PetterGustafsson/power-supply-tester/THIRD_PARTY_NOTICES.md

# Third-party material

This private project includes reference material and dependencies with their
own terms. No repository-wide license is assigned to third-party material.

| Material | Location / attribution |
| --- | --- |
| Inter font | `assets/fonts/inter/`; SIL Open Font License and source record included |
| Nunito font | `assets/fonts/nunito/`; SIL Open Font License and source record included |
| Waveshare display drivers and mechanical/reference material | Driver headers retain their notices; `case-cad/ref/` and `hardware/rev-d/sources/` |
| Hirose connector drawings and reference geometry | `references/` and `case-cad/ref/`; see the source/accuracy notes in `output/README.md` |
| Allied Vision logo art | User-supplied original in `output/allied-vision-logo.svg`; extracted emblem in `output/allied-vision-mark.svg` |
| Espressif bootloader and OTA boot data | Working firmware release, built/bundled from Arduino ESP32 core 3.3.7; Espressif's original terms apply |
| Other component datasheets and models | Kept with their hardware revision or reference directory |

Third-party trademarks identify the referenced components and supplied artwork.
The UI illustration's polished brass/gold treatment is artistic; its appearance
does not specify the plating or material of the physical connector contacts.
