PetterGustafsson/power-supply-tester/hardware/tester12v-rev-d-engineering-package/hardware/rev-d/pin-map.csv

Input | Connector | Contact | ADC | I2C_address | AIN | ADC_pin | Testpoint
1 | J1 | 1 | U1 | 0x48 | 0 | 4 | TP1
2 | J1 | 2 | U1 | 0x48 | 1 | 5 | TP2
3 | J1 | 3 | U1 | 0x48 | 2 | 6 | TP3
4 | J1 | 4 | U1 | 0x48 | 3 | 7 | TP4
5 | J2 | 1 | U2 | 0x49 | 0 | 4 | TP5
6 | J2 | 2 | U2 | 0x49 | 1 | 5 | TP6
7 | J2 | 3 | U2 | 0x49 | 2 | 6 | TP7
8 | J2 | 4 | U2 | 0x49 | 3 | 7 | TP8
9 | J3 | 1 | U3 | 0x4a | 0 | 4 | TP9
10 | J3 | 2 | U3 | 0x4a | 1 | 5 | TP10
11 | J3 | 3 | U3 | 0x4a | 2 | 6 | TP11
12 | J3 | 4 | U3 | 0x4a | 3 | 7 | TP12
