PetterGustafsson/power-supply-tester/hardware/tester12v-rev-d-engineering-package/hardware/rev-d/sources/waveshare-schematic.txt

                           1                                                                   2                                                                             3                                                               4                                                  5                                                                          6

                                                                                                          BAT                                                                                                   POWER                                                                                                         LCD
                       KEY
                                                                                                                                                                    VBAT         P1
                                                                                          U1
                                                                                                                                                                                  1
                                                                        C1                                                                                                        2
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

                                                                                                                                                                                                                                                                                                                          EP
                IMU_INT1       GPIO47                                          LNA_IN                           VDDA                                                                                         GND                                                                              GND         2                                  15
                                                      VDD3V3             2                                                      55                                                                                 A4/B9               VBUS                 VSYS                                                   GND            CTS
                IMU_INT2       GPIO48                                          VDD3P3                           VDDA                                                                                        VBUS                                                                              VBUS        3                                  14
                                                                         3                                                      54         XTALP                                                                   B8                                                                                              VDD5           DSR
                                                                               VDD3P3                         XTAL_P                                                                                        SBU2                                                                              UTXD        4                                  13 RTS
                                                      RESET              4                                                      53         XTALN                                                                      A5               R5    5.1K                                                                  TXD            RTS
                LCD_DC         GPIO8                                           CHIP_PU                        XTAL_N                                                                                         CC1                                                                              URXD        5                                  12 DTR
                                                      GPIO0              5                                                      52           GPIO46                                                                B7                    USB_N                                                                     RXD        DTRTNOW
                LCD_CS         GPIO9                                           GPIO0                           GPIO46                                                                                        DN2                                                                              3V3         6                                  11
                                                      GPIO1              6                                                      51           GPIO45                                                                   A6                 USB_P                                                                     V3             DCD
                LCD_CLK        GPIO10                                          GPIO1                           GPIO45                                                                                         DP1                                                                             USBD_P      7                                  10
                                                      GPIO2              7                                                      50          UTXD                                                                      A7                 USB_N                                                                     UD+           ACT#
                LCD_DIN        GPIO11                                          GPIO2                           U0RXD                                                                                         DN1                                                                              USBD_N      8                                  9 VBUS
                                                      GPIO3              8                                                      49          URXD                                                                   B6                    USB_P                                                                     UD-           VBUS
                                                                               GPIO3                           U0TXD                                                                                          DP2
                                                      GPIO4              9                                                      48           GPIO42                                                                   A8
                LCD_RST        GPIO12                                          GPIO4                            MTMS                                                                                        SBU1                                                                                              U8
                                                      GPIO5             10                                                      47           GPIO41                                                                B5                  R8   5.1K                                                              CH343P
                LCD_BL         GPIO40                                          GPIO5                             MTDI                                                                                        CC2                                              GND
                                                      GPIO6             11                                                      46            3V3                                                                 A9/B4                  VBUS
                                                                               GPIO6                      VDD3P3_CPU                                                                                        VBUS
                                                      GPIO7             12                                                      45           GPIO40                                                               A12/B1
                BAT_ADC        GPIO1                                           GPIO7                            MTDO                                                                                         GND
                                                      GPIO8             13                                                      44           GPIO39
                BOOT           GPIO0                                           GPIO8                            MTCK
C                                                     GPIO9             14                                                      43           GPIO38                                                   Type_C1                                                                                                                                                                                C
                RUN            RESET                                           GPIO9                           GPIO38
                                                      GPIO10            15                                                      42           GPIO37                                                                                                                                                                                     U9
                                                                               GPIO10                          GPIO37
                                                      GPIO11            16                                                      41           GPIO36                                                                                                                                                                         RTS     1                 6        RESET
                                                                               GPIO11                          GPIO36                                                                                                                                                                                                                         E C
                                                      GPIO12            17                                                      40           GPIO35                                                                                                                                      VBUS
                                                                               GPIO12                          GPIO35
                                                      GPIO13            18                                                      39           GPIO34
                                                                               GPIO13                          GPIO34
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
