PetterGustafsson/power-supply-tester/case-cad/cad_I9/review/v_iso.png

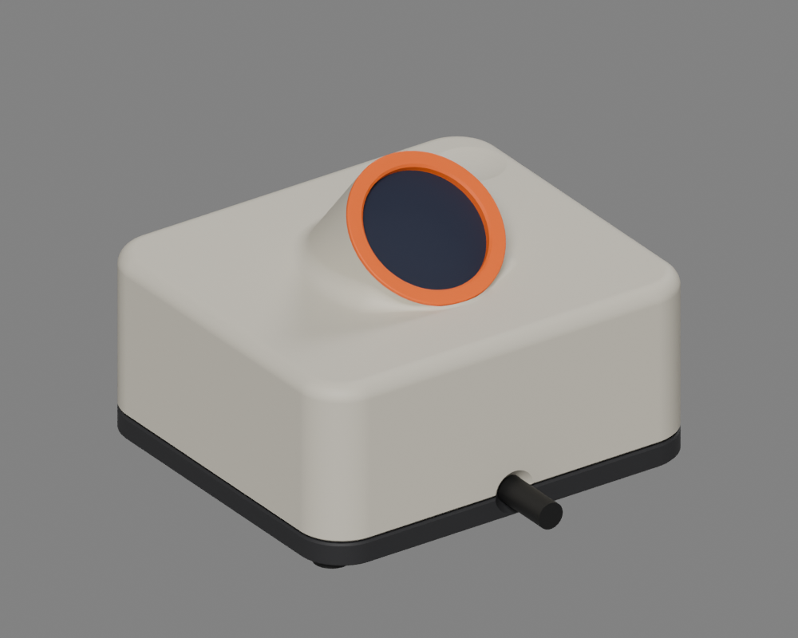
case-cad/cad_I9/review/v_iso.png
