PetterGustafsson/power-supply-tester/case-cad/ref/board-and-display.png

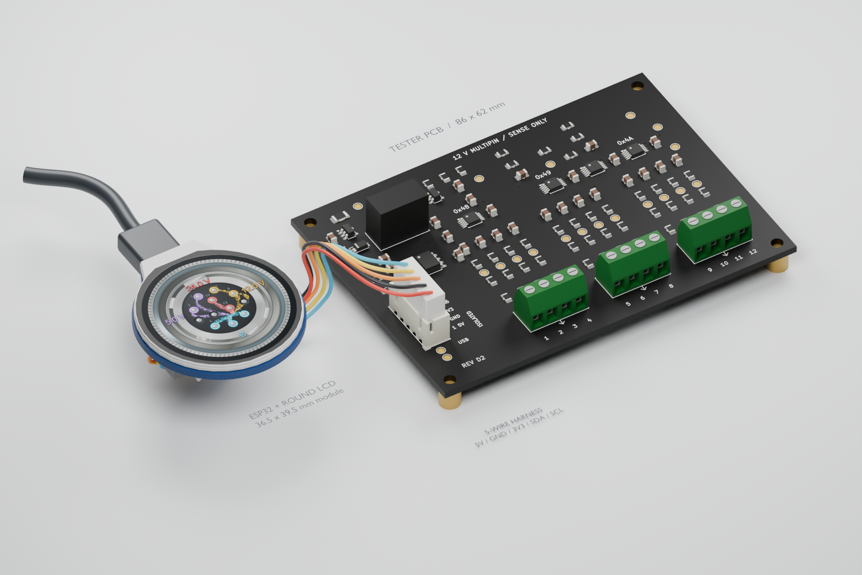
case-cad/ref/board-and-display.png
