PetterGustafsson/power-supply-tester/case-cad/ref/dmech-1.png

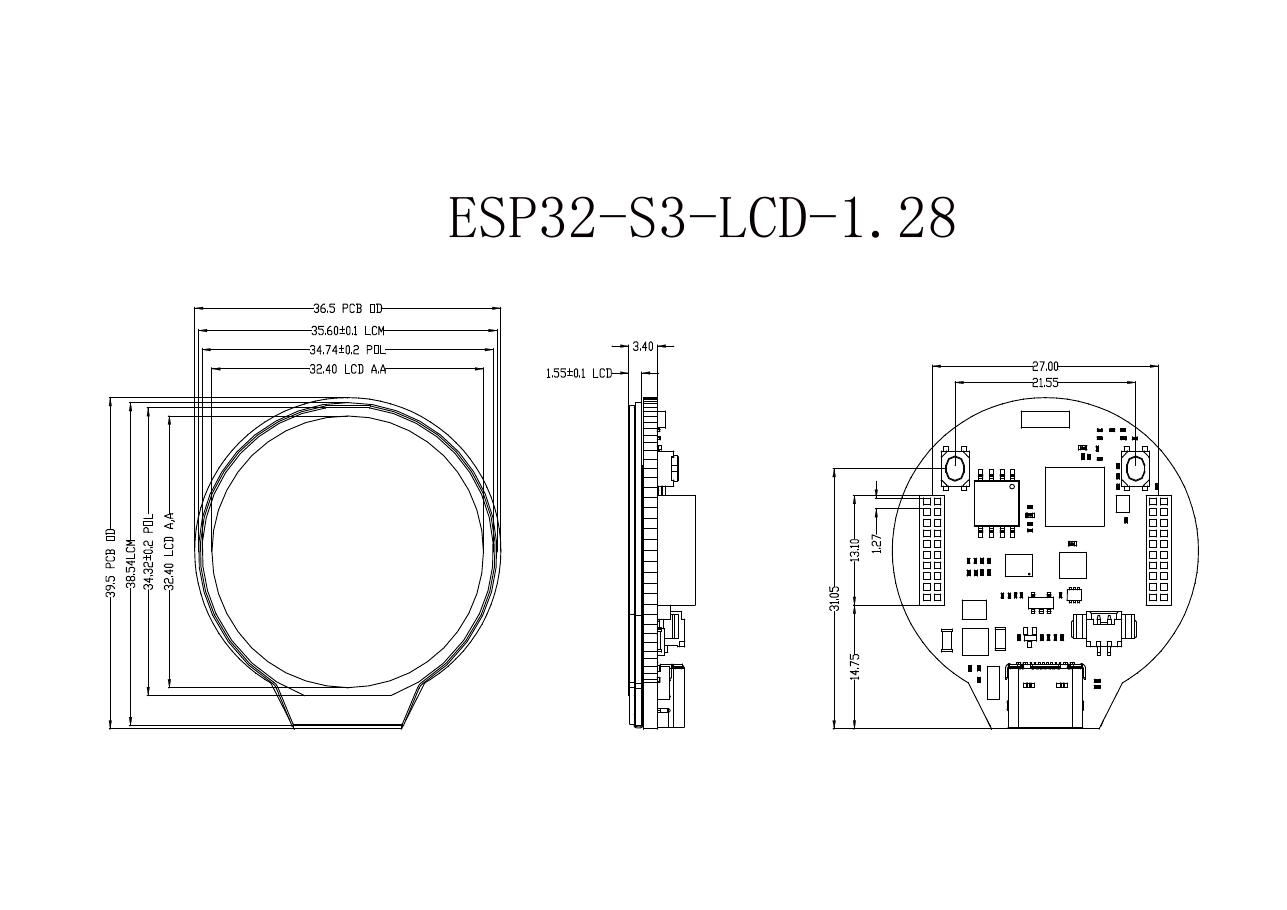
case-cad/ref/dmech-1.png
