PetterGustafsson/power-supply-tester/case-cad/ref/F_label.png

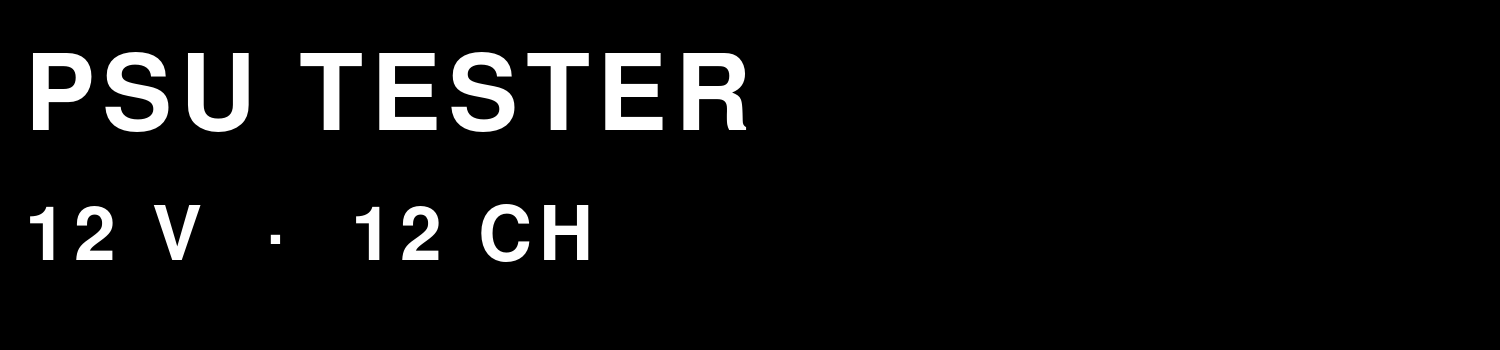
case-cad/ref/F_label.png
