PetterGustafsson/power-supply-tester/case-cad/ref/G_label.png

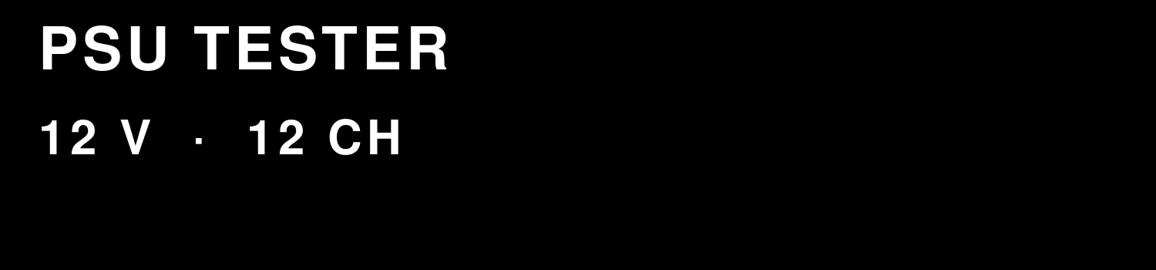
case-cad/ref/G_label.png
