PetterGustafsson/power-supply-tester/case-cad/renders/I6_hero_connector.png

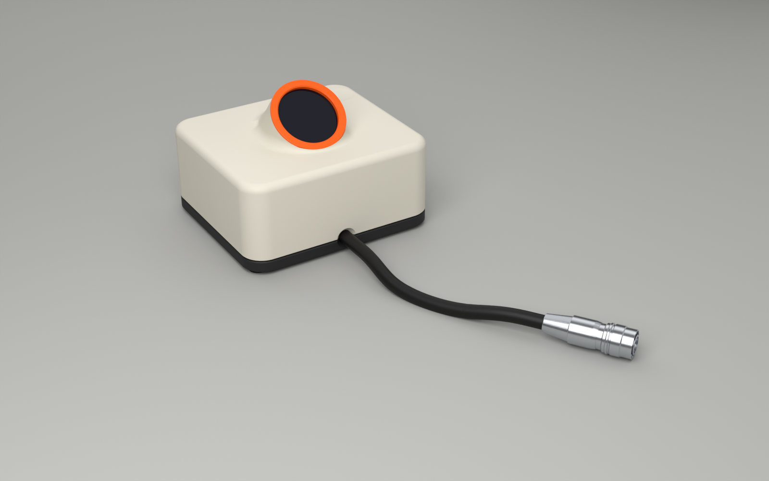
case-cad/renders/I6_hero_connector.png
