PetterGustafsson/power-supply-tester/case-cad/renders/I7_bay_inside.png

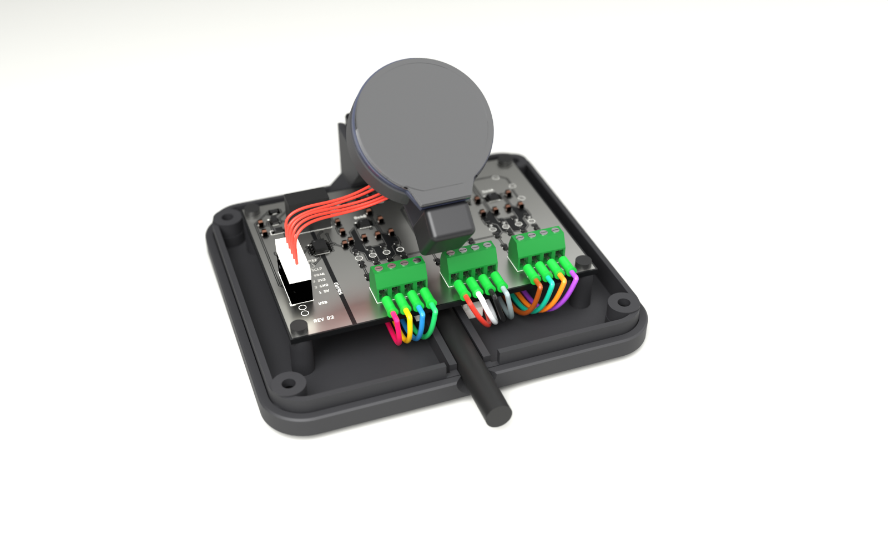
case-cad/renders/I7_bay_inside.png
