PetterGustafsson/power-supply-tester/case-cad/renders/I7_module_bay_section.png

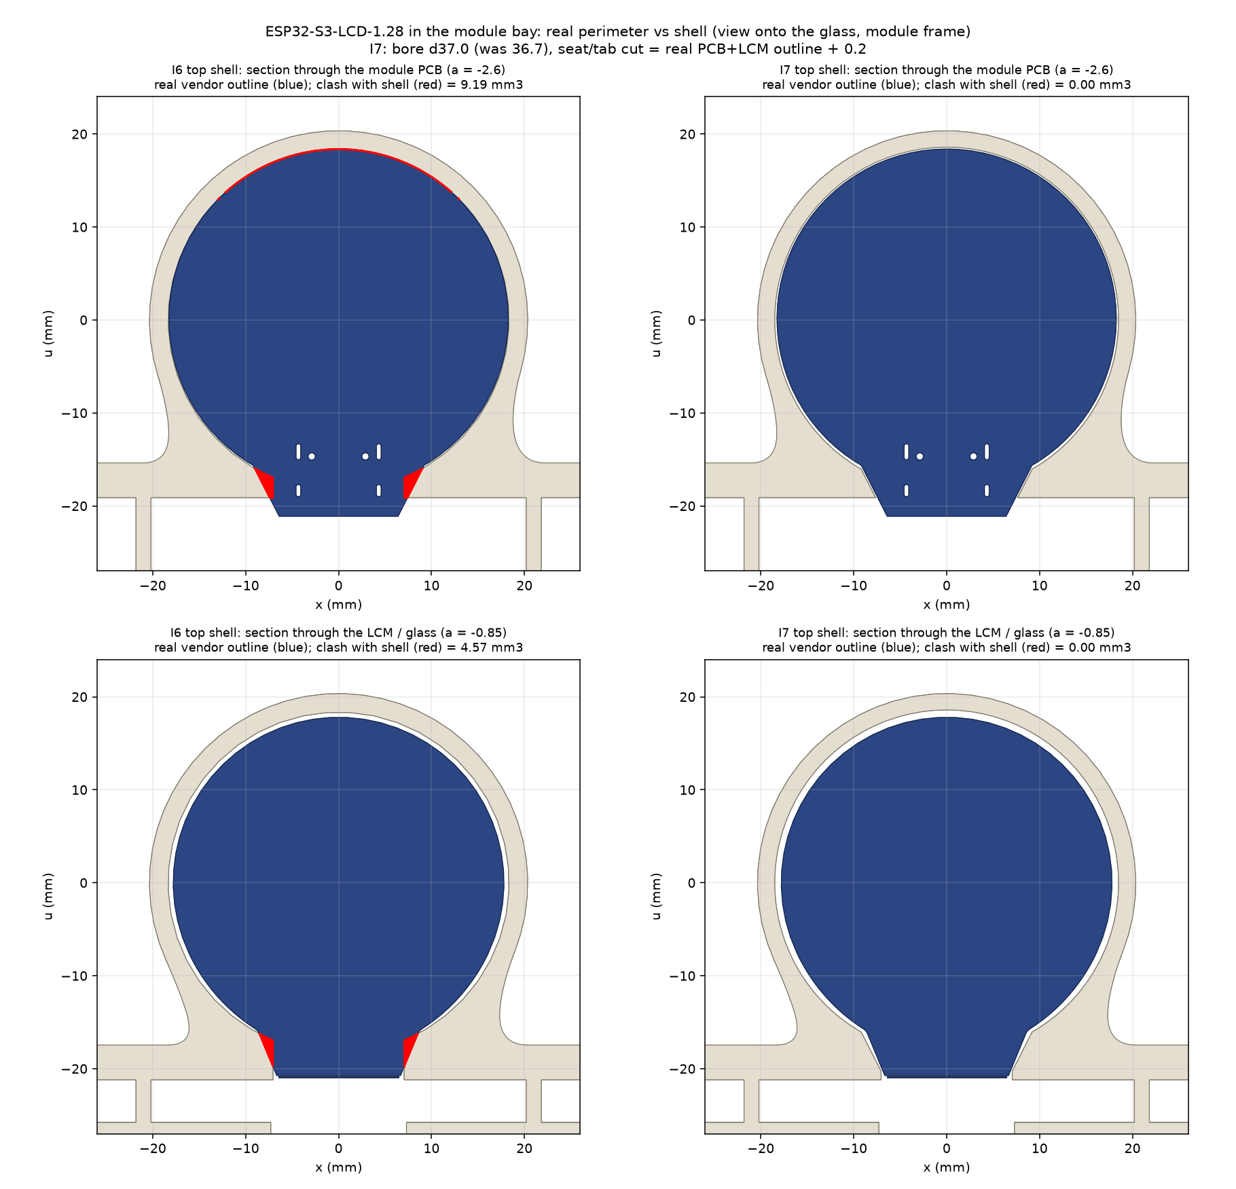
case-cad/renders/I7_module_bay_section.png
