PetterGustafsson/power-supply-tester/case-cad/renders/I7_module_outline_overlay.png

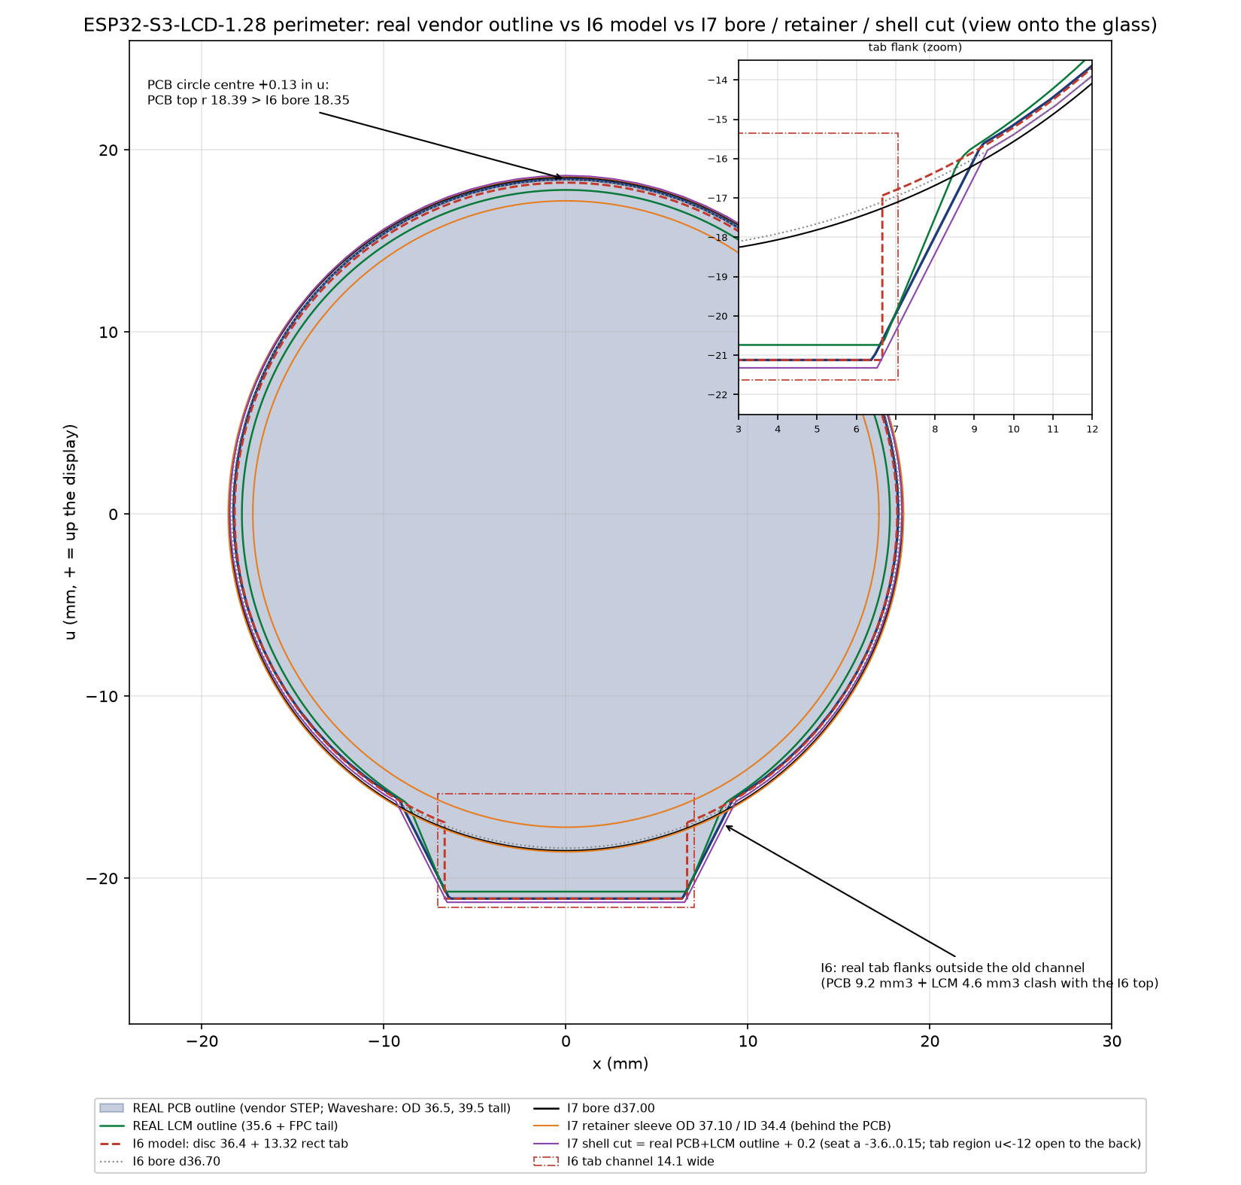
case-cad/renders/I7_module_outline_overlay.png
