PetterGustafsson/power-supply-tester/case-cad/renders/I7_usb_cutaway_hero.png

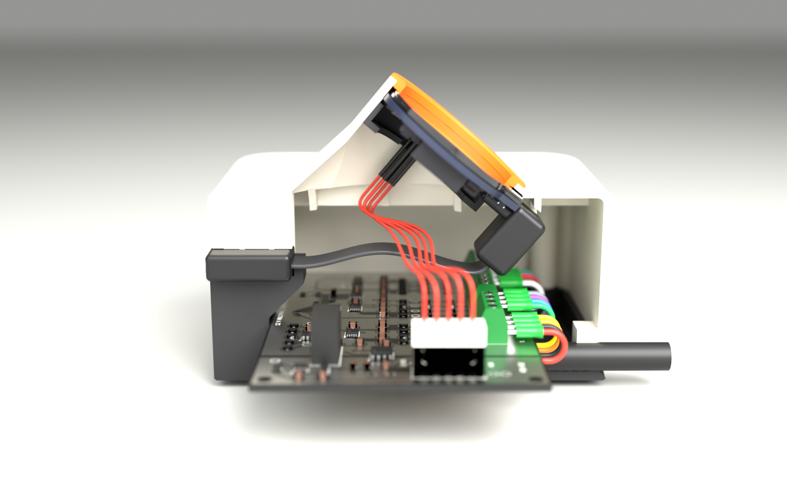
case-cad/renders/I7_usb_cutaway_hero.png
