PetterGustafsson/power-supply-tester/case-cad/renders/I7_usb_extender_closeup.png

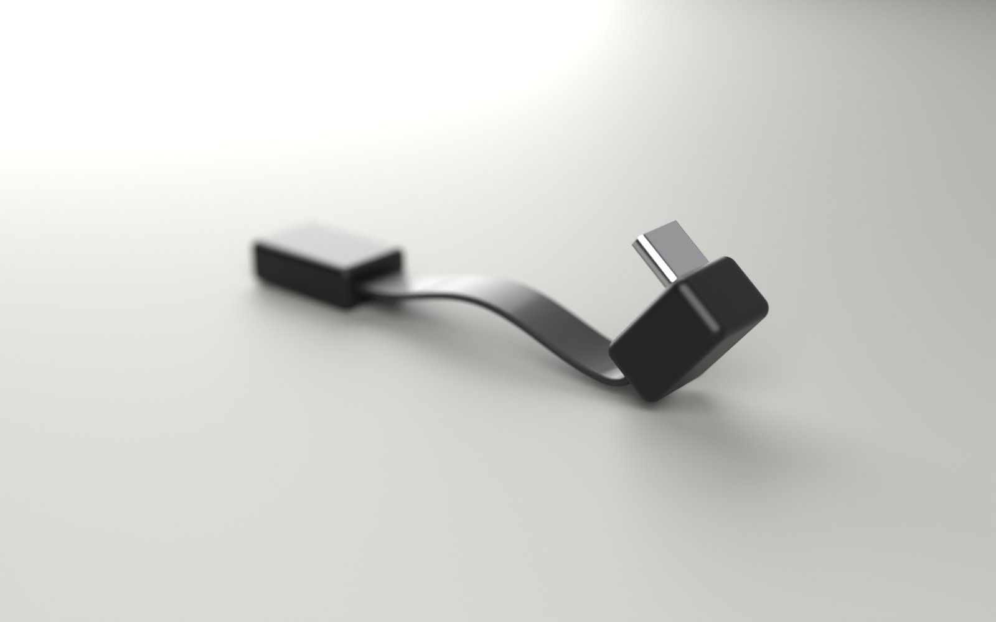
case-cad/renders/I7_usb_extender_closeup.png
