PetterGustafsson/power-supply-tester/case-cad/renders/I7b_bay_routing.png

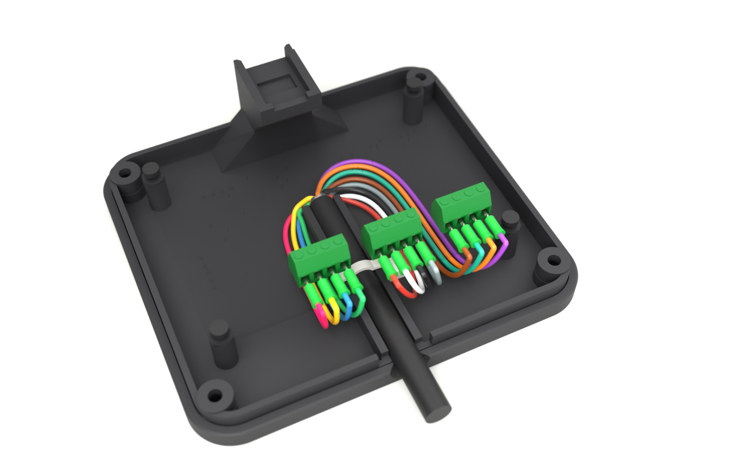
case-cad/renders/I7b_bay_routing.png
