PetterGustafsson/power-supply-tester/case-cad/renders/I7b_breakout_closeup.png

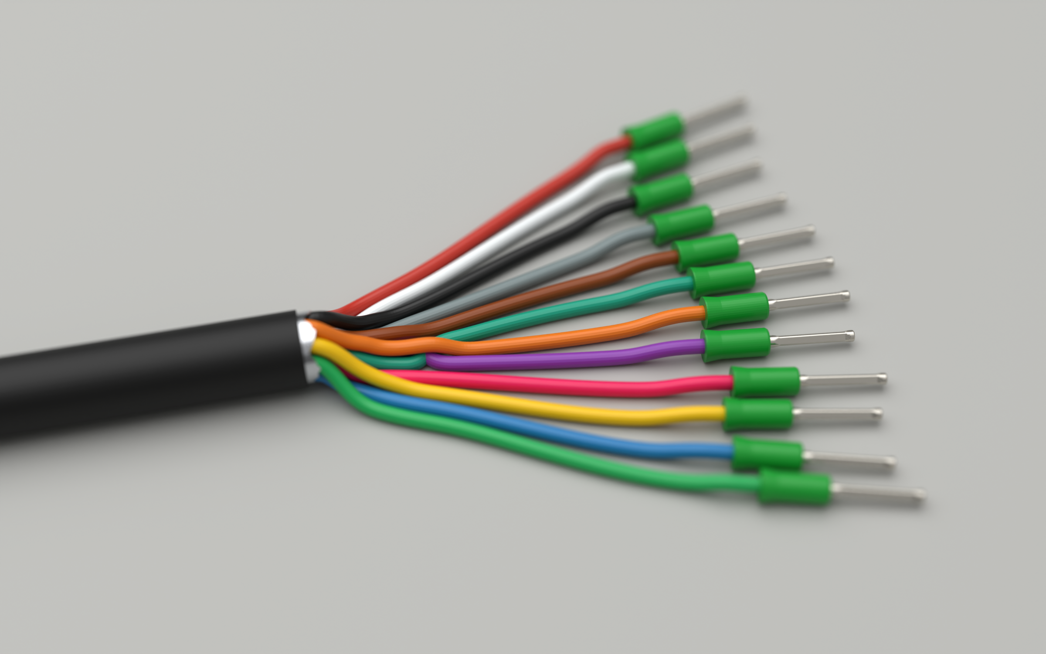
case-cad/renders/I7b_breakout_closeup.png
