PetterGustafsson/power-supply-tester/case-cad/renders/I7b_zip_trench.png

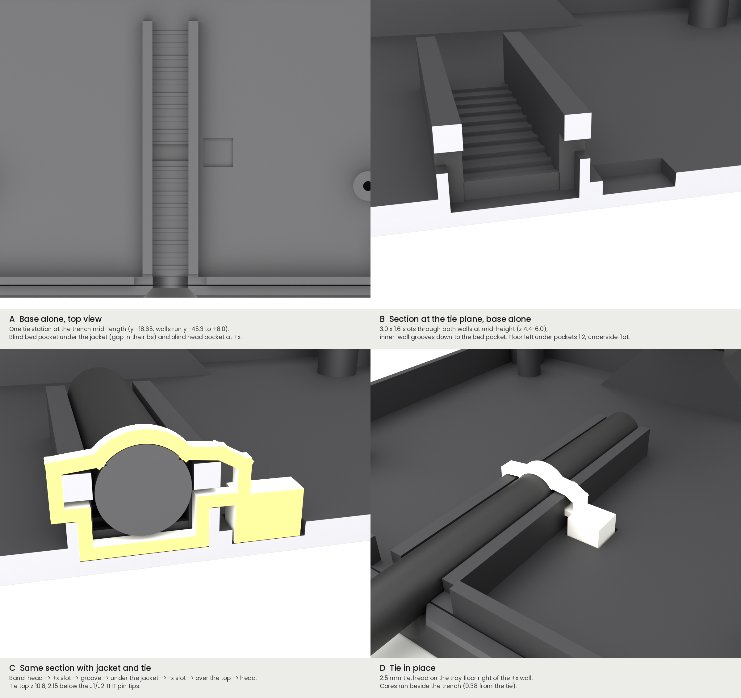
case-cad/renders/I7b_zip_trench.png
