PetterGustafsson/power-supply-tester/case-cad/renders/I8_top_underside_quick.png

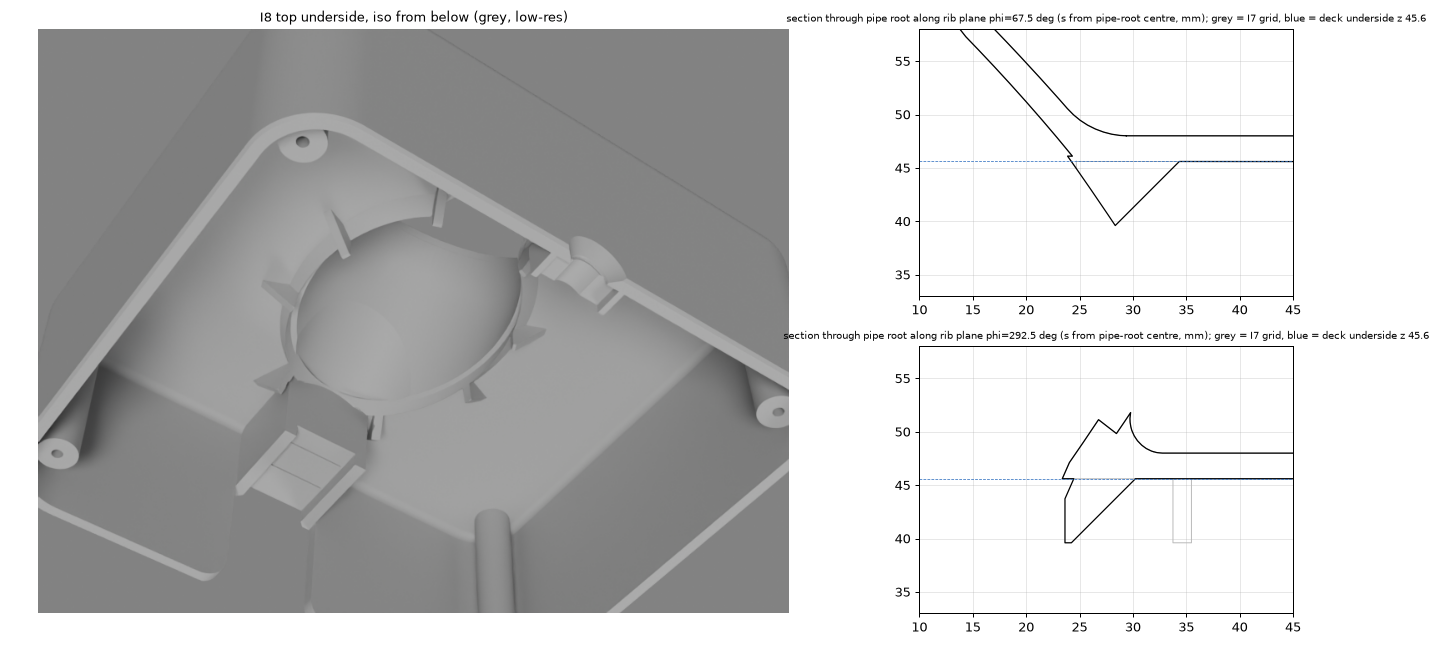
case-cad/renders/I8_top_underside_quick.png
