PetterGustafsson/power-supply-tester/case-cad/renders/I9_pipe_quick.png

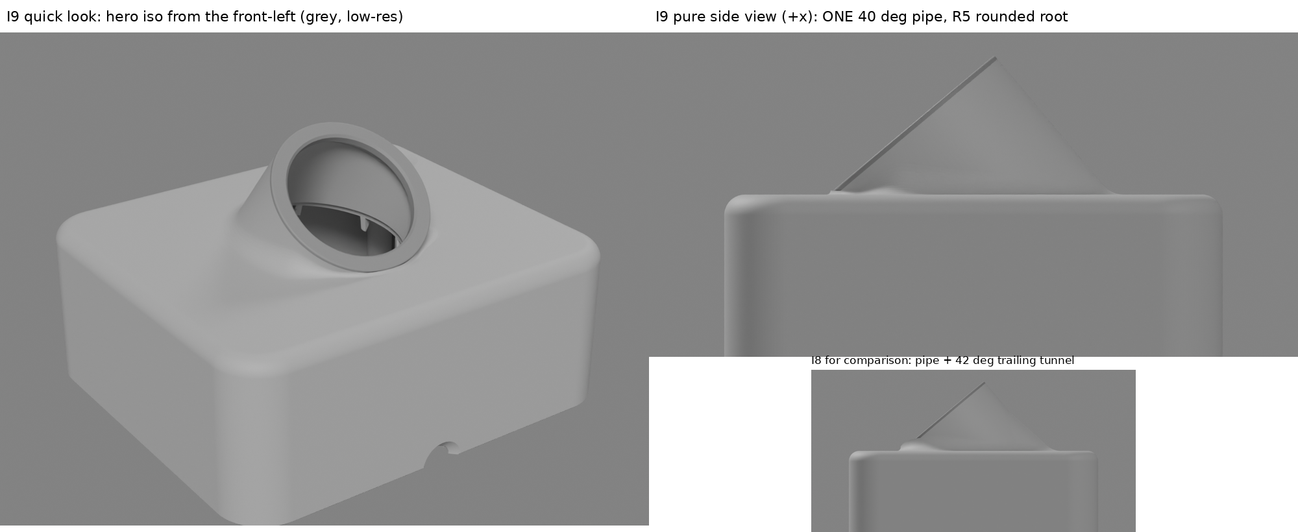
case-cad/renders/I9_pipe_quick.png
