PetterGustafsson/power-supply-tester/hardware/jlc-checkout-2026-09-30/checkout-ready.png

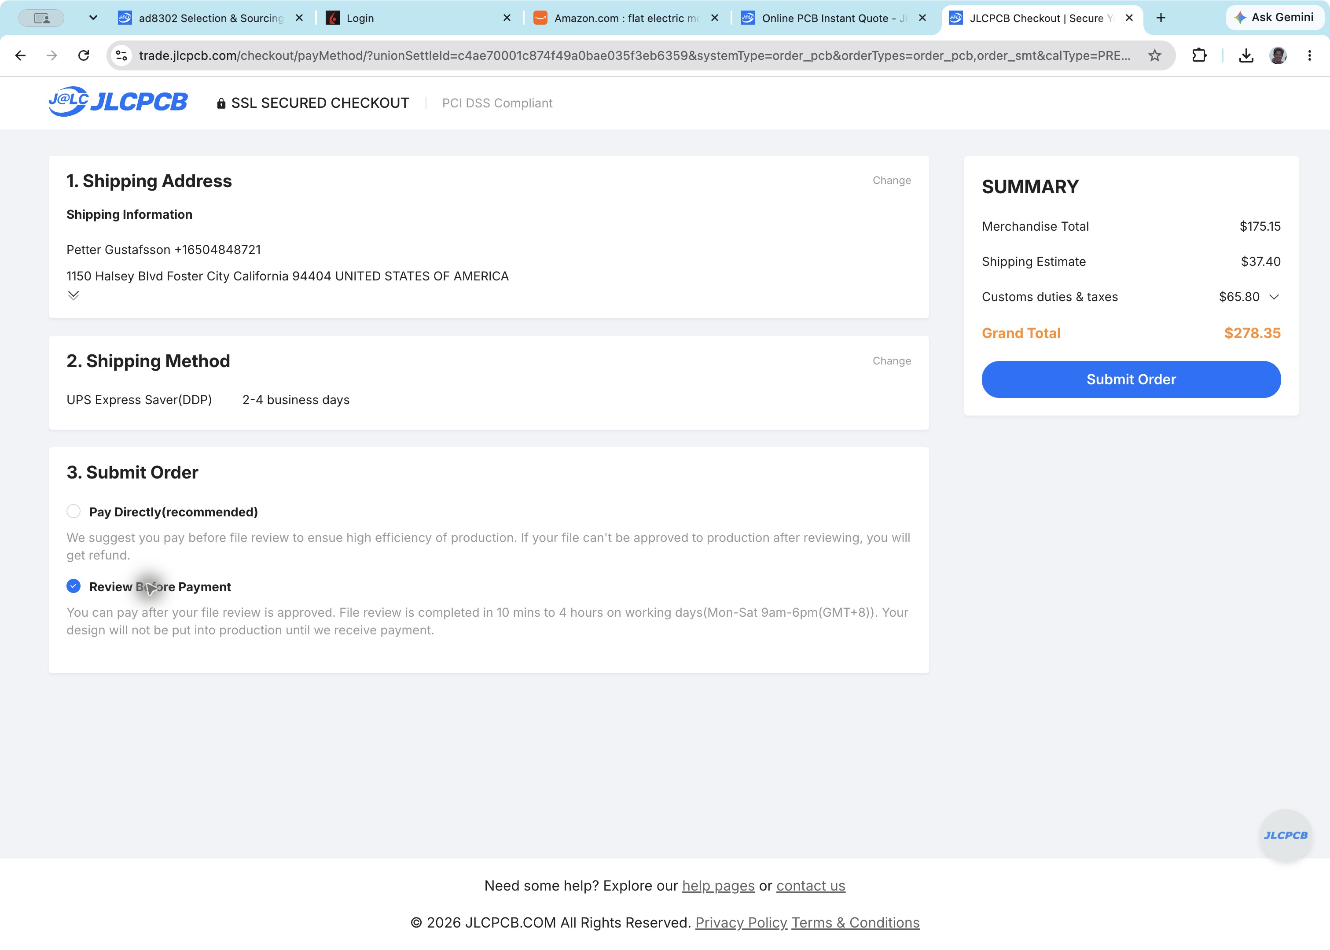
hardware/jlc-checkout-2026-09-30/checkout-ready.png
