PetterGustafsson/power-supply-tester/hardware/jlc-checkout-2026-09-30/jlc-corrected-placement-preview.png

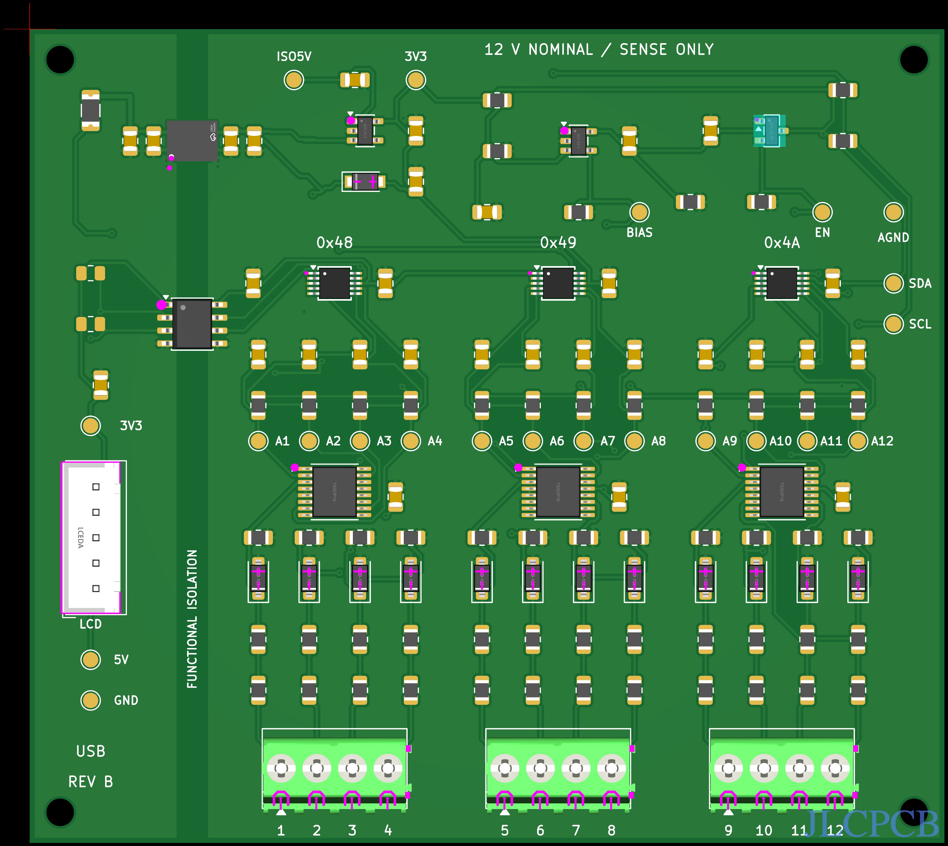
hardware/jlc-checkout-2026-09-30/jlc-corrected-placement-preview.png
