PetterGustafsson/power-supply-tester/hardware/tester12v-rev-d1-engineering-package/hardware/rev-d/previews/display-all-connected.png

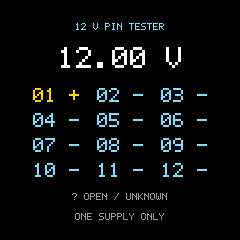
hardware/tester12v-rev-d1-engineering-package/hardware/rev-d/previews/display-all-connected.png
