PetterGustafsson/power-supply-tester/hardware/tester12v-rev-d1-engineering-package/hardware/rev-d/previews/pcb-3d.png

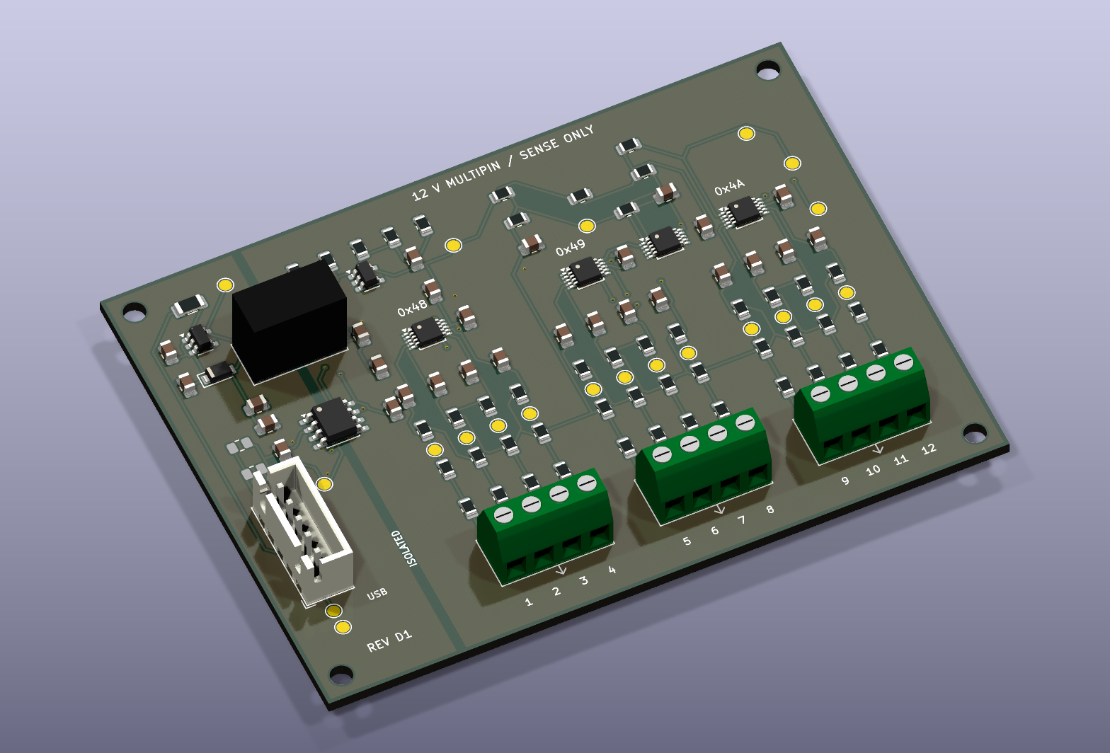
hardware/tester12v-rev-d1-engineering-package/hardware/rev-d/previews/pcb-3d.png
