PetterGustafsson/power-supply-tester/hardware/tester12v-rev-d2-engineering-package/hardware/rev-d/previews/pcb-top-labels.png

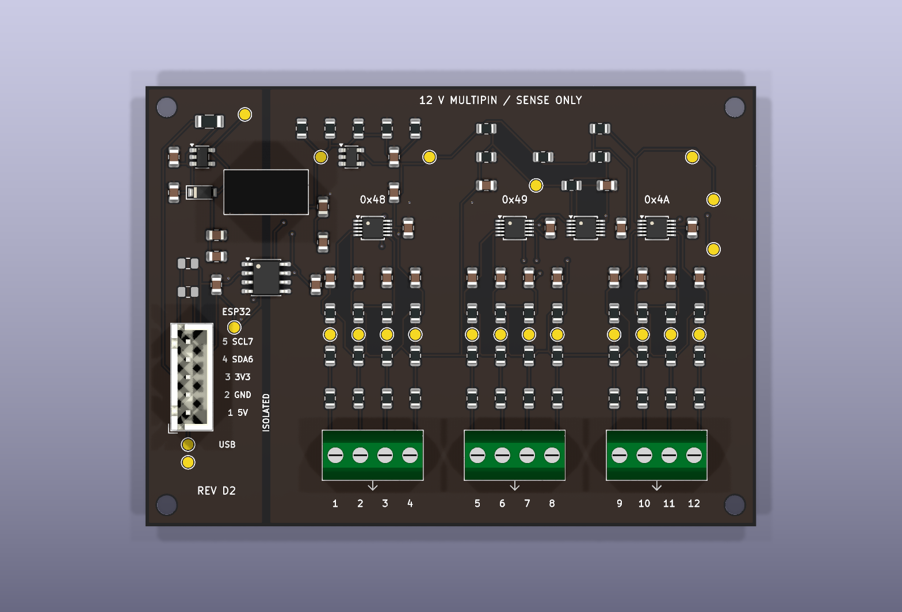
hardware/tester12v-rev-d2-engineering-package/hardware/rev-d/previews/pcb-top-labels.png
