PetterGustafsson/power-supply-tester/hardware/tester12v-rev-d-engineering-package/hardware/rev-d/previews/display-no-voltage.png

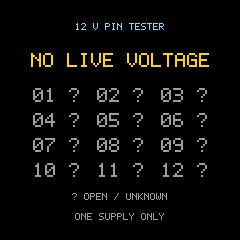
hardware/tester12v-rev-d-engineering-package/hardware/rev-d/previews/display-no-voltage.png
