PetterGustafsson/power-supply-tester/output/allied-vision-mark.png

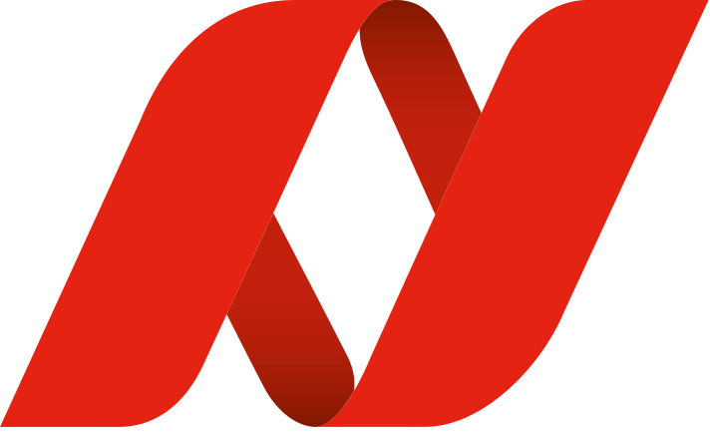
output/allied-vision-mark.png
