PetterGustafsson/power-supply-tester/output/allied-vision-placement-preview.png

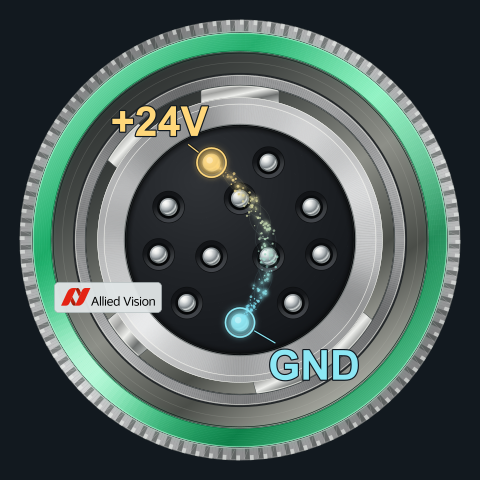
output/allied-vision-placement-preview.png
