PetterGustafsson/power-supply-tester/output/annotated-luminous-rails-240.gif

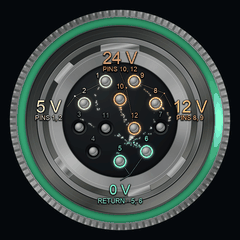
output/annotated-luminous-rails-240.gif
