PetterGustafsson/power-supply-tester/output/bold-circular-display-2026-10-19/bold-overview.png

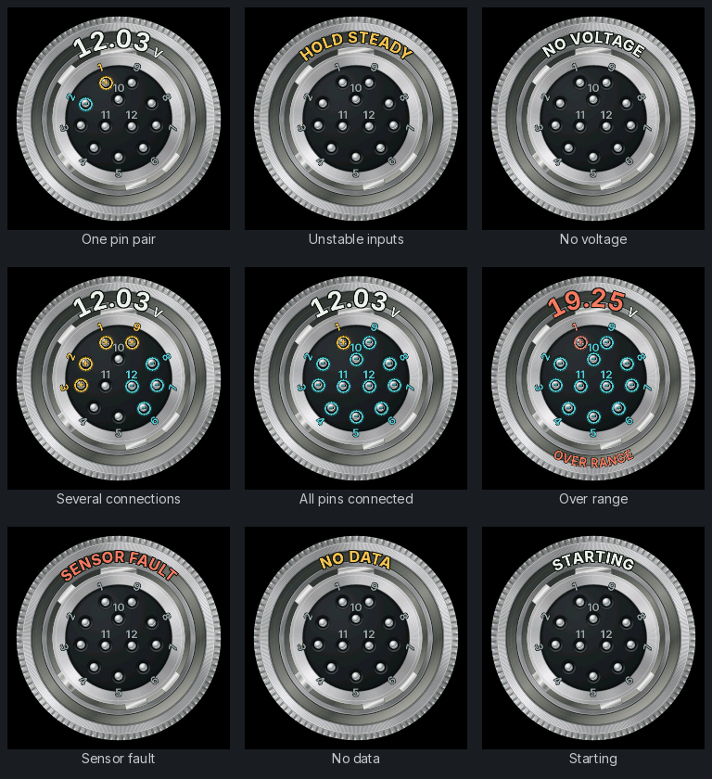
output/bold-circular-display-2026-10-19/bold-overview.png
