PetterGustafsson/power-supply-tester/output/bold-circular-display-2026-10-19/bold-preview.png

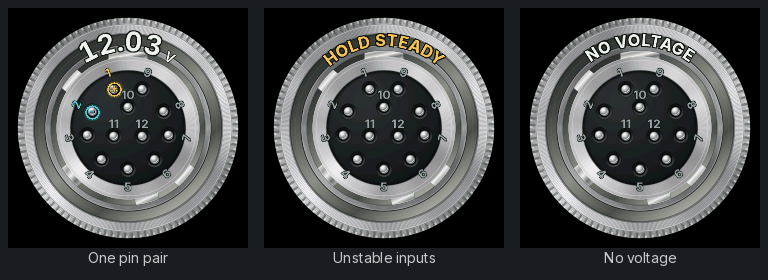
output/bold-circular-display-2026-10-19/bold-preview.png
