PetterGustafsson/power-supply-tester/output/bold-circular-display-2026-10-19/integration/display-no-voltage.png

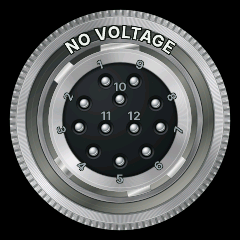
output/bold-circular-display-2026-10-19/integration/display-no-voltage.png
