PetterGustafsson/power-supply-tester/output/bold-flashes-2026-10-19/flashes-overview.png

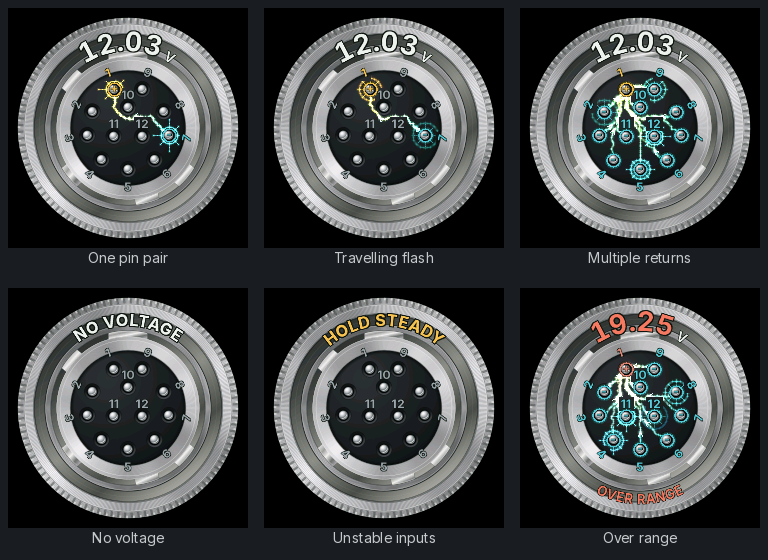
output/bold-flashes-2026-10-19/flashes-overview.png
