PetterGustafsson/power-supply-tester/output/bold-flashes-2026-10-19/rendered/all-connected.png

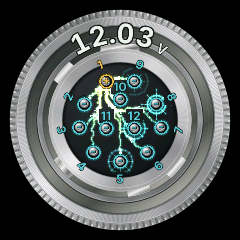
output/bold-flashes-2026-10-19/rendered/all-connected.png
