PetterGustafsson/power-supply-tester/output/circular-display-2026-10-19/circular-overview.png

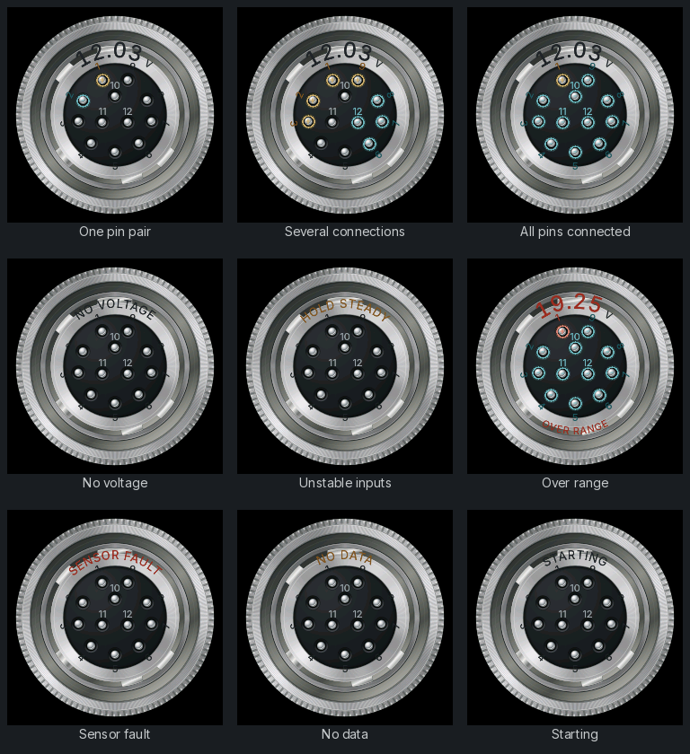
output/circular-display-2026-10-19/circular-overview.png
