PetterGustafsson/power-supply-tester/output/connector-allied-helix-240.png

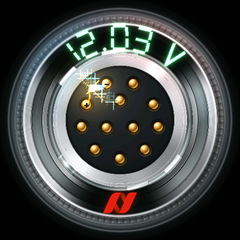
output/connector-allied-helix-240.png
