PetterGustafsson/power-supply-tester/output/connector-allied-other-pair-240.png

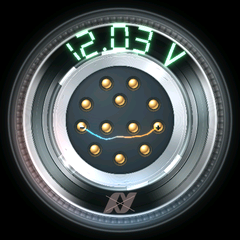
output/connector-allied-other-pair-240.png
