PetterGustafsson/power-supply-tester/output/connector-band-study-2026-10-22/band-treatment-comparison.png

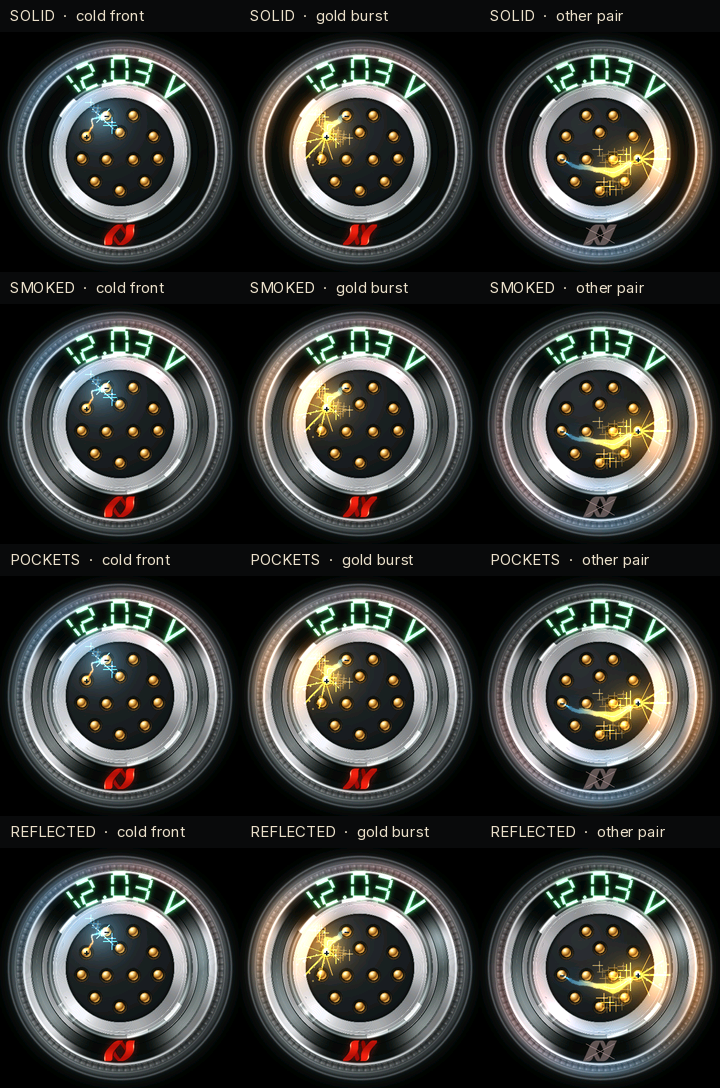
output/connector-band-study-2026-10-22/band-treatment-comparison.png
