PetterGustafsson/power-supply-tester/output/connector-band-study-2026-10-22/pockets-other-pair-240.png

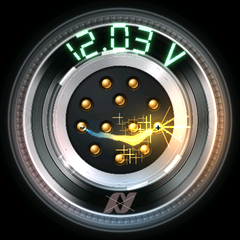
output/connector-band-study-2026-10-22/pockets-other-pair-240.png
