PetterGustafsson/power-supply-tester/output/connector-band-study-2026-10-22/reflected-seating-240.png

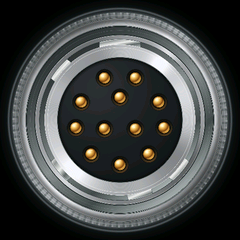
output/connector-band-study-2026-10-22/reflected-seating-240.png
