PetterGustafsson/power-supply-tester/output/connector-finished-contact-sheet.png

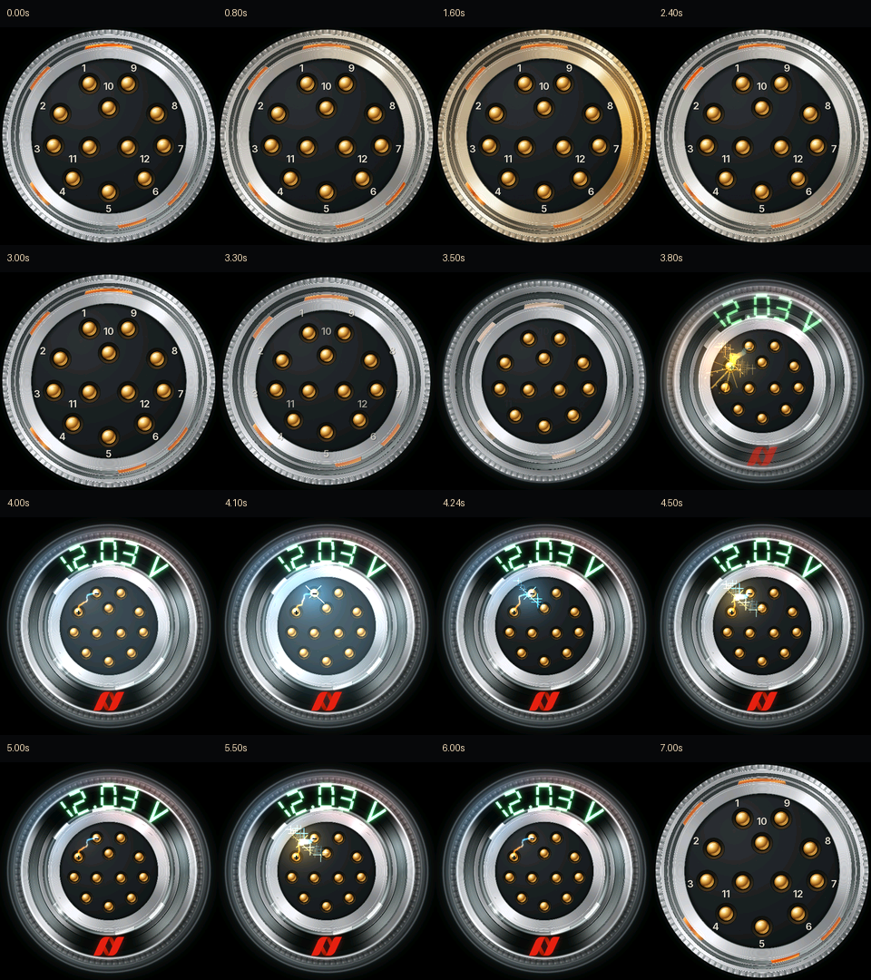
output/connector-finished-contact-sheet.png
