PetterGustafsson/power-supply-tester/output/connector-flash-study-2026-10-22/flash-pattern-comparison.png

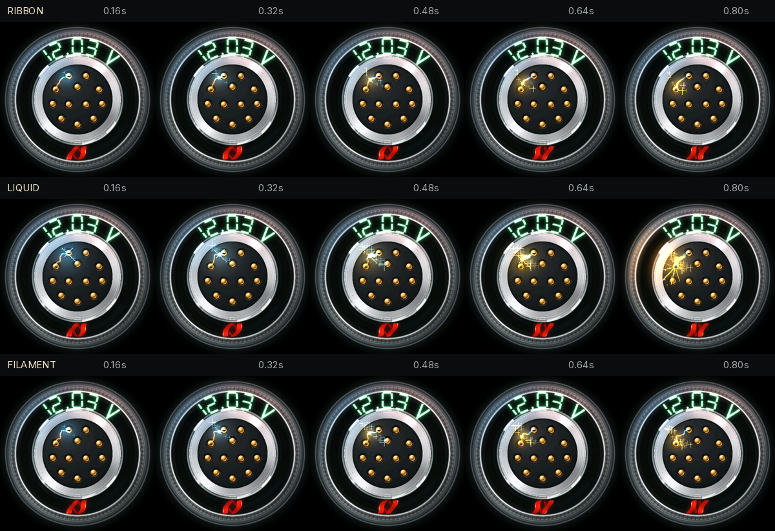
output/connector-flash-study-2026-10-22/flash-pattern-comparison.png
