PetterGustafsson/power-supply-tester/output/connector-flash-study-2026-10-22/gold-ooze-before-after.png

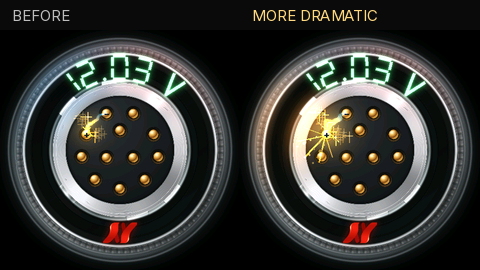
output/connector-flash-study-2026-10-22/gold-ooze-before-after.png
