PetterGustafsson/power-supply-tester/output/connector-flash-study-2026-10-22/liquid-detail.png

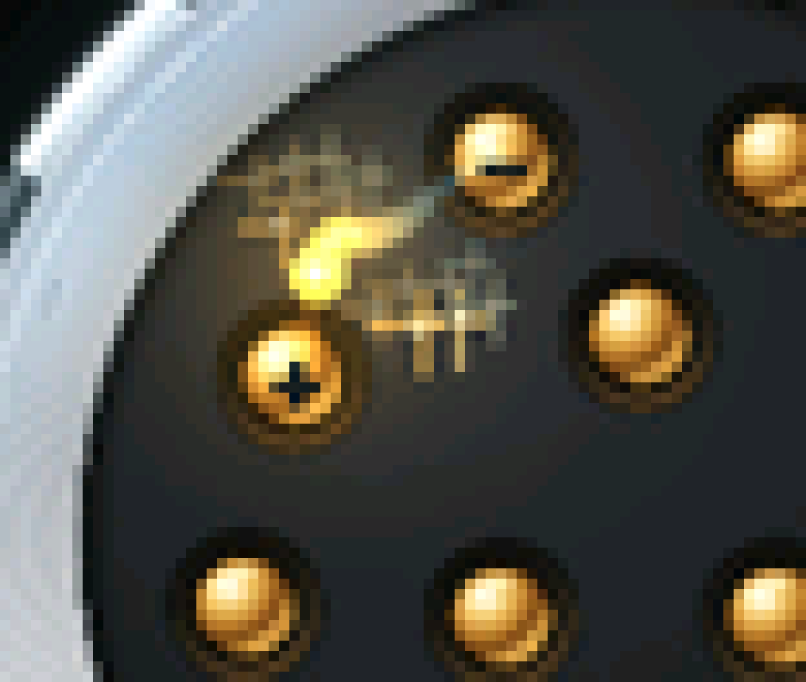
output/connector-flash-study-2026-10-22/liquid-detail.png
