PetterGustafsson/power-supply-tester/output/connector-flash-study-2026-10-22/other-pair-comparison.png

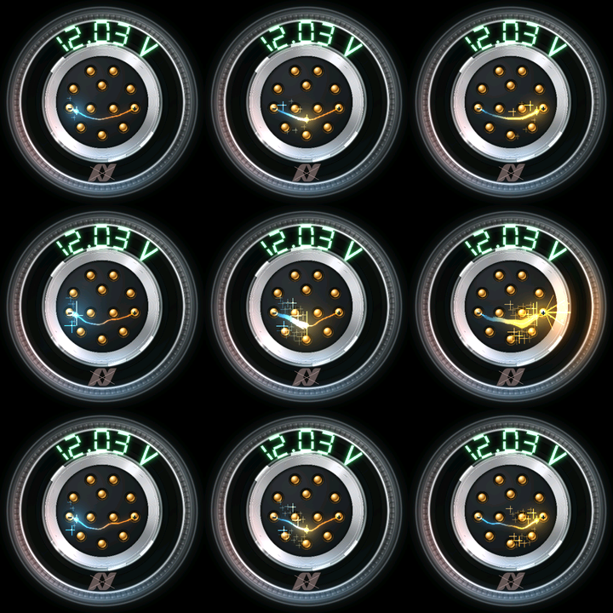
output/connector-flash-study-2026-10-22/other-pair-comparison.png
