PetterGustafsson/power-supply-tester/output/connector-flash-study-2026-10-22/other-pair-detail-late.png

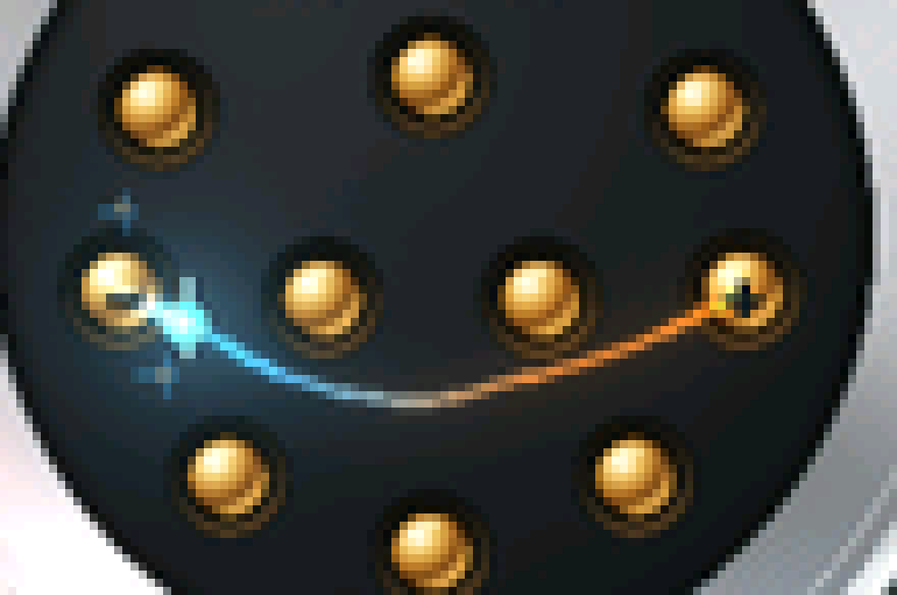
output/connector-flash-study-2026-10-22/other-pair-detail-late.png
