PetterGustafsson/power-supply-tester/output/connector-flash-study-2026-10-22/ribbon-detail.png

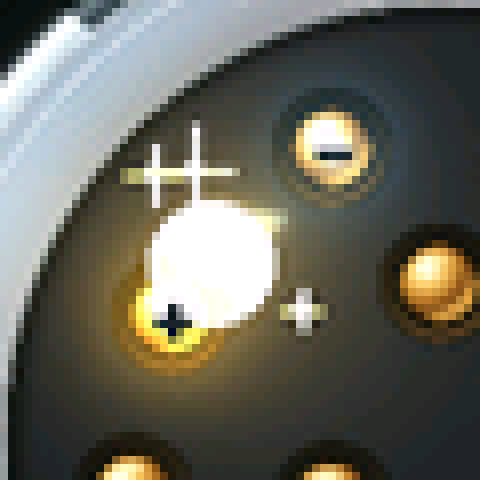
output/connector-flash-study-2026-10-22/ribbon-detail.png
