PetterGustafsson/power-supply-tester/output/connector-orientation-sheen-source.png

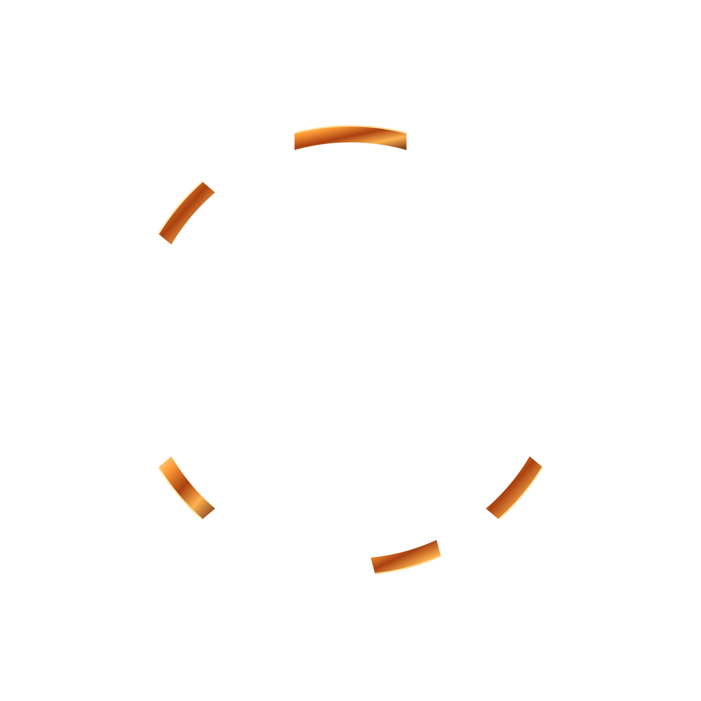
output/connector-orientation-sheen-source.png
