PetterGustafsson/power-supply-tester/output/correct-constellation-3.png

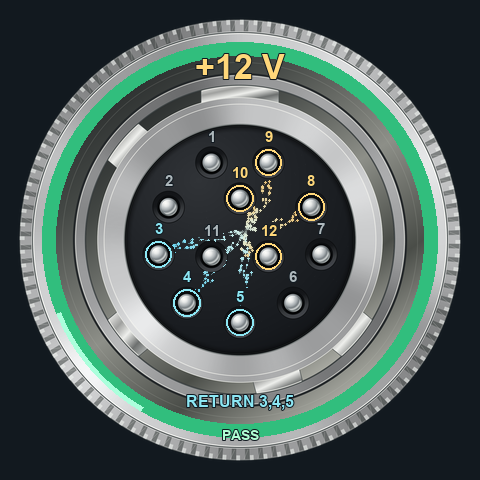
output/correct-constellation-3.png
