PetterGustafsson/power-supply-tester/output/correct-constellation-4.png

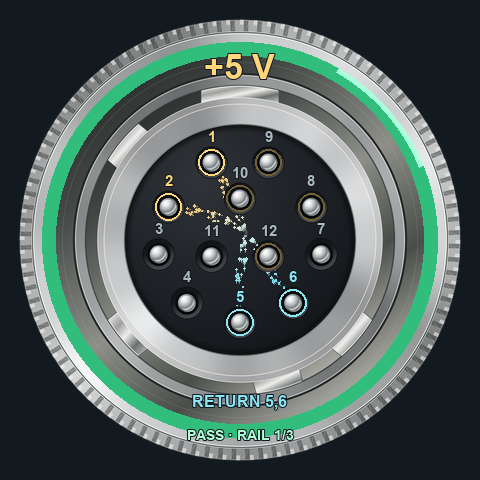
output/correct-constellation-4.png
