PetterGustafsson/power-supply-tester/output/correct-constellations-overview.png

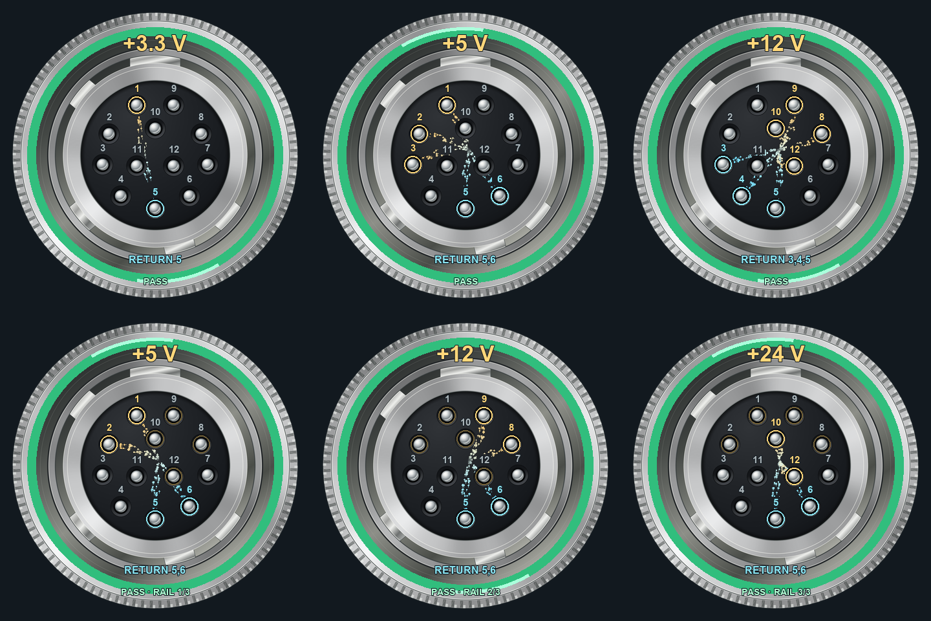
output/correct-constellations-overview.png
