PetterGustafsson/power-supply-tester/output/electron-flow-2026-10-19/electron-flow-preview.gif

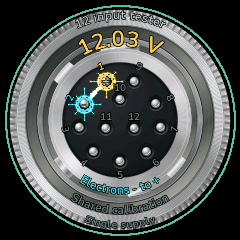
output/electron-flow-2026-10-19/electron-flow-preview.gif
