PetterGustafsson/power-supply-tester/output/electron-flow-2026-10-19/rendered/over-range.png

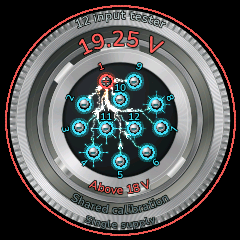
output/electron-flow-2026-10-19/rendered/over-range.png
