PetterGustafsson/power-supply-tester/output/electron-tunnel-fail-animation-240.gif

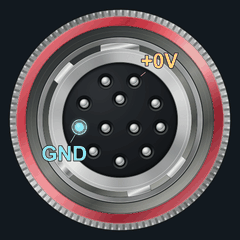
output/electron-tunnel-fail-animation-240.gif
