PetterGustafsson/power-supply-tester/output/enclosure-d2/board-and-display.png

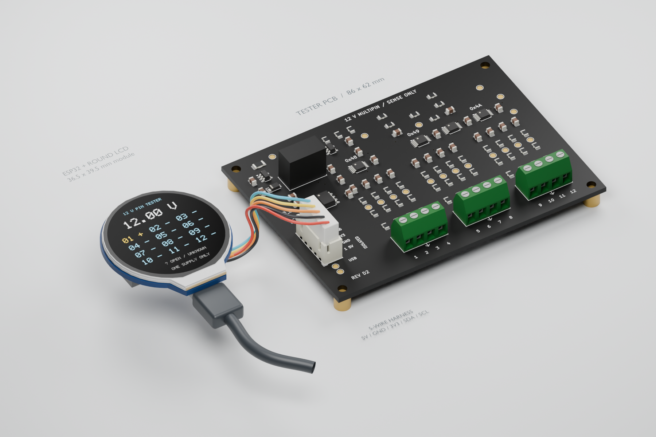
output/enclosure-d2/board-and-display.png
