PetterGustafsson/power-supply-tester/output/enclosure-d2/lid-mounted-layout-usb-rear-connector-ui.png

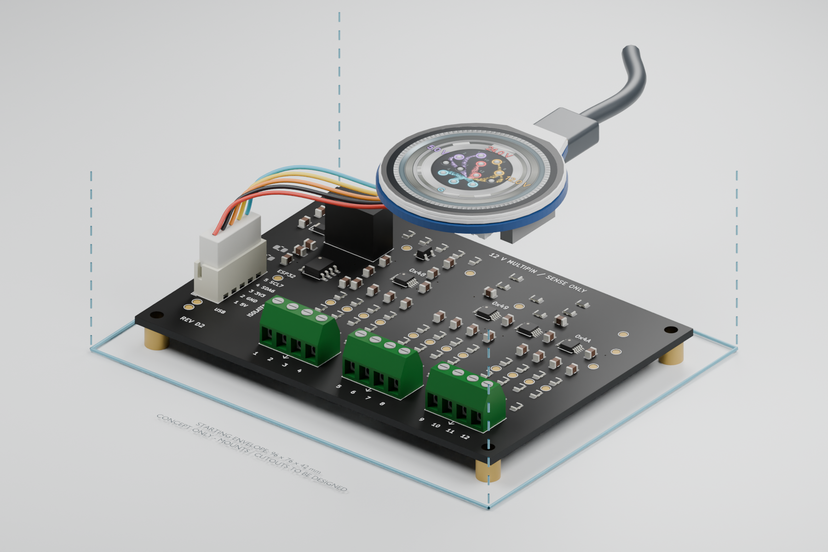
output/enclosure-d2/lid-mounted-layout-usb-rear-connector-ui.png
