PetterGustafsson/power-supply-tester/output/enclosure-d2/sources/display-connector-ui.png

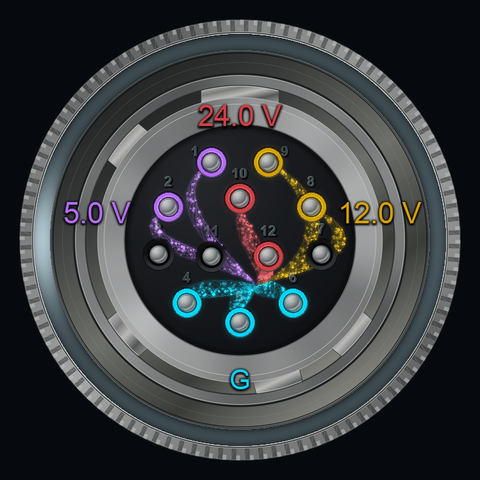
output/enclosure-d2/sources/display-connector-ui.png
