PetterGustafsson/power-supply-tester/output/final-layout-poster/tie-detail.png

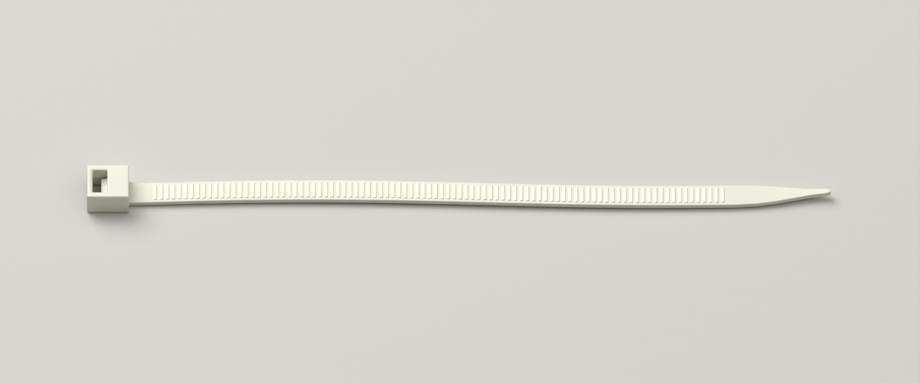
output/final-layout-poster/tie-detail.png
