PetterGustafsson/power-supply-tester/output/hr10a-10p-12p.png

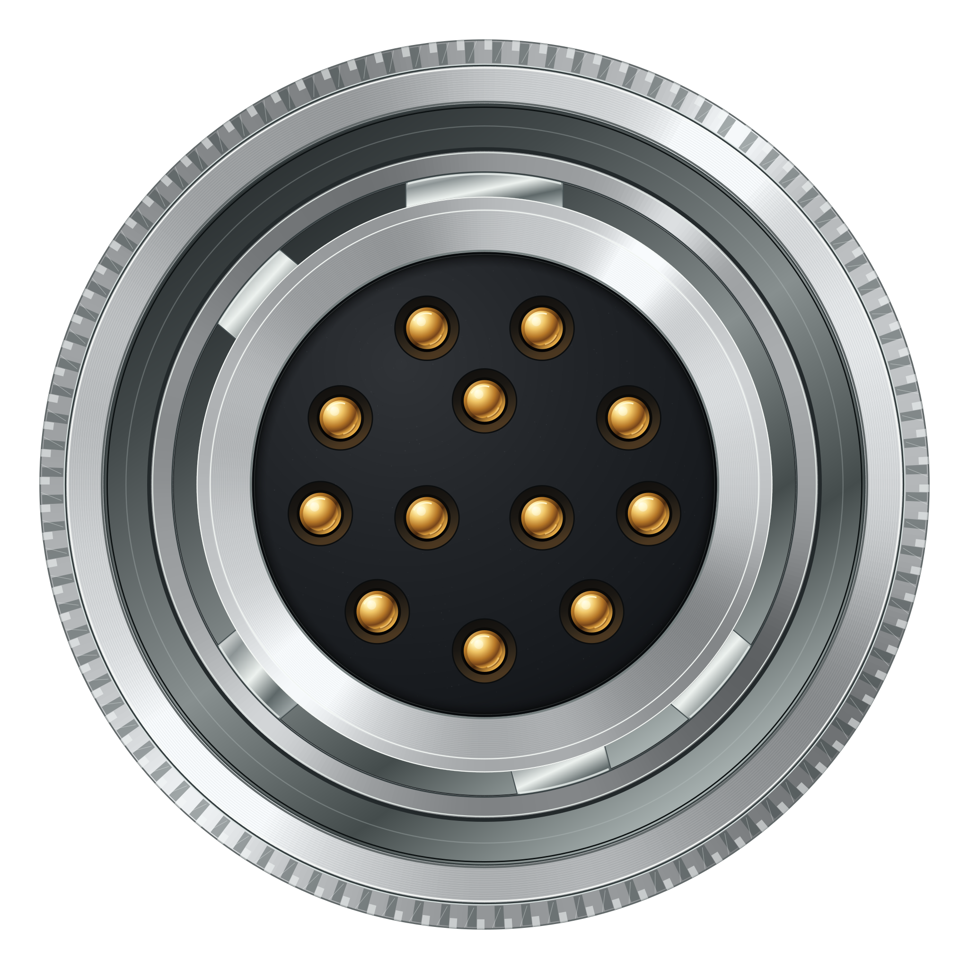
output/hr10a-10p-12p.png
