PetterGustafsson/power-supply-tester/output/imagegen/multiple-powered-pins-ui-concept.png

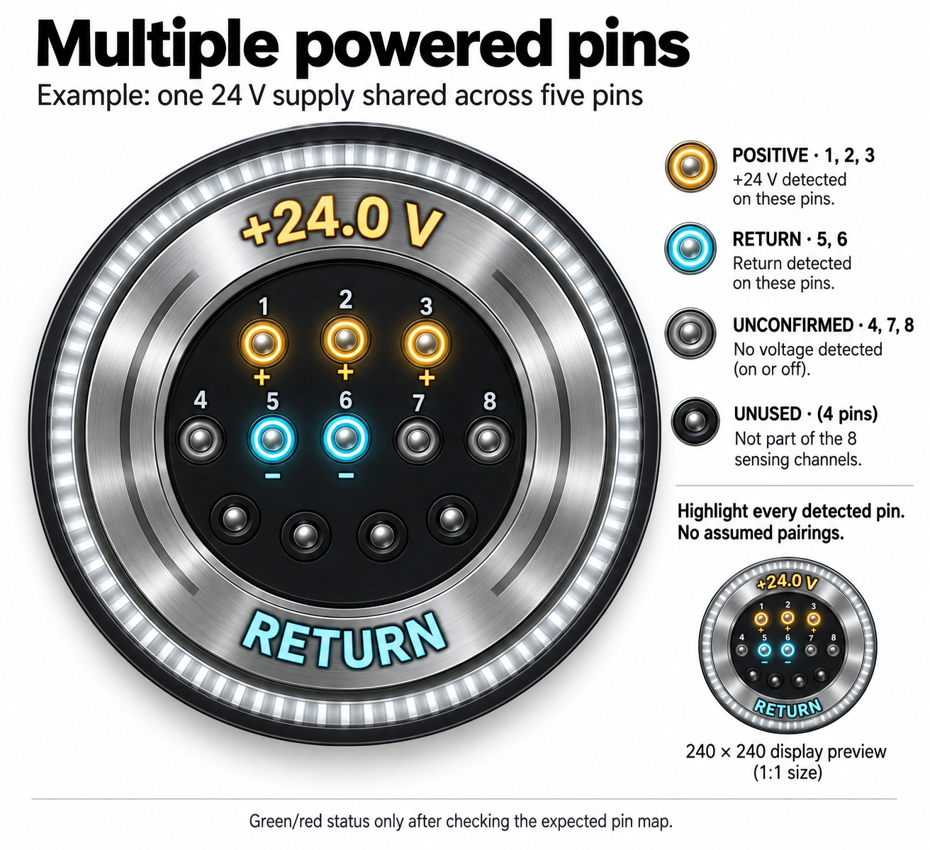
output/imagegen/multiple-powered-pins-ui-concept.png
