PetterGustafsson/power-supply-tester/output/live-graphics-2026-10-19/rendered/all-connected.png

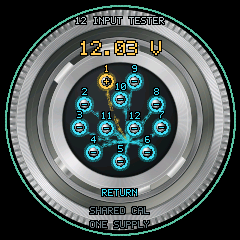
output/live-graphics-2026-10-19/rendered/all-connected.png
