PetterGustafsson/power-supply-tester/output/multi-pin-electron-flow-240.gif

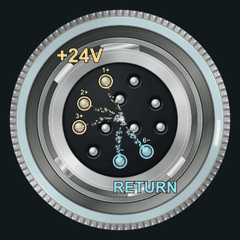
output/multi-pin-electron-flow-240.gif
