PetterGustafsson/power-supply-tester/output/organic-typography-2026-10-19/typography-overview.png

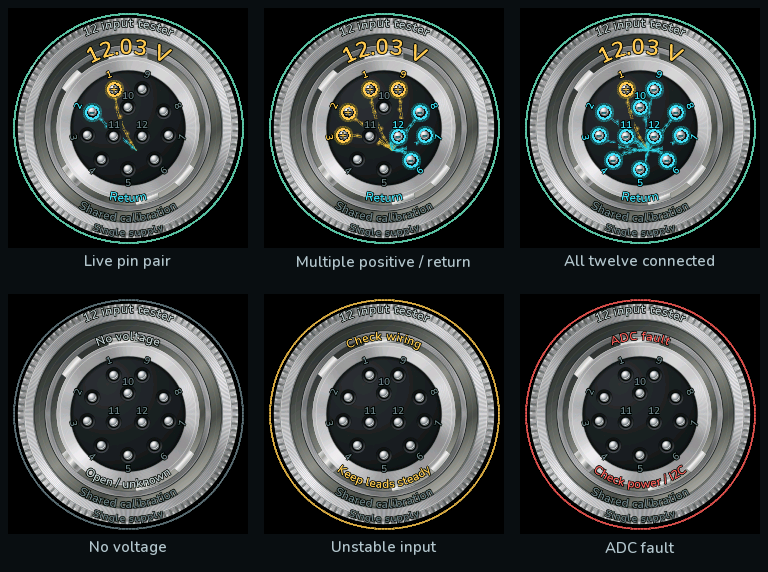
output/organic-typography-2026-10-19/typography-overview.png
