PetterGustafsson/power-supply-tester/output/power-pins-concept.png

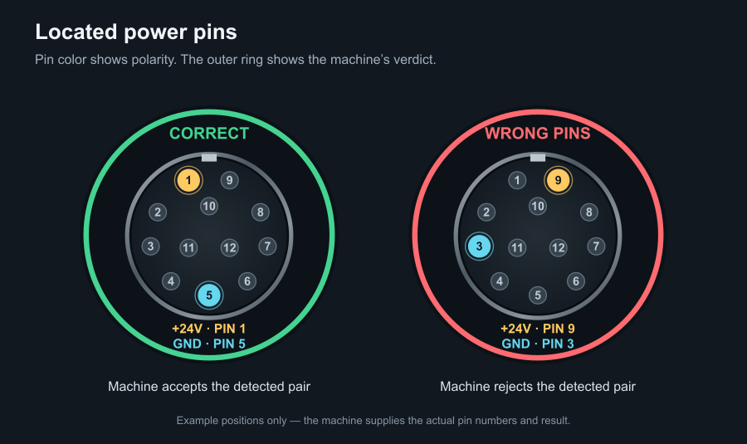
output/power-pins-concept.png
