PetterGustafsson/power-supply-tester/output/refined-display-2026-10-19/integration/display-adc-fault.png

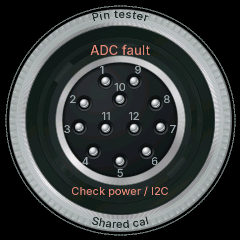
output/refined-display-2026-10-19/integration/display-adc-fault.png
