PetterGustafsson/power-supply-tester/output/rendered-power-concept.png

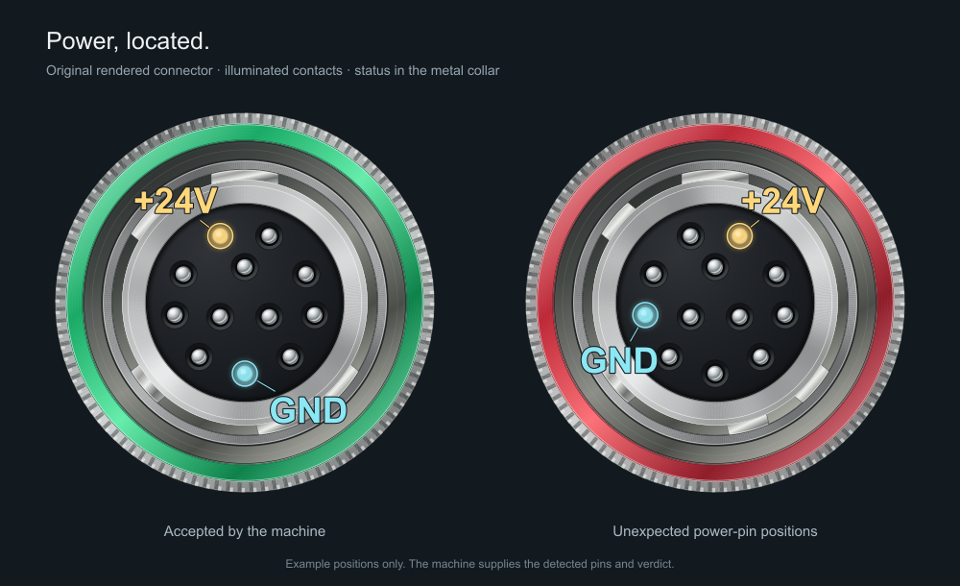
output/rendered-power-concept.png
