PetterGustafsson/power-supply-tester/output/silk-colors-240.gif

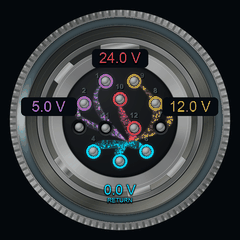
output/silk-colors-240.gif
