PetterGustafsson/power-supply-tester/output/silk-molded-preview.png

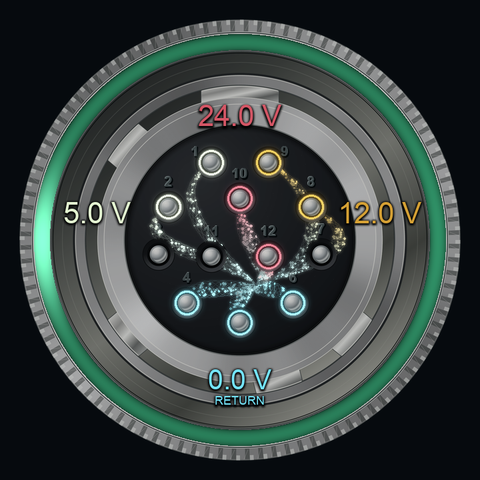
output/silk-molded-preview.png
