PetterGustafsson/power-supply-tester/outputs/01a0f347-4941-7f91-89e7-4d45a0ba72d9/summary.png

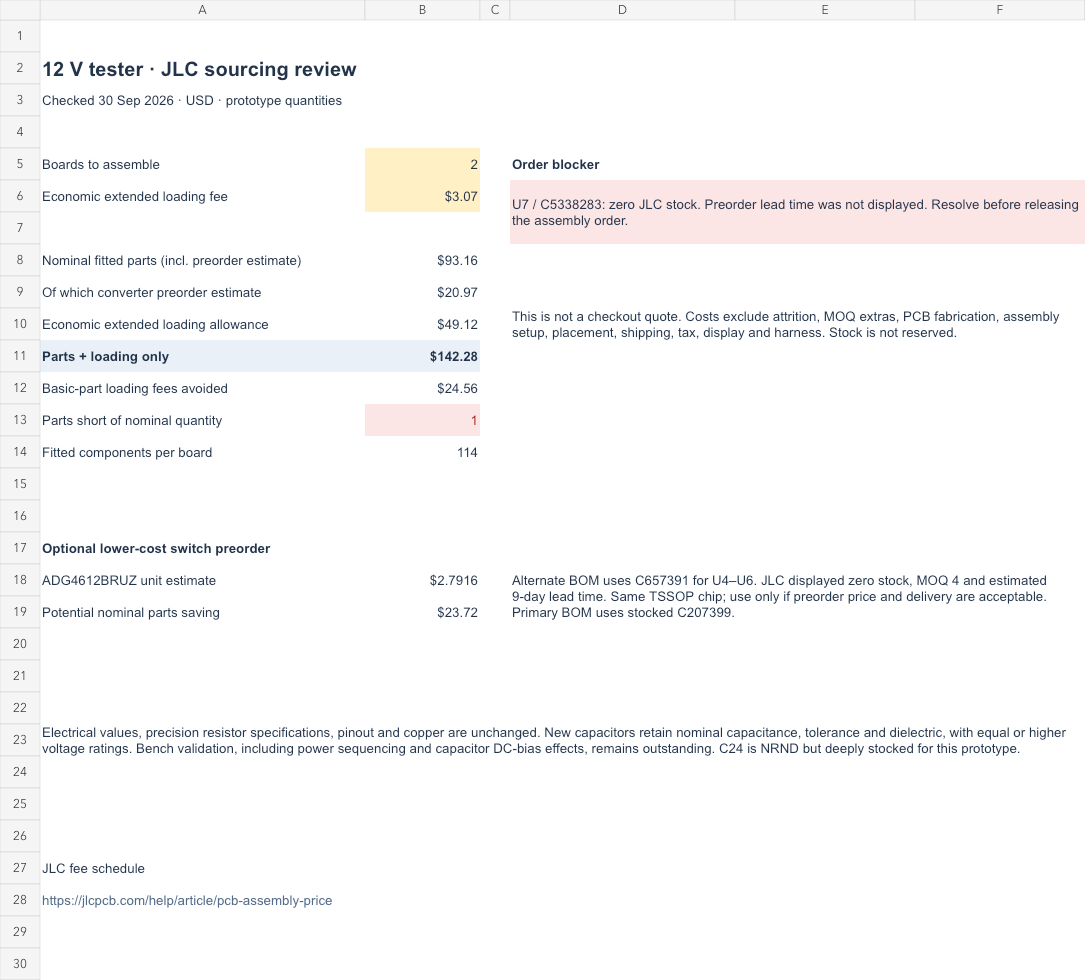
outputs/01a0f347-4941-7f91-89e7-4d45a0ba72d9/summary.png
