PetterGustafsson/power-supply-tester/references/drawing.png

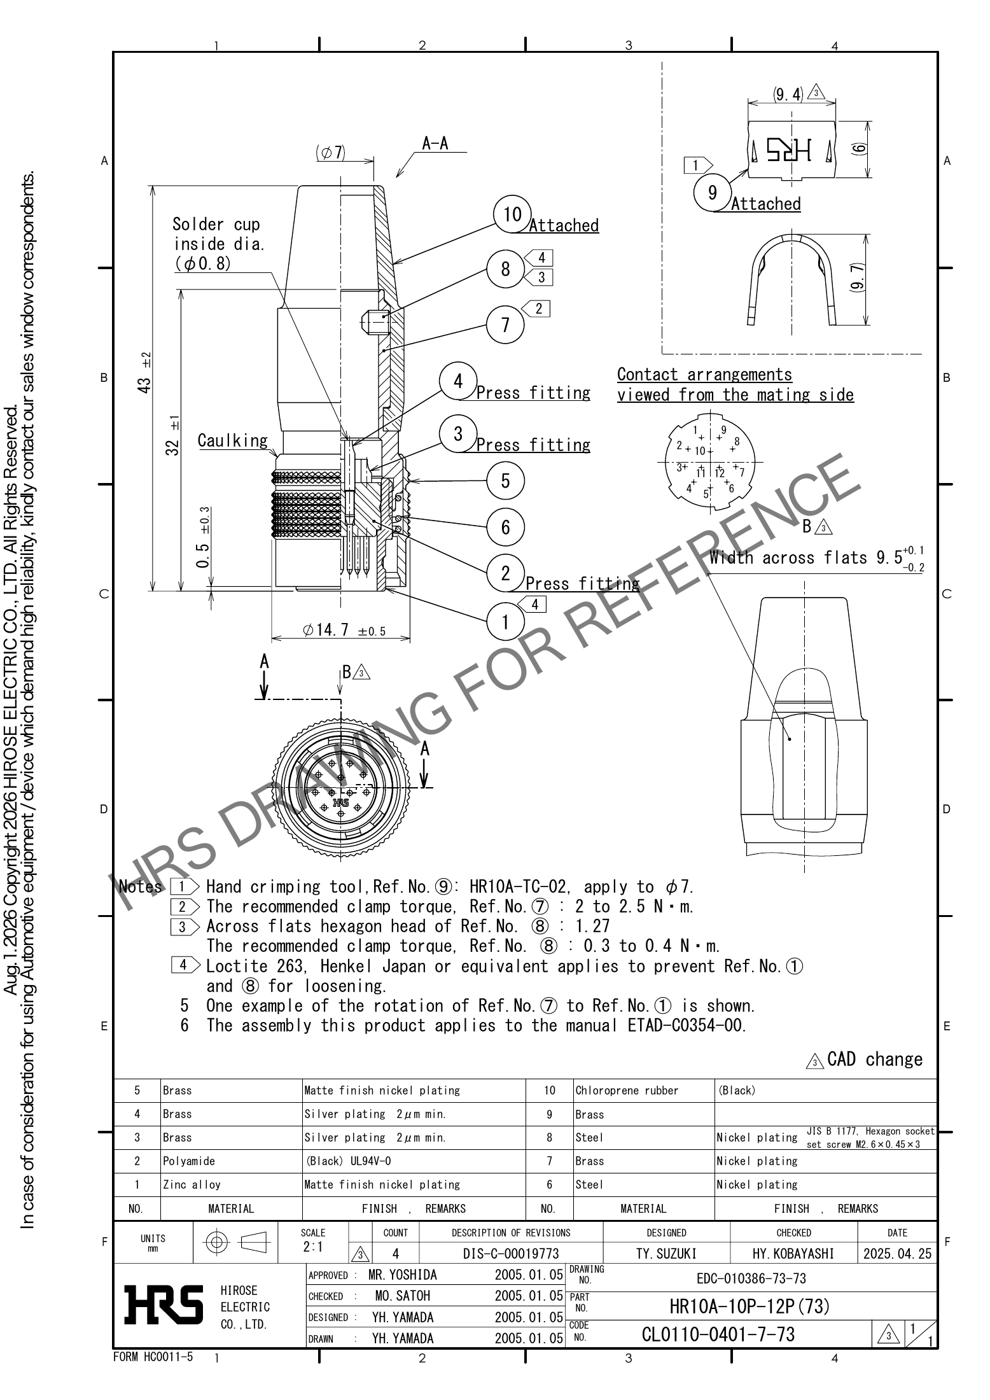
references/drawing.png
