PetterGustafsson/power-supply-tester/outputs/01a0f347-4941-7f91-89e7-4d45a0ba72d9/JLC-BOM-review.xlsx

Sheet: Summary
12 V tester · JLC sourcing review
Checked 30 Sep 2026 · USD · prototype quantities
Boards to assemble | 2 | Order blocker
Economic extended loading fee | $3.07 | U7 / C5338283: zero JLC stock. Preorder lead time was not displayed. Resolve before releasing the assembly order.
Nominal fitted parts (incl. preorder estimate) | $93.16
Of which converter preorder estimate | $20.97 | This is not a checkout quote. Costs exclude attrition, MOQ extras, PCB fabrication, assembly setup, placement, shipping, tax, display and harness. Stock is not reserved.
Economic extended loading allowance | $49.12
Parts + loading only | $142.28
Basic-part loading fees avoided | $24.56
Parts short of nominal quantity | 1
Fitted components per board | 114
Optional lower-cost switch preorder |  | Alternate BOM uses C657391 for U4–U6. JLC displayed zero stock, MOQ 4 and estimated 9-day lead time. Same TSSOP chip; use only if preorder price and delivery are acceptable. Primary BOM uses stocked C207399.
ADG4612BRUZ unit estimate | $2.7916
Potential nominal parts saving | $23.72
Electrical values, precision resistor specifications, pinout and copper are unchanged. New capacitors retain nominal capacitance, tolerance and dielectric, with equal or higher voltage ratings. Bench validation, including power sequencing and capacitor DC-bias effects, remains outstanding. C24 is NRND but deeply stocked for this prototype.
JLC fee schedule
https://jlcpcb.com/help/article/pcb-assembly-price

Sheet: BOM
Selected BOM · live JLC library snapshot
Unit price is displayed 1+ tier; no volume discount or attrition assumed. Full sources on next tab.
JLC part # | Manufacturer part number | Category | Qty / PCB | Required | Stock | Unit USD | Parts USD | Fee USD | Status
C5144867 | 1984633 | Extended | 3 | 6 | 65 | $1.5603 | $9.36 | $3.07 | IN STOCK
C865215 | RT0805BRD07165KL | Extended | 24 | 48 | 2403 | $0.0456 | $2.19 | $3.07 | IN STOCK
C282531 | BZT52H-C12,115 | Extended | 12 | 24 | 37634 | $0.0421 | $1.01 | $3.07 | IN STOCK
C110775 | RT0805BRD0710KL | Extended | 14 | 28 | 865510 | $0.0400 | $1.12 | $3.07 | IN STOCK
C122537 | RT0805BRD07100KL | Extended | 12 | 24 | 423155 | $0.0404 | $0.97 | $3.07 | IN STOCK
C62774 | CC0805JRNPO9BN102 | Extended | 13 | 26 | 1080509 | $0.0096 | $0.25 | $3.07 | IN STOCK
C37593 | ADS1115IDGSR | Extended | 3 | 6 | 26773 | $1.2190 | $7.31 | $3.07 | IN STOCK
C207399 | ADG4612BRUZ-REEL7 | Extended | 3 | 6 | 41 | $6.7450 | $40.47 | $3.07 | IN STOCK
C49678 | CC0805KRX7R9BB104 | Basic | 13 | 26 | 19276466 | $0.0189 | $0.49 | $0.00 | IN STOCK
C157991 | B5B-XH-A(LF)(SN) | Extended | 1 | 2 | 71511 | $0.0852 | $0.17 | $3.07 | IN STOCK
C5338283 | R05C05TE05S-R | Extended | 1 | 2 | 0 | $10.4867 | $20.97 | $3.07 | PREORDER
C5122339 | ISO1640BDR | Extended | 1 | 2 | 4169 | $1.8708 | $3.74 | $3.07 | IN STOCK
C404027 | TLV75533PDBVR | Extended | 1 | 2 | 137124 | $0.1421 | $0.28 | $3.07 | IN STOCK
C92494 | OPA320AIDBVR | Extended | 1 | 2 | 30656 | $1.3588 | $2.72 | $3.07 | IN STOCK
C2860914 | TLV809EA30DBZR | Extended | 1 | 2 | 800 | $0.2141 | $0.43 | $3.07 | IN STOCK
C82288 | PMEG2010ER,115 | Extended | 1 | 2 | 12880 | $0.1788 | $0.36 | $3.07 | IN STOCK
C17557 | 0805W8F2200T5E | Basic | 1 | 2 | 901910 | $0.0054 | $0.01 | $0.00 | IN STOCK
C149504 | 0805W8F1003T5E | Basic | 1 | 2 | 4232521 | $0.0059 | $0.01 | $0.00 | IN STOCK
C17673 | 0805W8F4701T5E | Basic | 2 | 4 | 5092033 | $0.0050 | $0.02 | $0.00 | IN STOCK
C17513 | 0805W8F1001T5E | Basic | 1 | 2 | 31226169 | $0.0040 | $0.01 | $0.00 | IN STOCK
C3762322 | 1206L025/24YR | Extended | 1 | 2 | 5149 | $0.2396 | $0.48 | $3.07 | IN STOCK
C15850 | CL21A106KAYNNNE | Basic | 2 | 4 | 5006159 | $0.0651 | $0.26 | $0.00 | IN STOCK
C28323 | CL21B105KBFNNNE | Basic | 1 | 2 | 2300572 | $0.0399 | $0.08 | $0.00 | IN STOCK
C45783 | CL21A226MAQNNNE | Basic | 1 | 2 | 4005225 | $0.2201 | $0.44 | $0.00 | IN STOCK

Sheet: Sources
References, substitutions and source links
Exact JLC code controls matching; reject similarly named substitute ICs. Sources checked 2026-09-30.
JLC part # | Designators | Previous MPN | Selected specification | Decision / reason | JLC source | Manufacturer source / qualification note
C5144867 | J1,J2,J3 | 1984633 | Phoenix 4-way horizontal terminal; exact original | Retained exact original | https://jlcpcb.com/parts/componentSearch?searchTxt=1984633 | Exact original retained or passive ratings/package matched in JLC library.
C865215 | R1,R2,R4,R5,R7,R8,R10,R11,R13,R14,R16,R17,R19,R20,R22,R23,R25,R26,R28,R29,R31,R32,R34,R35 | RT0805BRD07165KL | 165k; 0.1%; 25ppm/K; 125mW; 150V | Retained exact original | https://jlcpcb.com/parts/componentSearch?searchTxt=RT0805BRD07165KL | Exact original retained or passive ratings/package matched in JLC library.
C282531 | D1,D2,D3,D4,D5,D6,D7,D8,D9,D10,D11,D12 | BZT52H-C12,115 | Nexperia 12V zener; exact original | Retained exact original | https://jlcpcb.com/parts/componentSearch?searchTxt=BZT52H-C12%2C115 | Exact original retained or passive ratings/package matched in JLC library.
C110775 | R3,R6,R9,R12,R15,R18,R21,R24,R27,R30,R33,R36,R37,R38 | RT0805BRD0710KL | 10k; 0.1%; 25ppm/K; 125mW; 150V | Retained exact original | https://jlcpcb.com/parts/componentSearch?searchTxt=RT0805BRD0710KL | Exact original retained or passive ratings/package matched in JLC library.
C122537 | R46,R47,R48,R49,R50,R51,R52,R53,R54,R55,R56,R57 | RT0805BRD07100KL | 100k; 0.1%; 25ppm/K; 125mW; 150V | Retained exact original | https://jlcpcb.com/parts/componentSearch?searchTxt=RT0805BRD07100KL | Exact original retained or passive ratings/package matched in JLC library.
C62774 | C1,C2,C3,C4,C5,C6,C7,C8,C9,C10,C11,C12,C28 | GRM2165C1H102JA01D | 1nF; 5%; 50V; C0G/NP0 | Stocked replacement; 1nF, 5%, 50V, C0G/NP0 preserved | https://jlcpcb.com/parts/componentSearch?searchTxt=CC0805JRNPO9BN102 | https://www.yageogroup.com/download/specsheet/CC0805JRNPO9BN102
C37593 | U1,U2,U3 | ADS1115IDGSR | TI ADS1115; exact original | Retained exact original | https://jlcpcb.com/parts/componentSearch?searchTxt=ADS1115IDGSR | Exact original retained or passive ratings/package matched in JLC library.
C207399 | U4,U5,U6 | ADG4612BRUZ | Same ADG4612BRUZ die and RU-16 package; reel packaging | In-stock tape-and-reel packaging; same silicon, pinout and TSSOP-16 | https://jlcpcb.com/parts/componentSearch?searchTxt=ADG4612BRUZ-REEL7 | https://www.analog.com/media/en/technical-documentation/data-sheets/adg4612_4613.pdf
C49678 | C13,C16,C14,C17,C15,C18,C20,C22,C25,C26,C27,C29,C30 | GRM21BR71H104KA01L | 100nF; 10%; 50V; X7R | Basic; 100nF, 10%, 50V, X7R preserved | https://jlcpcb.com/parts/componentSearch?searchTxt=CC0805KRX7R9BB104 | https://yageogroup.com/download/specsheet/CC0805KRX7R9BB104
C157991 | J4 | B5B-XH-A(LF)(SN) | JST XH 5-way vertical; exact original | Retained exact original | https://jlcpcb.com/parts/componentSearch?searchTxt=B5B-XH-A%28LF%29%28SN%29 | Exact original retained or passive ratings/package matched in JLC library.
C5338283 | U7 | R05C05TE05S-R | RECOM isolated 5V converter; preorder MOQ 1; lead time not displayed | Retained exact original | https://jlcpcb.com/parts/componentSearch?searchTxt=R05C05TE05S-R | Exact converter retained; do not substitute a generic SOIC-16 module. Preorder estimate only.
C5122339 | U8 | ISO1640BDR | TI 8-pin B variant; exact original | Retained exact original | https://jlcpcb.com/parts/componentSearch?searchTxt=ISO1640BDR | Exact original retained or passive ratings/package matched in JLC library.
C404027 | U9 | TLV75533PDBVR | TI 3.3V LDO; exact original | Retained exact original | https://jlcpcb.com/parts/componentSearch?searchTxt=TLV75533PDBVR | Exact original retained or passive ratings/package matched in JLC library.
C92494 | U10 | OPA320AIDBVR | TI OPA320; exact original | Retained exact original | https://jlcpcb.com/parts/componentSearch?searchTxt=OPA320AIDBVR | Exact original retained or passive ratings/package matched in JLC library.
C2860914 | U11 | TLV809EA30DBZR | TI 3.08V supervisor; exact original | Retained exact original | https://jlcpcb.com/parts/componentSearch?searchTxt=TLV809EA30DBZR | Exact original retained or passive ratings/package matched in JLC library.
C82288 | D13 | PMEG2010ER,115 | Nexperia Schottky; exact original | Retained exact original | https://jlcpcb.com/parts/componentSearch?searchTxt=PMEG2010ER%2C115 | Exact original retained or passive ratings/package matched in JLC library.
C17557 | R39 | RC0805FR-07220RL | 220R; 1%; 100ppm/K; 125mW; 150V | Basic; same 1%, 100ppm/K, 125mW, 150V rating | https://jlcpcb.com/parts/componentSearch?searchTxt=0805W8F2200T5E | Exact original retained or passive ratings/package matched in JLC library.
C149504 | R40 | RC0805FR-07100KL | 100k; 1%; 100ppm/K; 125mW; 150V | Basic; same 1%, 100ppm/K, 125mW, 150V rating | https://jlcpcb.com/parts/componentSearch?searchTxt=0805W8F1003T5E | Exact original retained or passive ratings/package matched in JLC library.
C17673 | R41,R42 | RC0805FR-074K7L | 4.7k; 1%; 100ppm/K; 125mW; 150V | Basic; same 1%, 100ppm/K, 125mW, 150V rating | https://jlcpcb.com/parts/componentSearch?searchTxt=0805W8F4701T5E | Exact original retained or passive ratings/package matched in JLC library.
C17513 | R45 | RC0805FR-071KL | 1k; 1%; 100ppm/K; 125mW; 150V | Basic; same 1%, 100ppm/K, 125mW, 150V rating | https://jlcpcb.com/parts/componentSearch?searchTxt=0805W8F1001T5E | Exact original retained or passive ratings/package matched in JLC library.
C3762322 | F1 | 1206L025/24YR | Littelfuse 250mA PTC; R1max 2.3ohm; exact original | Retained exact original | https://jlcpcb.com/parts/componentSearch?searchTxt=1206L025/24YR | Exact original retained or passive ratings/package matched in JLC library.
C15850 | C19,C21 | GRM21BR61A106KE19L | 10uF; 10%; 25V; X5R | Basic; 10uF, 10%, X5R; voltage rating increased to 25V | https://jlcpcb.com/parts/componentSearch?searchTxt=CL21A106KAYNNNE | JLC listing: 10uF 25V X5R 10% 0805; real effective capacitance and supply transients still need bench verification.
C28323 | C23 | GRM21BR71E105KA99L | 1uF; 10%; 50V; X7R | Basic; 1uF, 10%, X7R; voltage rating increased to 50V | https://jlcpcb.com/parts/componentSearch?searchTxt=CL21B105KBFNNNE | https://product.samsungsem.com/mlcc/CL21B105KBFNNN.do
C45783 | C24 | GRM21BR61A226ME44L | 22uF; 20%; 25V; X5R; manufacturer NRND | Basic; 22uF, 20%, X5R; 25V. NRND but deep JLC stock for prototype; requalify for production | https://jlcpcb.com/parts/componentSearch?searchTxt=CL21A226MAQNNNE | https://product.samsungsem.com/cn/mlcc/CL21A226MAQNNN.do — NRND; fine for stocked prototype, review for production.
