PetterGustafsson/power-supply-tester/hardware/tester12v-rev-d-engineering-package/hardware/rev-d/manufacturing/pin1-review.csv

Reference | MPN | Pin1 X mm | Pin1 Y mm | Pin1 net | Instructions
J1 | XY350V-3.5-4P | 26.75 | 52.0 | P1 | Board coordinates: X right, Y down. Match physical pin 1 in JLC viewer.
J2 | XY350V-3.5-4P | 46.75 | 52.0 | P5 | Board coordinates: X right, Y down. Match physical pin 1 in JLC viewer.
J3 | XY350V-3.5-4P | 66.75 | 52.0 | P9 | Board coordinates: X right, Y down. Match physical pin 1 in JLC viewer.
U1 | ADS1115IDGSR | 29.85 | 19.0 | AGND | Board coordinates: X right, Y down. Match physical pin 1 in JLC viewer.
U2 | ADS1115IDGSR | 49.85 | 19.0 | A3V3 | Board coordinates: X right, Y down. Match physical pin 1 in JLC viewer.
U3 | ADS1115IDGSR | 69.85 | 19.0 | SDA_ISO | Board coordinates: X right, Y down. Match physical pin 1 in JLC viewer.
U8 | ADS1115IDGSR | 59.85 | 19.0 | SCL_ISO | Board coordinates: X right, Y down. Match physical pin 1 in JLC viewer.
J4 | B5B-XH-A(LF)(SN) | 6.0 | 46.0 | USB5V | Board coordinates: X right, Y down. Match physical pin 1 in JLC viewer.
U4 | TLV75533PDBVR | 6.8625 | 9.05 | USB5V_F | Board coordinates: X right, Y down. Match physical pin 1 in JLC viewer.
U5 | TPS70933DBVR | 27.8625 | 9.05 | ISO5V_RAW | Board coordinates: X right, Y down. Match physical pin 1 in JLC viewer.
U6 | ISO1640BDR | 14.525 | 25.095 | HOST3V3 | Board coordinates: X right, Y down. Match physical pin 1 in JLC viewer.
U7 | B0305S-1WR3 | 13.19 | 17.0 | USB_GND | Board coordinates: X right, Y down. Match physical pin 1 in JLC viewer.
D1 | PMEG2010ER,115 | 6.6 | 15.0 | USB5V_F | Board coordinates: X right, Y down. Match physical pin 1 in JLC viewer.
