PetterGustafsson/power-supply-tester/case-cad/renders/I6_parts_layout.png

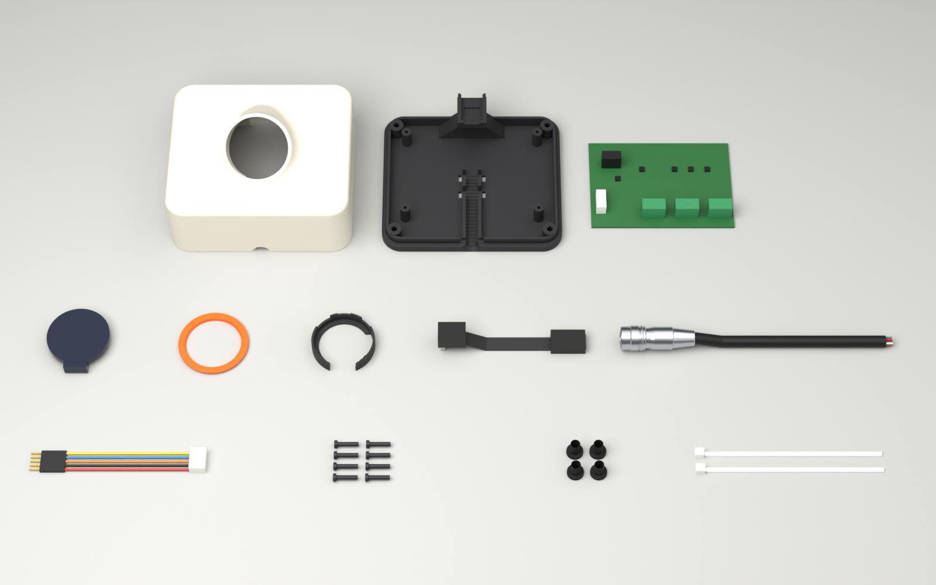
case-cad/renders/I6_parts_layout.png
