PetterGustafsson/power-supply-tester/case-cad/renders/I7_parts_layout.png

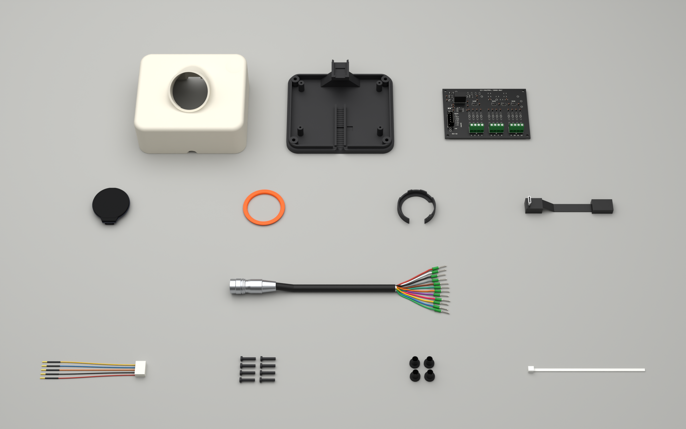
case-cad/renders/I7_parts_layout.png
