PetterGustafsson/power-supply-tester/case-cad/renders/I7_parts_layout_wes.png

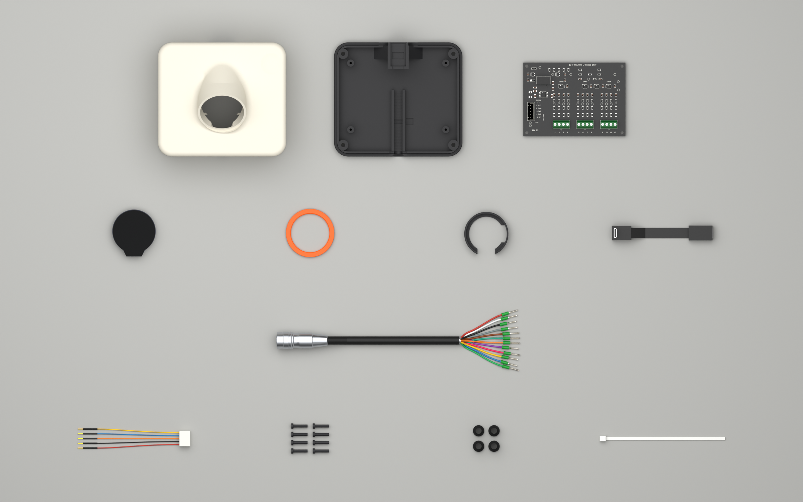
case-cad/renders/I7_parts_layout_wes.png
