PetterGustafsson/power-supply-tester/output/agnd-pogo-jig-d2/print-parts-preview.png

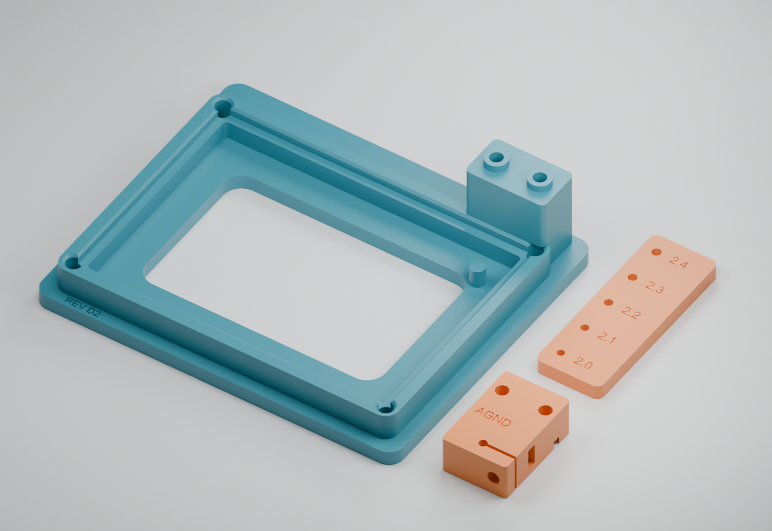
output/agnd-pogo-jig-d2/print-parts-preview.png
