PetterGustafsson/power-supply-tester/case-cad/cad_I10/stl/I10_retainer_print.stl

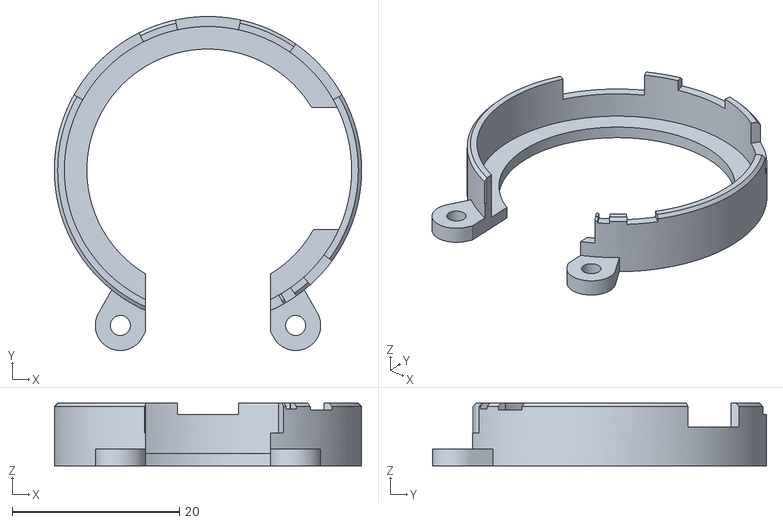
[picture p88: CAD file, 2026-10-23]
case-cad/cad_I10/stl/I10_retainer_print.stl
36.8 x 40.0 x 7.50
