PetterGustafsson/power-supply-tester/case-cad/cad_I11/stl/I11_top_print.stl

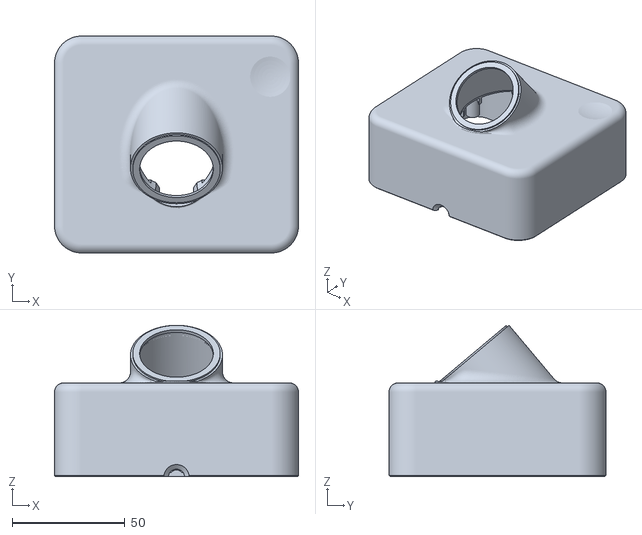
[picture p89: CAD file, 2026-10-23]
case-cad/cad_I11/stl/I11_top_print.stl
108.0 x 96.0 x 67.0
