PetterGustafsson/power-supply-tester/case-cad/cad_I13/PSU_case_I13_print.3mf

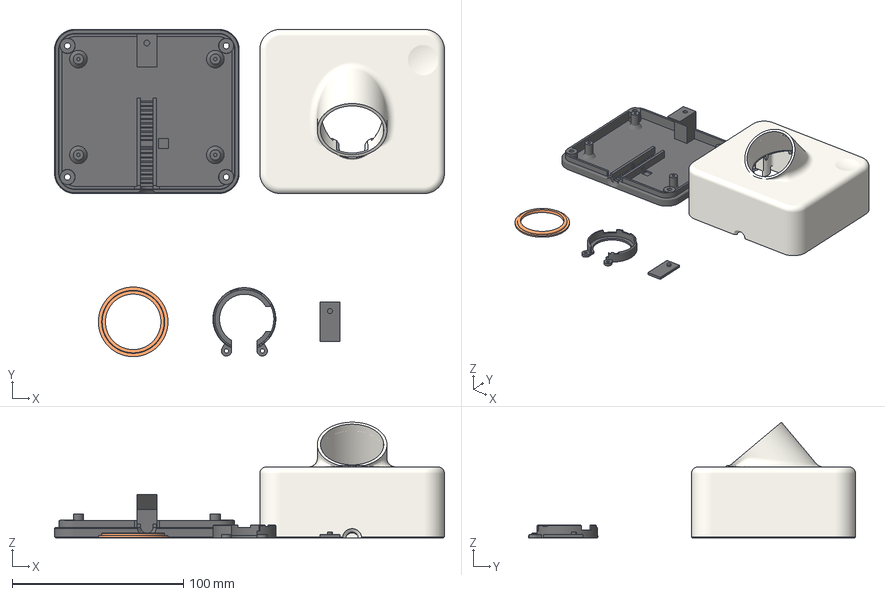
[picture p90: CAD file, 2026-10-23]
case-cad/cad_I13/PSU_case_I13_print.3mf
228.0 x 191.3 x 67.6 mm
I13_base
I13_top
I13_crown
I13_retainer
I13_shim
