PetterGustafsson/power-supply-tester/case-cad/cad_I15/PSU_case_I15_print.3mf

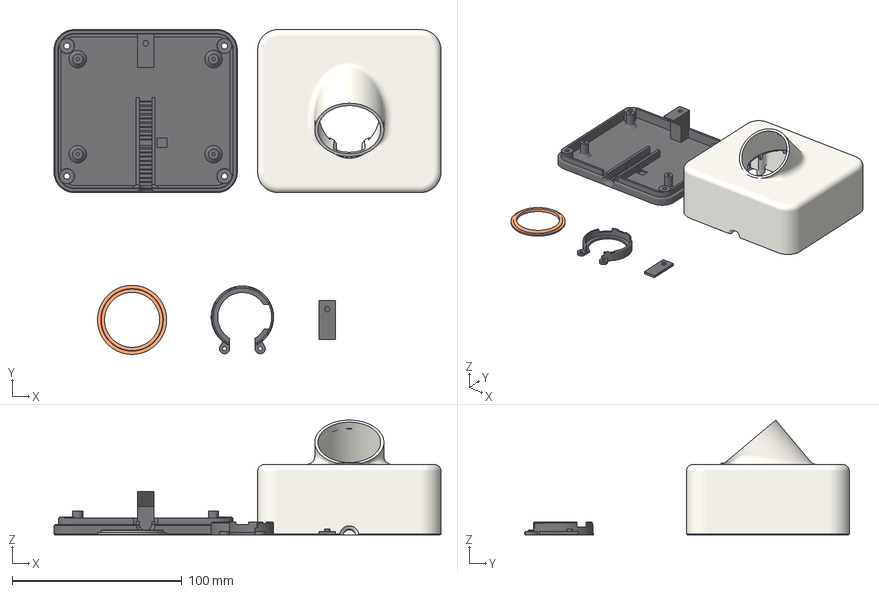
[picture p91: CAD file, 2026-10-23]
case-cad/cad_I15/PSU_case_I15_print.3mf
228.0 x 191.3 x 67.6 mm
I15_base
I15_top
I15_crown
I15_retainer
I15_shim
