PetterGustafsson/power-supply-tester/case-cad/cad_I3/PSU_case_I3_print.3mf

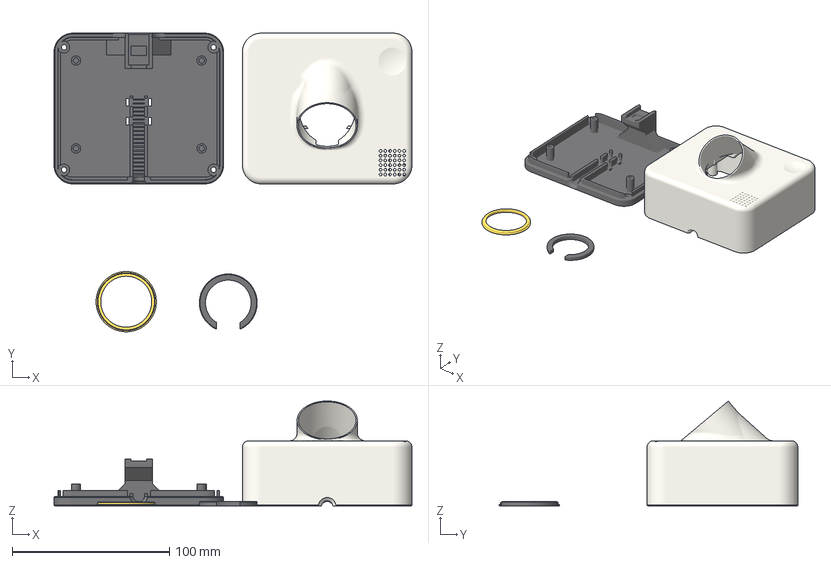
[picture p92: CAD file, 2026-10-23]
case-cad/cad_I3/PSU_case_I3_print.3mf
228.0 x 190.2 x 66.9 mm
I3_base
I3_top
I3_crown
I3_retainer
