PetterGustafsson/power-supply-tester/case-cad/cad_I4/PSU_case_I4_print.3mf

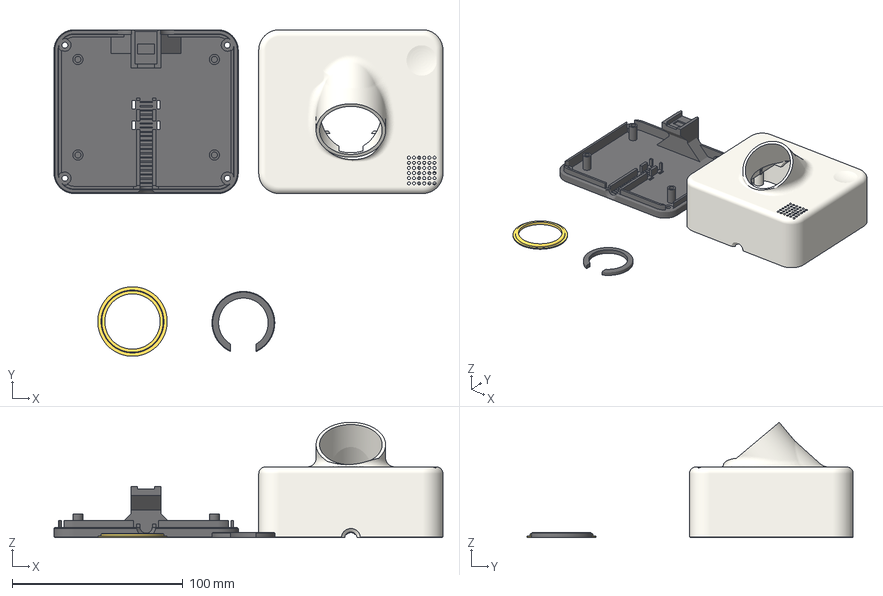
[picture p93: CAD file, 2026-10-23]
case-cad/cad_I4/PSU_case_I4_print.3mf
228.0 x 191.3 x 67.6 mm
I4_base
I4_top
I4_crown
I4_retainer
