PetterGustafsson/power-supply-tester/case-cad/cad_I5/PSU_case_I5_print.3mf

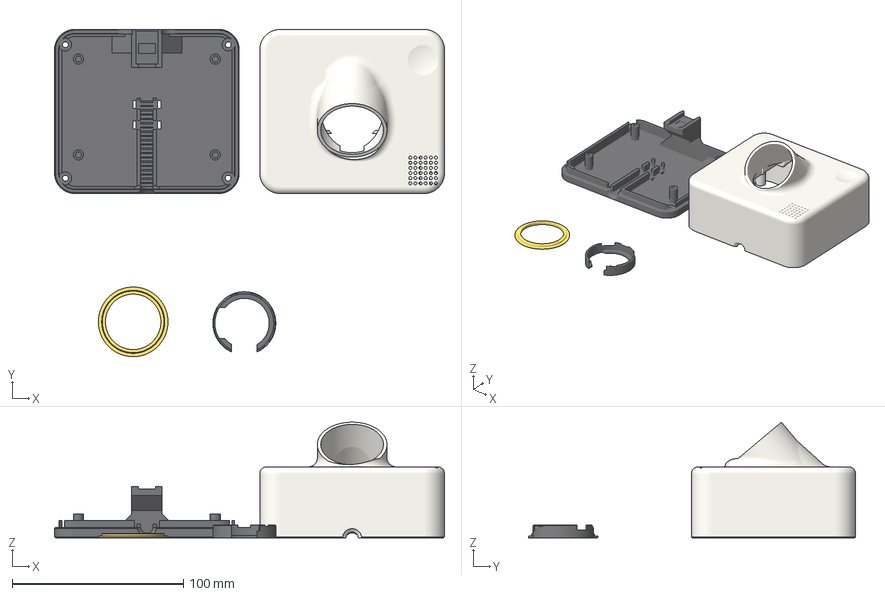
[picture p94: CAD file, 2026-10-23]
case-cad/cad_I5/PSU_case_I5_print.3mf
228.0 x 191.3 x 67.6 mm
I5_base
I5_top
I5_crown
I5_retainer
