PetterGustafsson/power-supply-tester/case-cad/cad_I6/PSU_case_I6_print.3mf

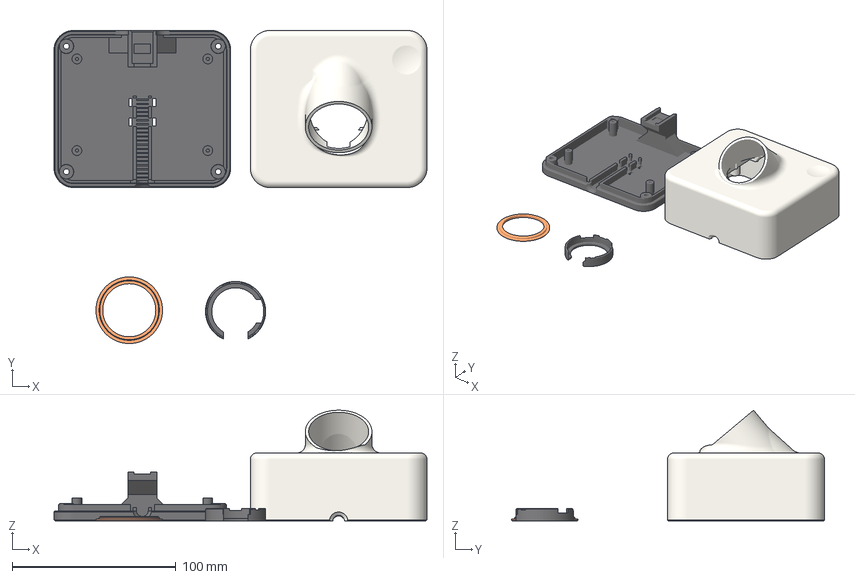
[picture p95: CAD file, 2026-10-23]
case-cad/cad_I6/PSU_case_I6_print.3mf
228.0 x 191.3 x 67.6 mm
I6_base
I6_top
I6_crown
I6_retainer
