PetterGustafsson/power-supply-tester/case-cad/cad_I8/PSU_case_I8_print.3mf

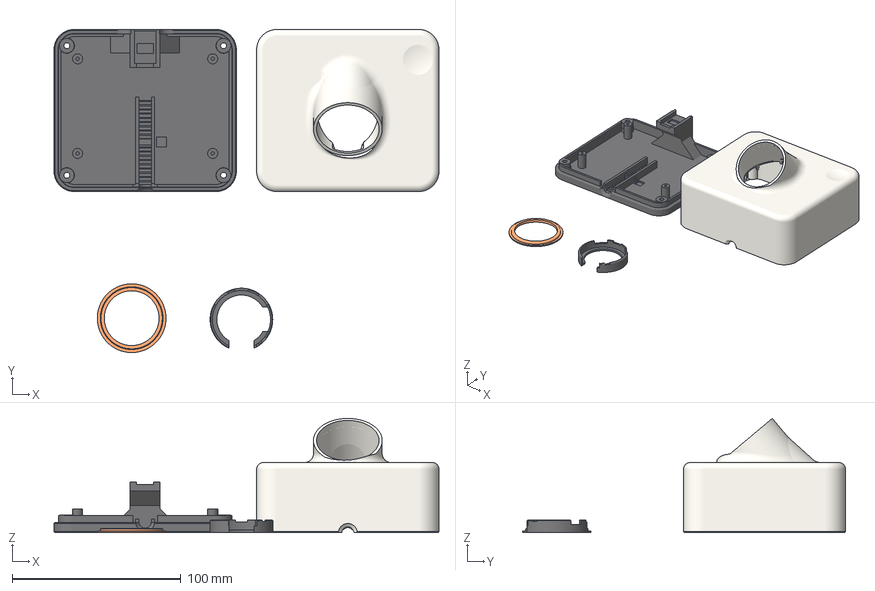
[picture p96: CAD file, 2026-10-23]
case-cad/cad_I8/PSU_case_I8_print.3mf
228.0 x 191.3 x 67.6 mm
I8_base
I8_top
I8_crown
I8_retainer
