PetterGustafsson/power-supply-tester/case-cad/cad_I9/step/I9_top.step

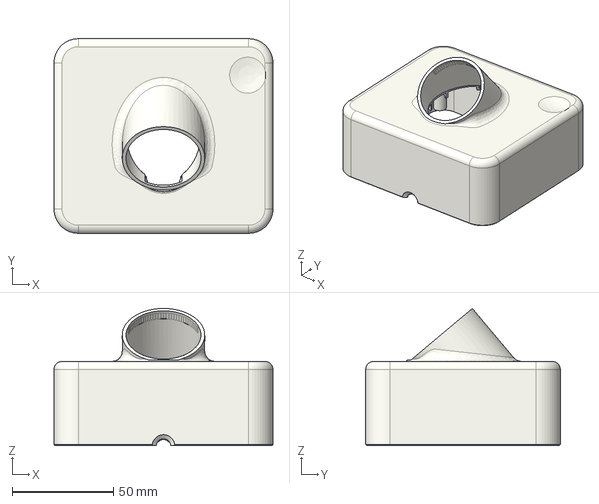
[picture p97: CAD file, 2026-10-23]
case-cad/cad_I9/step/I9_top.step
108.0 x 96.0 x 67.6 mm
