PetterGustafsson/power-supply-tester/case-cad/cad_I9/stl/REF_cable_12pin_7mm_external.stl

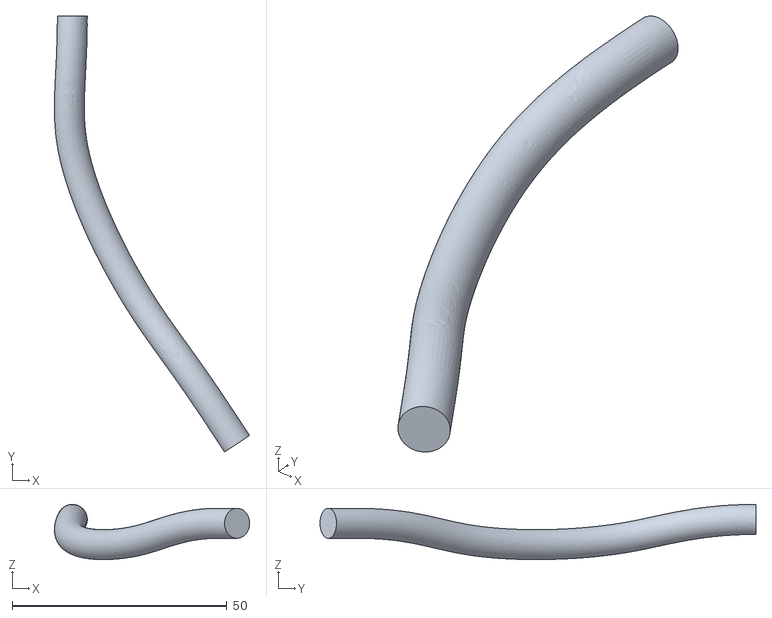
[picture p98: CAD file, 2026-10-23]
case-cad/cad_I9/stl/REF_cable_12pin_7mm_external.stl
45.5 x 101.6 x 12.9
