PetterGustafsson/power-supply-tester/case-cad/cad_I9/stl/render/usb_female_tongue.stl

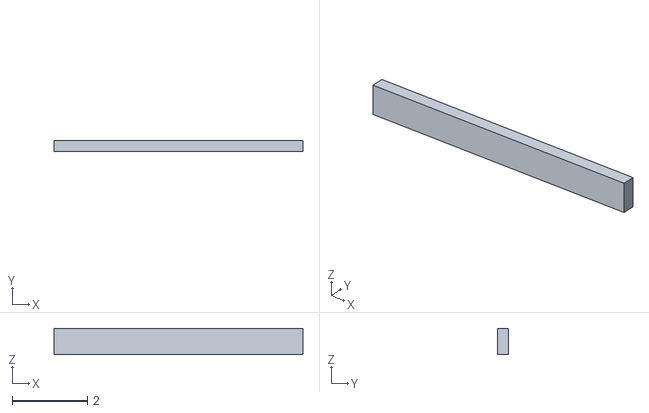
[picture p99: CAD file, 2026-10-23]
case-cad/cad_I9/stl/render/usb_female_tongue.stl
6.60 x 0.3 x 0.7
