PetterGustafsson/power-supply-tester/case-cad/current/I15_crown_print.stl

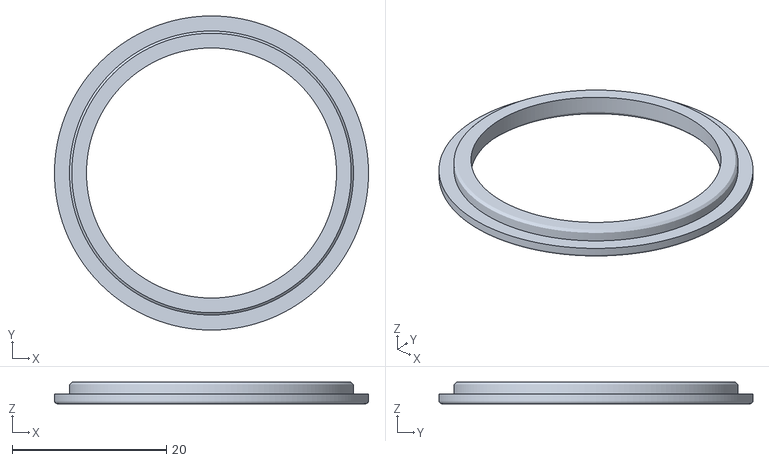
[picture p100: CAD file, 2026-10-23]
case-cad/current/I15_crown_print.stl
40.7 x 40.7 x 2.80
