PetterGustafsson/power-supply-tester/case-cad/ref/HR10A-10P-12S73_derived.step

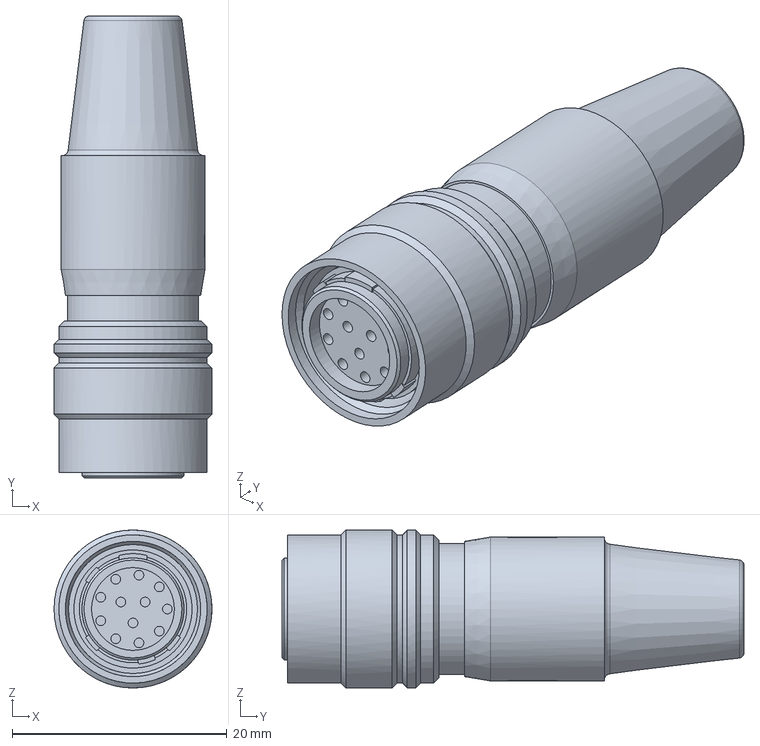
[picture p101: CAD file, 2026-10-23]
case-cad/ref/HR10A-10P-12S73_derived.step
14.7 x 43.0 x 14.7 mm
