PetterGustafsson/power-supply-tester/output/agnd-pogo-jig-d2/02_pogo_arm.stl

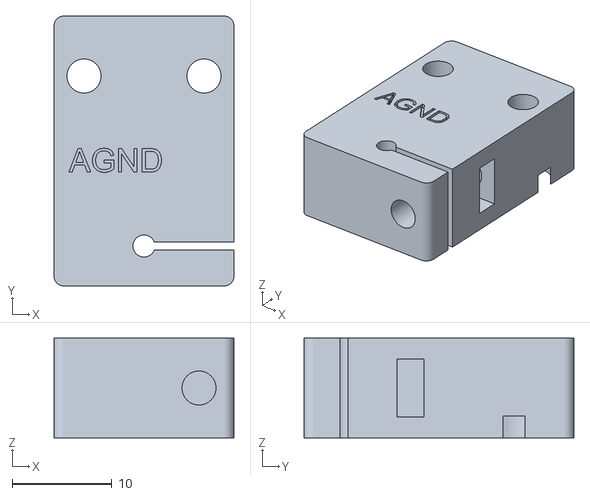
[picture p102: CAD file, 2026-10-23]
output/agnd-pogo-jig-d2/02_pogo_arm.stl
18.0 x 27.0 x 10.0
