PetterGustafsson/power-supply-tester/case-cad/cad_I9/step/I9_retainer.step

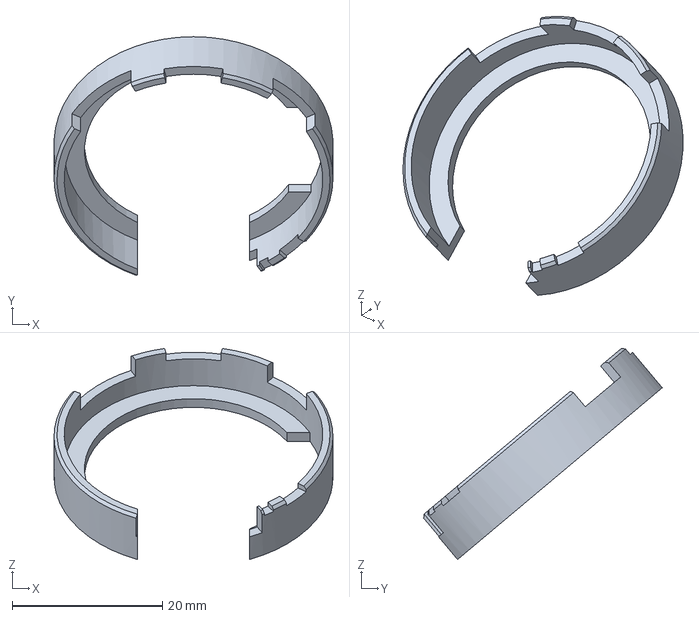
[picture p103: CAD file, 2026-10-23]
case-cad/cad_I9/step/I9_retainer.step
37.1 x 31.7 x 28.1 mm
