PetterGustafsson/power-supply-tester/case-cad/cad_I9/stl/I9_crown_print.stl

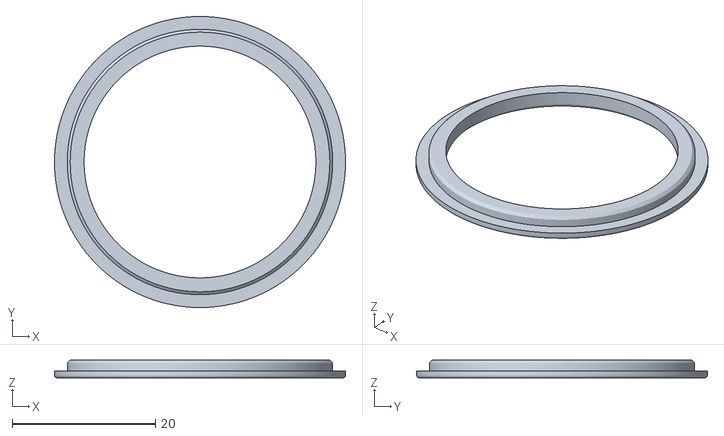
[picture p104: CAD file, 2026-10-23]
case-cad/cad_I9/stl/I9_crown_print.stl
40.7 x 40.7 x 2.50
