PetterGustafsson/power-supply-tester/case-cad/cad_I9/stl/render/usb_male_body.stl

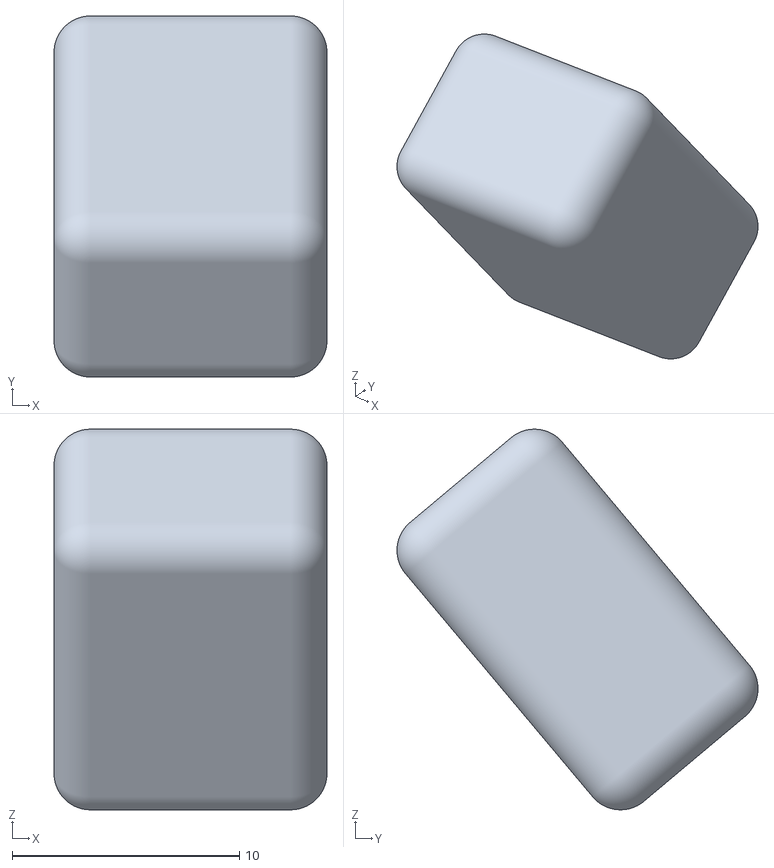
[picture p105: CAD file, 2026-10-23]
case-cad/cad_I9/stl/render/usb_male_body.stl
12.0 x 15.9 x 16.7
