PetterGustafsson/power-supply-tester/case-cad/current/I15_base_print.stl

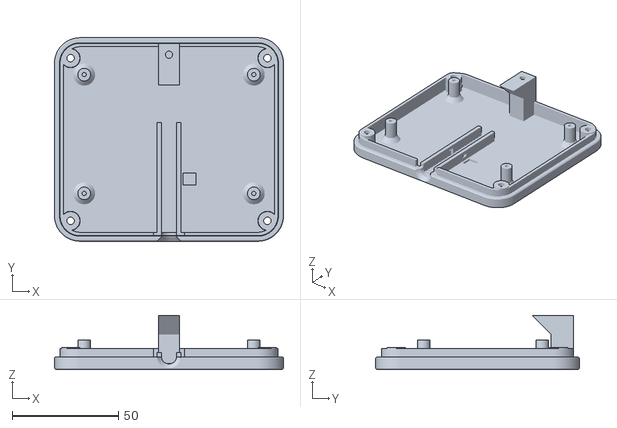
[picture p106: CAD file, 2026-10-23]
case-cad/current/I15_base_print.stl
108.0 x 96.0 x 25.5
