PetterGustafsson/power-supply-tester/output/agnd-pogo-jig-d2/D2_AGND_jig_drop_in.3mf

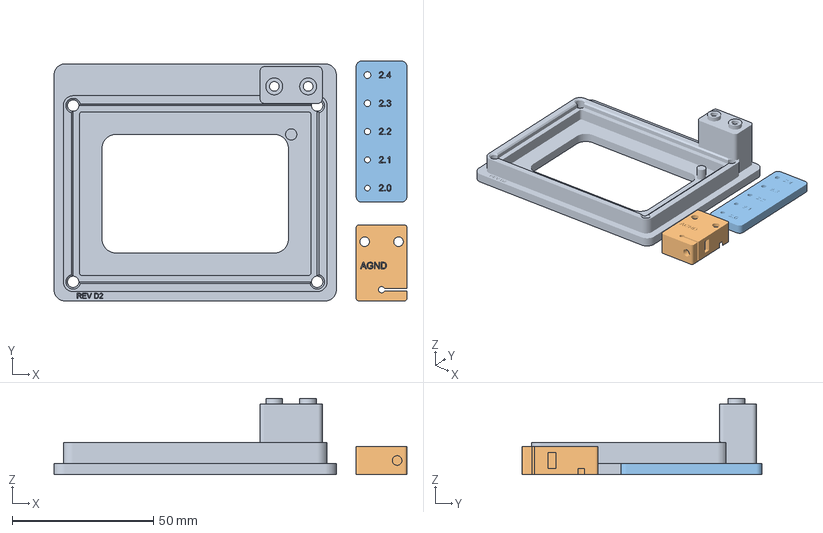
[picture p107: CAD file, 2026-10-23]
output/agnd-pogo-jig-d2/D2_AGND_jig_drop_in.3mf
125.0 x 85.0 x 27.0 mm
01_base
02_pogo_arm
03_pin_fit_coupon
