PetterGustafsson/power-supply-tester/case-cad/cad_I9/step/I9_crown.step

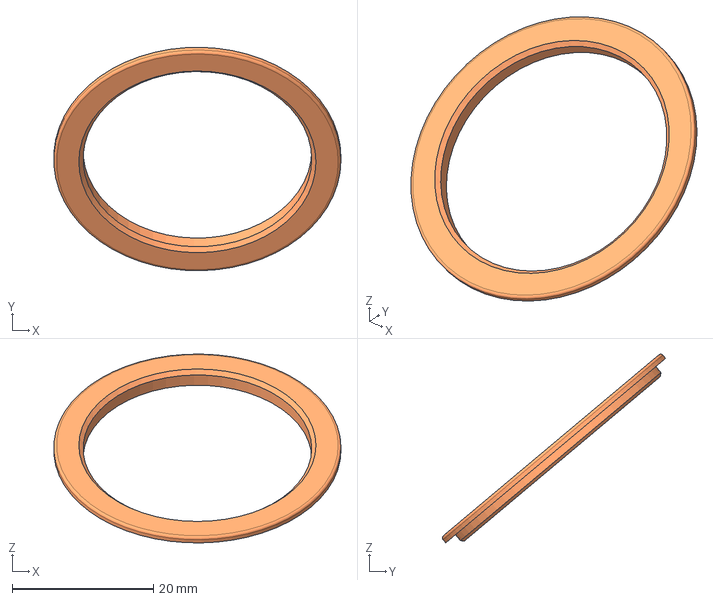
[picture p108: CAD file, 2026-10-23]
case-cad/cad_I9/step/I9_crown.step
40.7 x 31.6 x 26.8 mm
