PetterGustafsson/power-supply-tester/case-cad/cad_I9/stl/REF_grommet_foot_x4.stl

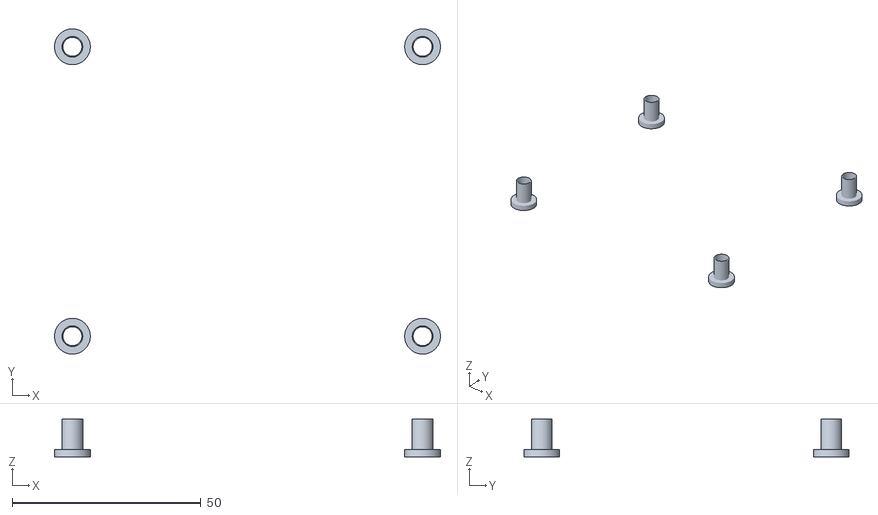
[picture p109: CAD file, 2026-10-23]
case-cad/cad_I9/stl/REF_grommet_foot_x4.stl
102.3 x 86.2 x 10.0
