PetterGustafsson/power-supply-tester/case-cad/cad_I9/stl/render/REF_PCB_SMD_parts__dark.stl

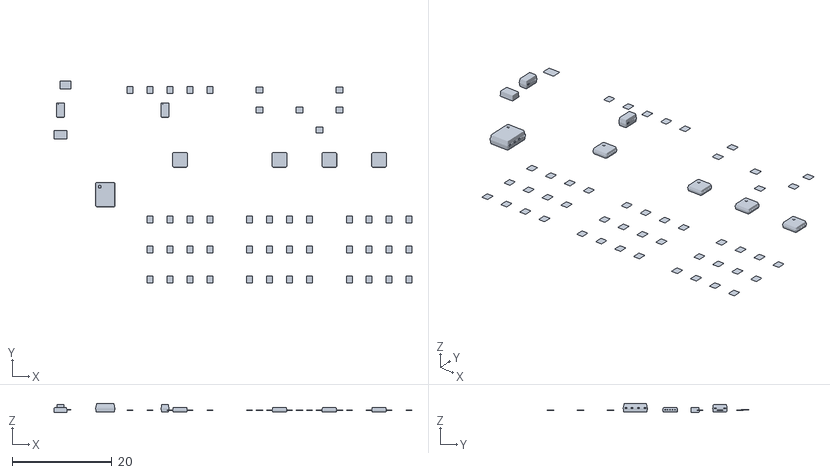
[picture p110: CAD file, 2026-10-23]
case-cad/cad_I9/stl/render/REF_PCB_SMD_parts__dark.stl
71.9 x 40.5 x 1.73
