PetterGustafsson/power-supply-tester/case-cad/current/I15_top_print.stl

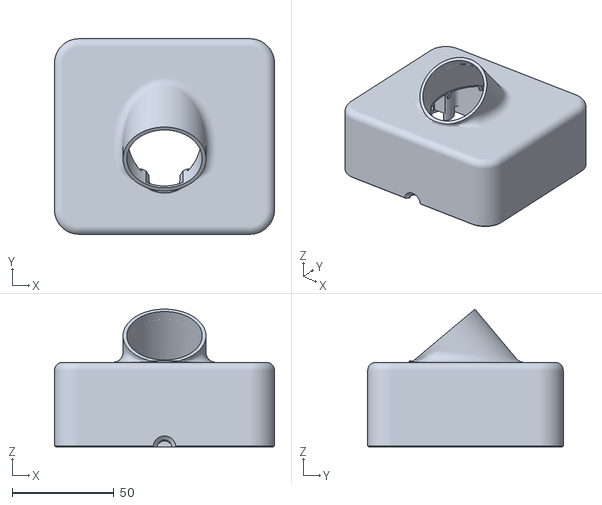
[picture p111: CAD file, 2026-10-23]
case-cad/current/I15_top_print.stl
108.0 x 96.0 x 67.6
