PetterGustafsson/power-supply-tester/output/agnd-pogo-jig-d2/03_pin_fit_coupon.stl

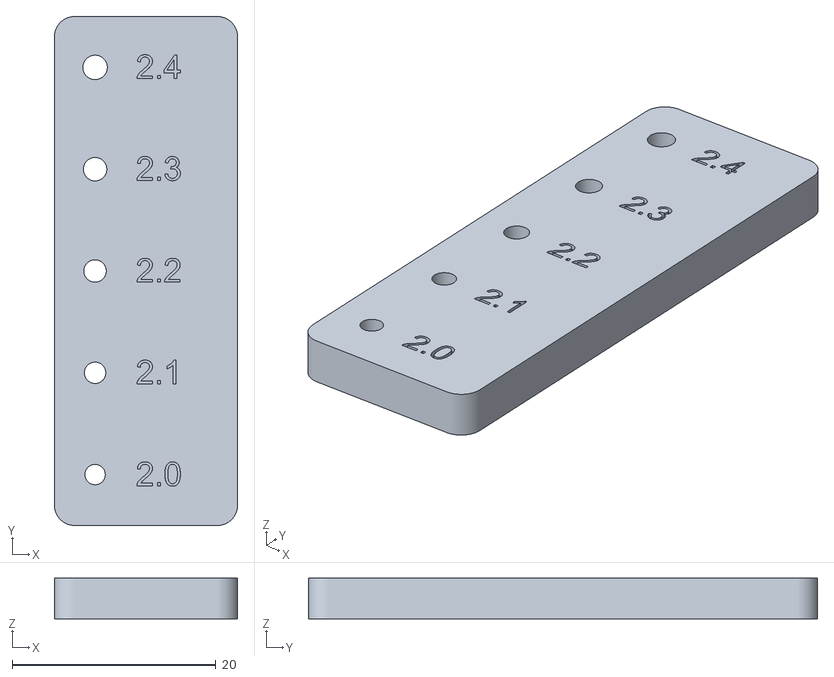
[picture p112: CAD file, 2026-10-23]
output/agnd-pogo-jig-d2/03_pin_fit_coupon.stl
18.0 x 50.0 x 4.00
