PetterGustafsson/power-supply-tester/case-cad/cad_I9/step/I9_base.step

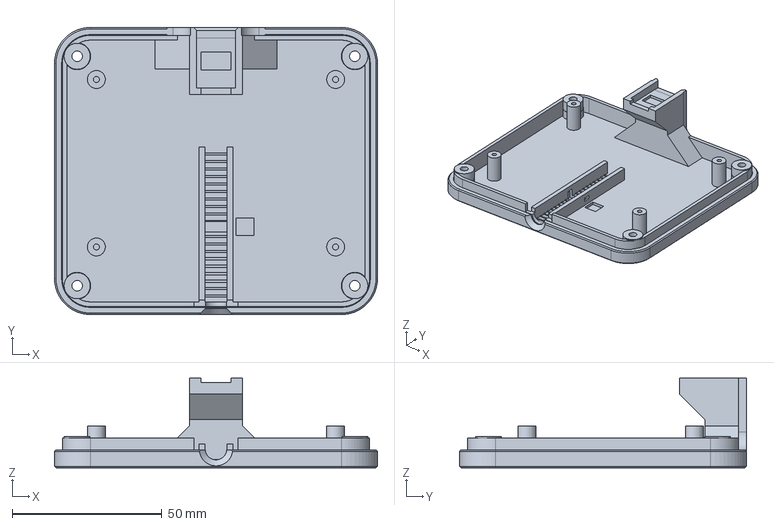
[picture p113: CAD file, 2026-10-23]
case-cad/cad_I9/step/I9_base.step
108.0 x 96.0 x 30.0 mm
