PetterGustafsson/power-supply-tester/case-cad/cad_I9/stl/REF_PCB_J1_XY350V_4p.stl

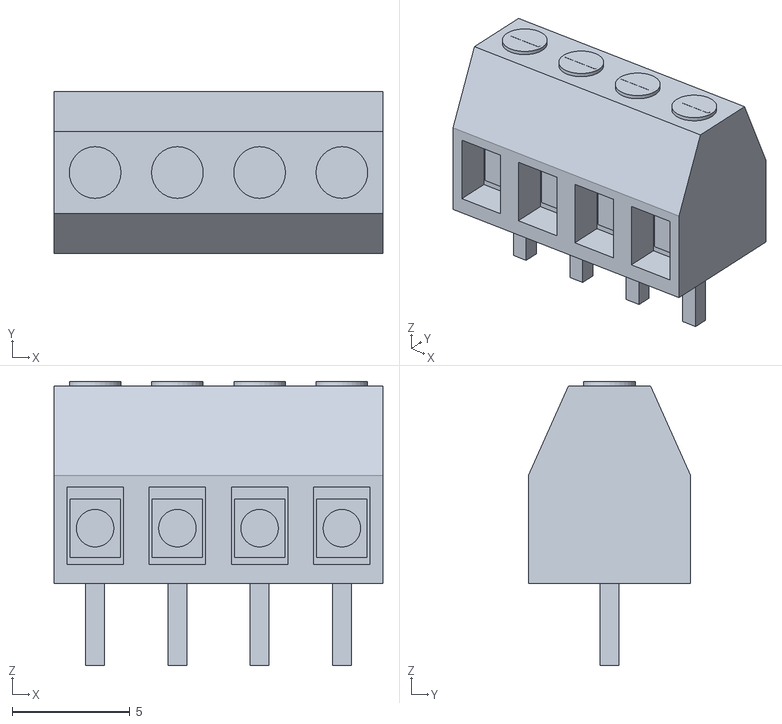
[picture p114: CAD file, 2026-10-23]
case-cad/cad_I9/stl/REF_PCB_J1_XY350V_4p.stl
14.0 x 6.90 x 12.1
