PetterGustafsson/power-supply-tester/case-cad/cad_I9/stl/render/REF_PCB_SMD_parts__brown.stl

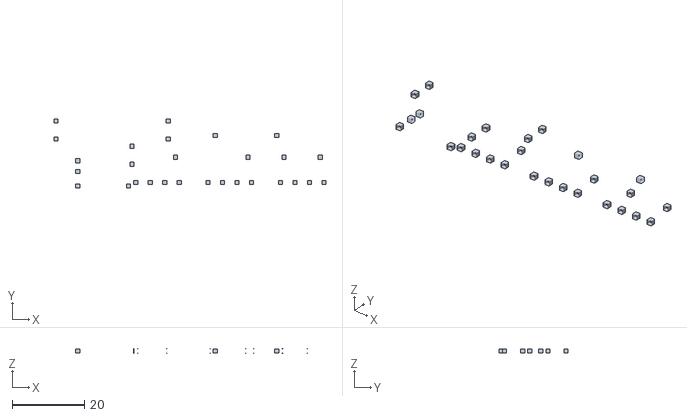
[picture p115: CAD file, 2026-10-23]
case-cad/cad_I9/stl/render/REF_PCB_SMD_parts__brown.stl
75.2 x 19.2 x 1.17
