PetterGustafsson/power-supply-tester/output/agnd-pogo-jig-d2/01_base.stl

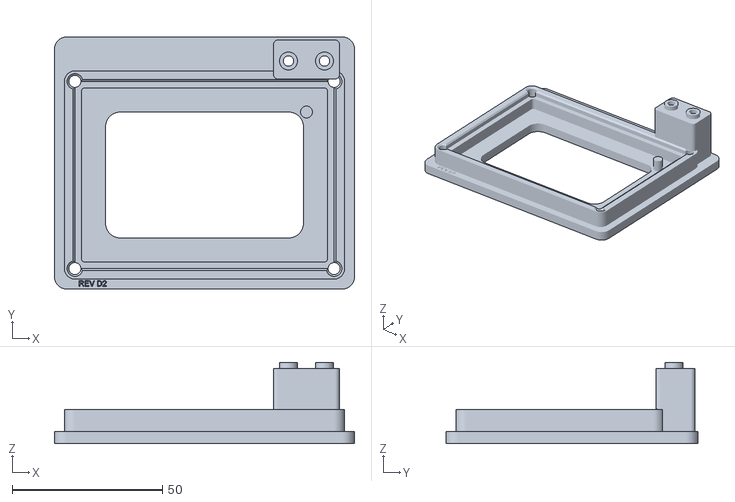
[picture p116: CAD file, 2026-10-23]
output/agnd-pogo-jig-d2/01_base.stl
100.0 x 84.0 x 27.0
