PetterGustafsson/power-supply-tester/case-cad/cad_I9/stl/render/display_LCM.stl

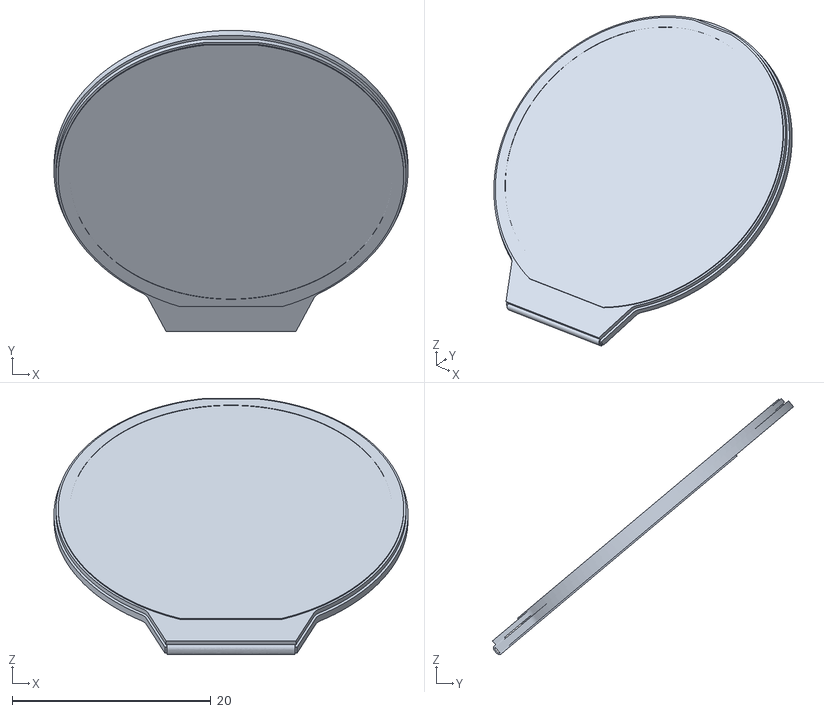
[picture p117: CAD file, 2026-10-23]
case-cad/cad_I9/stl/render/display_LCM.stl
35.6 x 30.3 x 25.8
