PetterGustafsson/power-supply-tester/output/agnd-pogo-jig-d2/D2_AGND_jig.step

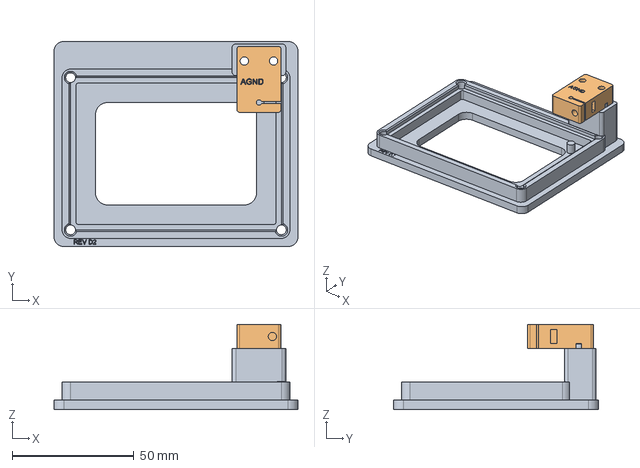
[picture p118: CAD file, 2026-10-23]
output/agnd-pogo-jig-d2/D2_AGND_jig.step
100.0 x 84.0 x 35.0 mm
