PetterGustafsson/power-supply-tester/case-cad/cad_I9/stl/render/REF_PCB_J2_XY350V_4p__metal.stl

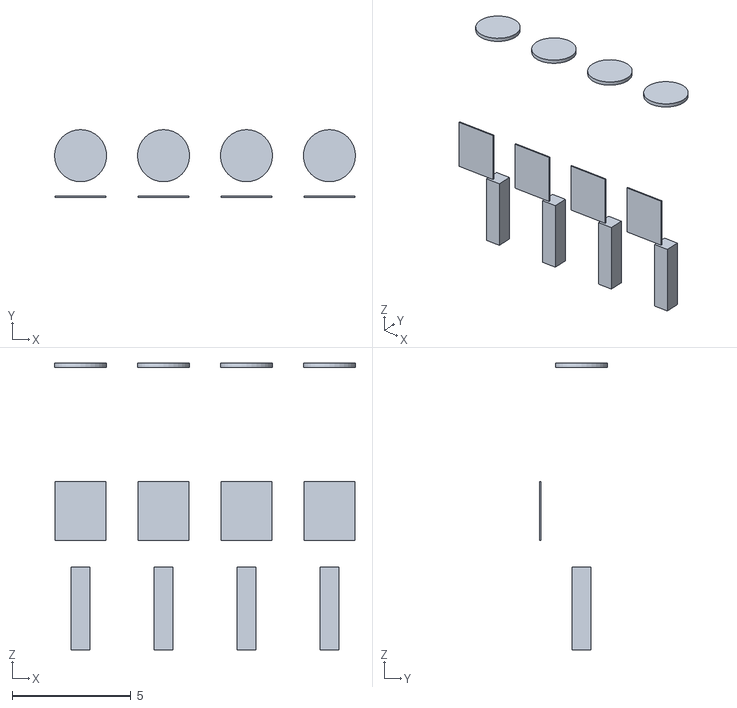
[picture p119: CAD file, 2026-10-23]
case-cad/cad_I9/stl/render/REF_PCB_J2_XY350V_4p__metal.stl
12.7 x 2.86 x 12.1
