PetterGustafsson/power-supply-tester/case-cad/cad_I9/stl/render/display_PCB_cutmod.stl

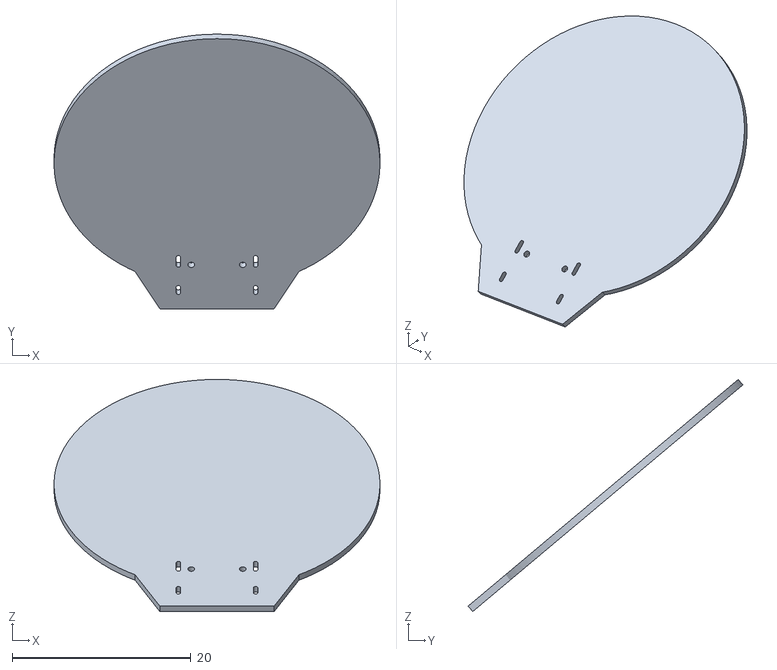
[picture p120: CAD file, 2026-10-23]
case-cad/cad_I9/stl/render/display_PCB_cutmod.stl
36.5 x 30.8 x 26.0
