PetterGustafsson/power-supply-tester/case-cad/cad_I9/stl/REF_PCB_RevD2_board.stl

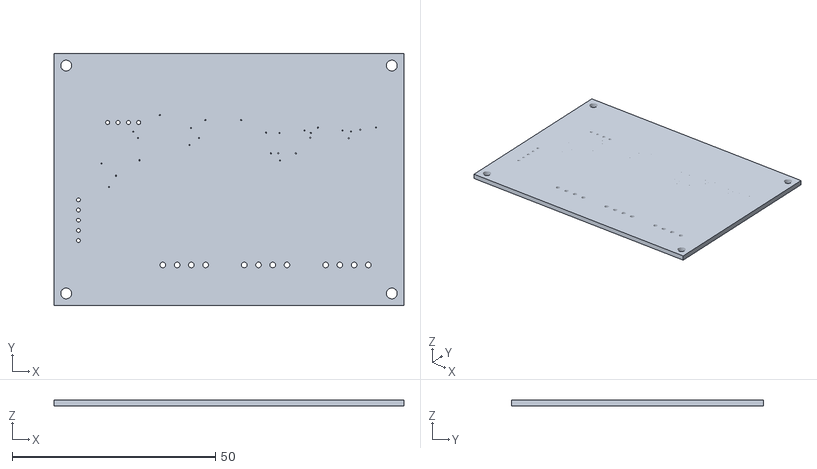
[picture p121: CAD file, 2026-10-23]
case-cad/cad_I9/stl/REF_PCB_RevD2_board.stl
86.0 x 62.0 x 1.57
