PetterGustafsson/power-supply-tester/case-cad/cad_I9/stl/render/cable_cutTY_cap.stl

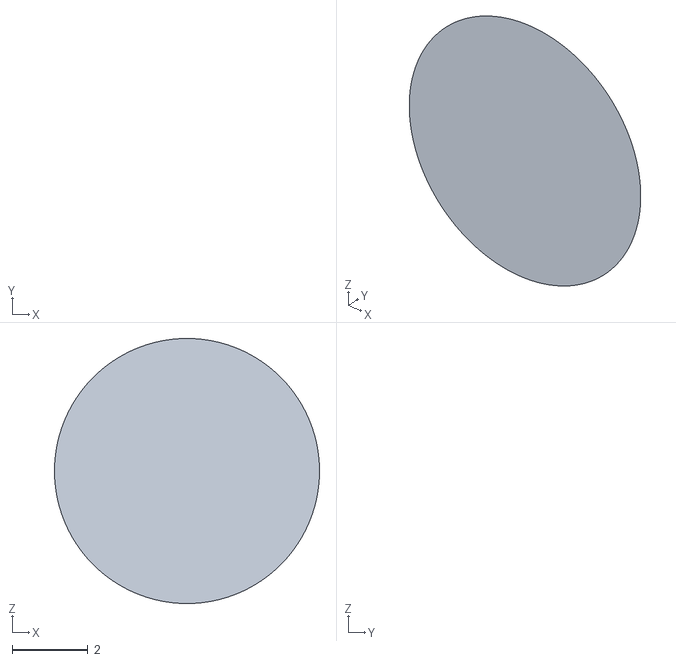
[picture p122: CAD file, 2026-10-23]
case-cad/cad_I9/stl/render/cable_cutTY_cap.stl
7.00 x 0 x 7.00
