PetterGustafsson/power-supply-tester/case-cad/cad_I9/stl/REF_ferrule_strand_ends_x12.stl

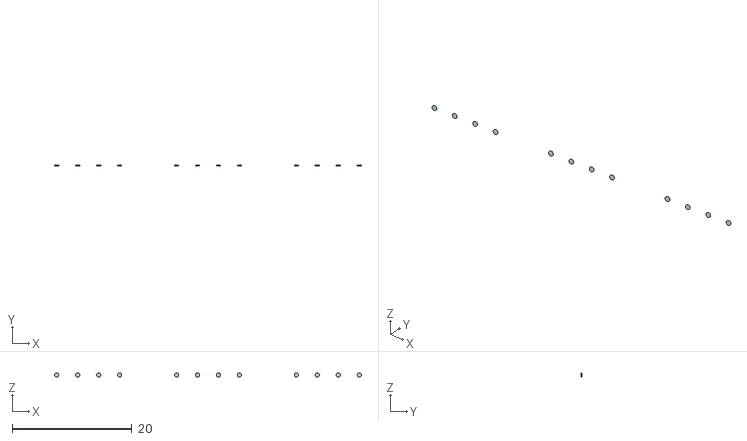
[picture p123: CAD file, 2026-10-23]
case-cad/cad_I9/stl/REF_ferrule_strand_ends_x12.stl
51.2 x 0.14 x 0.72
