PetterGustafsson/power-supply-tester/case-cad/cad_I9/stl/render/REF_PCB_SMD_parts__white.stl

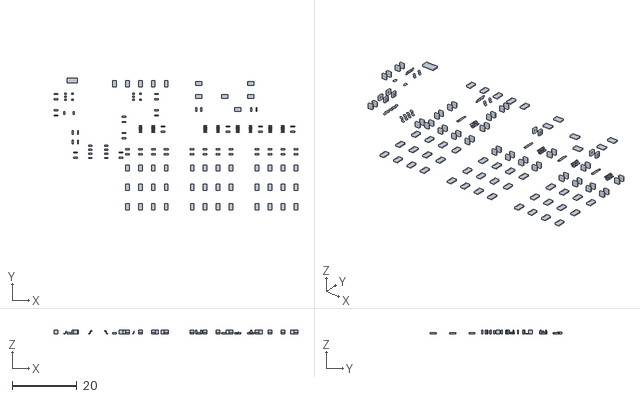
[picture p124: CAD file, 2026-10-23]
case-cad/cad_I9/stl/render/REF_PCB_SMD_parts__white.stl
75.2 x 40.8 x 1.25
