PetterGustafsson/power-supply-tester/case-cad/cad_I9/stl/REF_harness_5_wires_to_J4.stl

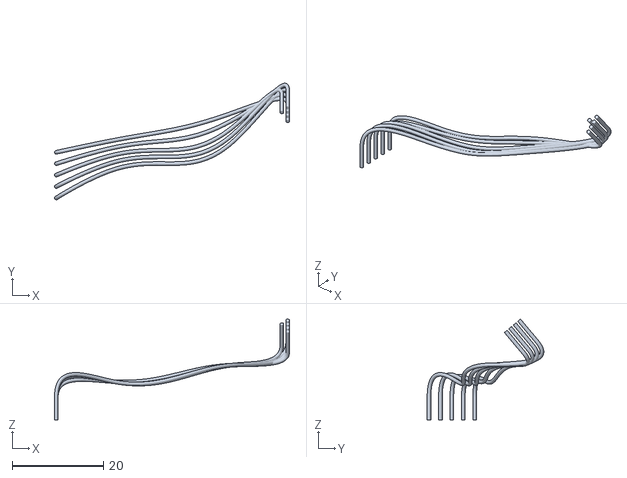
[picture p125: CAD file, 2026-10-23]
case-cad/cad_I9/stl/REF_harness_5_wires_to_J4.stl
51.4 x 25.5 x 22.1
