PetterGustafsson/power-supply-tester/case-cad/cad_I9/stl/render/conductor_01.stl

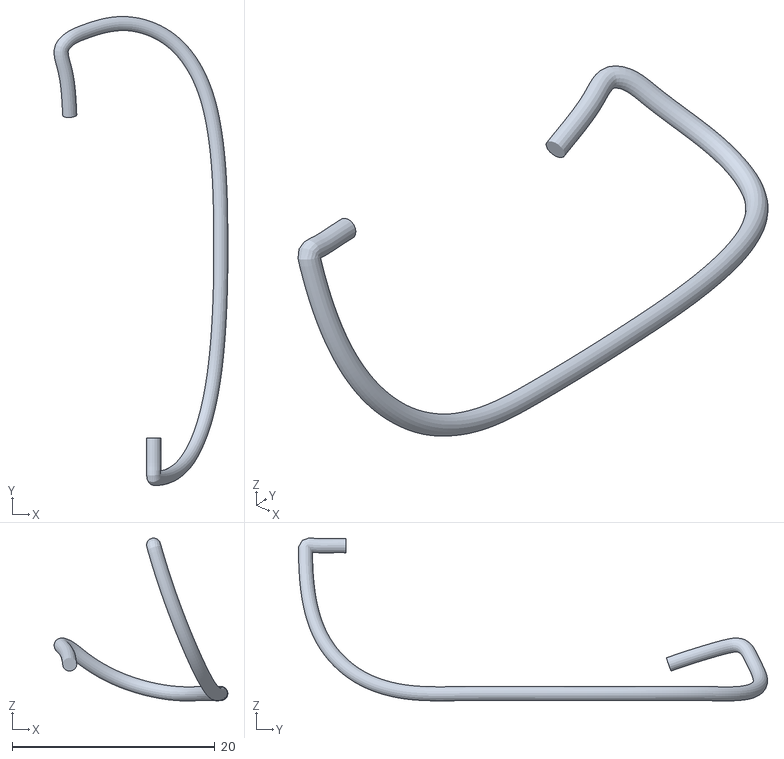
[picture p126: CAD file, 2026-10-23]
case-cad/cad_I9/stl/render/conductor_01.stl
17.1 x 46.2 x 16.1
