PetterGustafsson/power-supply-tester/case-cad/cad_I9/stl/REF_PCB_SMD_parts.stl

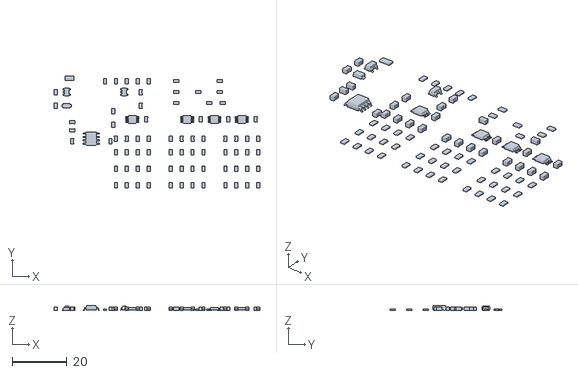
[picture p127: CAD file, 2026-10-23]
case-cad/cad_I9/stl/REF_PCB_SMD_parts.stl
75.2 x 40.8 x 1.75
