PetterGustafsson/power-supply-tester/case-cad/cad_I9/stl/render/cable_cutTY.stl

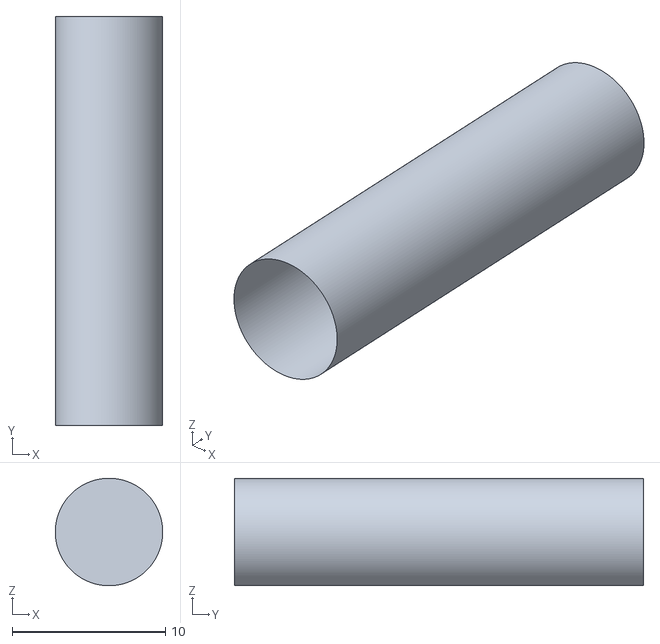
[picture p128: CAD file, 2026-10-23]
case-cad/cad_I9/stl/render/cable_cutTY.stl
7.00 x 26.6 x 7.00
