PetterGustafsson/power-supply-tester/case-cad/cad_I9/stl/render/conductor_02.stl

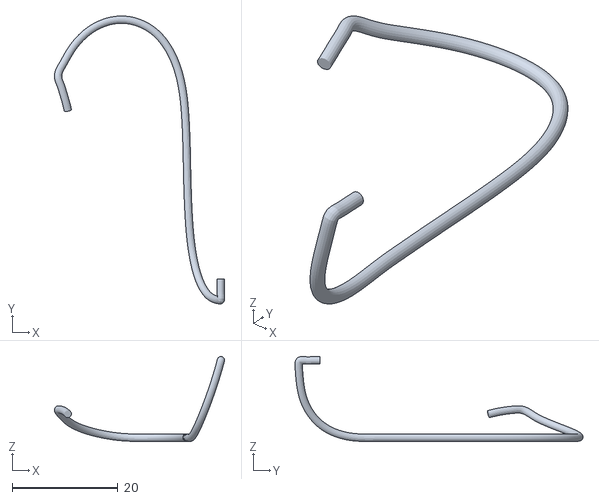
[picture p129: CAD file, 2026-10-23]
case-cad/cad_I9/stl/render/conductor_02.stl
32.1 x 54.3 x 16.0
