PetterGustafsson/power-supply-tester/case-cad/cad_I9/stl/REF_HR10A-10P-12S(73)_female_plug.stl

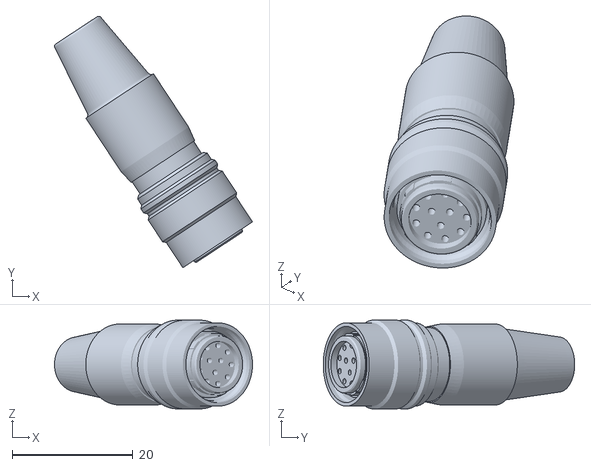
[picture p130: CAD file, 2026-10-23]
case-cad/cad_I9/stl/REF_HR10A-10P-12S(73)_female_plug.stl
32.8 x 41.6 x 14.7
