PetterGustafsson/power-supply-tester/case-cad/cad_I9/stl/render/tie_cutTY_cap.stl

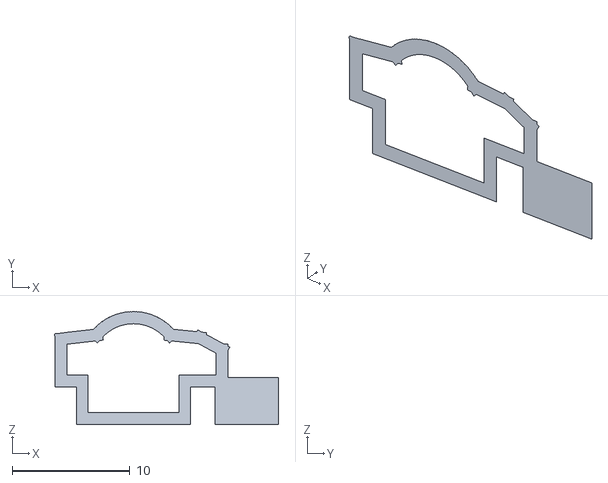
[picture p131: CAD file, 2026-10-23]
case-cad/cad_I9/stl/render/tie_cutTY_cap.stl
19.0 x 0 x 9.59
