PetterGustafsson/power-supply-tester/case-cad/cad_I9/stl/REF_PCB_tall_part.stl

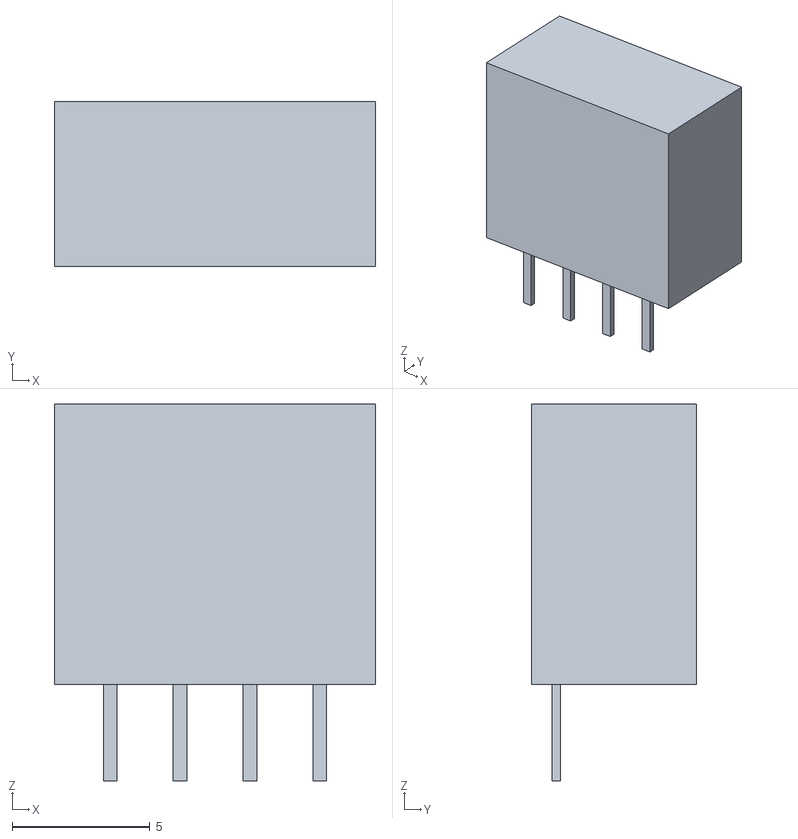
[picture p132: CAD file, 2026-10-23]
case-cad/cad_I9/stl/REF_PCB_tall_part.stl
11.7 x 6.00 x 13.7
