PetterGustafsson/power-supply-tester/case-cad/cad_I9/stl/render/cable_filler.stl

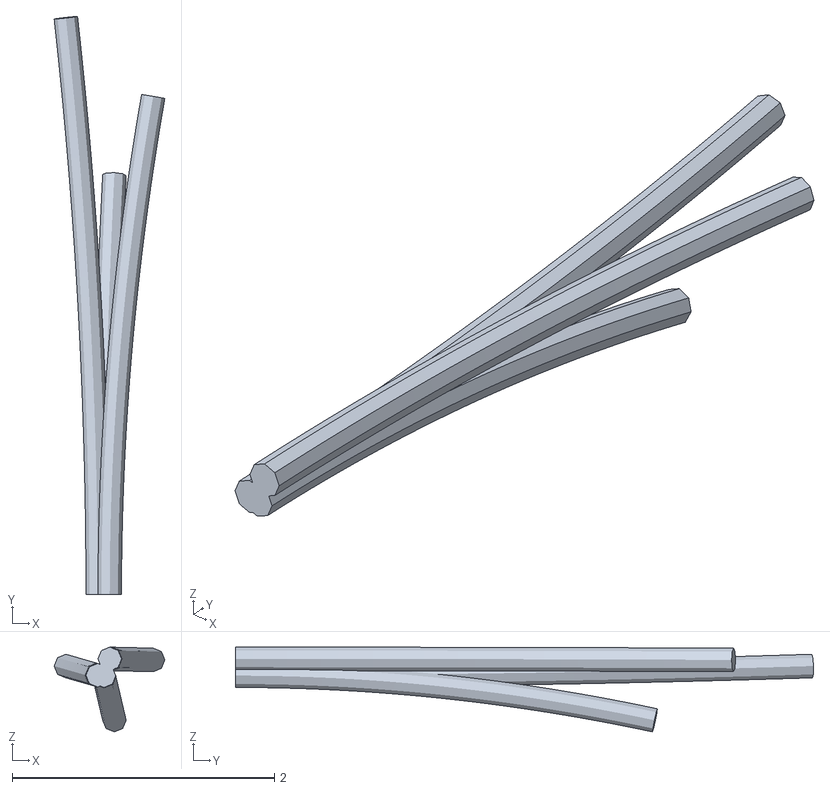
[picture p133: CAD file, 2026-10-23]
case-cad/cad_I9/stl/render/cable_filler.stl
0.845 x 4.41 x 0.647
