PetterGustafsson/power-supply-tester/case-cad/cad_I9/stl/REF_ferrule_pins_0.314in_x12.stl

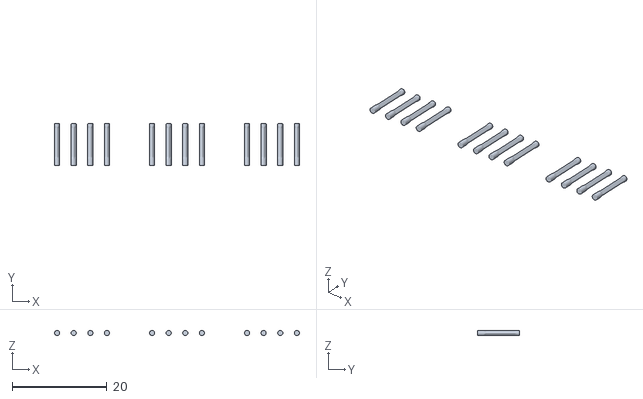
[picture p134: CAD file, 2026-10-23]
case-cad/cad_I9/stl/REF_ferrule_pins_0.314in_x12.stl
51.6 x 8.80 x 1.10
