PetterGustafsson/power-supply-tester/case-cad/cad_I9/stl/render/display_parts.stl

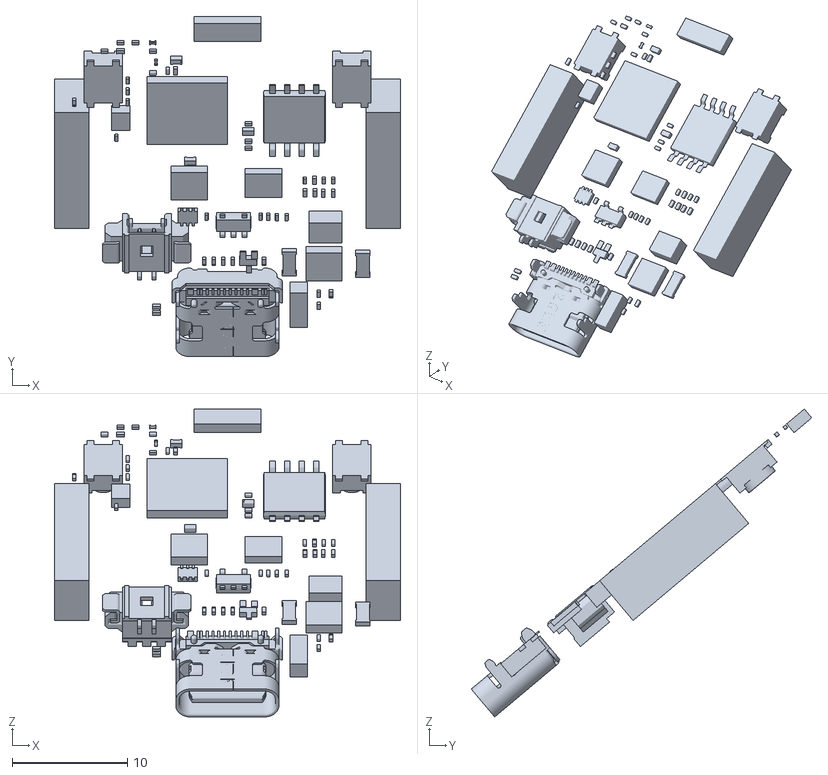
[picture p135: CAD file, 2026-10-23]
case-cad/cad_I9/stl/render/display_parts.stl
30.0 x 29.5 x 26.7
