PetterGustafsson/power-supply-tester/case-cad/cad_I9/stl/REF_cable_12pin_7mm.stl

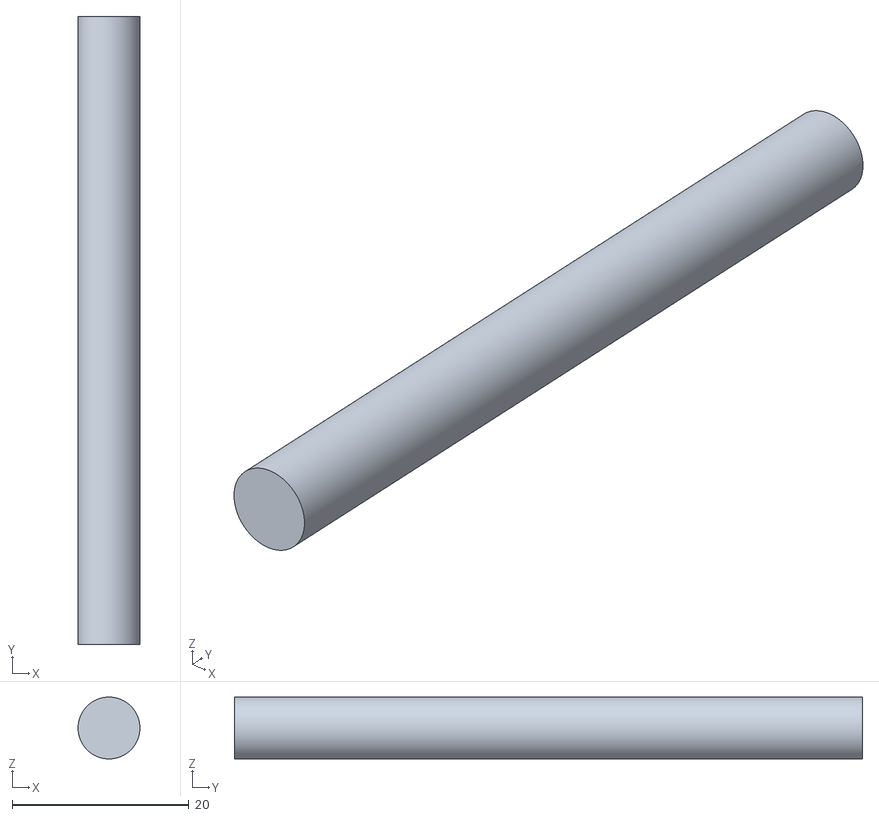
[picture p136: CAD file, 2026-10-23]
case-cad/cad_I9/stl/REF_cable_12pin_7mm.stl
7.00 x 71.0 x 7.00
