PetterGustafsson/power-supply-tester/case-cad/cad_I9/stl/render/usb_female_body.stl

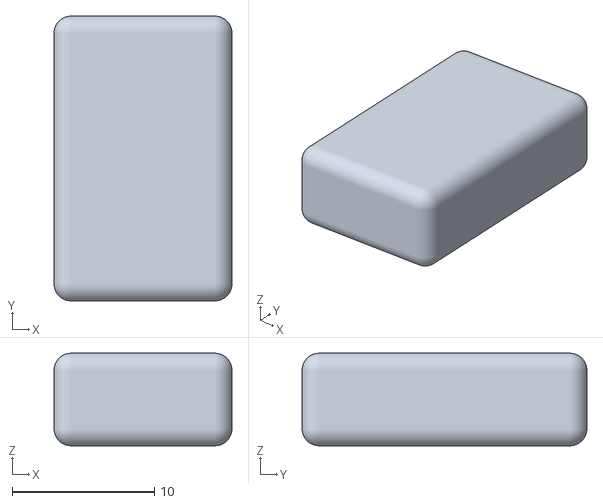
[picture p137: CAD file, 2026-10-23]
case-cad/cad_I9/stl/render/usb_female_body.stl
12.5 x 20.0 x 6.50
