PetterGustafsson/power-supply-tester/case-cad/cad_I9/stl/REF_display_ESP32-S3-LCD-1.28.stl

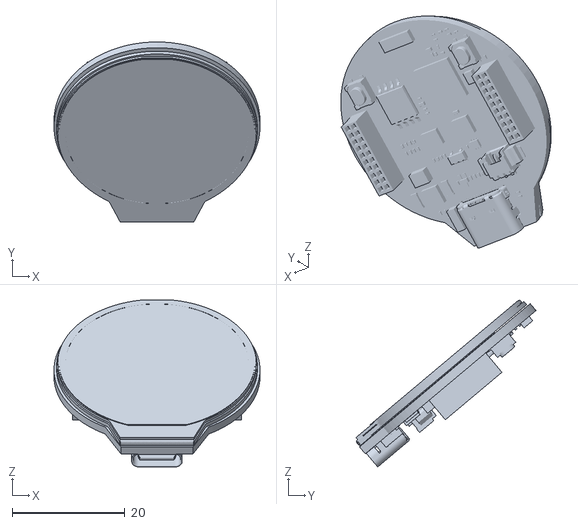
[picture p138: CAD file, 2026-10-23]
case-cad/cad_I9/stl/REF_display_ESP32-S3-LCD-1.28.stl
36.5 x 31.9 x 29.6
