PetterGustafsson/power-supply-tester/case-cad/cad_I9/stl/render/REF_PCB_SMD_parts__metal.stl

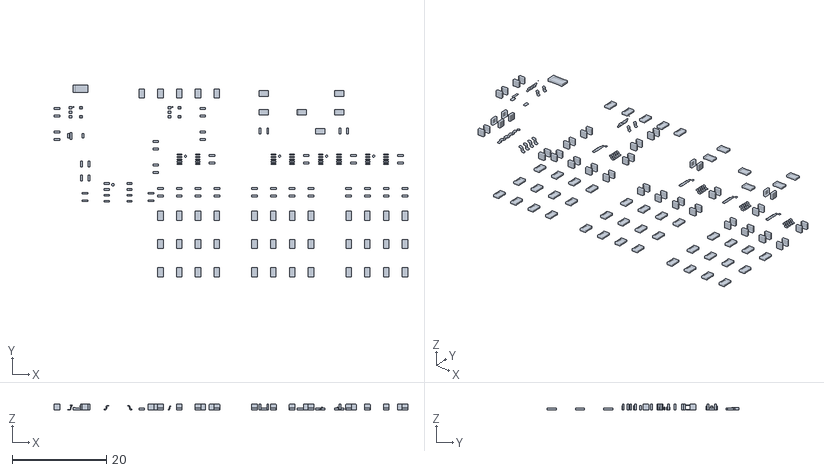
[picture p139: CAD file, 2026-10-23]
case-cad/cad_I9/stl/render/REF_PCB_SMD_parts__metal.stl
75.2 x 40.8 x 1.75
