PetterGustafsson/power-supply-tester/case-cad/cad_I9/stl/render/REF_PCB_J1_XY350V_4p__green.stl

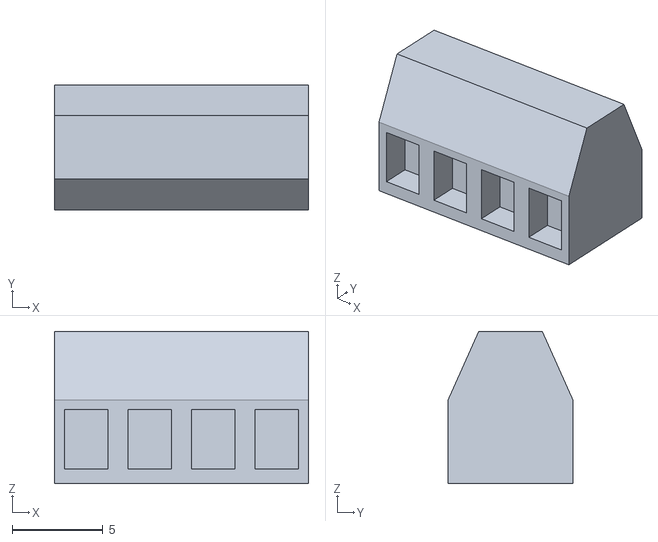
[picture p140: CAD file, 2026-10-23]
case-cad/cad_I9/stl/render/REF_PCB_J1_XY350V_4p__green.stl
14.0 x 6.90 x 8.40
