PetterGustafsson/power-supply-tester/case-cad/cad_I9/stl/REF_ferrule_collars_green_x12.stl

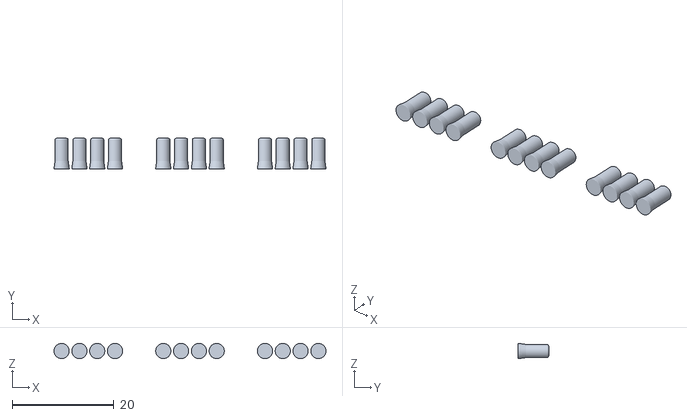
[picture p141: CAD file, 2026-10-23]
case-cad/cad_I9/stl/REF_ferrule_collars_green_x12.stl
53.5 x 6.00 x 3.00
