PetterGustafsson/power-supply-tester/case-cad/cad_I9/stl/render/REF_PCB_J3_XY350V_4p__dark.stl

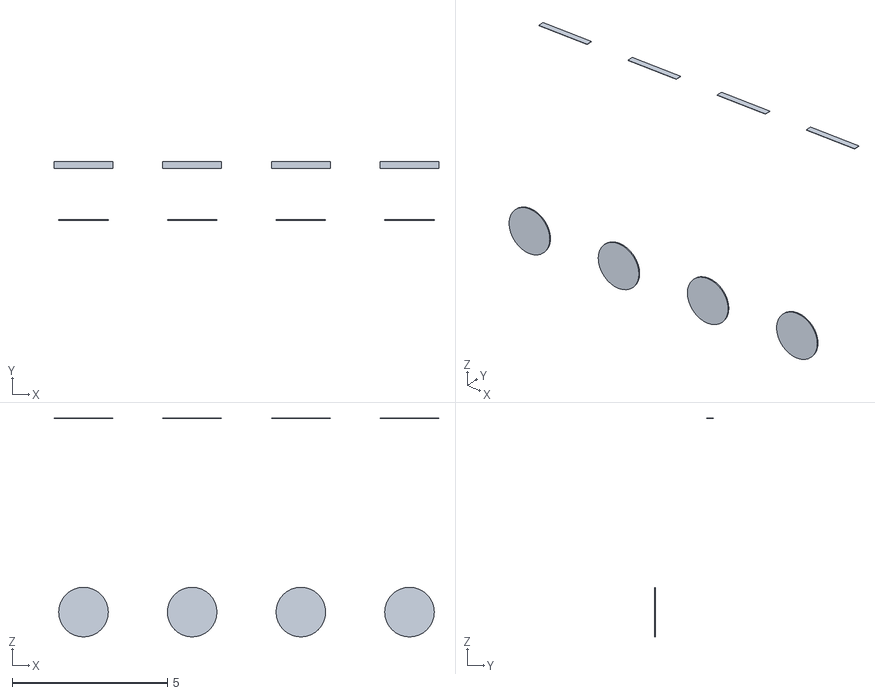
[picture p142: CAD file, 2026-10-23]
case-cad/cad_I9/stl/render/REF_PCB_J3_XY350V_4p__dark.stl
12.4 x 1.91 x 7.05
