PetterGustafsson/power-supply-tester/case-cad/cad_I9/stl/render/conductor_10.stl

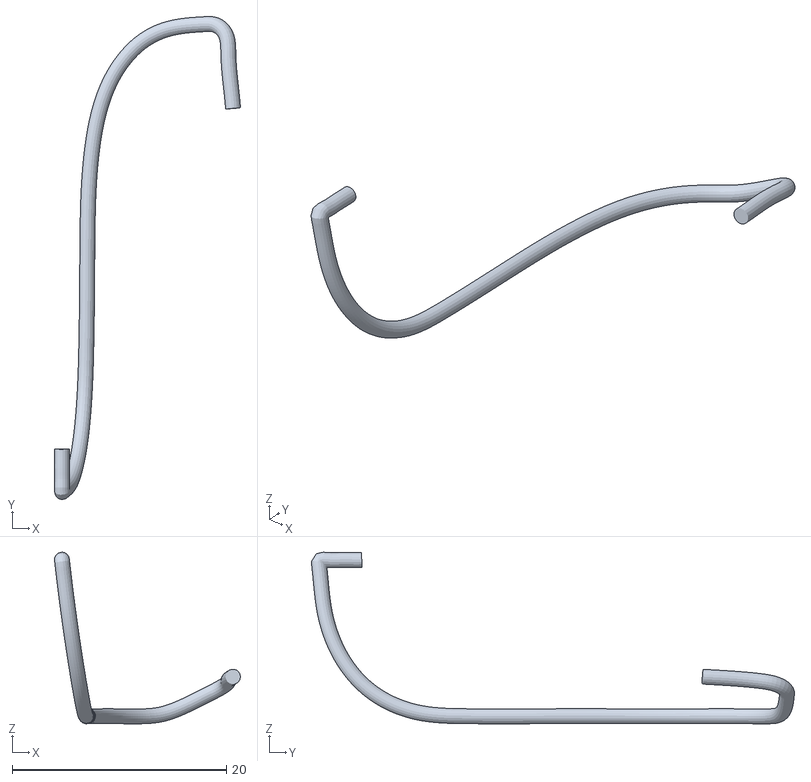
[picture p143: CAD file, 2026-10-23]
case-cad/cad_I9/stl/render/conductor_10.stl
17.4 x 45.1 x 16.0
