PetterGustafsson/power-supply-tester/case-cad/cad_I9/stl/REF_USB_male_90deg_overmold.stl

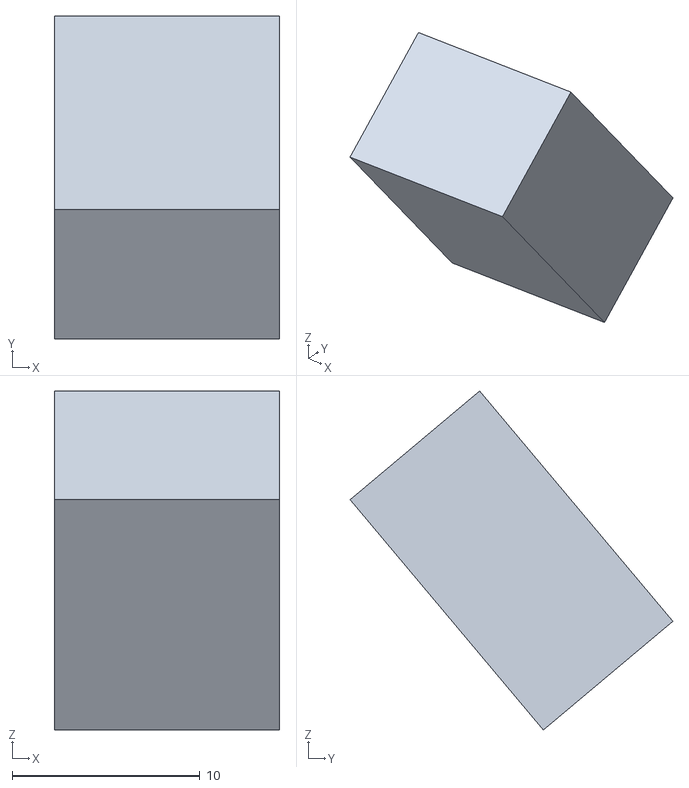
[picture p144: CAD file, 2026-10-23]
case-cad/cad_I9/stl/REF_USB_male_90deg_overmold.stl
12.0 x 17.2 x 18.0
