PetterGustafsson/power-supply-tester/case-cad/cad_I9/stl/render/display_PCB.stl

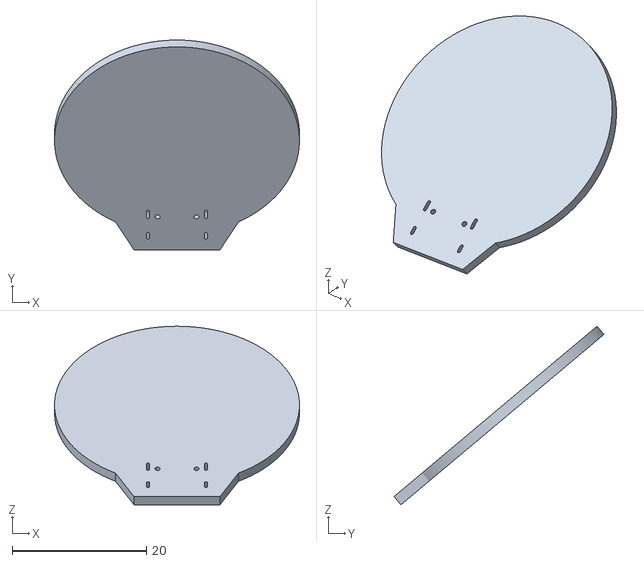
[picture p145: CAD file, 2026-10-23]
case-cad/cad_I9/stl/render/display_PCB.stl
36.5 x 31.3 x 26.6
