PetterGustafsson/power-supply-tester/case-cad/cad_I9/stl/REF_USB_female_overmold.stl

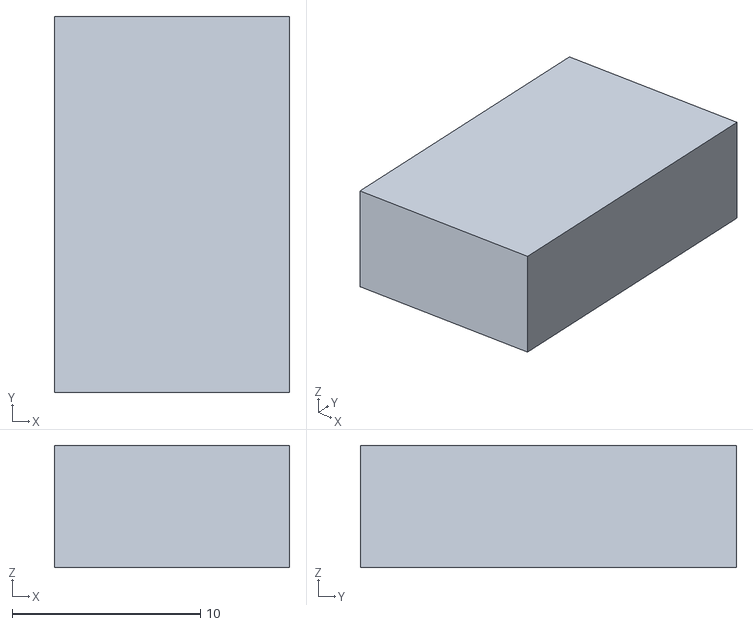
[picture p146: CAD file, 2026-10-23]
case-cad/cad_I9/stl/REF_USB_female_overmold.stl
12.5 x 20.0 x 6.50
