PetterGustafsson/power-supply-tester/case-cad/cad_I9/stl/render/ferrule_strands.stl

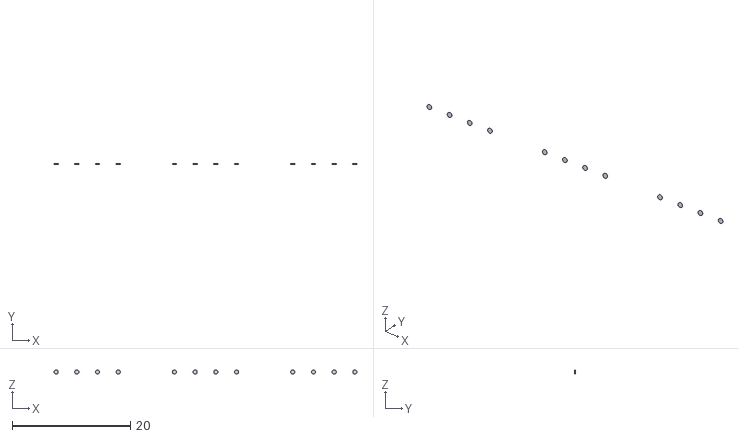
[picture p147: CAD file, 2026-10-23]
case-cad/cad_I9/stl/render/ferrule_strands.stl
51.2 x 0.14 x 0.72
