PetterGustafsson/power-supply-tester/case-cad/cad_I9/stl/REF_cable_12pin_conductors_x12.stl

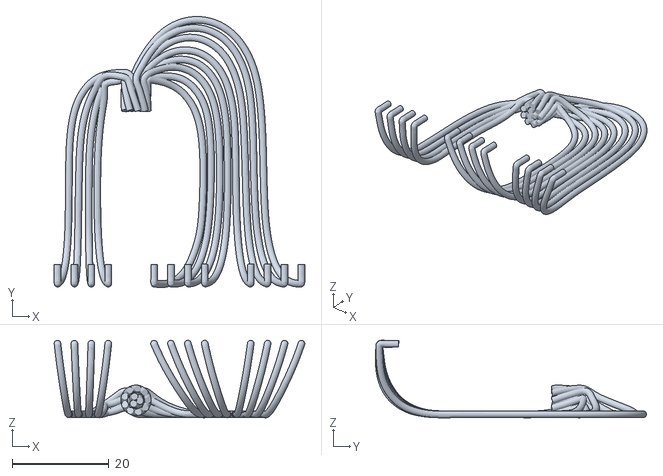
[picture p148: CAD file, 2026-10-23]
case-cad/cad_I9/stl/REF_cable_12pin_conductors_x12.stl
51.9 x 56.1 x 16.1
