PetterGustafsson/power-supply-tester/case-cad/cad_I9/stl/REF_zip_tie_2.5mm_centre.stl

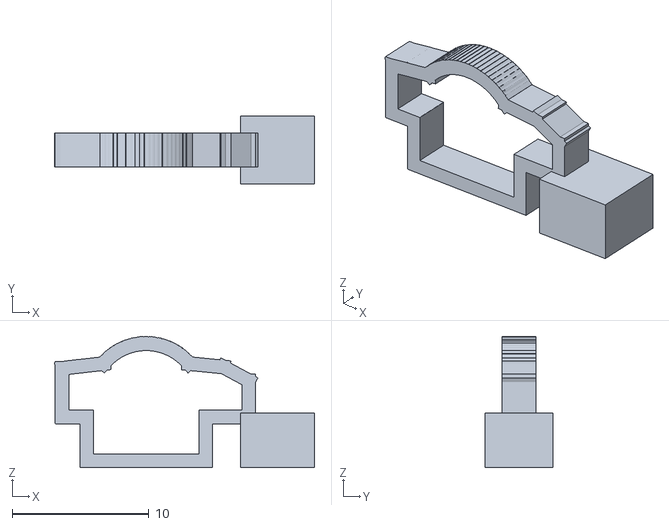
[picture p149: CAD file, 2026-10-23]
case-cad/cad_I9/stl/REF_zip_tie_2.5mm_centre.stl
19.0 x 5.00 x 9.59
