PetterGustafsson/power-supply-tester/case-cad/cad_I9/stl/render/PCB_silk.stl

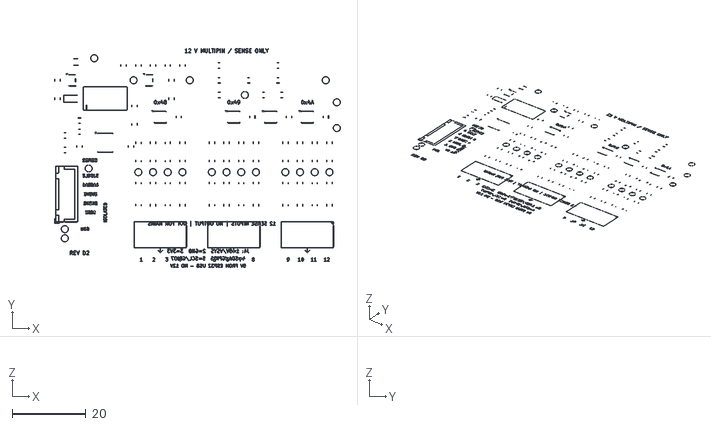
[picture p150: CAD file, 2026-10-23]
case-cad/cad_I9/stl/render/PCB_silk.stl
77.8 x 59.6 x 1.75
