PetterGustafsson/power-supply-tester/case-cad/cad_I9/stl/REF_harness_5x_1pin_housing_d1.2.stl

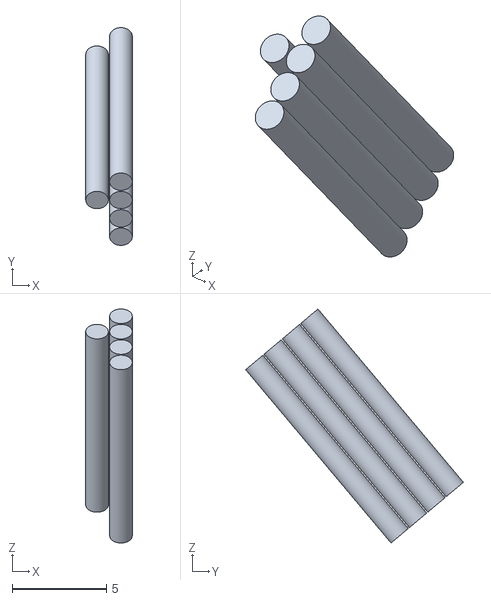
[picture p151: CAD file, 2026-10-23]
case-cad/cad_I9/stl/REF_harness_5x_1pin_housing_d1.2.stl
2.47 x 11.6 x 12.4
