PetterGustafsson/power-supply-tester/case-cad/cad_I9/stl/REF_USB_flat_cable_51mm.stl

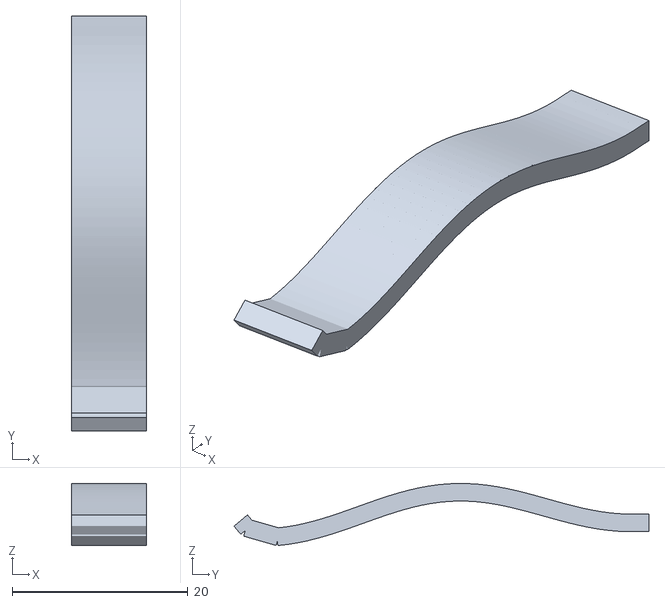
[picture p152: CAD file, 2026-10-23]
case-cad/cad_I9/stl/REF_USB_flat_cable_51mm.stl
8.50 x 47.2 x 7.06
