PetterGustafsson/power-supply-tester/case-cad/cad_I9/stl/render/conductor_00.stl

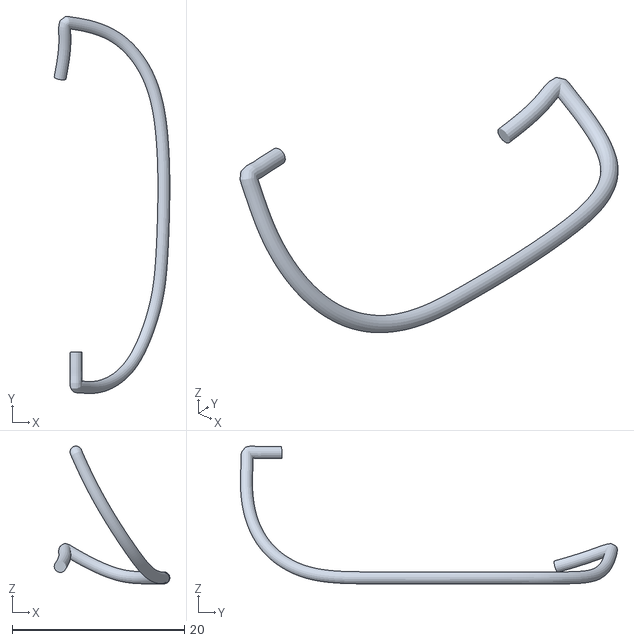
[picture p153: CAD file, 2026-10-23]
case-cad/cad_I9/stl/render/conductor_00.stl
13.4 x 43.8 x 16.0
