PetterGustafsson/power-supply-tester/case-cad/cad_I9/stl/REF_J4_XH5_plug.stl

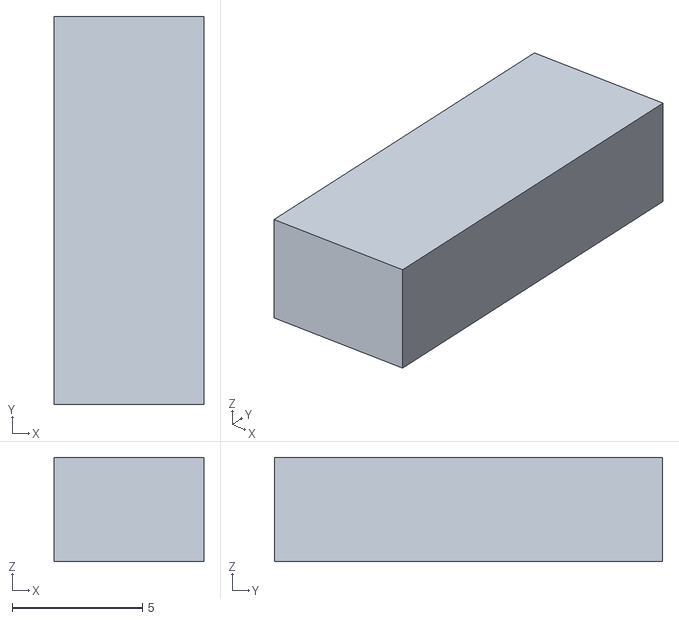
[picture p154: CAD file, 2026-10-23]
case-cad/cad_I9/stl/REF_J4_XH5_plug.stl
5.75 x 14.9 x 4.00
