PetterGustafsson/power-supply-tester/case-cad/cad_I9/stl/render/usb_ribbon.stl

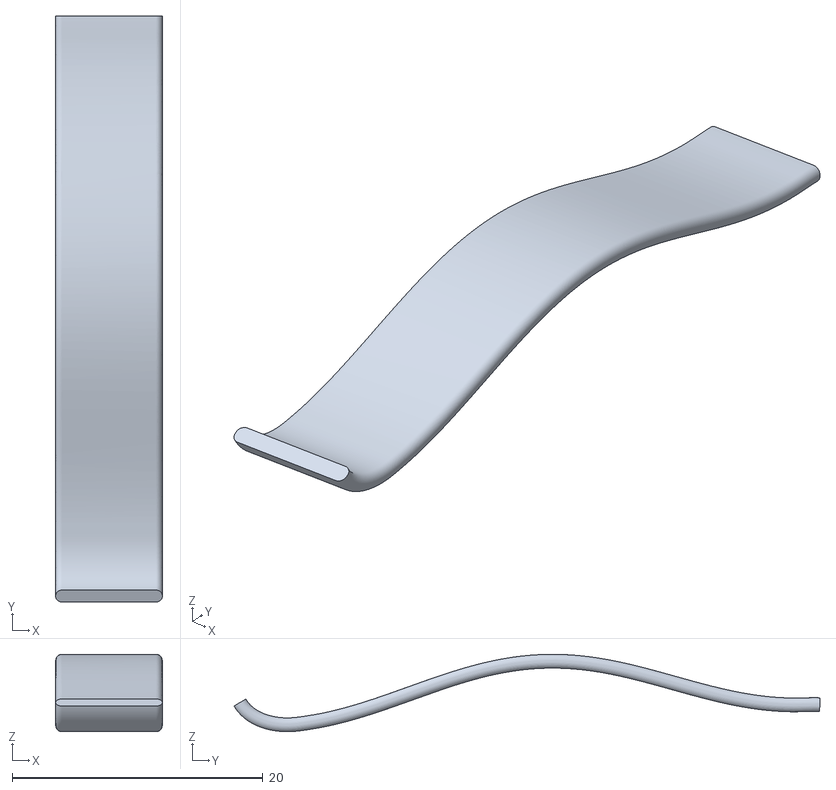
[picture p155: CAD file, 2026-10-23]
case-cad/cad_I9/stl/render/usb_ribbon.stl
8.50 x 46.7 x 6.17
