PetterGustafsson/power-supply-tester/case-cad/cad_I9/stl/REF_harness_5x_breadboard_pins_0.64sq.stl

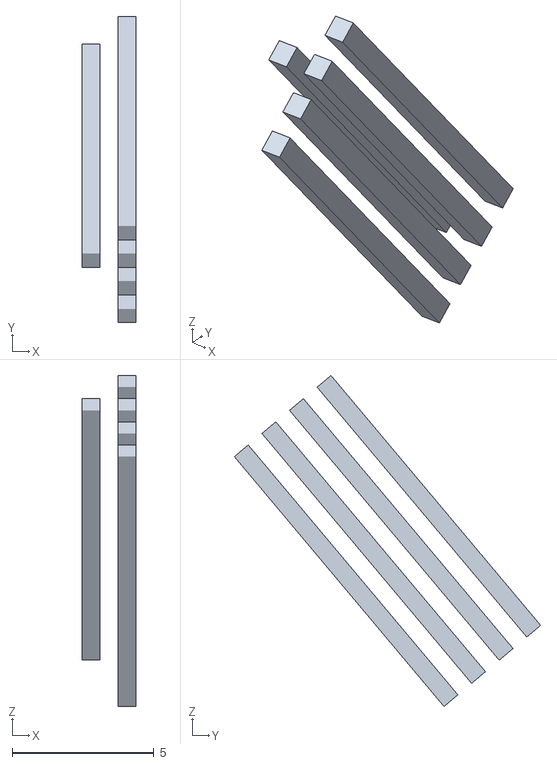
[picture p156: CAD file, 2026-10-23]
case-cad/cad_I9/stl/REF_harness_5x_breadboard_pins_0.64sq.stl
1.91 x 10.8 x 11.7
