PetterGustafsson/power-supply-tester/case-cad/cad_I9/stl/REF_USB_male_plug_tip.stl

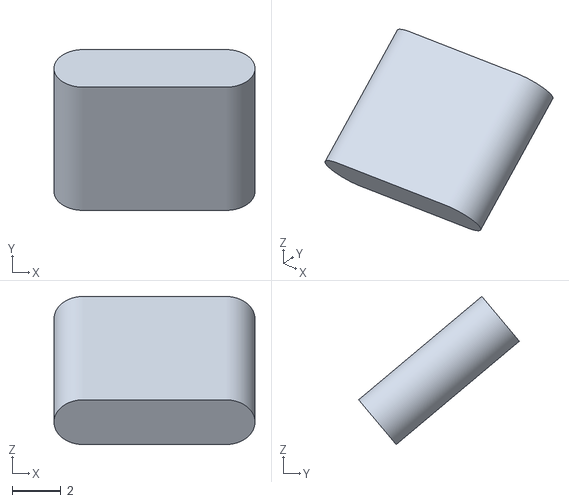
[picture p157: CAD file, 2026-10-23]
case-cad/cad_I9/stl/REF_USB_male_plug_tip.stl
8.25 x 6.60 x 6.08
