PetterGustafsson/power-supply-tester/case-cad/cad_I9/stl/render/PCB_copper.stl

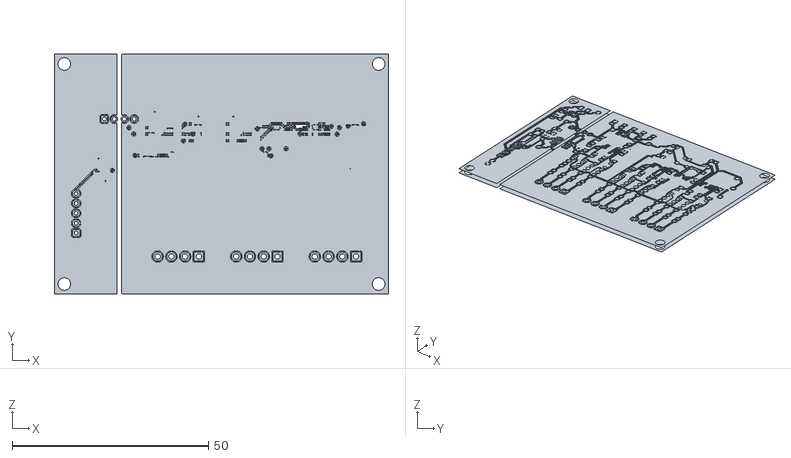
[picture p158: CAD file, 2026-10-23]
case-cad/cad_I9/stl/render/PCB_copper.stl
85.0 x 61.0 x 1.60
