PetterGustafsson/power-supply-tester/case-cad/cad_I9/stl/render/conductor_07.stl

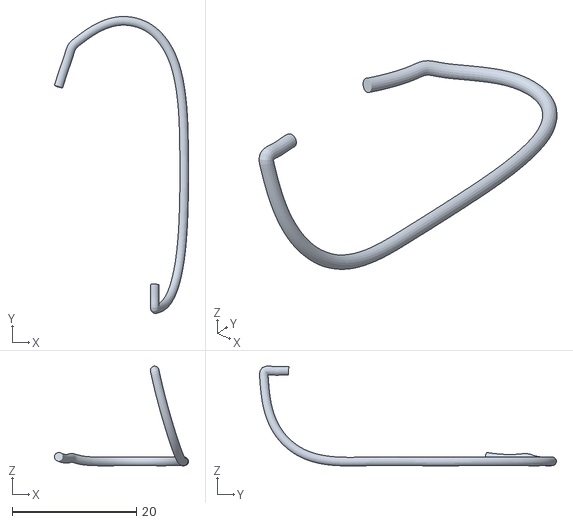
[picture p159: CAD file, 2026-10-23]
case-cad/cad_I9/stl/render/conductor_07.stl
21.6 x 47.8 x 16.1
