PetterGustafsson/power-supply-tester/case-cad/cad_I9/stl/I9_retainer_print.stl

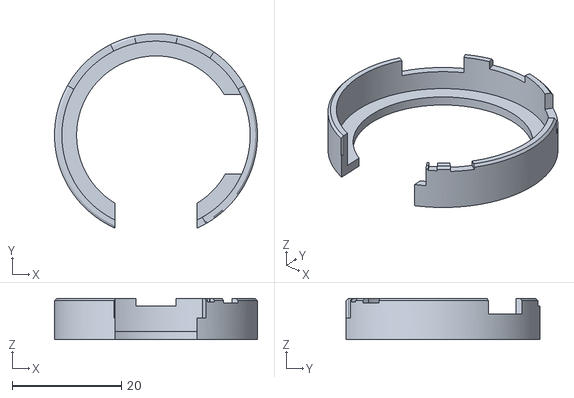
[picture p160: CAD file, 2026-10-23]
case-cad/cad_I9/stl/I9_retainer_print.stl
37.1 x 35.5 x 7.50
