PetterGustafsson/power-supply-tester/case-cad/cad_I9/stl/render/conductor_09.stl

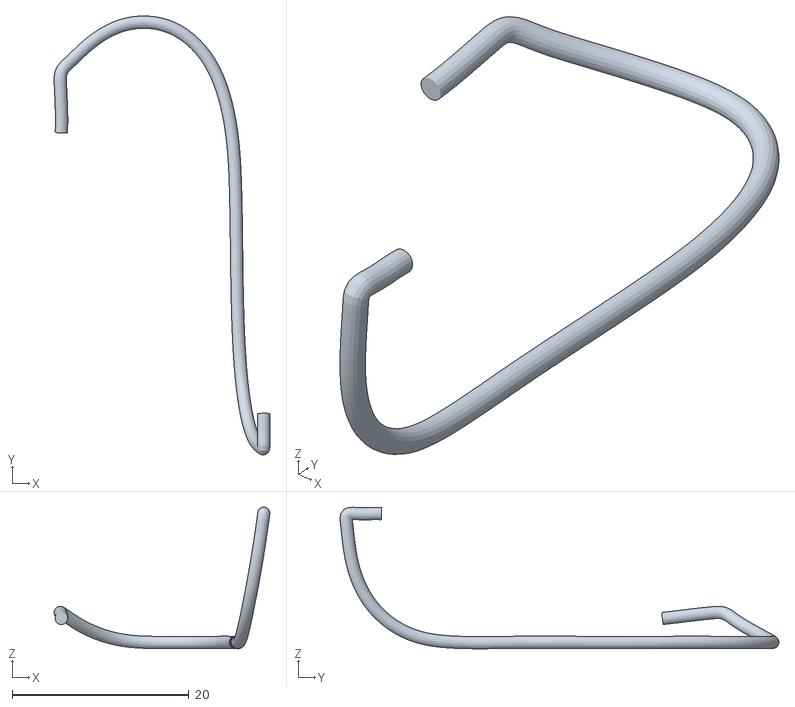
[picture p161: CAD file, 2026-10-23]
case-cad/cad_I9/stl/render/conductor_09.stl
24.5 x 49.7 x 16.0
