PetterGustafsson/power-supply-tester/case-cad/cad_I9/stl/render/conductor_03.stl

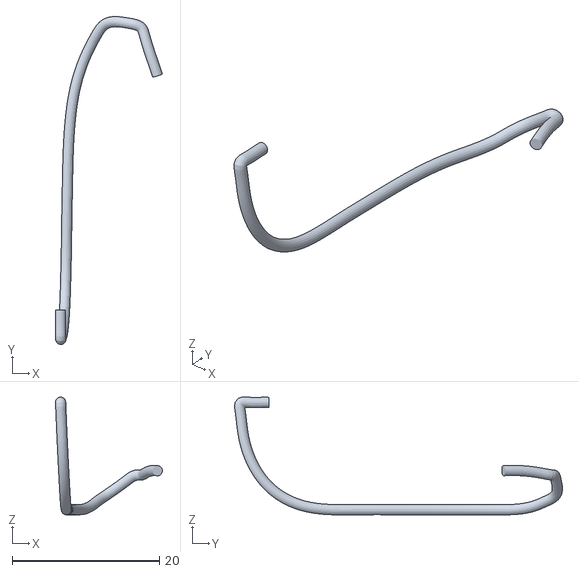
[picture p162: CAD file, 2026-10-23]
case-cad/cad_I9/stl/render/conductor_03.stl
14.5 x 44.6 x 16.0
