PetterGustafsson/power-supply-tester/case-cad/cad_I9/stl/render/usb_female_shell.stl

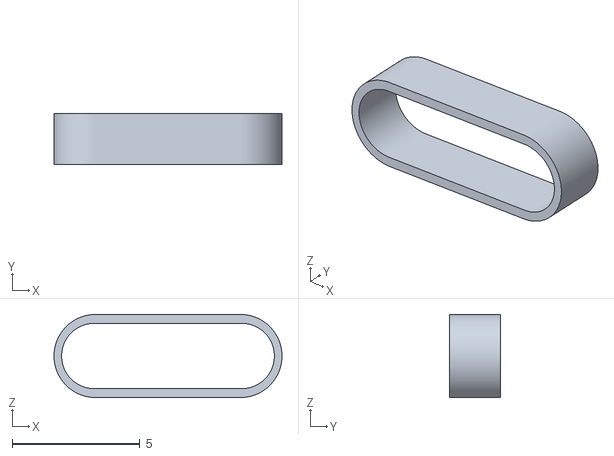
[picture p163: CAD file, 2026-10-23]
case-cad/cad_I9/stl/render/usb_female_shell.stl
8.94 x 2.00 x 3.26
