PetterGustafsson/power-supply-tester/case-cad/cad_I9/stl/render/conductor_04.stl

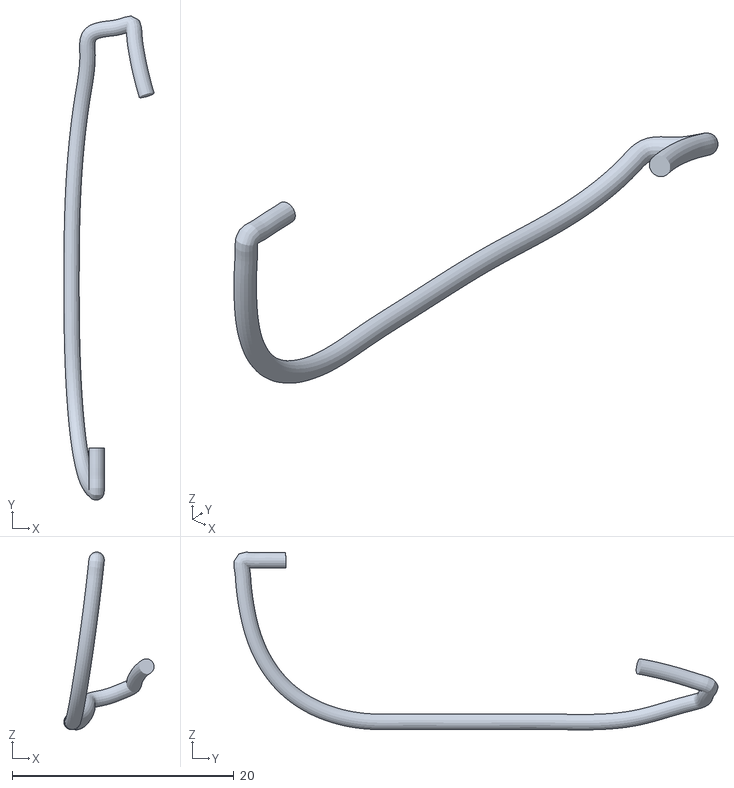
[picture p164: CAD file, 2026-10-23]
case-cad/cad_I9/stl/render/conductor_04.stl
8.15 x 43.7 x 16.0
