PetterGustafsson/power-supply-tester/case-cad/cad_I9/stl/render/conductor_06.stl

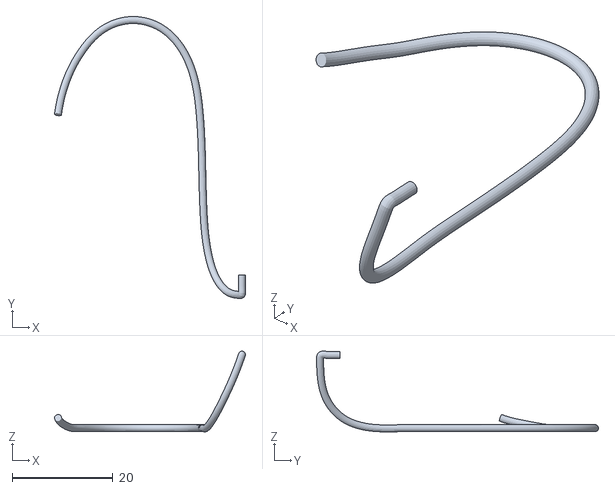
[picture p165: CAD file, 2026-10-23]
case-cad/cad_I9/stl/render/conductor_06.stl
38.0 x 56.0 x 16.1
