PetterGustafsson/power-supply-tester/case-cad/cad_I9/stl/render/cable_foil.stl

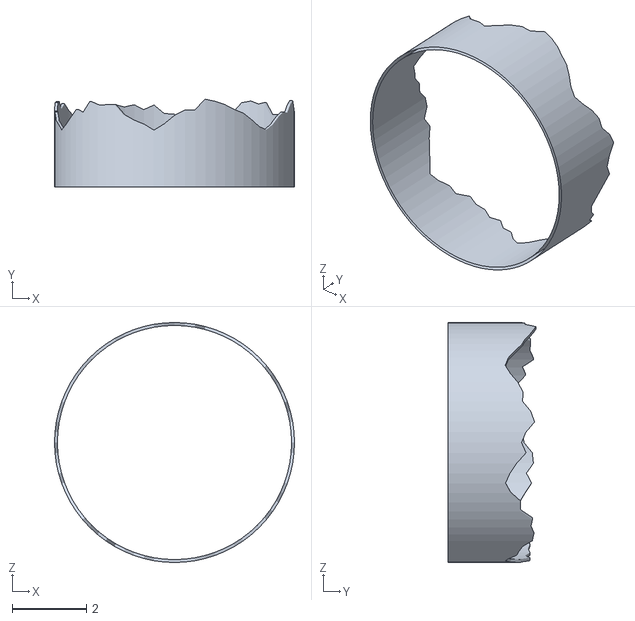
[picture p166: CAD file, 2026-10-23]
case-cad/cad_I9/stl/render/cable_foil.stl
6.48 x 2.36 x 6.48
