PetterGustafsson/power-supply-tester/case-cad/cad_I9/stl/render/conductor_05.stl

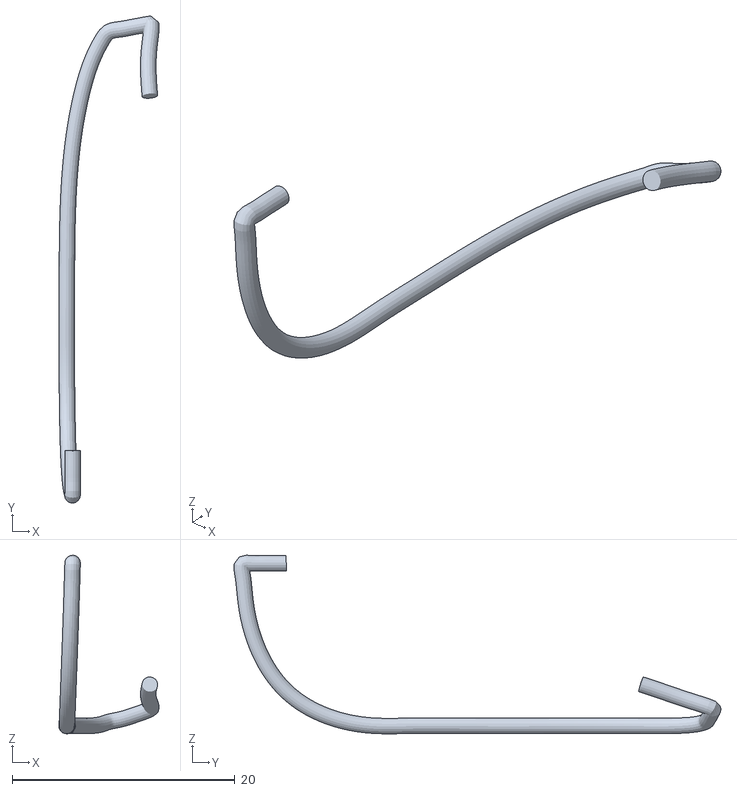
[picture p167: CAD file, 2026-10-23]
case-cad/cad_I9/stl/render/conductor_05.stl
9.00 x 43.7 x 16.0
