PetterGustafsson/power-supply-tester/case-cad/cad_I9/stl/render/conductor_08.stl

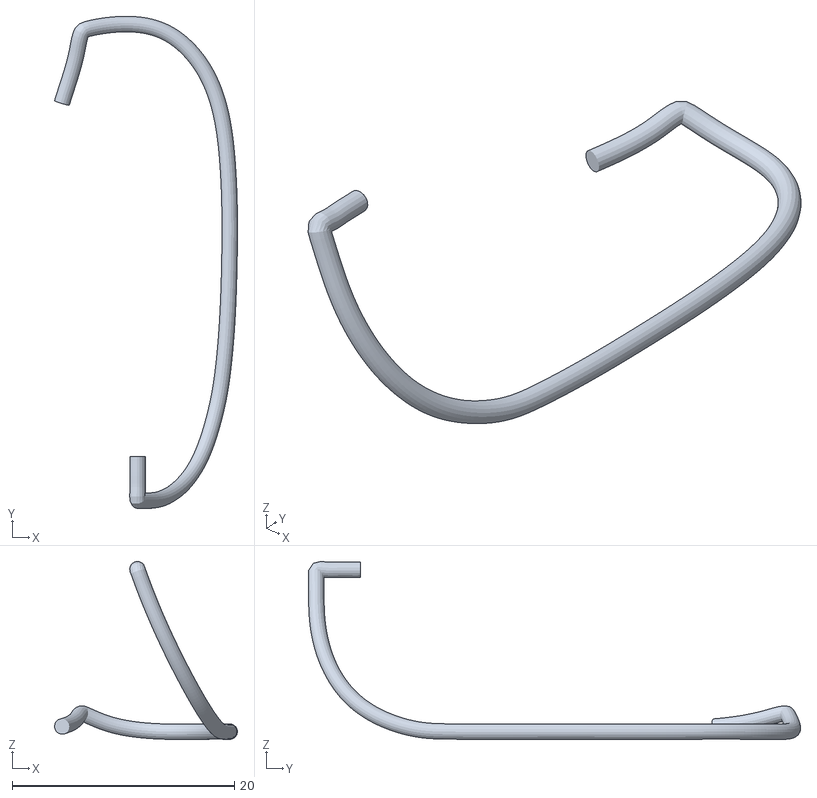
[picture p168: CAD file, 2026-10-23]
case-cad/cad_I9/stl/render/conductor_08.stl
16.5 x 44.4 x 16.0
