PetterGustafsson/power-supply-tester/case-cad/cad_I9/stl/render/REF_PCB_tall_part__metal.stl

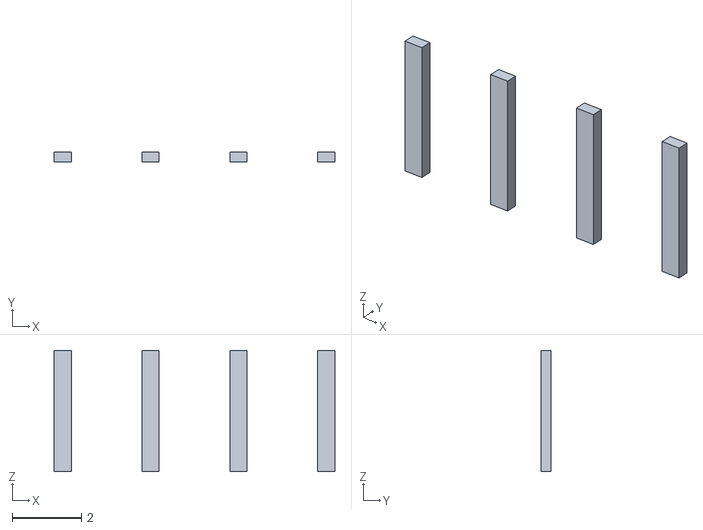
[picture p169: CAD file, 2026-10-23]
case-cad/cad_I9/stl/render/REF_PCB_tall_part__metal.stl
8.12 x 0.3 x 3.50
