PetterGustafsson/power-supply-tester/case-cad/cad_I9/stl/render/tie_cutTY.stl

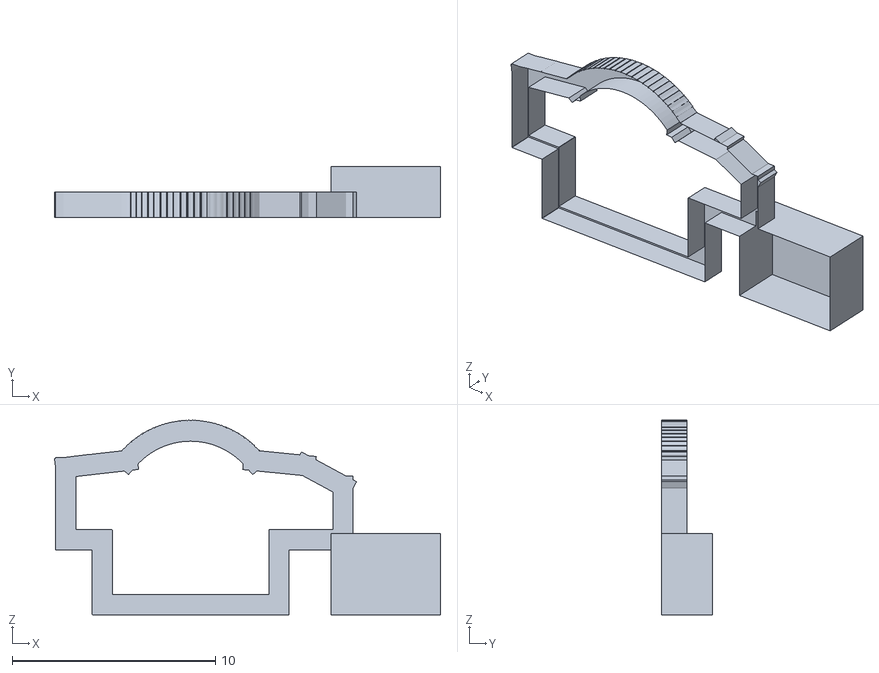
[picture p170: CAD file, 2026-10-23]
case-cad/cad_I9/stl/render/tie_cutTY.stl
19.0 x 2.50 x 9.59
