PetterGustafsson/power-supply-tester/case-cad/cad_I9/stl/render/conductor_11.stl

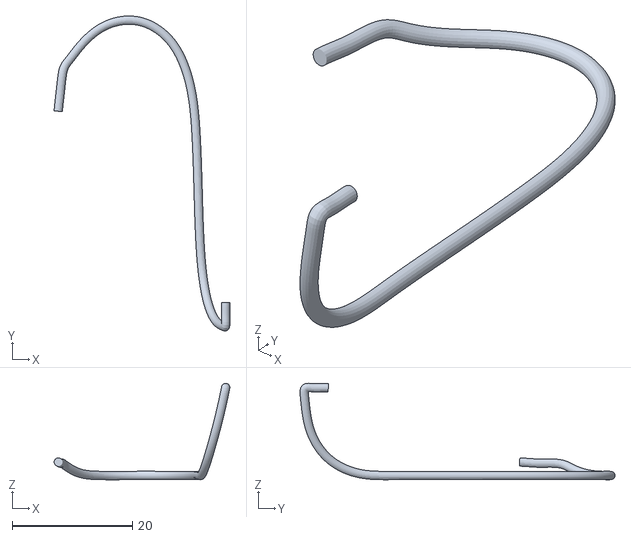
[picture p171: CAD file, 2026-10-23]
case-cad/cad_I9/stl/render/conductor_11.stl
29.2 x 52.3 x 16.0
