PetterGustafsson/power-supply-tester/case-cad/cad_I9/stl/render/usb_male_shell.stl

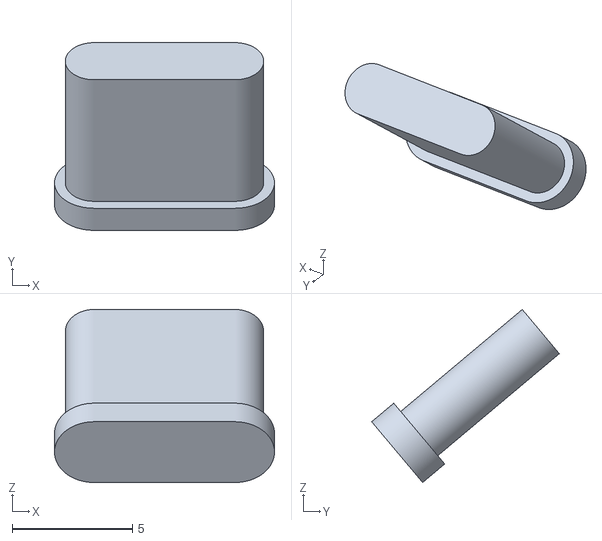
[picture p172: CAD file, 2026-10-23]
case-cad/cad_I9/stl/render/usb_male_shell.stl
9.15 x 7.81 x 7.20
