PetterGustafsson/power-supply-tester/case-cad/cad_I9/stl/render/REF_PCB_J4_JST_XH5__white.stl

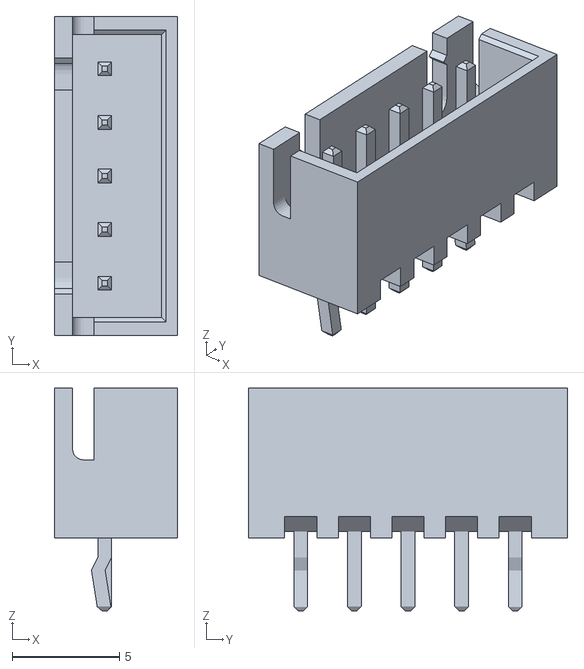
[picture p173: CAD file, 2026-10-23]
case-cad/cad_I9/stl/render/REF_PCB_J4_JST_XH5__white.stl
5.75 x 14.9 x 10.4
