PetterGustafsson/power-supply-tester/case-cad/cad_I9/stl/render/REF_PCB_tall_part__dark.stl

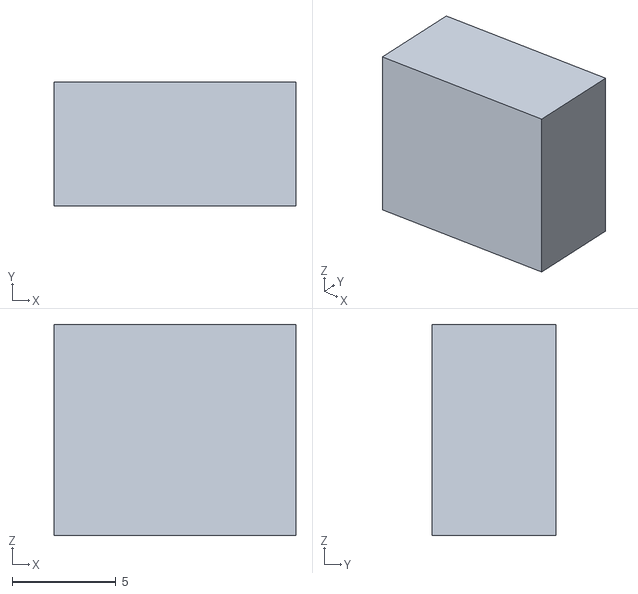
[picture p174: CAD file, 2026-10-23]
case-cad/cad_I9/stl/render/REF_PCB_tall_part__dark.stl
11.7 x 6.00 x 10.2
