PetterGustafsson/power-supply-tester/case-cad/cad_I9/stl/render/PCB_pads.stl

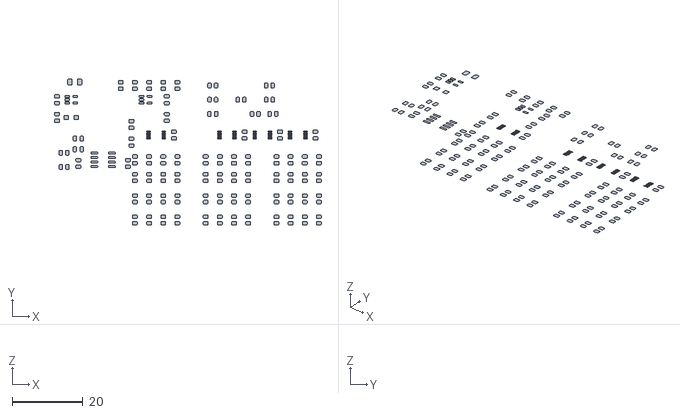
[picture p175: CAD file, 2026-10-23]
case-cad/cad_I9/stl/render/PCB_pads.stl
75.5 x 41.3 x 0
