PetterGustafsson/power-supply-tester/(list of files, cad)

Other CAD files:
case-cad/cad_I14/PSU_case_I14_print.3mf
case-cad/cad_I7/PSU_case_I7_print.3mf
case-cad/cad_I9/PSU_case_I9_print.3mf
case-cad/ref/HR10A-10P-12P.stp
case-cad/current/PSU_case_I15_as_built.3mf
case-cad/cad_I9/stl/I9_top_world.stl
case-cad/current/I15_retainer_print.stl
case-cad/cad_I9/stl/REF_PCB_J3_XY350V_4p.stl
case-cad/cad_I9/stl/I9_base_world.stl
case-cad/cad_I9/stl/I9_top_print.stl
case-cad/cad_I9/stl/I9_retainer_world.stl
case-cad/cad_I9/stl/REF_PCB_J2_XY350V_4p.stl
case-cad/cad_I9/stl/render/REF_PCB_J2_XY350V_4p__green.stl
case-cad/cad_I9/stl/render/REF_PCB_J3_XY350V_4p__green.stl
case-cad/cad_I9/stl/render/REF_PCB_J1_XY350V_4p__dark.stl
case-cad/cad_I9/stl/render/REF_PCB_J3_XY350V_4p__metal.stl
case-cad/cad_I9/stl/render/REF_PCB_J1_XY350V_4p__metal.stl
case-cad/cad_I9/stl/I9_crown_world.stl
case-cad/cad_I9/stl/render/REF_PCB_J2_XY350V_4p__dark.stl
case-cad/cad_I9/stl/REF_screw_M2.5x12_PCB_x4.stl
case-cad/cad_I9/stl/REF_screw_M2.5x12_shell_x4.stl
hardware/rev-a/previews/tester12v.step
hardware/rev-b/previews/tester12v.step
output/agnd-pogo-jig-d2/D2_AGND_jig.FCStd
output/agnd-pogo-jig-d2/D2_AGND_jig_preview.blend
output/enclosure-d2/board-and-display-usb-rear-connector-ui.blend
output/enclosure-d2/board-and-display-usb-rear.blend
output/enclosure-d2/board-and-display.blend
output/enclosure-d2/lid-mounted-layout-usb-rear-connector-ui.blend
output/enclosure-d2/lid-mounted-layout-usb-rear.blend
output/enclosure-d2/lid-mounted-layout.blend
output/enclosure-d2/sources/imported.blend
output/final-layout-poster/final-layout.blend
output/product-render/product-hero.blend
