PetterGustafsson/power-supply-tester/hardware/tester12v-REV-B-ADG-PREORDER 2/ORDER-INSTRUCTIONS.txt

12 V TESTER REV B - ADG4612 PREORDER MANUFACTURING PACKAGE
Prepared 2026-09-30. Target assembly quantity: 2 boards.

EXTRACT THE OUTER PACKAGE FIRST. Upload these three files separately to JLC:
1. tester12v-REV-B-ADG-PREORDER-Gerbers.zip - PCB fabrication upload.
2. tester12v-REV-B-ADG-PREORDER-BOM.csv - assembly BOM upload.
3. tester12v-REV-B-ADG-PREORDER-CPL.csv - assembly placement upload.
The outer ZIP contains documentation as well and is not the Gerber upload.
Use all three from this folder. Replace all three files in any existing draft.
Do not combine these with the older generic Downloads/PCB-Gerbers.zip files.

CHEAPER SWITCH PROCUREMENT
U4/U5/U6 select ADG4612BRUZ / C657391, three per PCB, six fitted for two boards.
This is the same ADG4612 in the same TSSOP-16 package as the stocked
ADG4612BRUZ-REEL7 / C207399; only shipment packaging and purchasing code differ.
No circuit, footprint, routing, placement or firmware change was made.
The schematic reference and original native purchasing fields may retain the
reel suffix. The single BOM in this package defines the requested procurement.

JLC lookup on 2026-09-30: C657391 stock 0, preorder minimum 4,
estimated USD 2.7916 each and estimated 9-day procurement lead time.
These are estimates, not a confirmed offer or total delivery time.
Preorder/confirm C657391 and allocate it to assembly before releasing the order.
Six is the fitted quantity only: buy the quantity JLC requires including attrition.
No components have been reserved or purchased. Do not accept an automatic
switch substitution; the selected ADG4612 power-off protection is required.
Source: https://jlcpcb.com/partdetail/AnalogDevices-ADG4612BRUZ/C657391

At the observed prices, six switches total USD 16.7496 versus USD 40.4700
for C207399. Estimated saving: USD 23.7204 for two boards before attrition.
Nominal total fitted parts: USD 52.0368 for two boards using the earlier
Rev B prices for all other items. This is not a final assembly quote.
PCB, setup, stencil, placement, feeder charges, through-hole work, attrition,
possible LGA X-ray, shipping, tax, display/controller and harness are additional.
The switch remains Extended. BOM: 9 Basic, 1 Promotional Extended, 14 Extended
types at the last lookup; JLC categories, other stock and prices can change.

PCB AND ASSEMBLY
90 x 80 mm, 2 layers, FR-4, 1.6 mm thickness, 1 oz copper, ENIG,
green solder mask, white silkscreen. Four 2.7 mm nonplated mounting holes.
Request bare-board electrical testing and manufacturer DFM review.
Top assembly: 114 fitted parts = 110 SMD + four through-hole connectors.
Set assembled quantity to 2. Include through-hole assembly for J1/J2/J3/J4.
Display/controller Waveshare ESP32-S3-LCD-1.28 and harness are separate.
The PCB senses 12 V inputs; J4 powers its electronics from the separate
5 V/3.3 V controller domain. Do not feed 12 V into J4.

PART AND PLACEMENT REVIEW
U7 MUST be fitted: MIE1W0505BGLVH-3R-Z / C22419841, LGA-12 4x5mm.
It is included in both BOM and CPL. X=16.0000, Y=-11.0000, Top, rotation 90.
Its physical pin 1 is X=13.9125, Y=-12.6375 mm; confirm against JLC's preview.
U8: ISO1640BDR / C5122339, eight-pin version.
D1-D12: BZT52C12 / C19077410, SOD-123, cathode pin 1.
C1-C12/C28: 470pF / C1743. C21/C24: 22uF / C45783.
R43/R44 are the only DNP BOM components and are absent from BOM, CPL and paste.
CPL units are mm; X right, Y up. Negative Y is intentional. Do not mirror.
J1-J4 coordinates are body centres. All coordinates share the Gerber origin.
Check all polarized parts and connectors against reference/assembly.pdf.
JLC library rotations, part matching, LGA lands/paste and DFM remain to be
confirmed in the actual order. A missing 3D body alone does not prove omission.

PACKAGE CHECKS AND HARDWARE STATUS
Package checks confirm the only BOM differences affect U4/U5/U6 purchasing
code, packaging suffix and comment. All 114 BOM references have CPL entries.
All seven Gerber layers and two drill files match released Rev B byte-for-byte.
The CPL and reference drawings are also byte-identical to released Rev B.
Only the fabrication ZIP's text instructions changed to match this sourcing.
The board SHA256 matches the existing clean ERC/DRC and 352-pad net audit.
Prior Rev B computer checks passed 1,188 DC cases, 64 resistor corners,
20,000 sensitivity trials, 12 behavioral transients and firmware host tests.
Those electronics tests were not rerun for this packaging-only substitution.
No assembled board has been tested. First-article supply, noise, sequencing,
calibration and all 132 ordered pin-pair tests remain before larger production.

CONTENTS
The three named uploads above, this instruction file and SHA256SUMS.txt.
reference/: assembly and schematic PDFs, front paste layer, package checks,
and the prior Rev B board audit, ERC and DRC reports.
The SHA256 file covers every other file in this folder.
Editable design, firmware and bench procedure remain in the original
tester12v-rev-b-complete.zip. This preorder BOM supersedes its stocked-switch
BOM for this order; retain the Rev B circuit and firmware.
