PetterGustafsson/power-supply-tester/hardware/tester12v-rev-d2-engineering-package/hardware/rev-d/previews/pcb-bottom-wiring.png

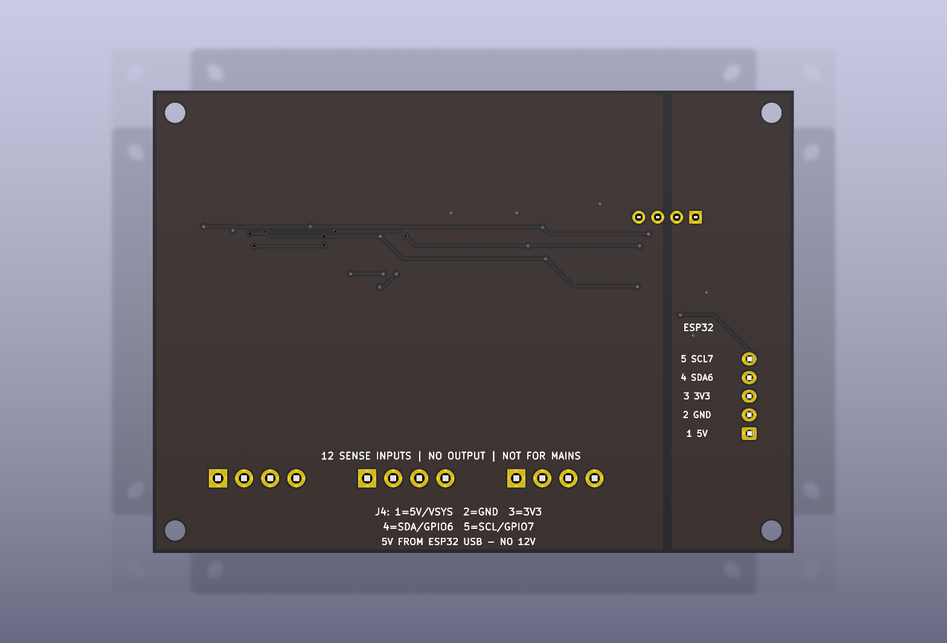
hardware/tester12v-rev-d2-engineering-package/hardware/rev-d/previews/pcb-bottom-wiring.png
