PetterGustafsson/power-supply-tester/output/agnd-pogo-jig-d2/assembly-preview.png

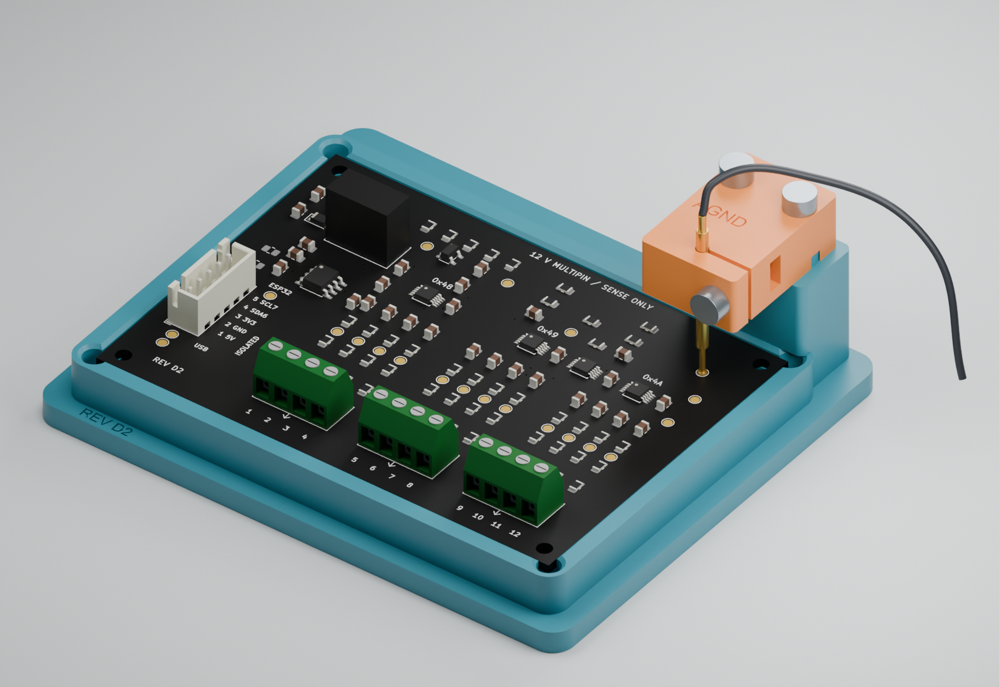
output/agnd-pogo-jig-d2/assembly-preview.png
