PetterGustafsson/power-supply-tester/output/pdf/power-supply-tester-final-layout.pdf

# POWER SUPPLY TESTER

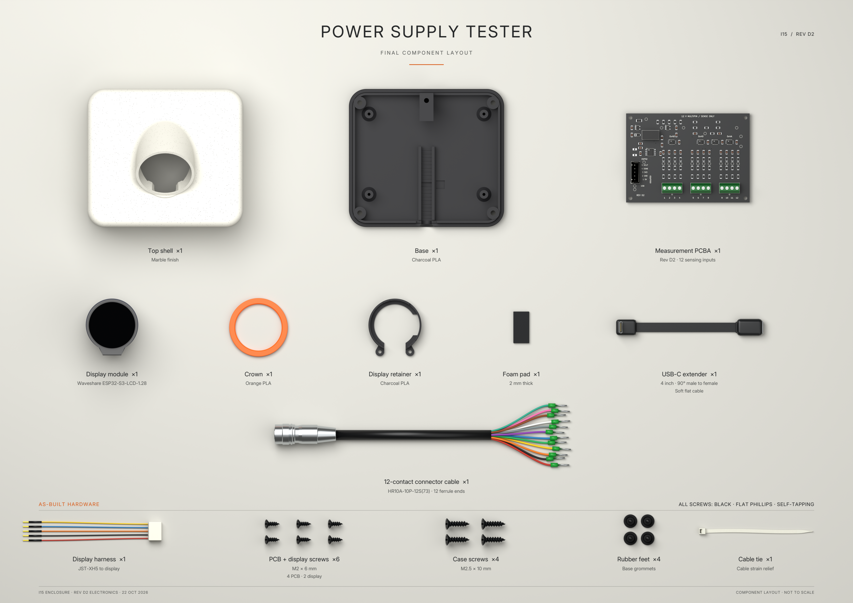
[picture p178: page 1]

FINAL COMPONENT LAYOUT

I15 / REV D2

## Top shell ×1

Marble finish

## Base ×1

Charcoal PLA

## Measurement PCBA ×1

Rev D2 · 12 sensing inputs

## Display module ×1

Waveshare ESP32-S3-LCD-1.28

## Crown ×1

Orange PLA

## Display retainer ×1

Charcoal PLA

## Foam pad ×1

2 mm thick

## USB-C extender ×1

4 inch · 90° male to female Soft flat cable

## 12-contact connector cable ×1

HR10A-10P-12S(73) · 12 ferrule ends

AS-BUILT HARDWARE | ALL SCREWS: BLACK · FLAT PHILLIPS · SELF-TAPPING

## Display harness ×1

JST-XH5 to display

## PCB + display screws ×6

M2 × 6 mm
4 PCB · 2 display

## Case screws ×4

M2.5 × 10 mm

## Rubber feet ×4

Base grommets

## Cable tie ×1

Cable strain relief

I15 ENCLOSURE · REV D2 ELECTRONICS · 22 OCT 2026 | COMPONENT LAYOUT · NOT TO SCALE
