PetterGustafsson/power-supply-tester/hardware/tester12v-rev-d-engineering-package/hardware/rev-d/validation/startup-shutdown.csv

time_s | A3V3 | VBIAS | A1 | A12 | AREF
0.000000000000000000e+00 | 0.000000000000000000e+00 | -5.652182579999999606e-19 | 2.152566540000000125e-02 | -2.152566540000000125e-02 | -5.652182579999999606e-19
3.190629189999999792e-06 | 1.148626510000000031e-02 | 6.725879470000000002e-04 | 2.168944570000000058e-02 | -2.136188509999999846e-02 | 1.637803019999999933e-04
8.190629190000000201e-06 | 2.948626509999999895e-02 | 2.260579799999999813e-03 | 2.260033870000000000e-02 | -2.045099209999999904e-02 | 1.074673329999999930e-03
1.319062919999999959e-05 | 4.748626510000000106e-02 | 4.281200330000000179e-03 | 2.412442420000000115e-02 | -1.892690660000000136e-02 | 2.598758799999999897e-03
1.819062920000000084e-05 | 6.548626509999999623e-02 | 6.619079259999999763e-03 | 2.609818040000000047e-02 | -1.695315039999999857e-02 | 4.572515020000000006e-03
2.319062920000000041e-05 | 8.348626509999999834e-02 | 9.189612430000000665e-03 | 2.840169240000000109e-02 | -1.464963830000000009e-02 | 6.876027070000000421e-03
2.819062919999999997e-05 | 1.014862650000000061e-01 | 1.193075730000000070e-02 | 3.094702339999999899e-02 | -1.210430740000000005e-02 | 9.421358070000000057e-03
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
