PetterGustafsson/power-supply-tester/output/calibration-2026-10-18/partition-table.csv

# ESP-IDF Partition Table
# Name | Type | SubType | Offset | Size | Flags
nvs | data | nvs | 0x9000 | 20K
otadata | data | ota | 0xe000 | 8K
app0 | app | ota_0 | 0x10000 | 3M
app1 | app | ota_1 | 0x310000 | 3M
ffat | data | fat | 0x610000 | 10112K
coredump | data | coredump | 0xff0000 | 64K
