PetterGustafsson/power-supply-tester/hardware/rev-a/validation/bench-pairs.csv

Positive_terminal | Negative_terminal | Nominal_V | DMM_V | Displayed_positive | Displayed_negative | Displayed_V | Error_V | Pass | Notes
1 | 2 | 12
1 | 3 | 12
1 | 4 | 12
1 | 5 | 12
1 | 6 | 12
1 | 7 | 12
1 | 8 | 12
1 | 9 | 12
1 | 10 | 12
1 | 11 | 12
1 | 12 | 12
2 | 1 | 12
2 | 3 | 12
2 | 4 | 12
2 | 5 | 12
2 | 6 | 12
2 | 7 | 12
2 | 8 | 12
2 | 9 | 12
2 | 10 | 12
2 | 11 | 12
2 | 12 | 12
3 | 1 | 12
3 | 2 | 12
3 | 4 | 12
3 | 5 | 12
3 | 6 | 12
3 | 7 | 12
3 | 8 | 12
3 | 9 | 12
3 | 10 | 12
3 | 11 | 12
3 | 12 | 12
4 | 1 | 12
4 | 2 | 12
4 | 3 | 12
4 | 5 | 12
4 | 6 | 12
4 | 7 | 12
4 | 8 | 12
4 | 9 | 12
4 | 10 | 12
4 | 11 | 12
4 | 12 | 12
5 | 1 | 12
5 | 2 | 12
5 | 3 | 12
5 | 4 | 12
5 | 6 | 12
5 | 7 | 12
5 | 8 | 12
5 | 9 | 12
5 | 10 | 12
5 | 11 | 12
5 | 12 | 12
6 | 1 | 12
6 | 2 | 12
6 | 3 | 12
6 | 4 | 12
6 | 5 | 12
6 | 7 | 12
6 | 8 | 12
6 | 9 | 12
6 | 10 | 12
6 | 11 | 12
6 | 12 | 12
7 | 1 | 12
7 | 2 | 12
7 | 3 | 12
7 | 4 | 12
7 | 5 | 12
7 | 6 | 12
7 | 8 | 12
7 | 9 | 12
7 | 10 | 12
7 | 11 | 12
7 | 12 | 12
8 | 1 | 12
8 | 2 | 12
8 | 3 | 12
8 | 4 | 12
8 | 5 | 12
8 | 6 | 12
8 | 7 | 12
8 | 9 | 12
8 | 10 | 12
8 | 11 | 12
8 | 12 | 12
9 | 1 | 12
9 | 2 | 12
9 | 3 | 12
9 | 4 | 12
9 | 5 | 12
9 | 6 | 12
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
