PetterGustafsson/power-supply-tester/hardware/rev-a/validation/startup-shutdown.csv

time_s | A3V3 | VBIAS | A1 | A12 | S1 | S12 | EN1
0 | 0 | 0.0078967101 | 0.0378085051 | 0.0378084854 | 1.519818 | -0.449315229 | 0
3.28e-05 | 0 | 0.0078967101 | 0.0378085051 | 0.0378084854 | 1.519818 | -0.449315229 | 0
0.0001328 | 0 | 0.0078967101 | 0.0378085051 | 0.0378084854 | 1.519818 | -0.449315229 | 0
0.0002328 | 0 | 0.0078967101 | 0.0378085051 | 0.0378084854 | 1.519818 | -0.449315229 | 0
0.0003328 | 0 | 0.0078967101 | 0.0378085051 | 0.0378084854 | 1.519818 | -0.449315229 | 0
0.000399215861 | 0 | 0.0078967101 | 0.0378085051 | 0.0378084854 | 1.519818 | -0.449315229 | 0
0.000400563586 | 0.000281792834 | 0.0078967101 | 0.0378085051 | 0.0378084854 | 1.519818 | -0.449315229 | 0
0.000402942089 | 0.00147104441 | 0.0078967101 | 0.0378085051 | 0.0378084854 | 1.519818 | -0.449315229 | 0
0.000409383443 | 0.00469172139 | 0.0078967101 | 0.0378085051 | 0.0378084854 | 1.519818 | -0.449315229 | 0
0.000434119557 | 0.0170597787 | 0.0078967101 | 0.0378085051 | 0.0378084854 | 1.519818 | -0.449315229 | 0
0.000531504561 | 0.0657522806 | 0.00789671011 | 0.0378085051 | 0.0378084854 | 1.519818 | -0.449315229 | 0
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
