PetterGustafsson/power-supply-tester/hardware/rev-b/validation/all-pin-pairs.csv

positive | negative | applied_V | reported_V | A1_V | A2_V | A3_V | A4_V | A5_V | A6_V | A7_V | A8_V | A9_V | A10_V | A11_V | A12_V
1 | 2 | 0 | 0.001583835817167456 | 1.4968843503702611 | 1.4968843503702611 | 1.49684188828401 | 1.49684188828401 | 1.49684188828401 | 1.49684188828401 | 1.49684188828401 | 1.49684188828401 | 1.49684188828401 | 1.49684188828401 | 1.49684188828401 | 1.49684188828401
1 | 2 | 3.3 | 3.292633678690692 | 1.541021531049761 | 1.4527471696907612 | 1.49684188828401 | 1.49684188828401 | 1.49684188828401 | 1.49684188828401 | 1.49684188828401 | 1.49684188828401 | 1.49684188828401 | 1.49684188828401 | 1.49684188828401 | 1.49684188828401
1 | 2 | 5 | 4.988838907107108 | 1.5637588665513216 | 1.4300098341892007 | 1.49684188828401 | 1.49684188828401 | 1.49684188828401 | 1.49684188828401 | 1.49684188828401 | 1.49684188828401 | 1.49684188828401 | 1.49684188828401 | 1.49684188828401 | 1.49684188828401
1 | 2 | 9 | 8.979910032792791 | 1.61725847949617 | 1.3765102212443525 | 1.49684188828401 | 1.49684188828401 | 1.49684188828401 | 1.49684188828401 | 1.49684188828401 | 1.49684188828401 | 1.49684188828401 | 1.49684188828401 | 1.49684188828401 | 1.49684188828401
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
