PetterGustafsson/power-supply-tester/hardware/rev-b/validation/startup-shutdown.csv

time_s | A3V3 | VBIAS | A1 | A12 | S1 | S12 | EN1
0 | 0 | 0.0078967101 | 0.0378085051 | 0.0378084854 | 1.519818 | -0.449315229 | 0
3.28e-05 | 0 | 0.0078967101 | 0.0378085051 | 0.0378084854 | 1.519818 | -0.449315229 | 0
0.0001328 | 0 | 0.0078967101 | 0.0378085051 | 0.0378084854 | 1.519818 | -0.449315229 | 0
0.0002328 | 0 | 0.0078967101 | 0.0378085051 | 0.0378084854 | 1.519818 | -0.449315229 | 0
0.0003328 | 0 | 0.0078967101 | 0.0378085051 | 0.0378084854 | 1.519818 | -0.449315229 | 0
0.000399946582 | 0 | 0.0078967101 | 0.0378085051 | 0.0378084854 | 1.519818 | -0.449315229 | 0
0.000400865303 | 0.000432651626 | 0.0078967101 | 0.0378085051 | 0.0378084854 | 1.519818 | -0.449315229 | 0
0.000403165832 | 0.00158291613 | 0.0078967101 | 0.0378085051 | 0.0378084854 | 1.519818 | -0.449315229 | 0
0.000409821538 | 0.0049107688 | 0.0078967101 | 0.0378085051 | 0.0378084854 | 1.519818 | -0.449315229 | 0
0.000460422189 | 0.0302110947 | 0.0078967101 | 0.0378085051 | 0.0378084854 | 1.519818 | -0.449315229 | 0
0.000560422189 | 0.0802110947 | 0.00789671011 | 0.0378085051 | 0.0378084854 | 1.519818 | -0.449315229 | 0
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
