PetterGustafsson/power-supply-tester/hardware/rev-c/validation/startup-shutdown.csv

time_s | A3V3 | VBIAS | A1 | A12
0.000000000000000000e+00 | 0.000000000000000000e+00 | -1.110534139999999911e-18 | 2.152566540000000125e-02 | -2.152566540000000125e-02
3.171624519999999847e-06 | 1.141784830000000008e-02 | 7.849484509999999802e-04 | 2.180737829999999933e-02 | -2.124395249999999971e-02
8.171624519999999832e-06 | 2.941784830000000045e-02 | 2.732345020000000093e-03 | 2.321105440000000020e-02 | -1.984027630000000098e-02
1.317162449999999975e-05 | 4.741784830000000256e-02 | 5.187736779999999569e-03 | 2.535090229999999861e-02 | -1.770042839999999909e-02
1.817162450000000100e-05 | 6.541784829999999773e-02 | 7.937939499999999496e-03 | 2.791798170000000037e-02 | -1.513334910000000040e-02
2.317162450000000056e-05 | 8.341784829999999984e-02 | 1.085923339999999952e-02 | 3.073300140000000125e-02 | -1.231832939999999953e-02
2.817162450000000013e-05 | 1.014178480000000049e-01 | 1.387981869999999930e-02 | 3.369191140000000334e-02 | -9.359419420000000822e-03
3.317162450000000308e-05 | 1.194178479999999931e-01 | 1.695802700000000052e-02 | 3.673432680000000145e-02 | -6.317003950000000395e-03
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
