PetterGustafsson/power-supply-tester/docs/images/power-supply-tester-render.png

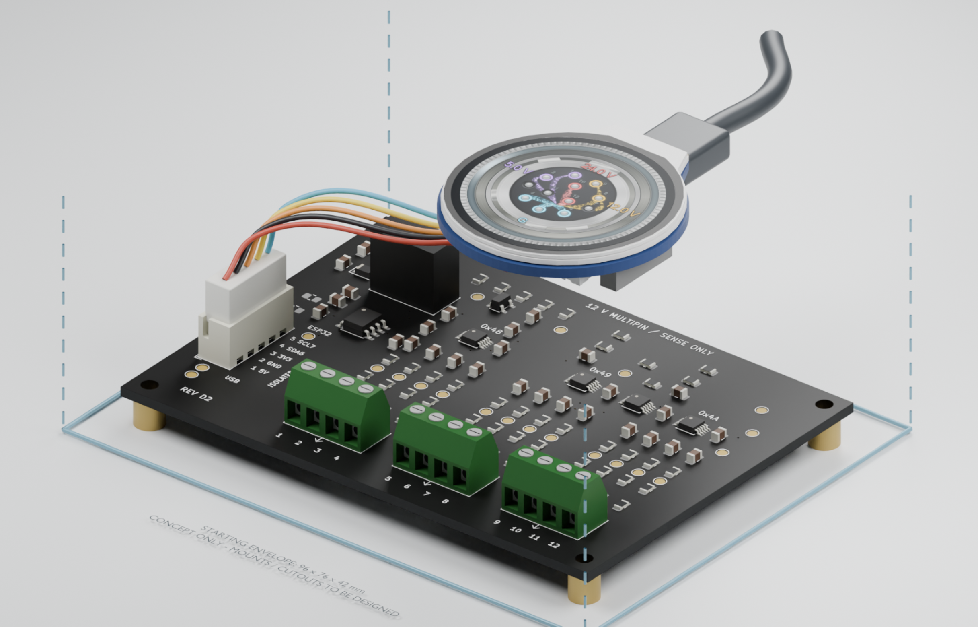
docs/images/power-supply-tester-render.png
