PetterGustafsson/power-supply-tester/output/calibration-batch-2026-10-19/ui-ready.jpg

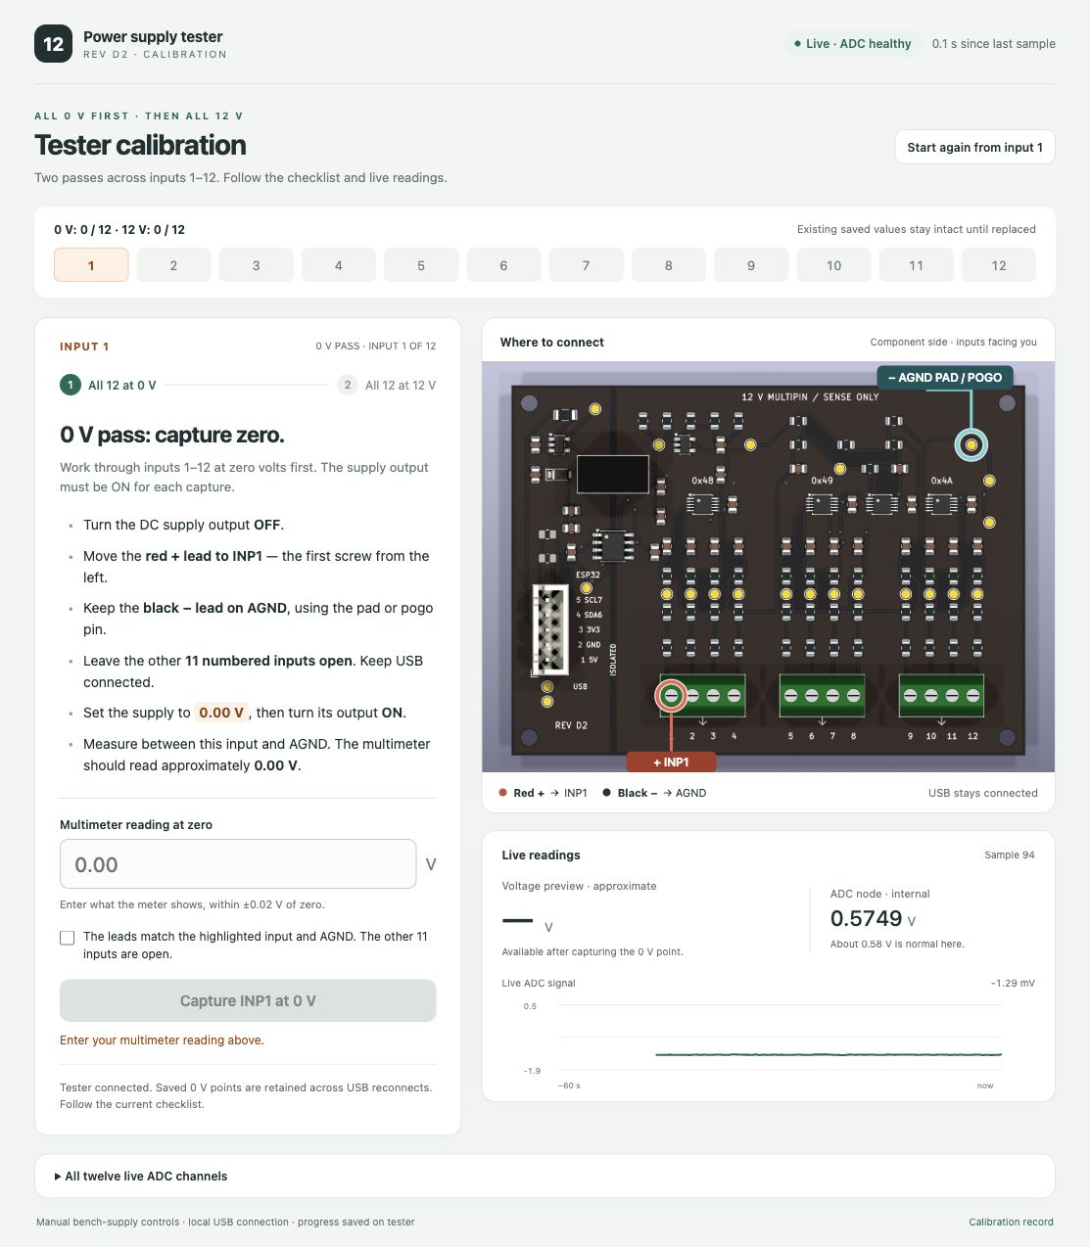
output/calibration-batch-2026-10-19/ui-ready.jpg
