PetterGustafsson/power-supply-tester/output/final-layout-poster/power-supply-tester-final-layout.png

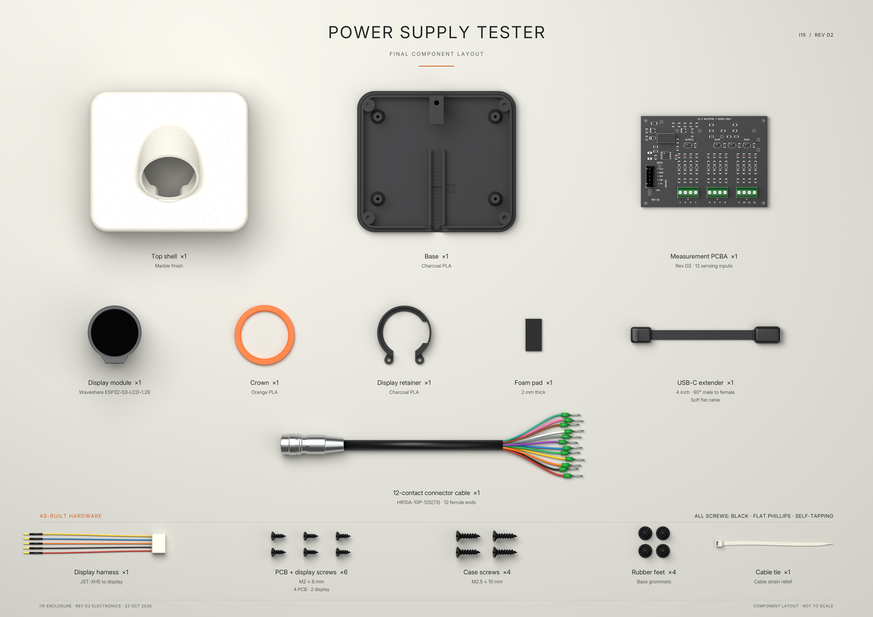
output/final-layout-poster/power-supply-tester-final-layout.png
