PetterGustafsson/power-supply-tester/output/imagegen/eight-input-tester-concept.png

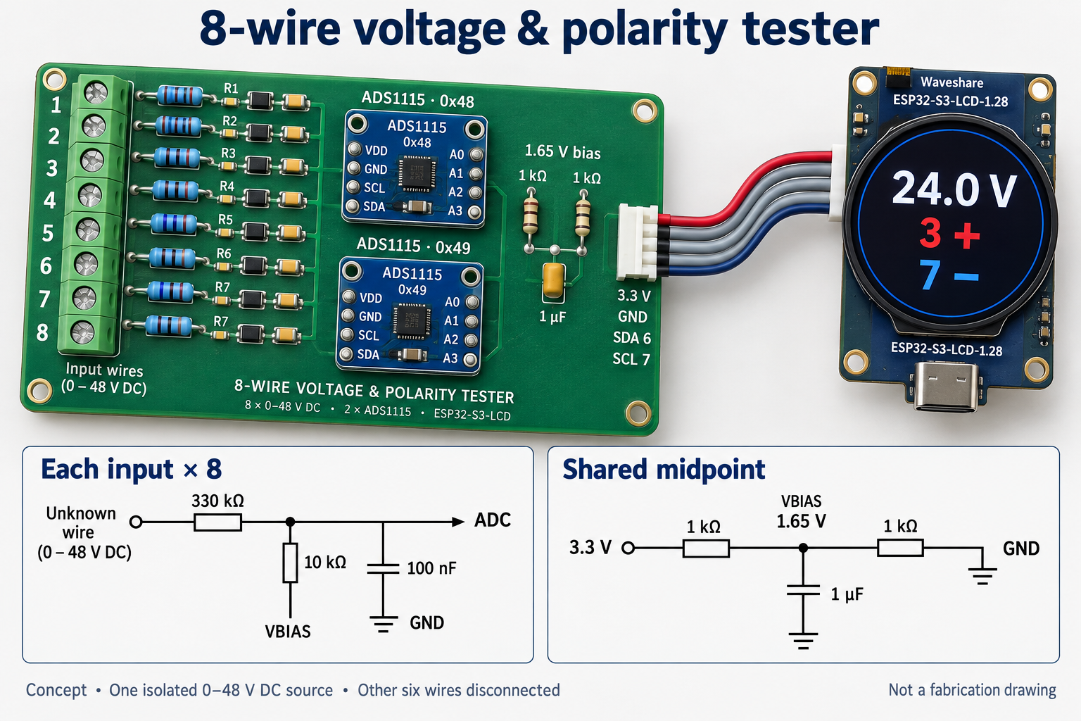
output/imagegen/eight-input-tester-concept.png
