PetterGustafsson/power-supply-tester/output/imagegen/round-esp32-tester-concept.png

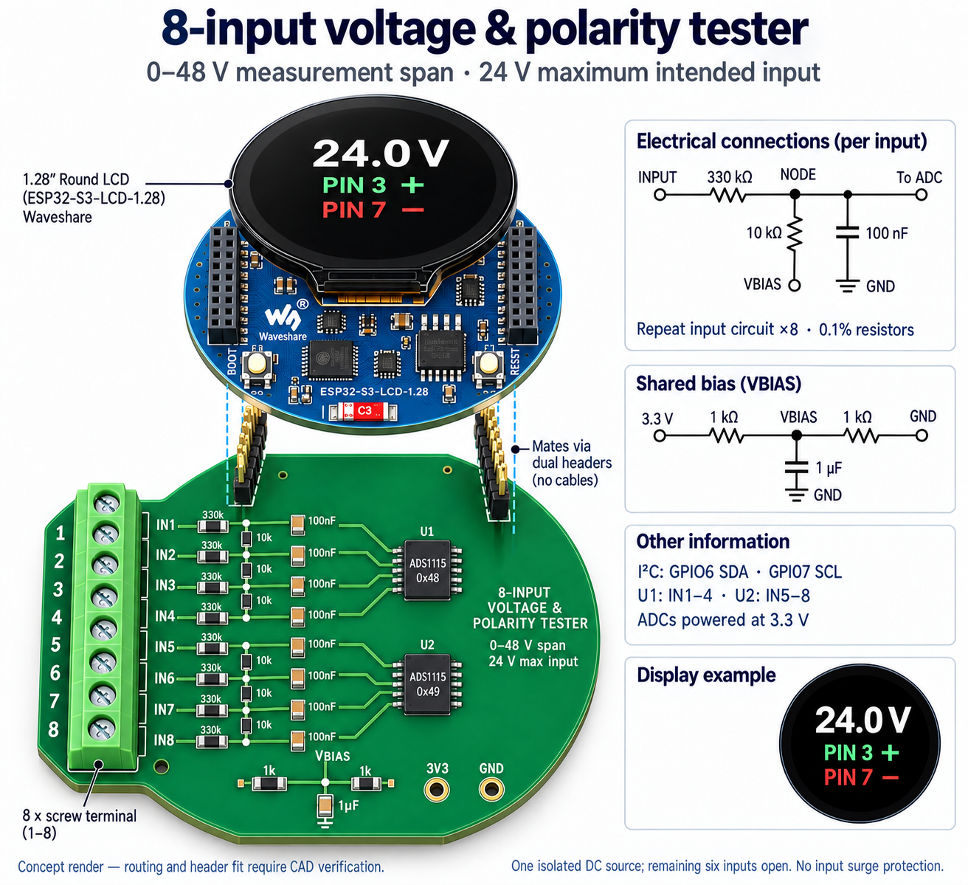
output/imagegen/round-esp32-tester-concept.png
