PetterGustafsson/power-supply-tester/output/imagegen/tester-connector-ui-concept.png

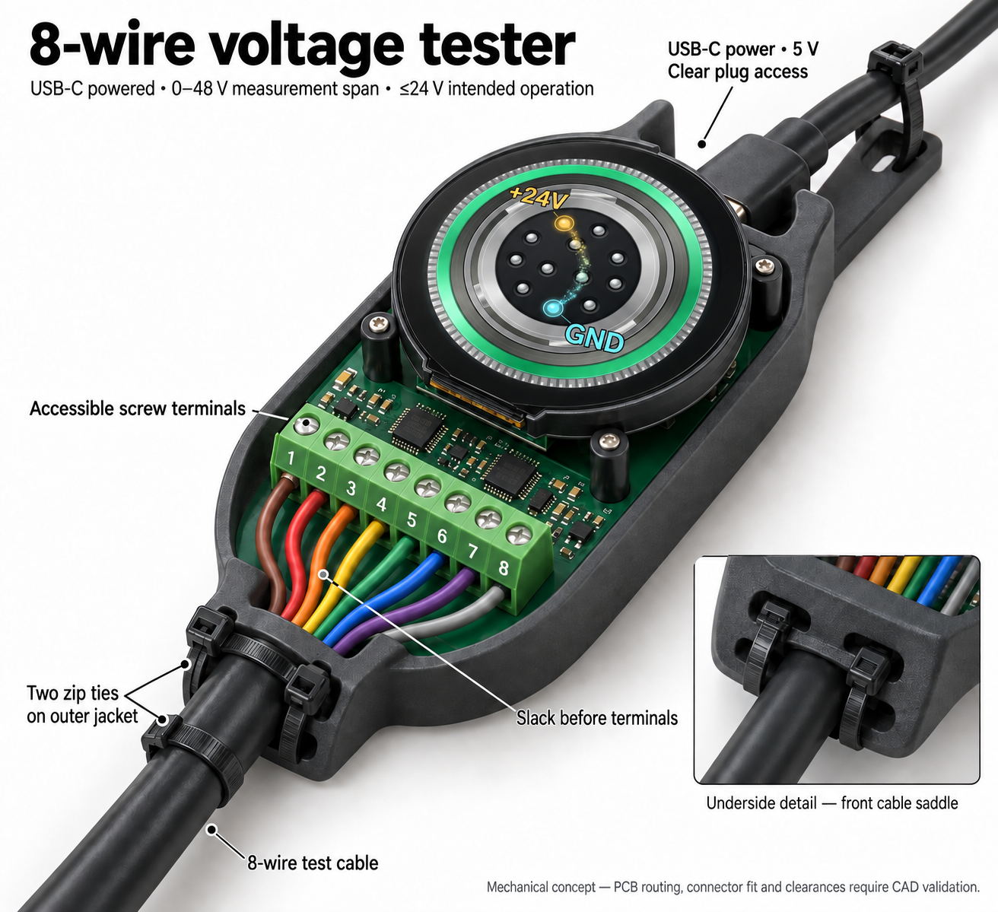
output/imagegen/tester-connector-ui-concept.png
