PetterGustafsson/power-supply-tester/output/imagegen/universal-tester-3d-concept.png

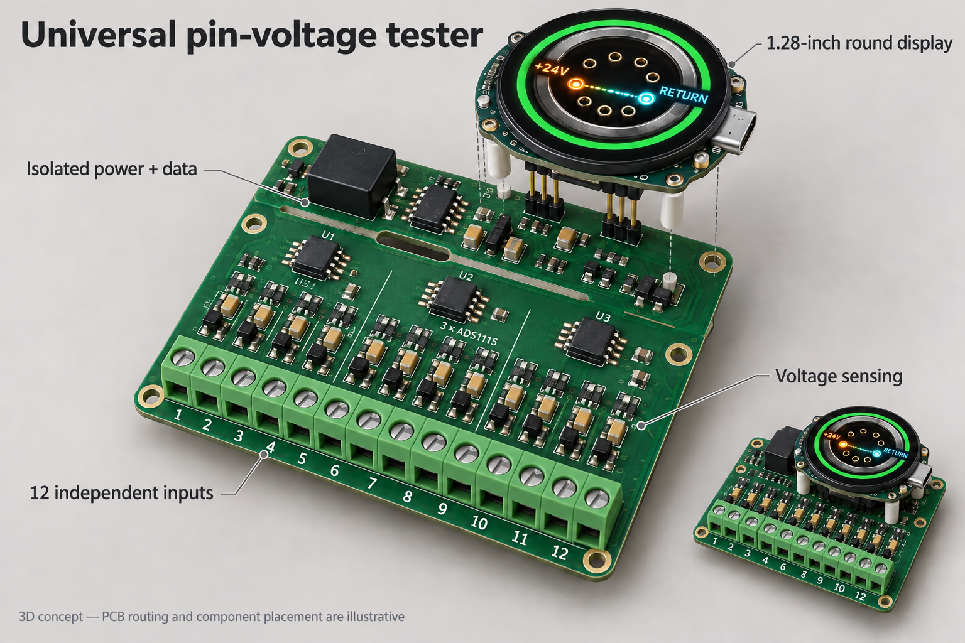
output/imagegen/universal-tester-3d-concept.png
