PetterGustafsson/power-supply-tester/output/product-render/power-supply-tester-hero-preview.png

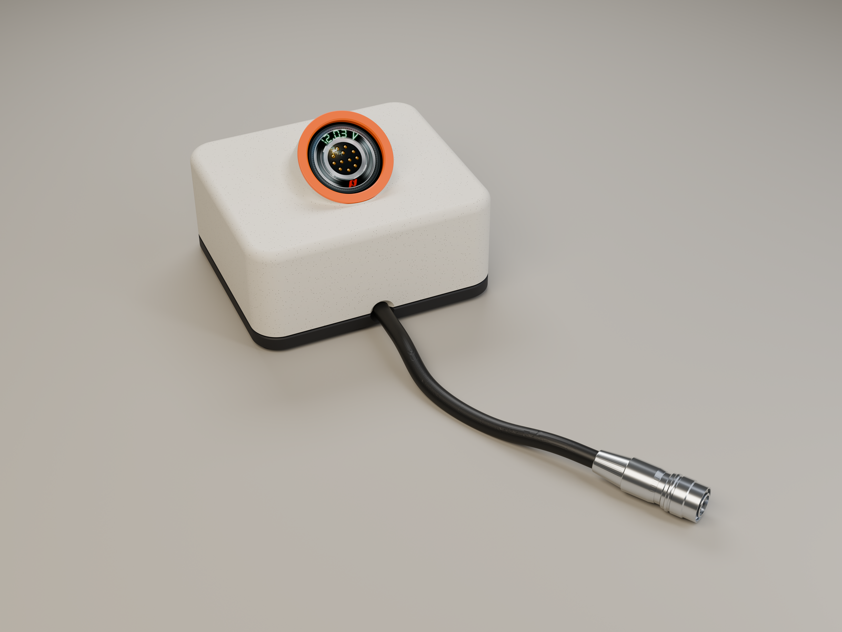
output/product-render/power-supply-tester-hero-preview.png
