PetterGustafsson/power-supply-tester/output/shared-calibration-2026-10-19/shared-test-ui.jpg

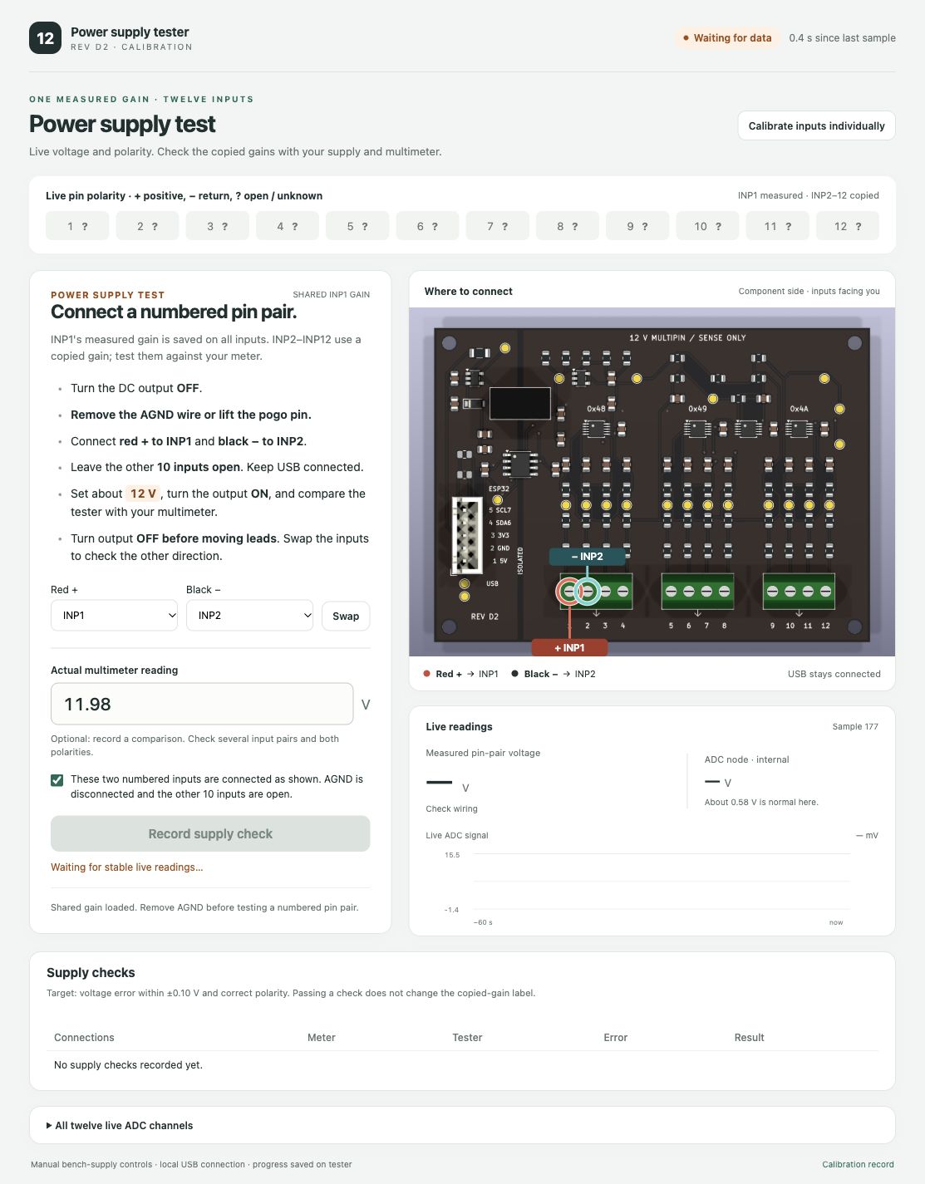
output/shared-calibration-2026-10-19/shared-test-ui.jpg
