PetterGustafsson/power-supply-tester/hardware/rev-e/sources/XY350V.pdf

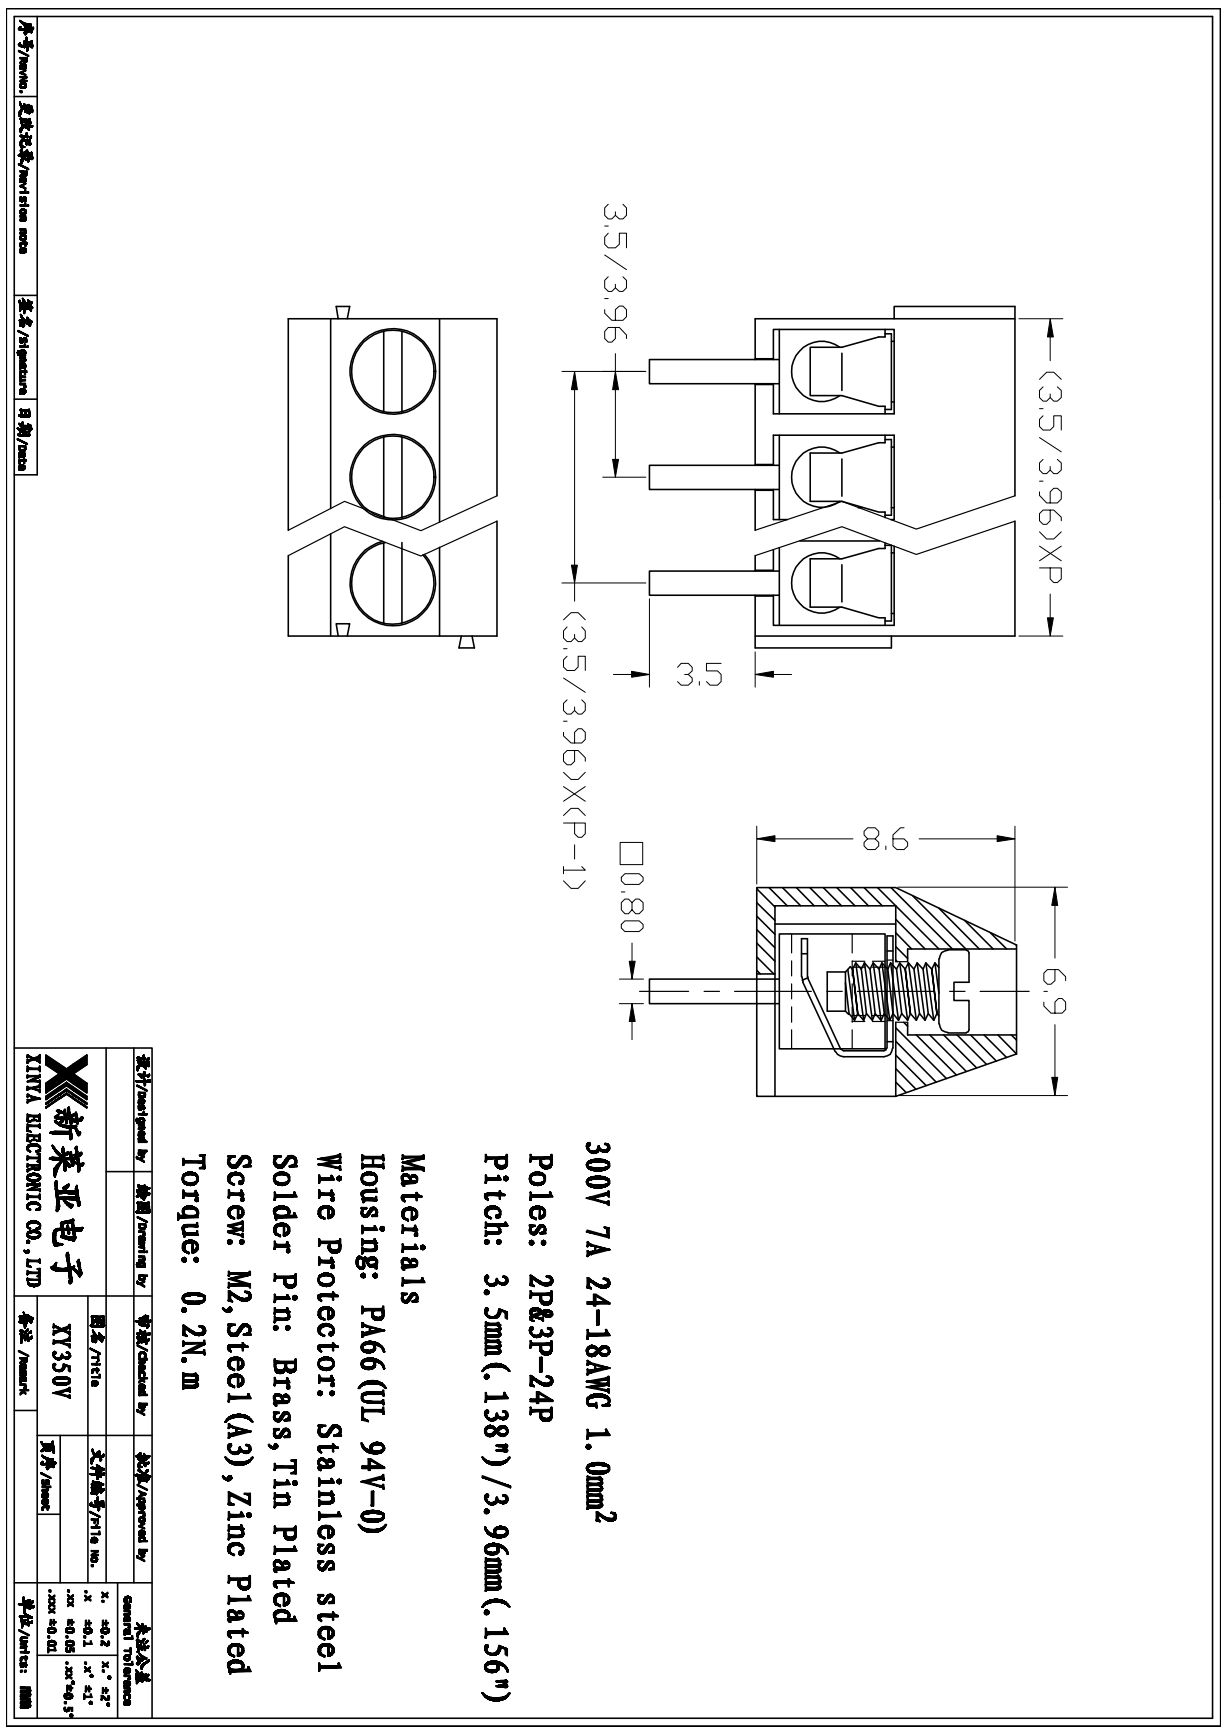
[picture p188: page 1]
