PetterGustafsson/power-supply-tester/hardware/tester12v-rev-d-engineering-package/hardware/rev-d/previews/assembly.pdf

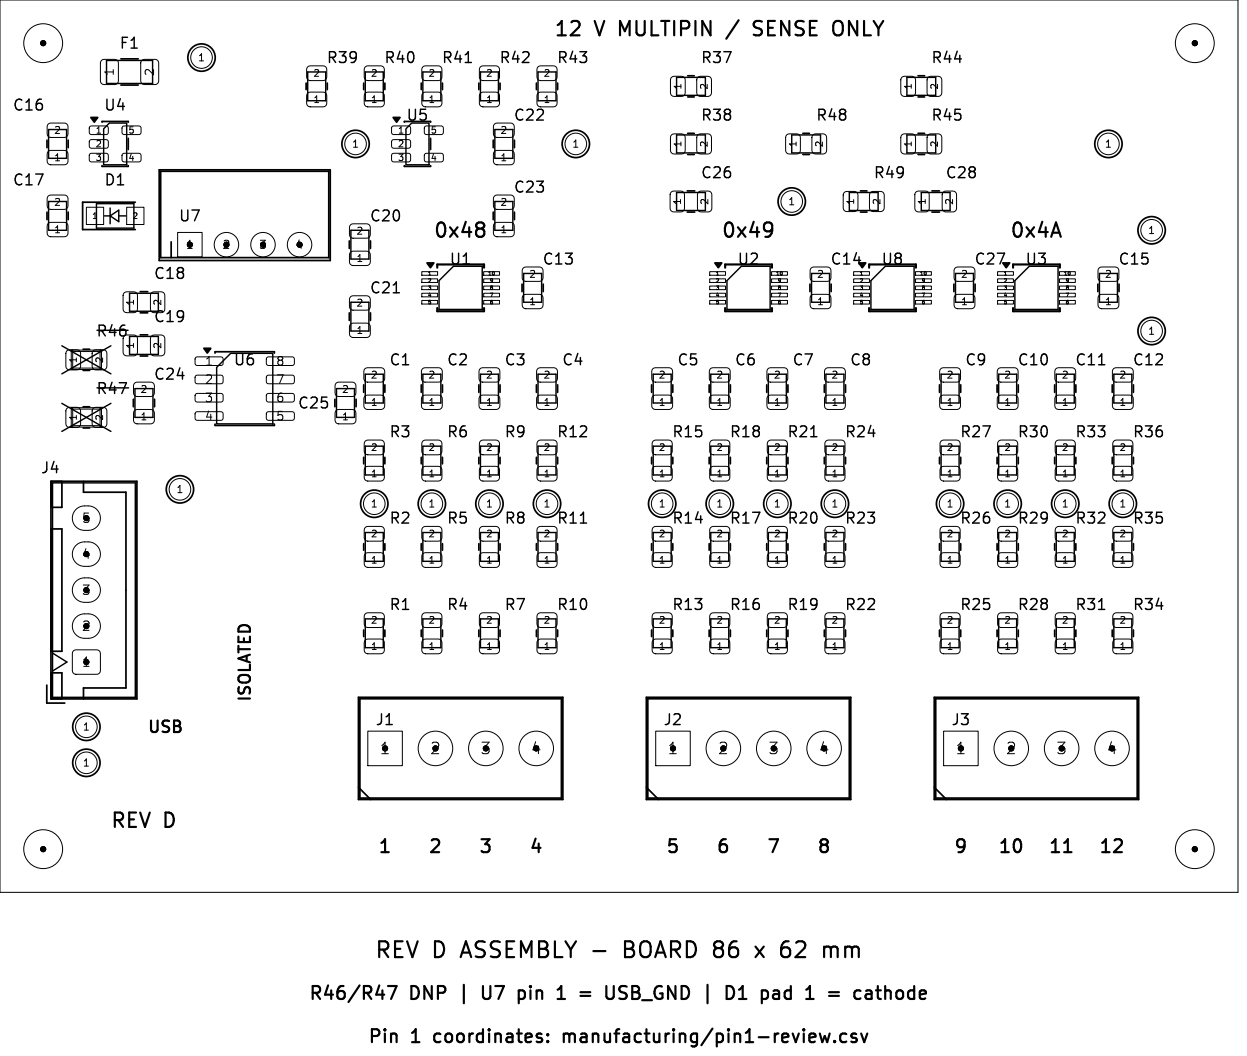
[picture p189: page 1]
