PetterGustafsson/power-supply-tester/hardware/tester12v-rev-d-engineering-package/hardware/rev-d/previews/schematic.pdf

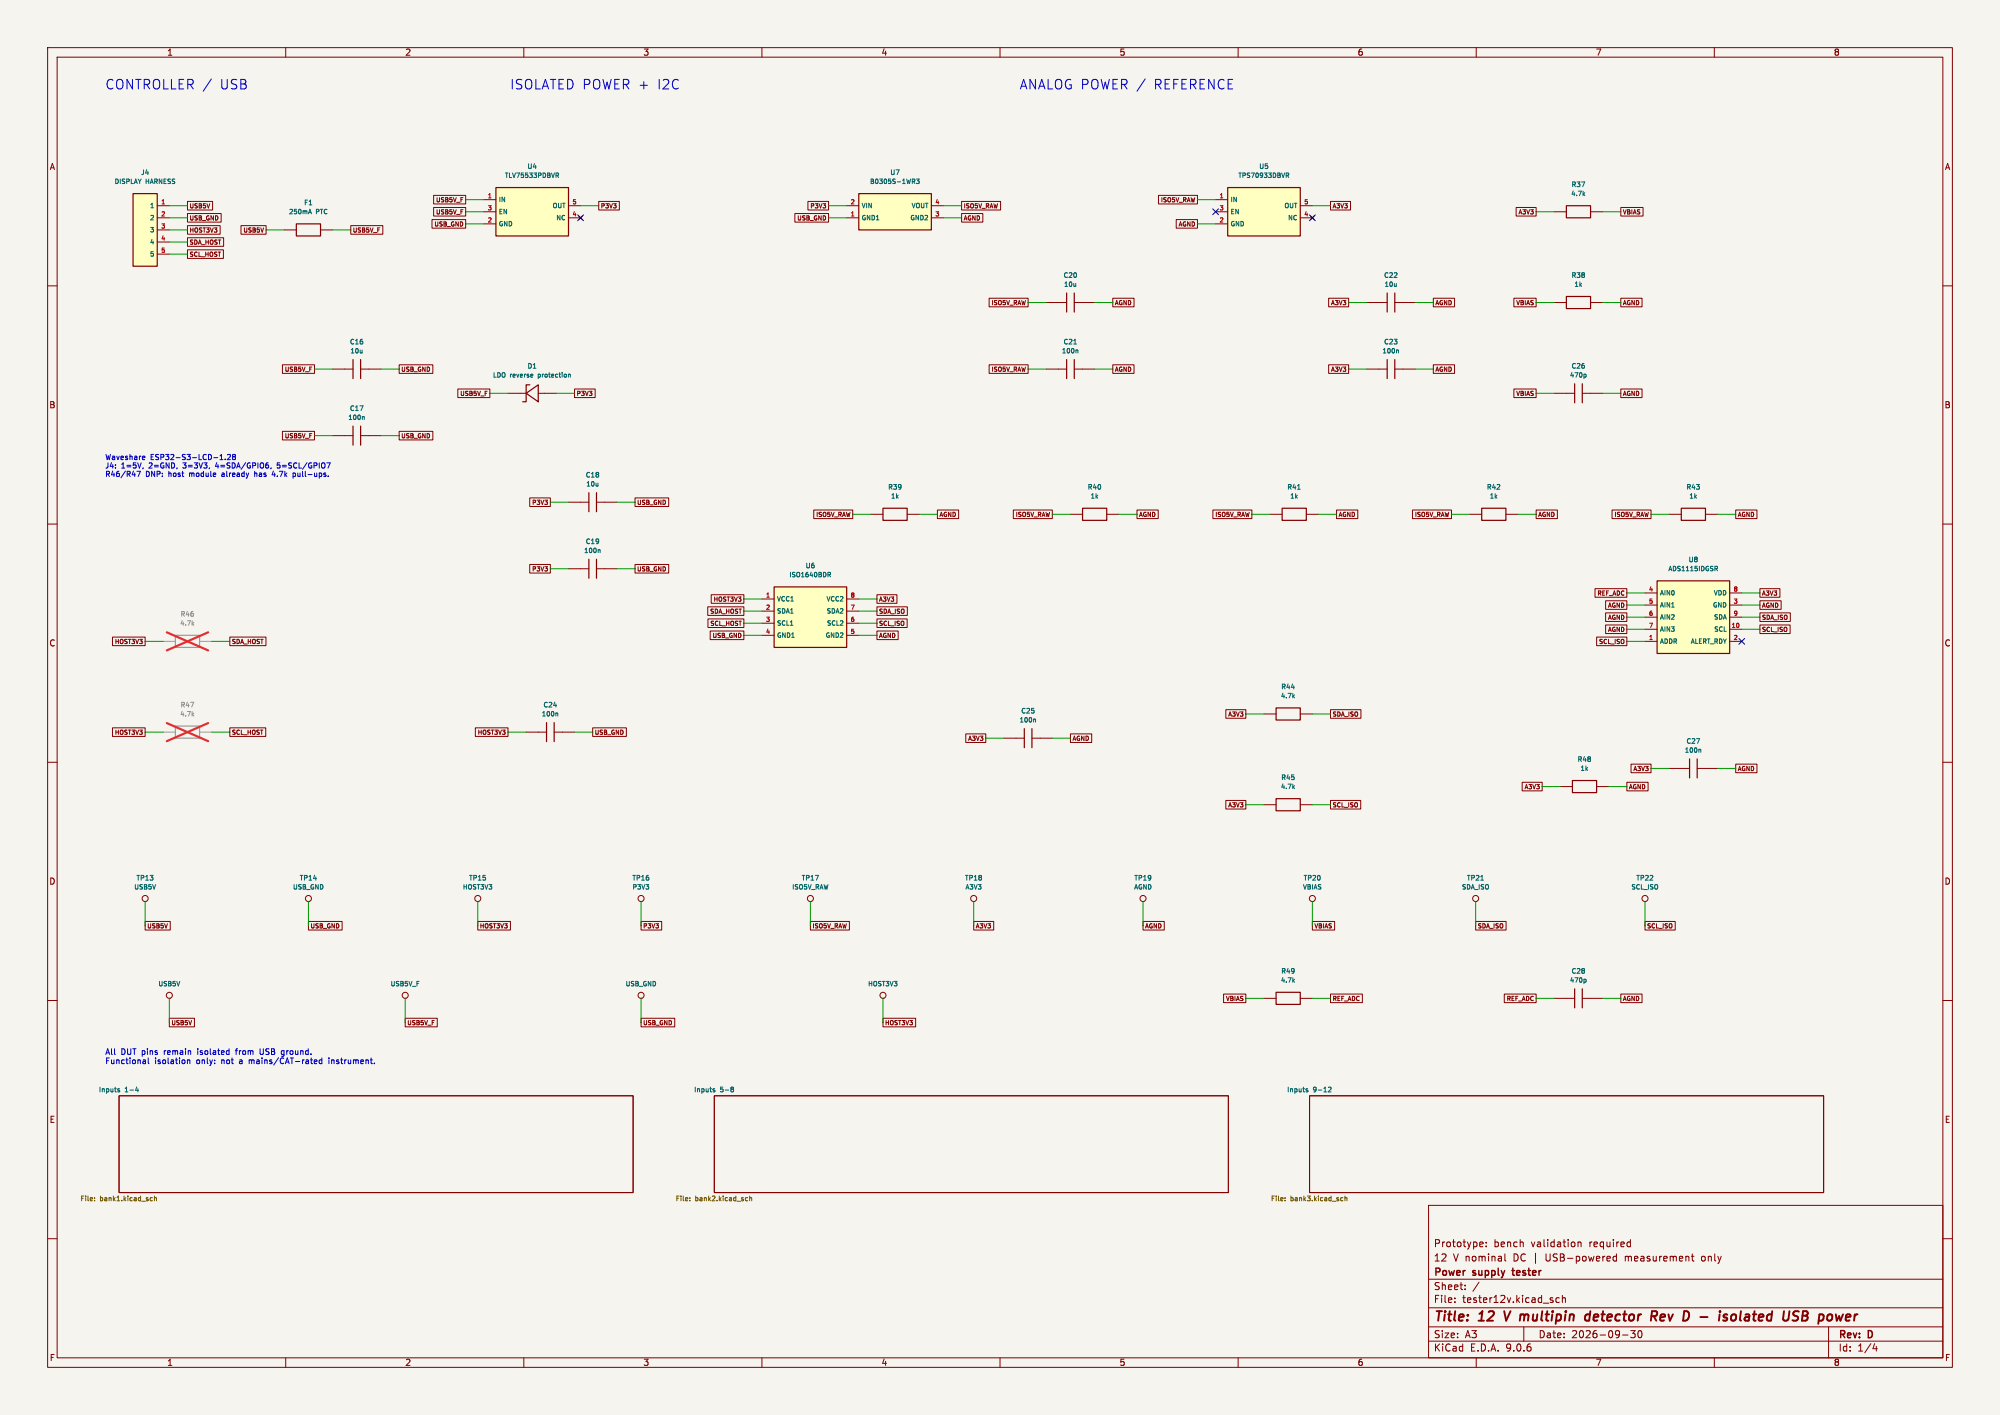
[picture p190: page 1]

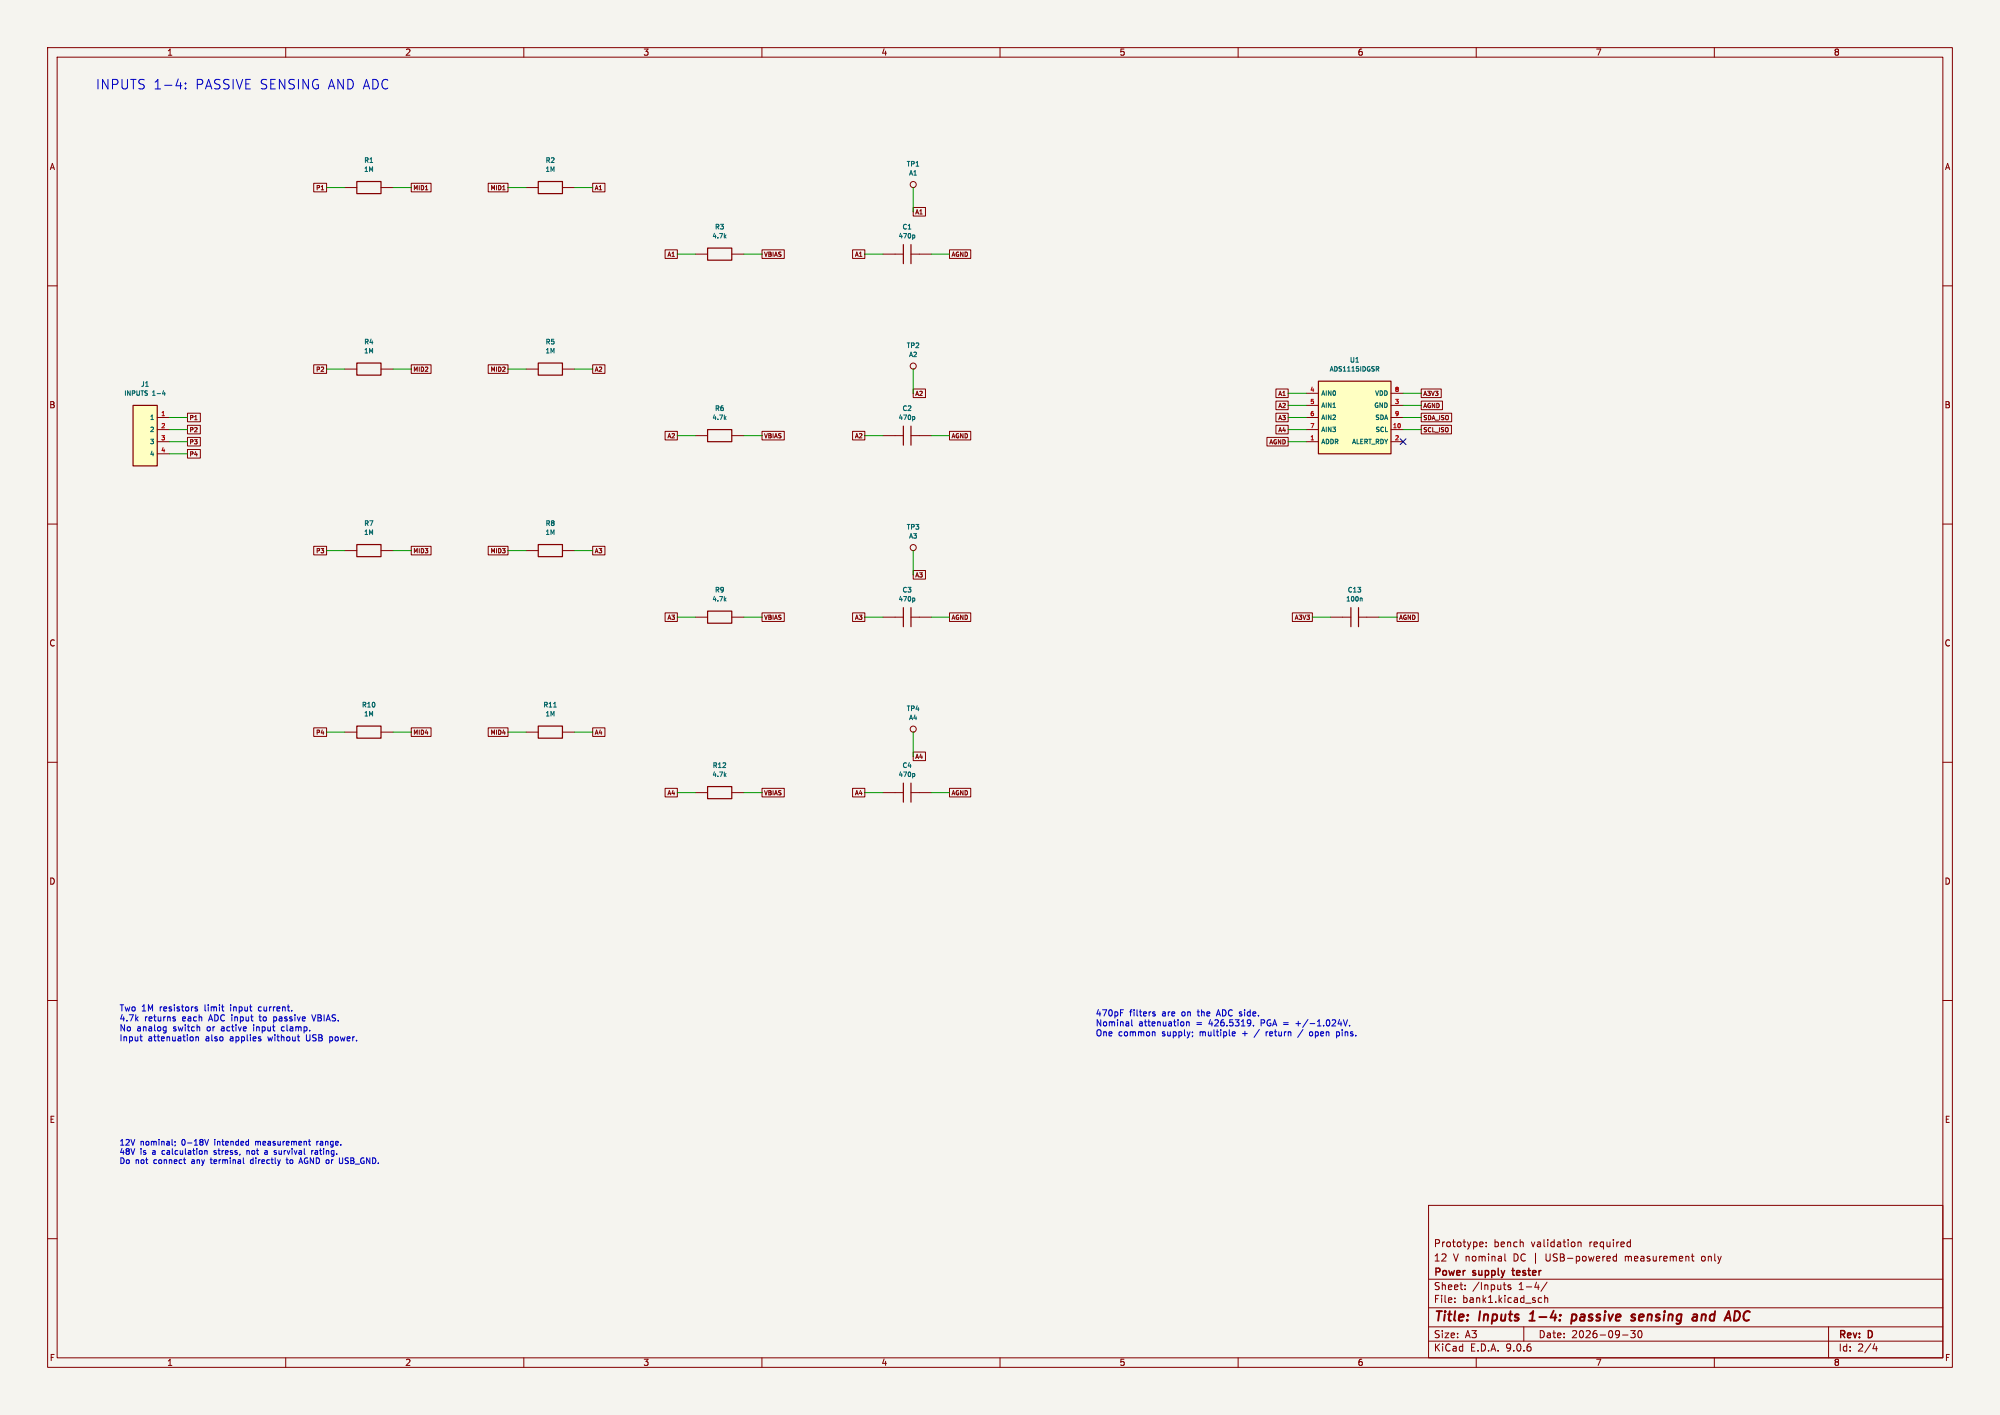
[picture p191: page 2]

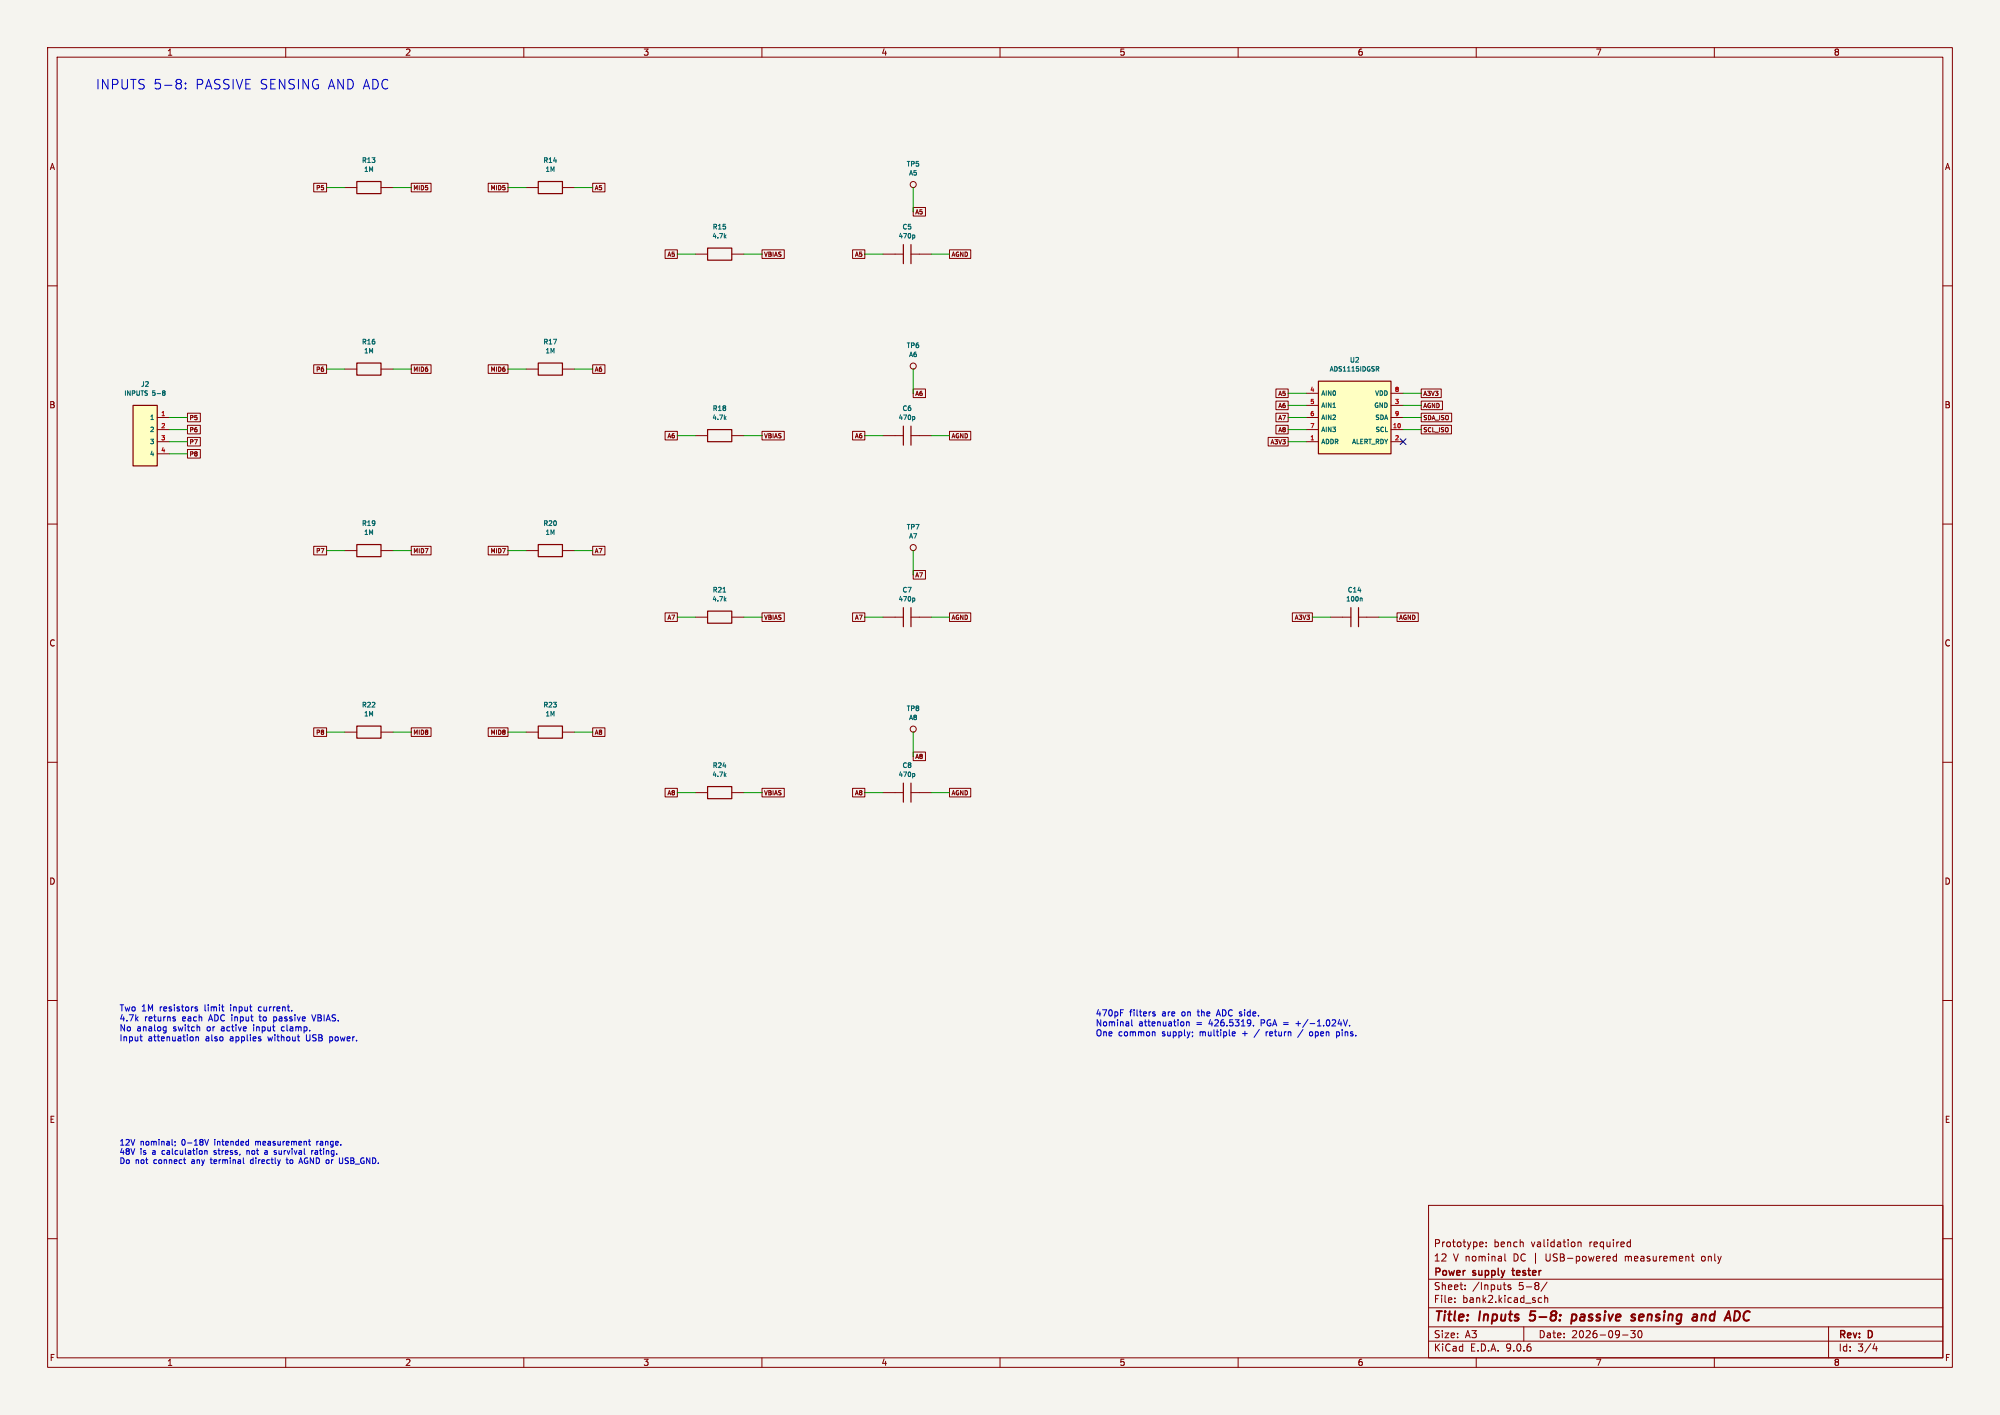
[picture p192: page 3]

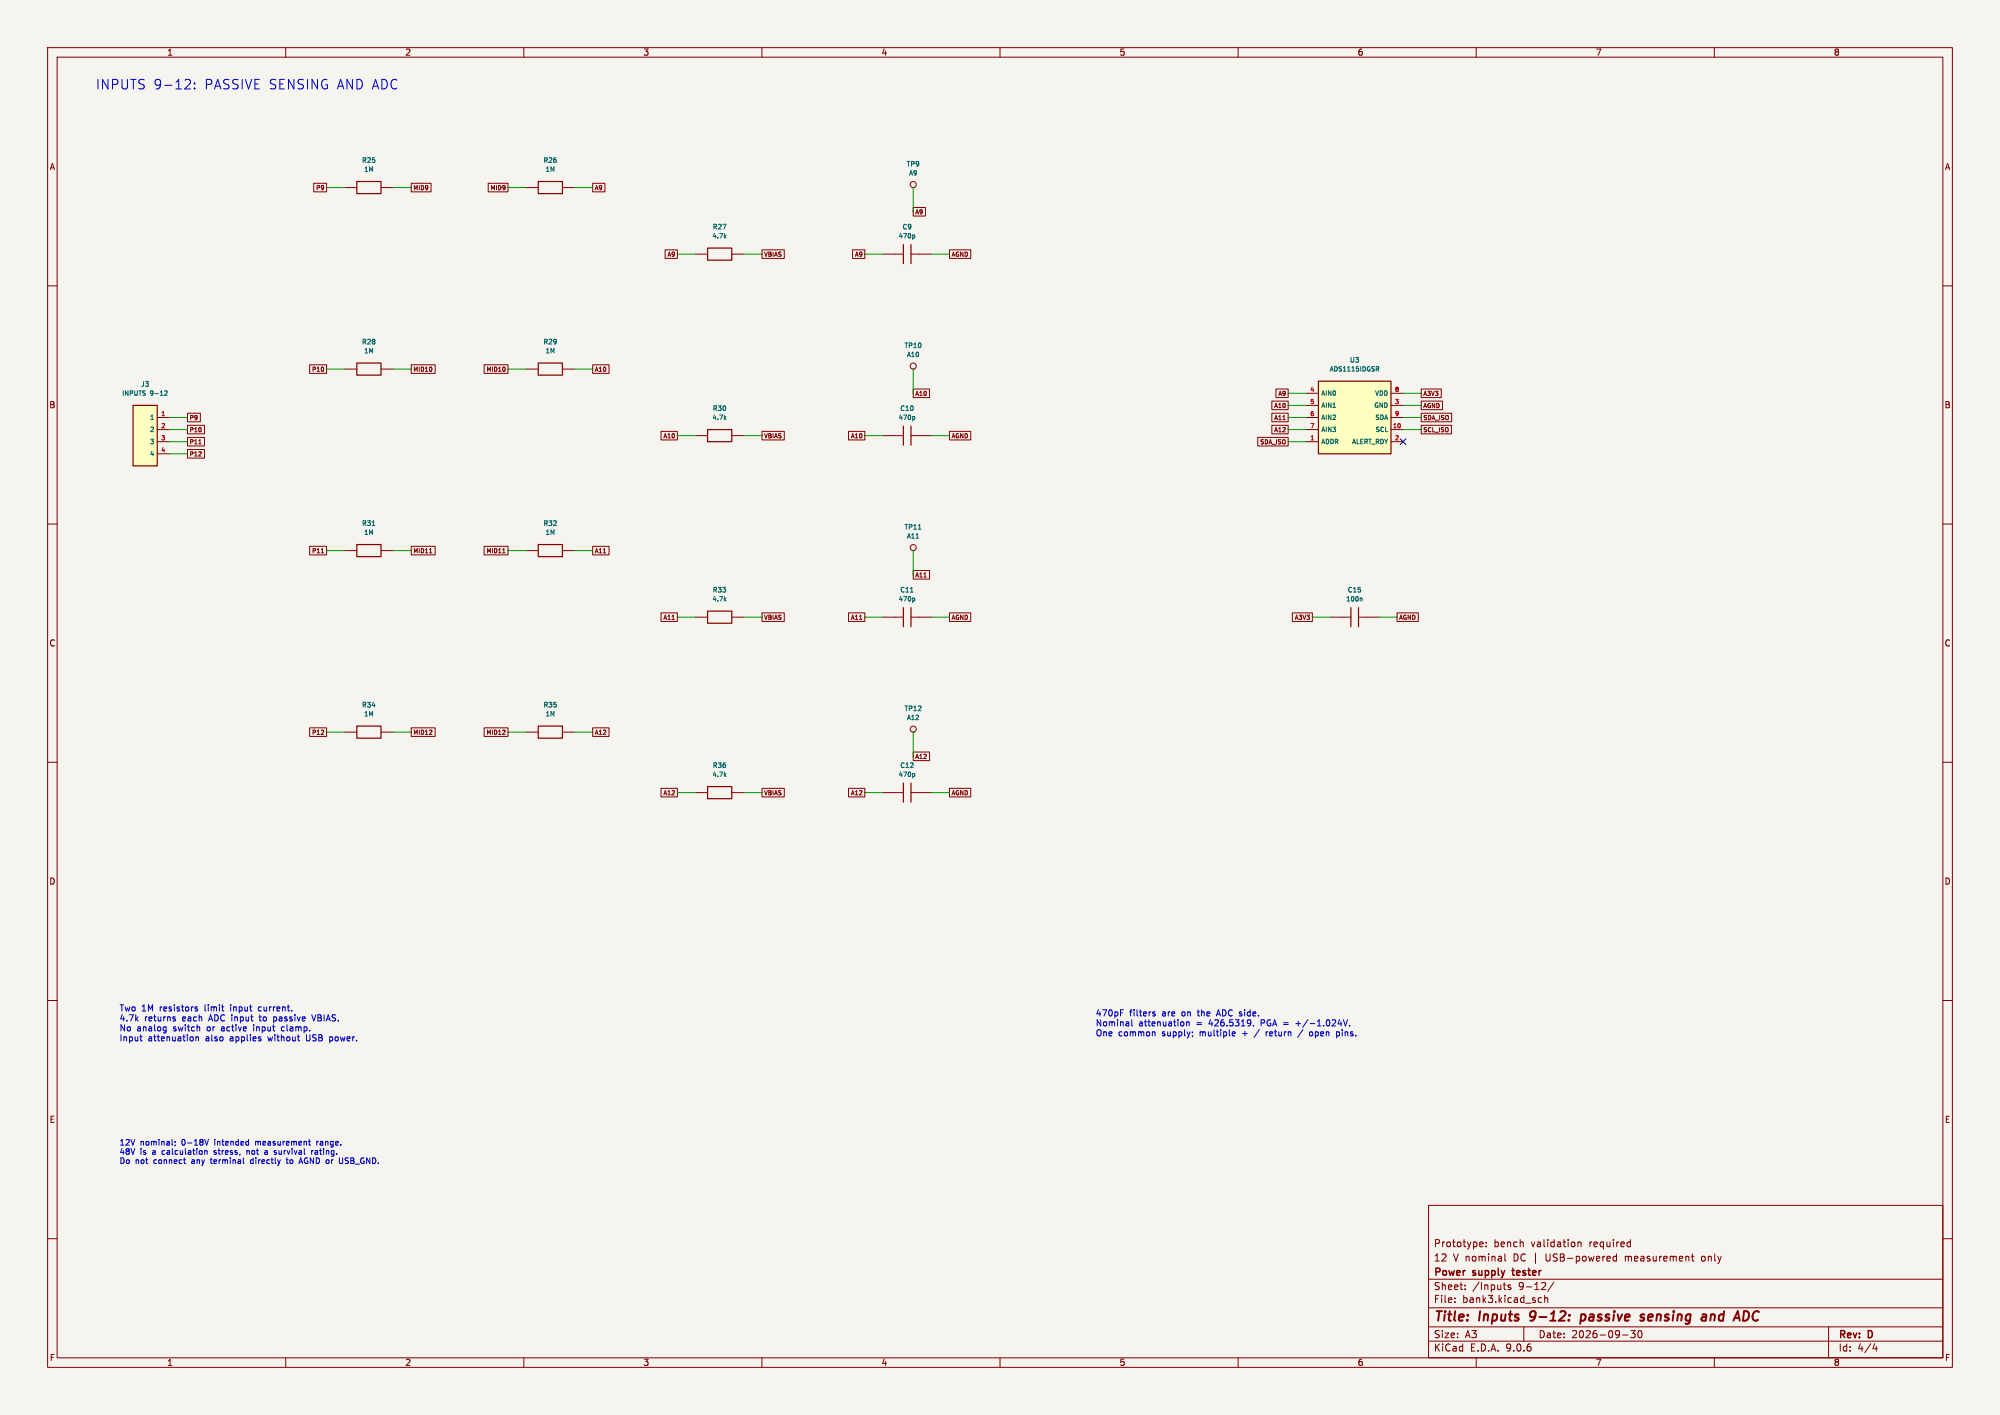
[picture p193: page 4]
