PetterGustafsson/power-supply-tester/hardware/tester12v-rev-d1-engineering-package/hardware/rev-d/previews/assembly.pdf

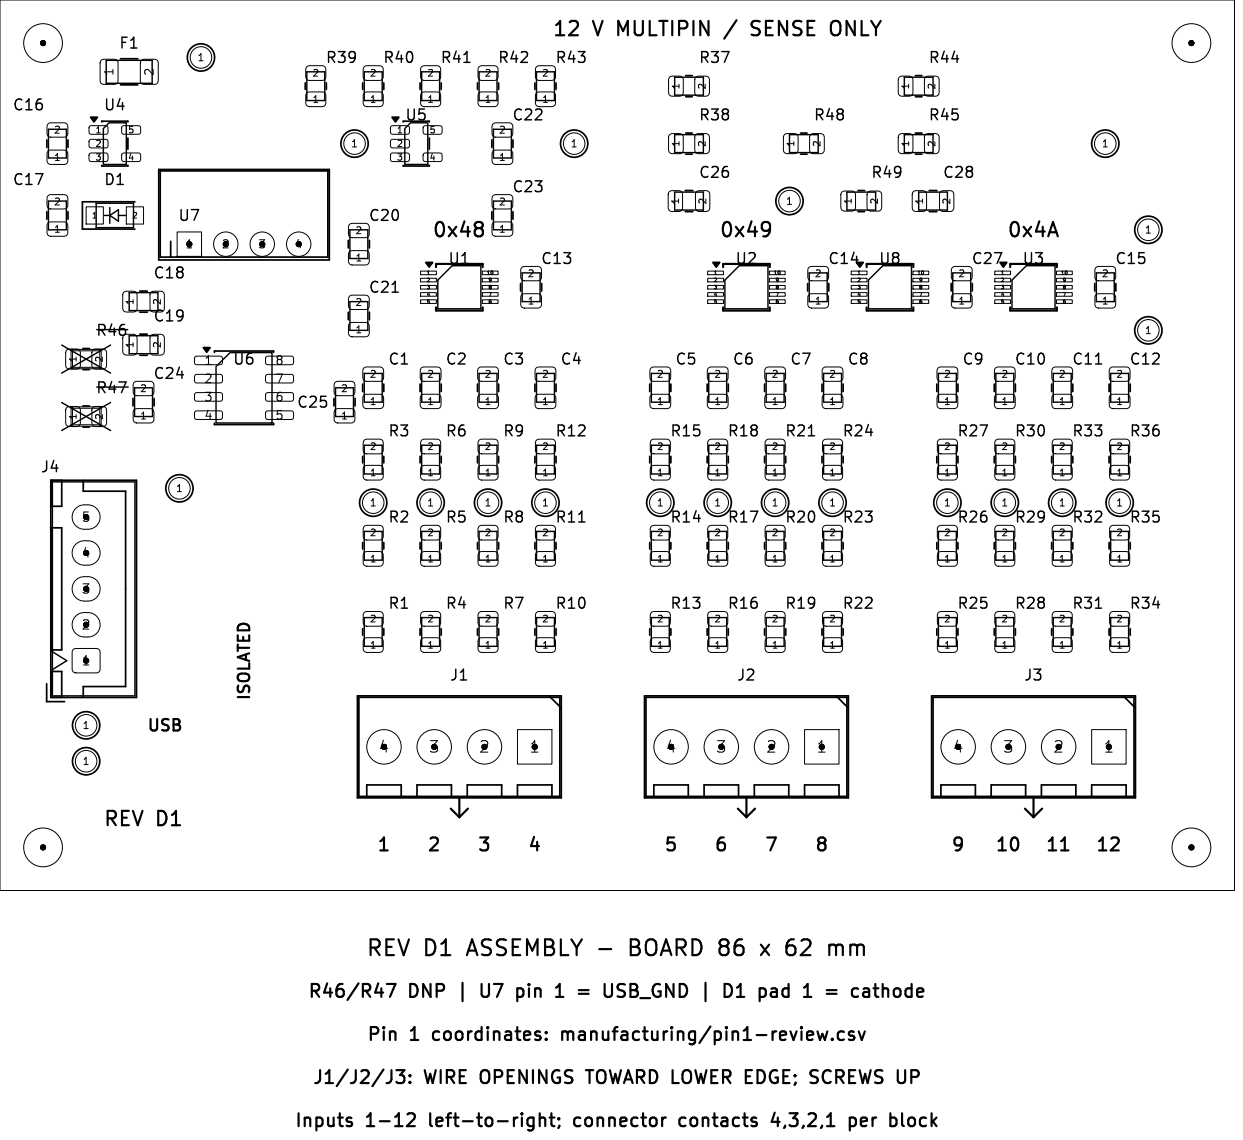
[picture p194: page 1]
