PetterGustafsson/power-supply-tester/hardware/tester12v-rev-d1-engineering-package/hardware/rev-d/previews/schematic.pdf

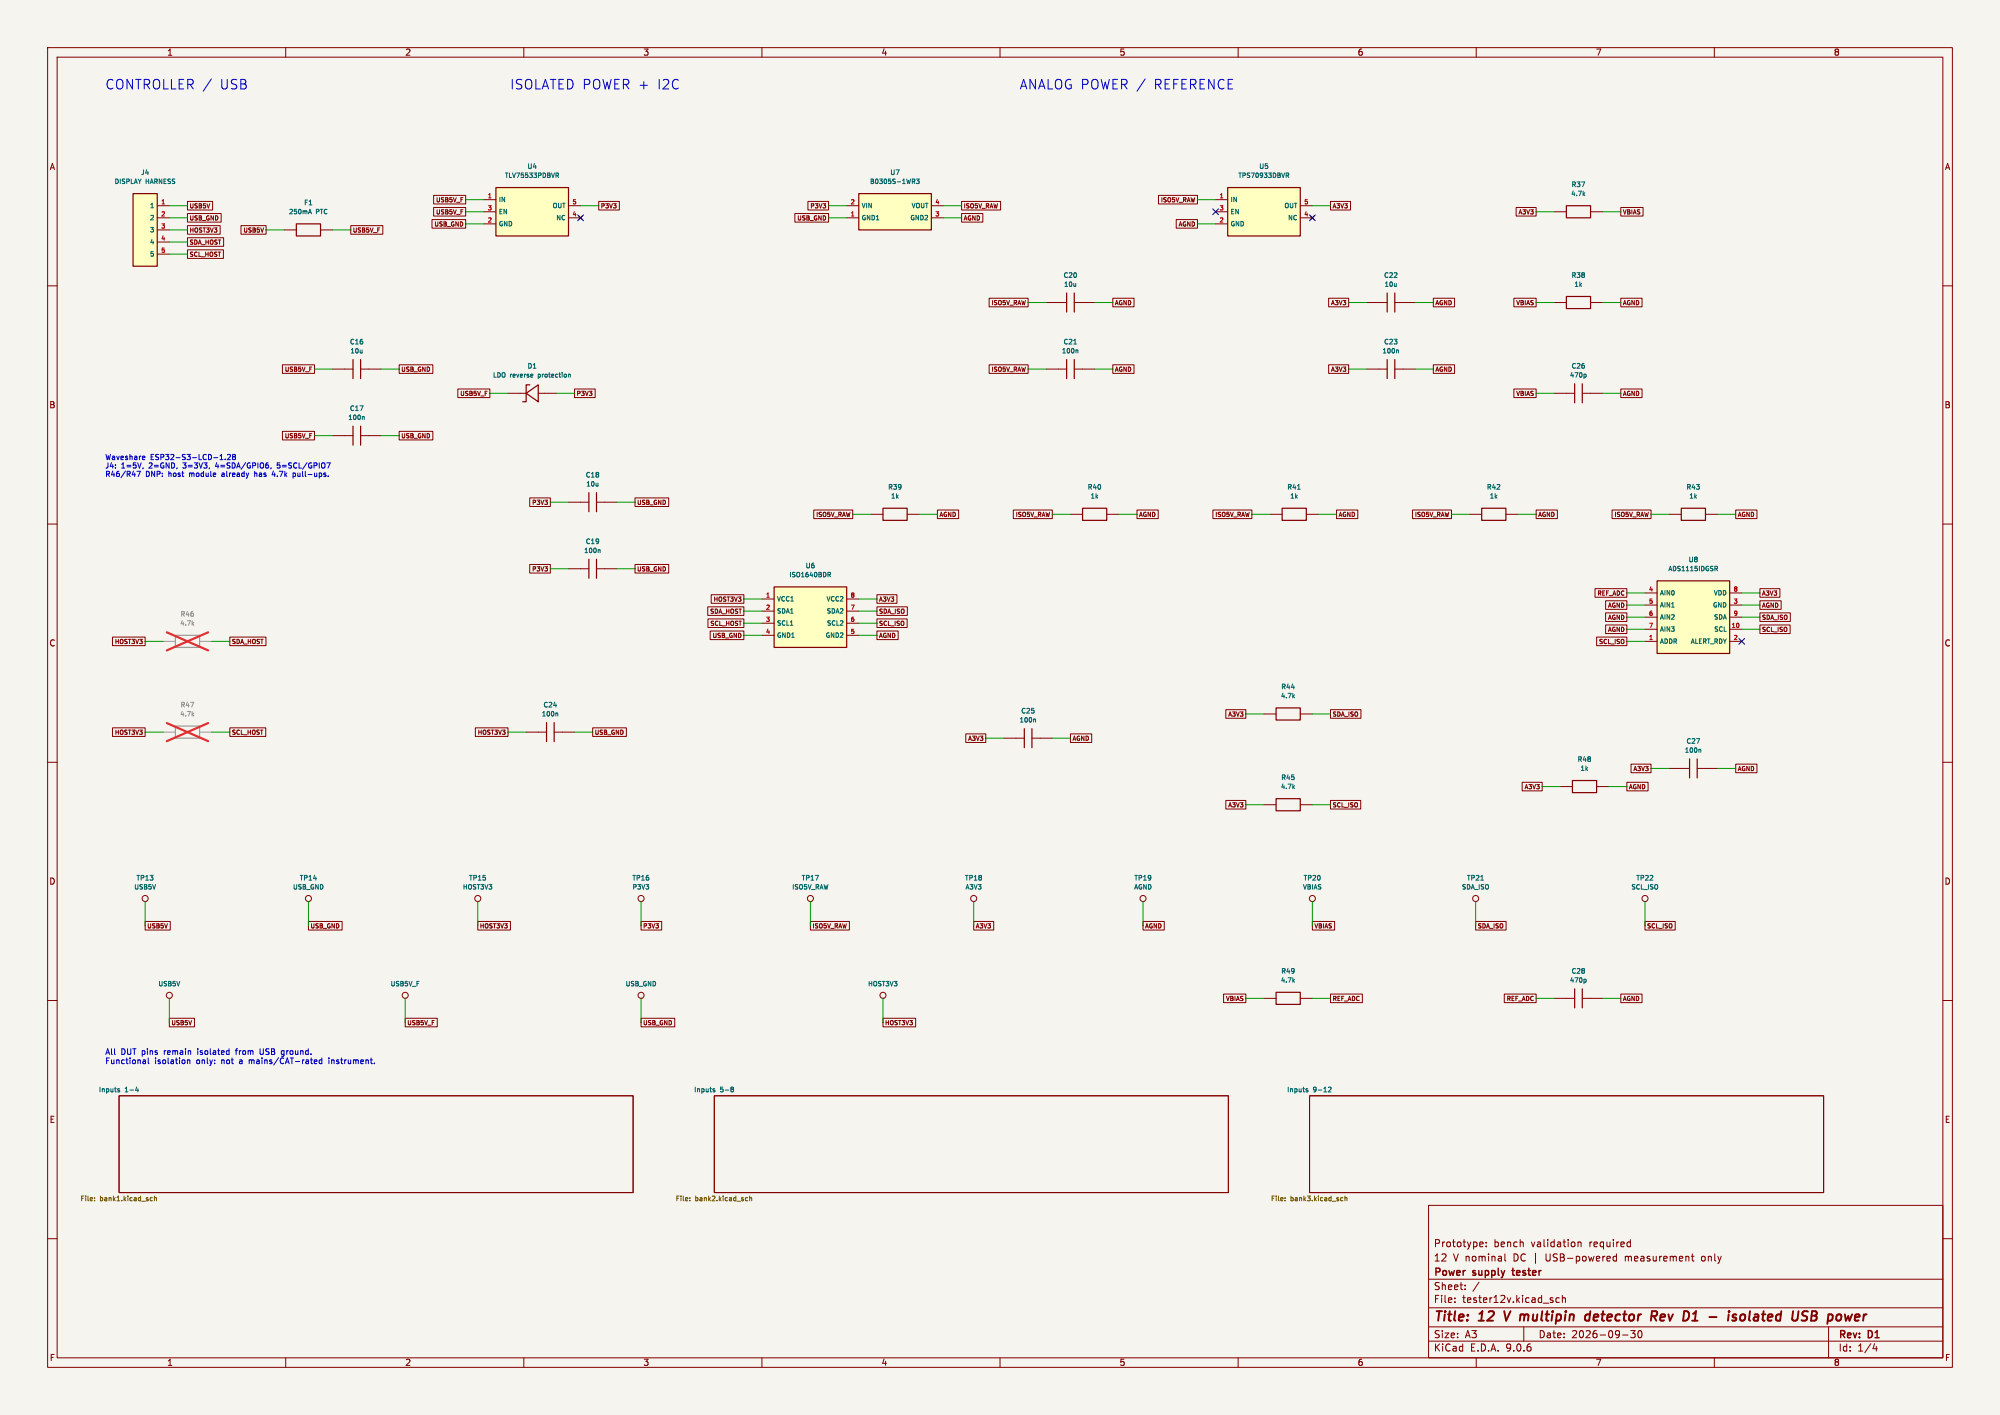
[picture p195: page 1]

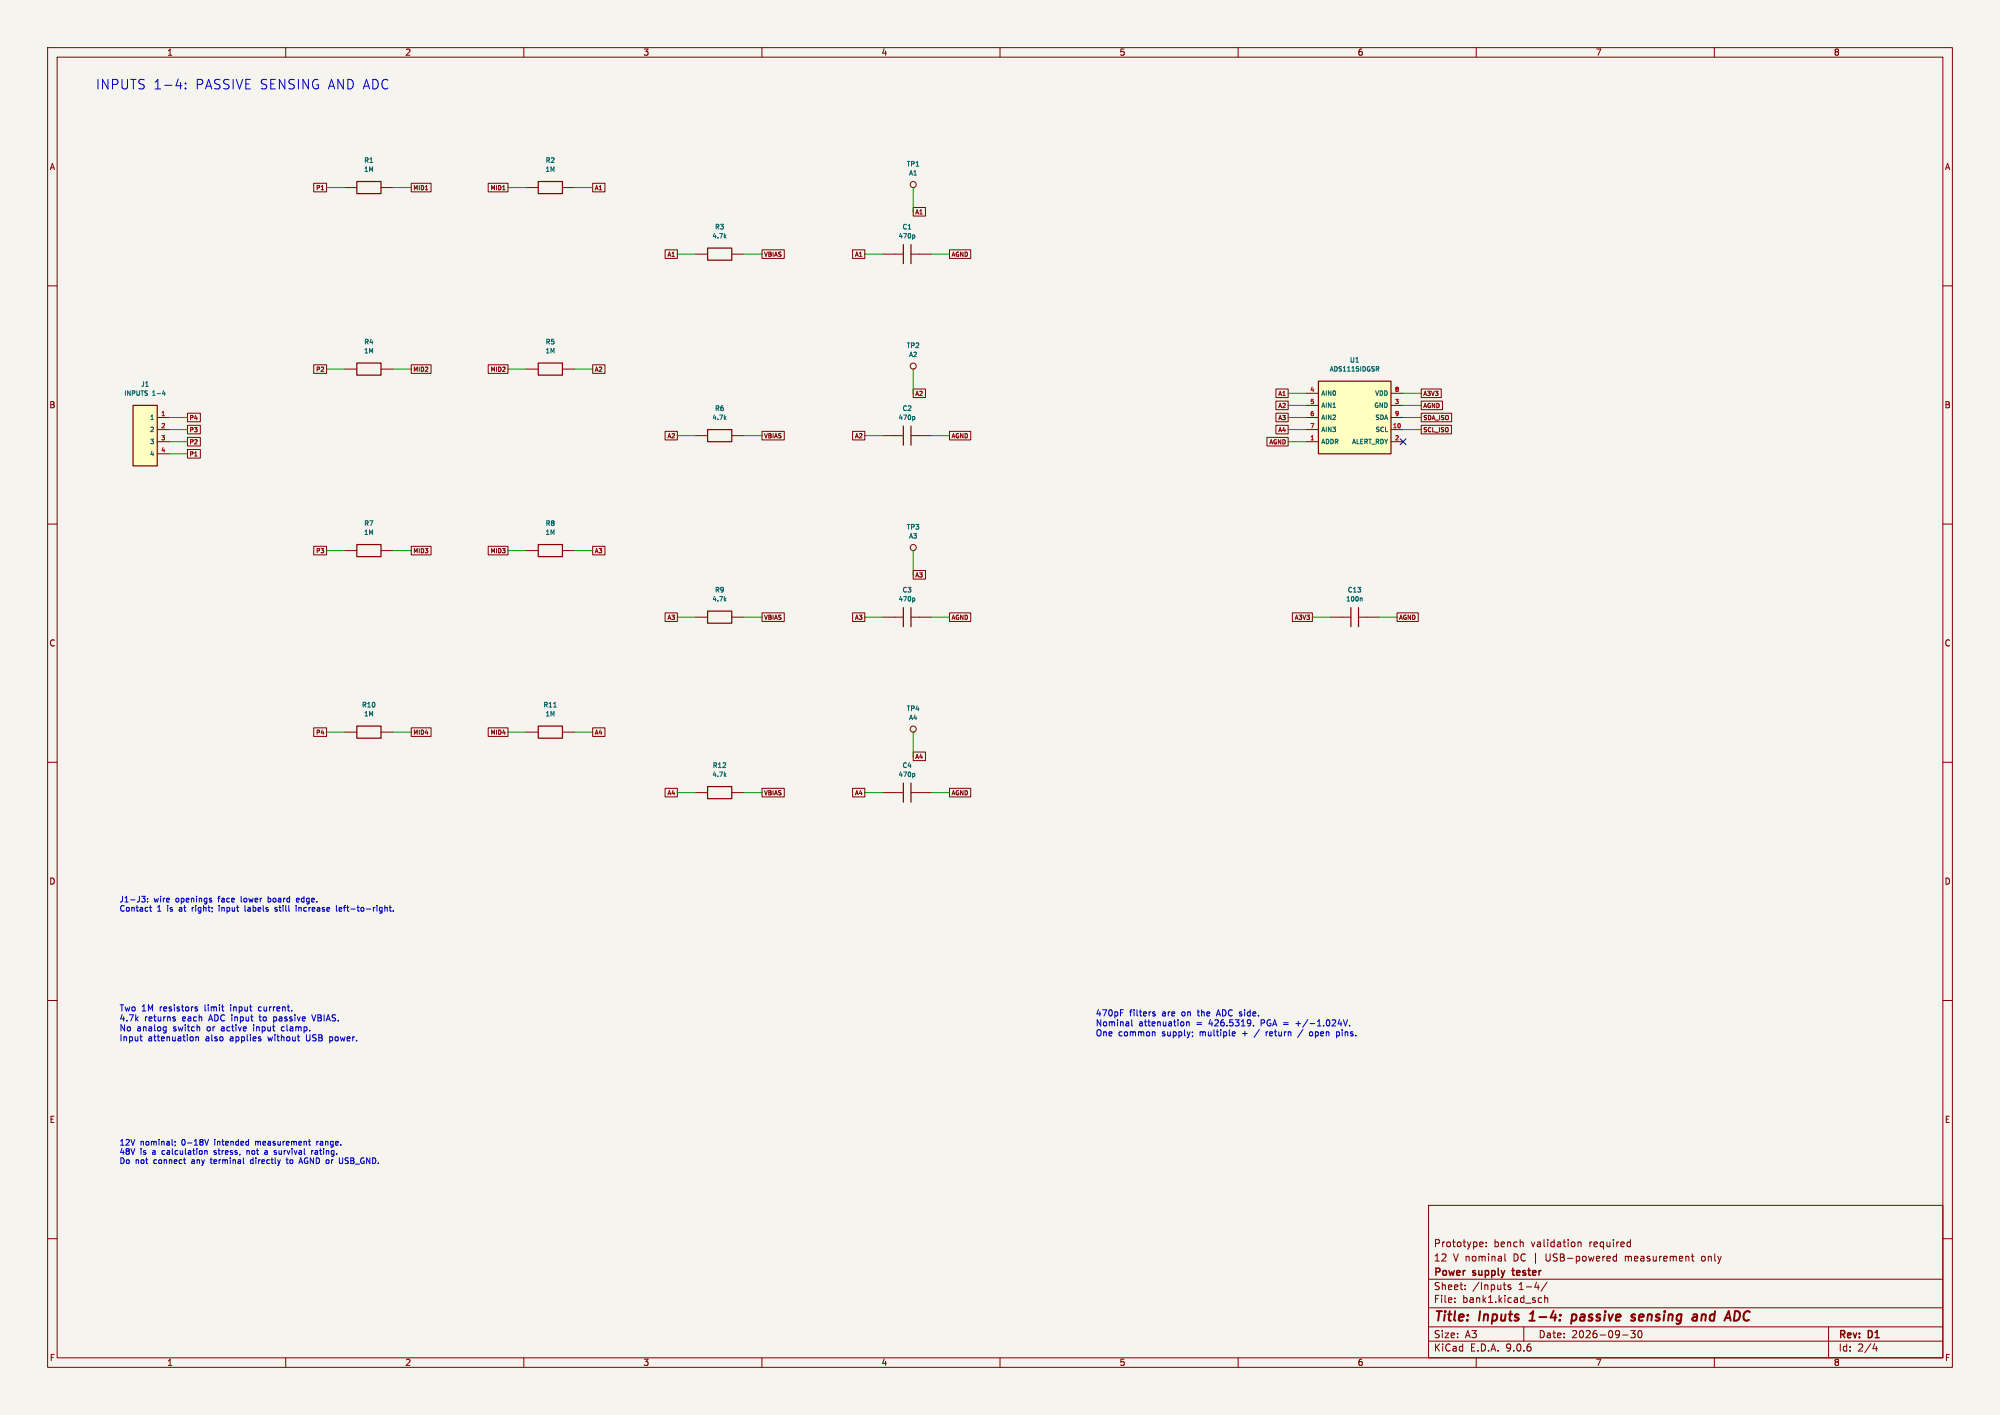
[picture p196: page 2]

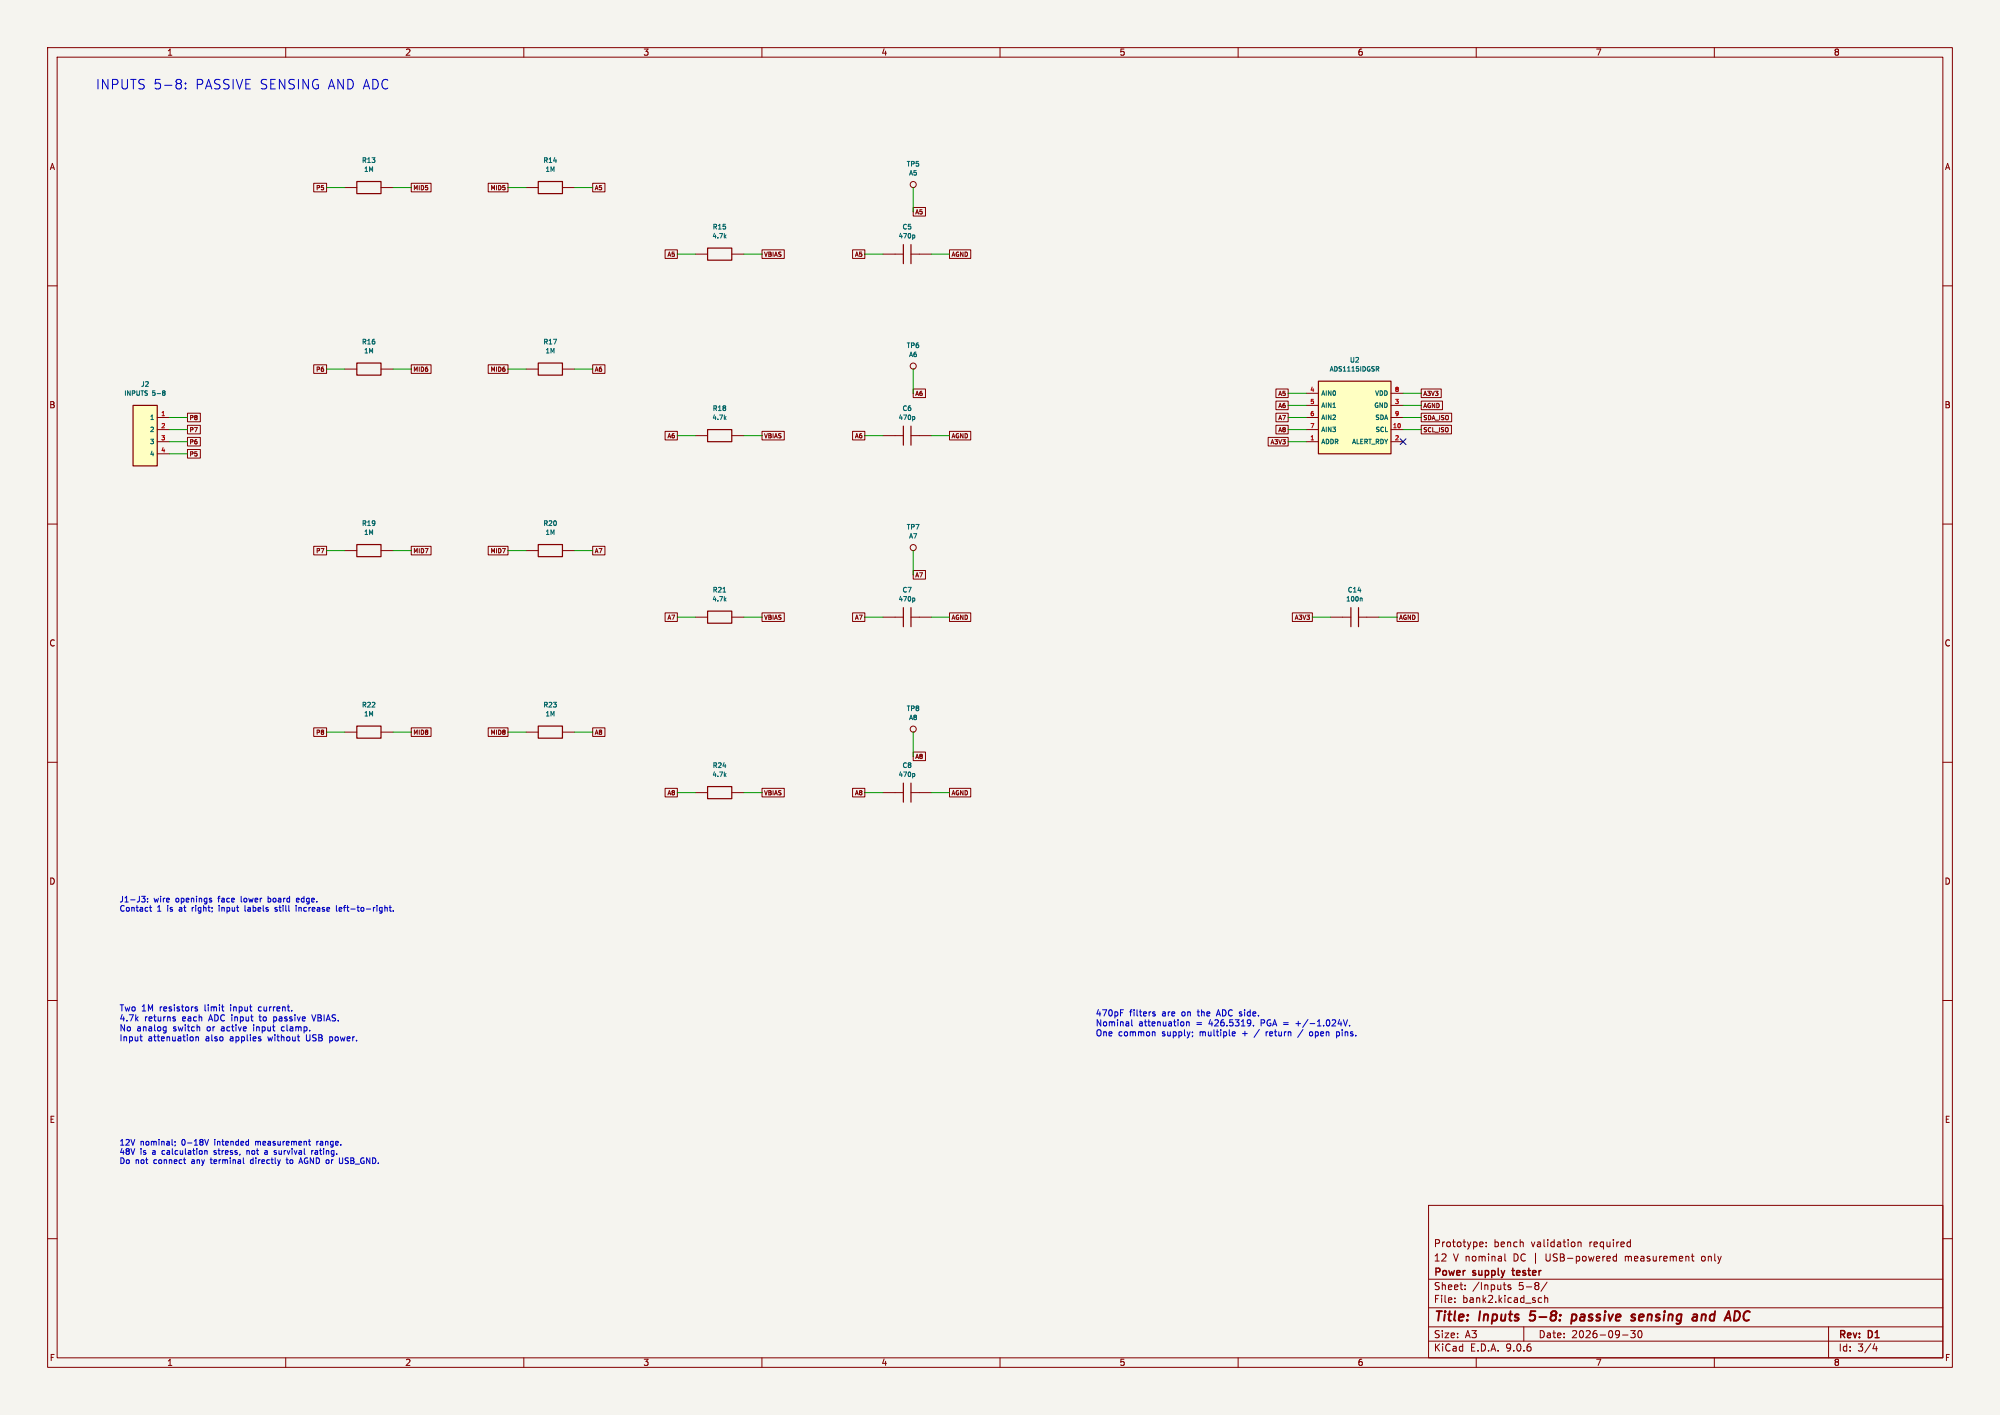
[picture p197: page 3]

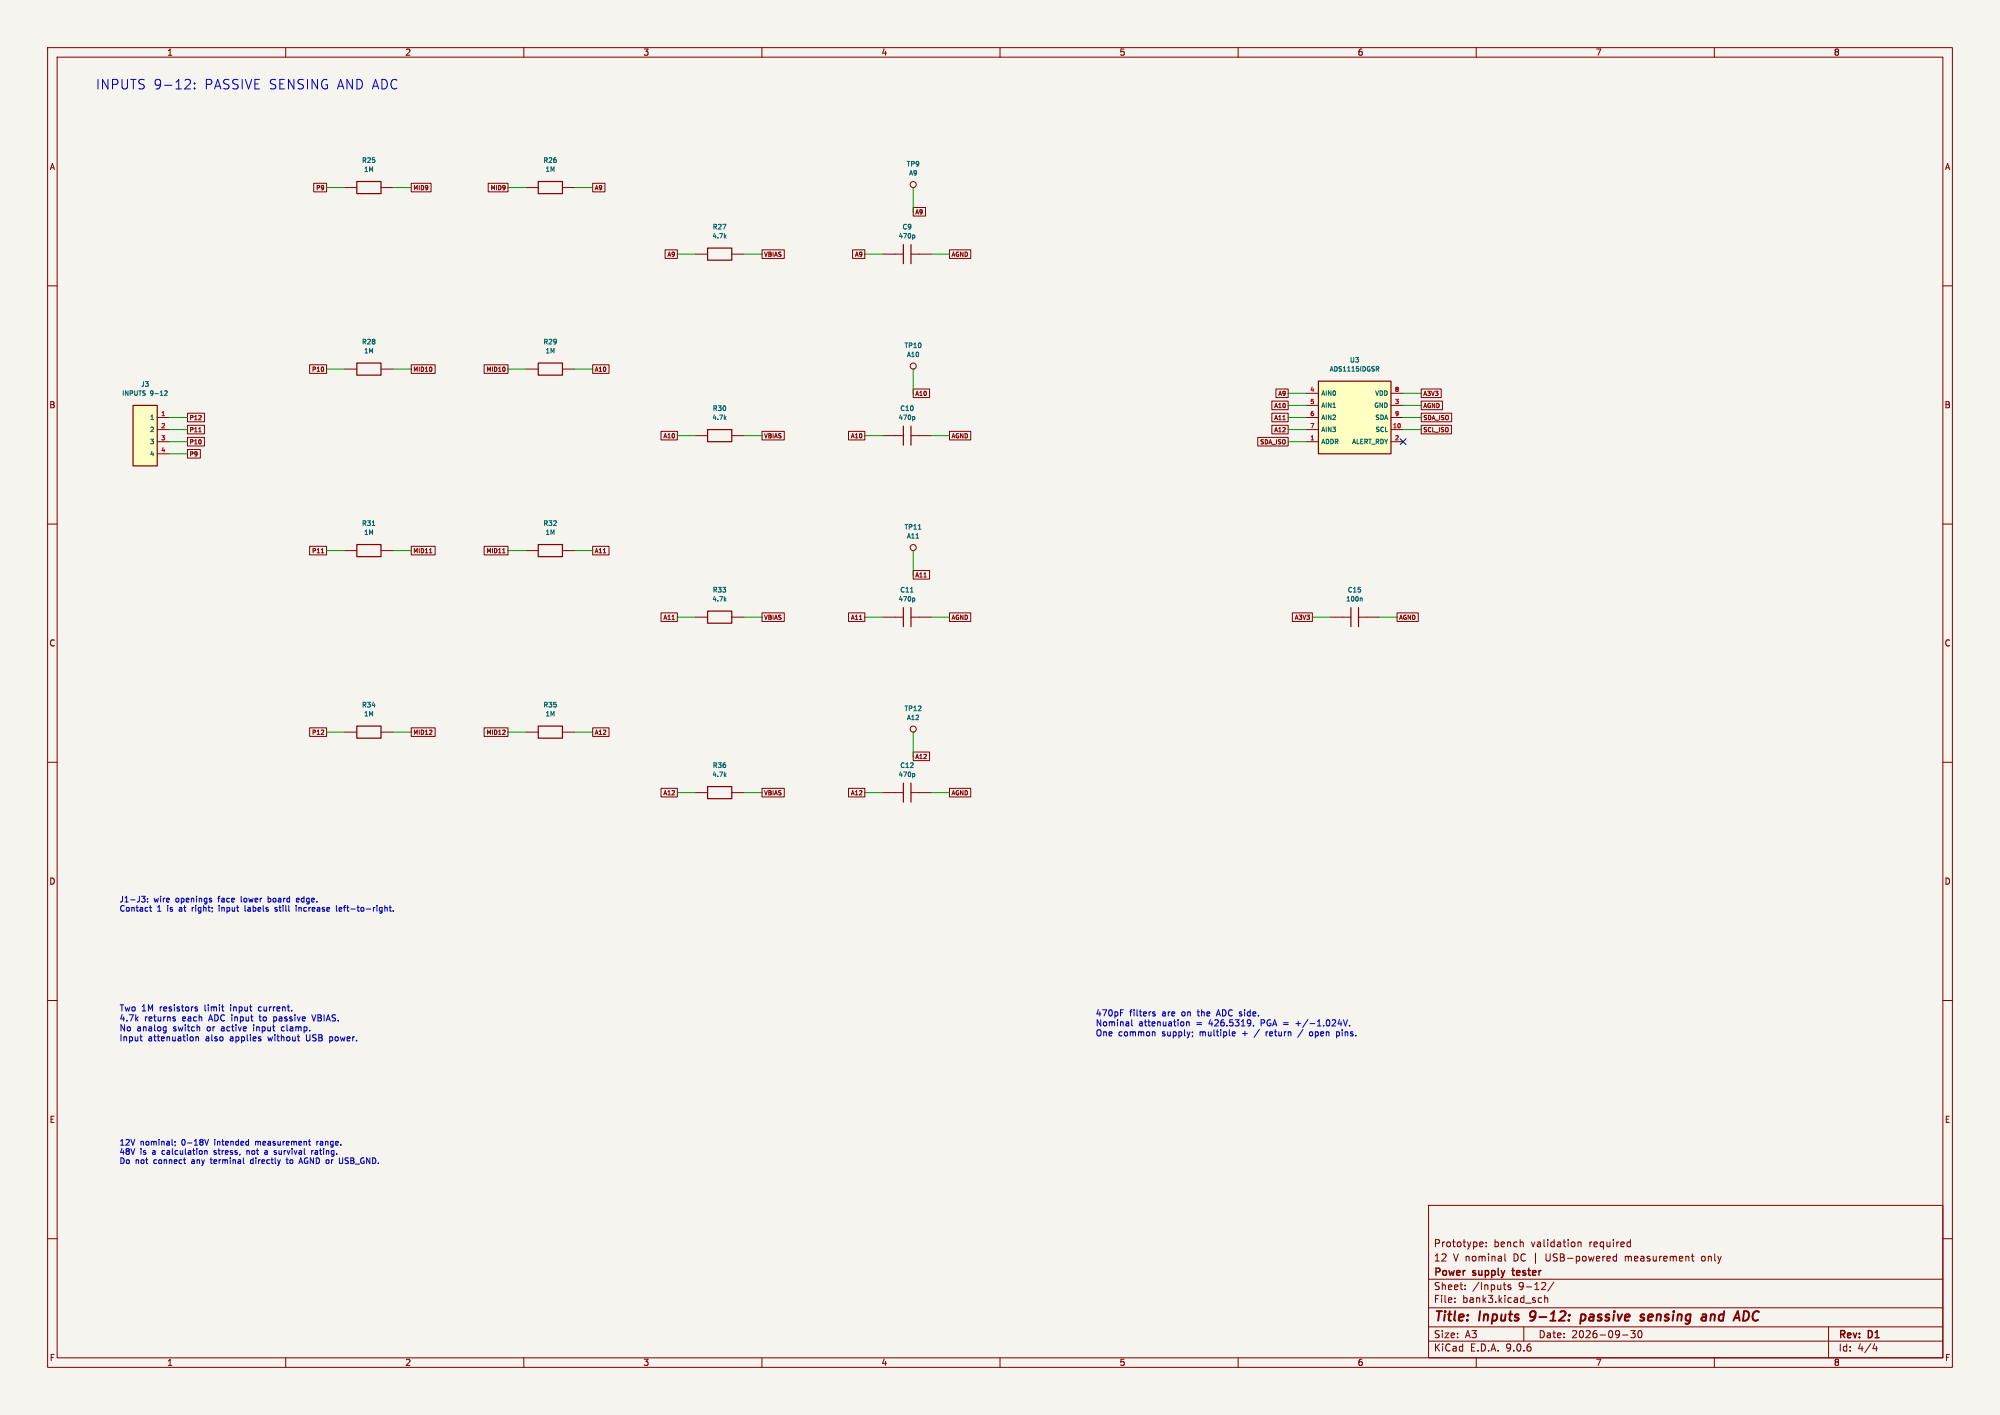
[picture p198: page 4]
