PetterGustafsson/power-supply-tester/hardware/tester12v-rev-d2-engineering-package/hardware/rev-d/previews/assembly.pdf

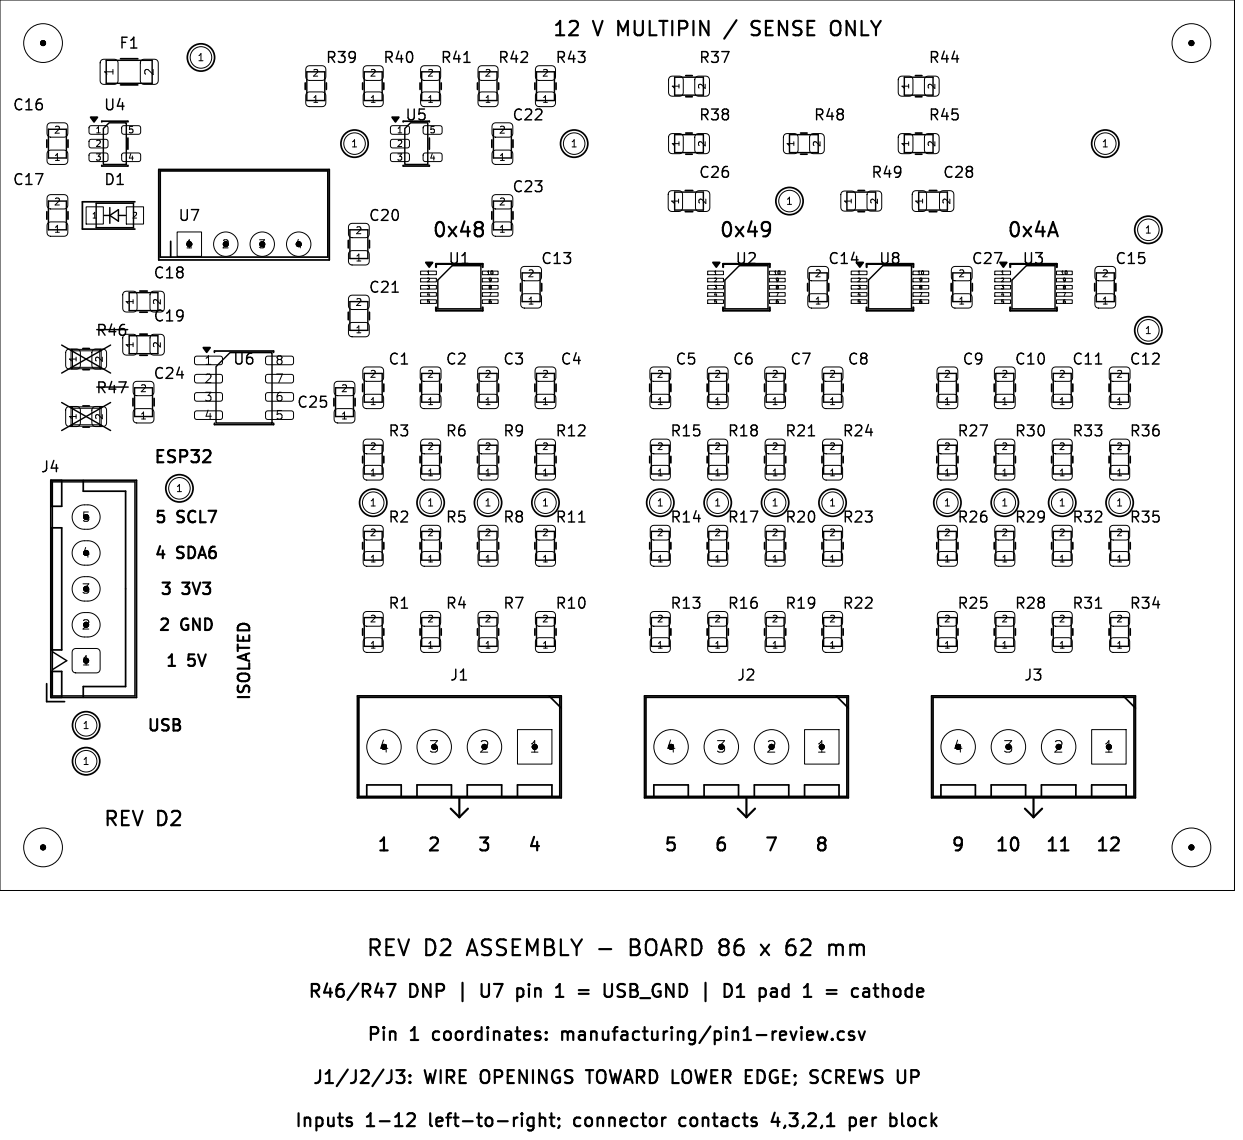
[picture p199: page 1]
