PetterGustafsson/power-supply-tester/hardware/rev-a/previews/schematic.pdf

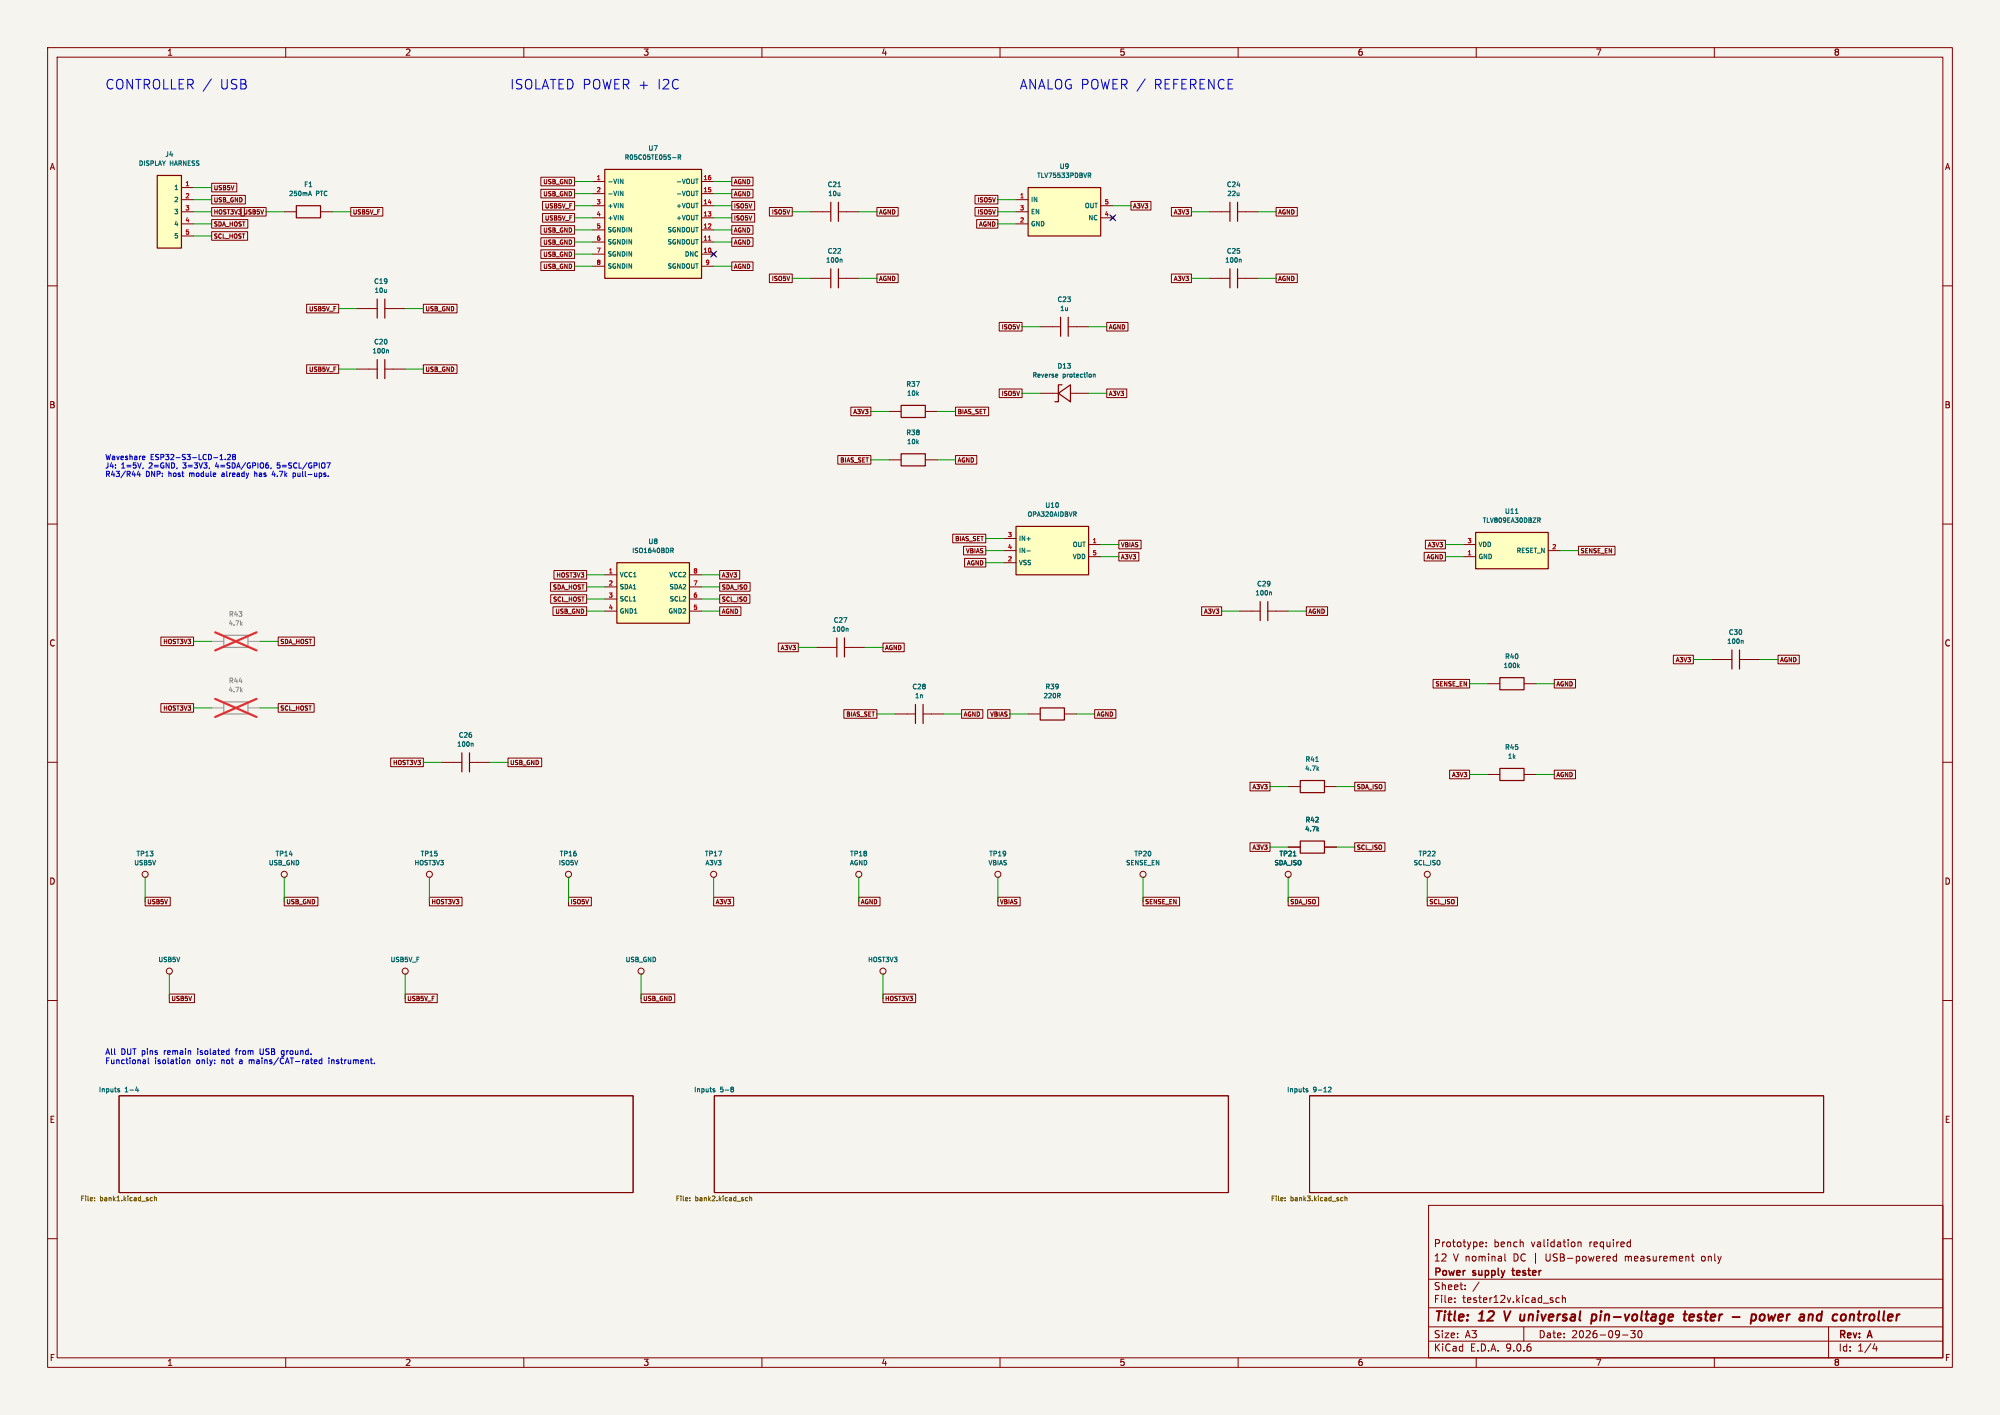
[picture p200: page 1]

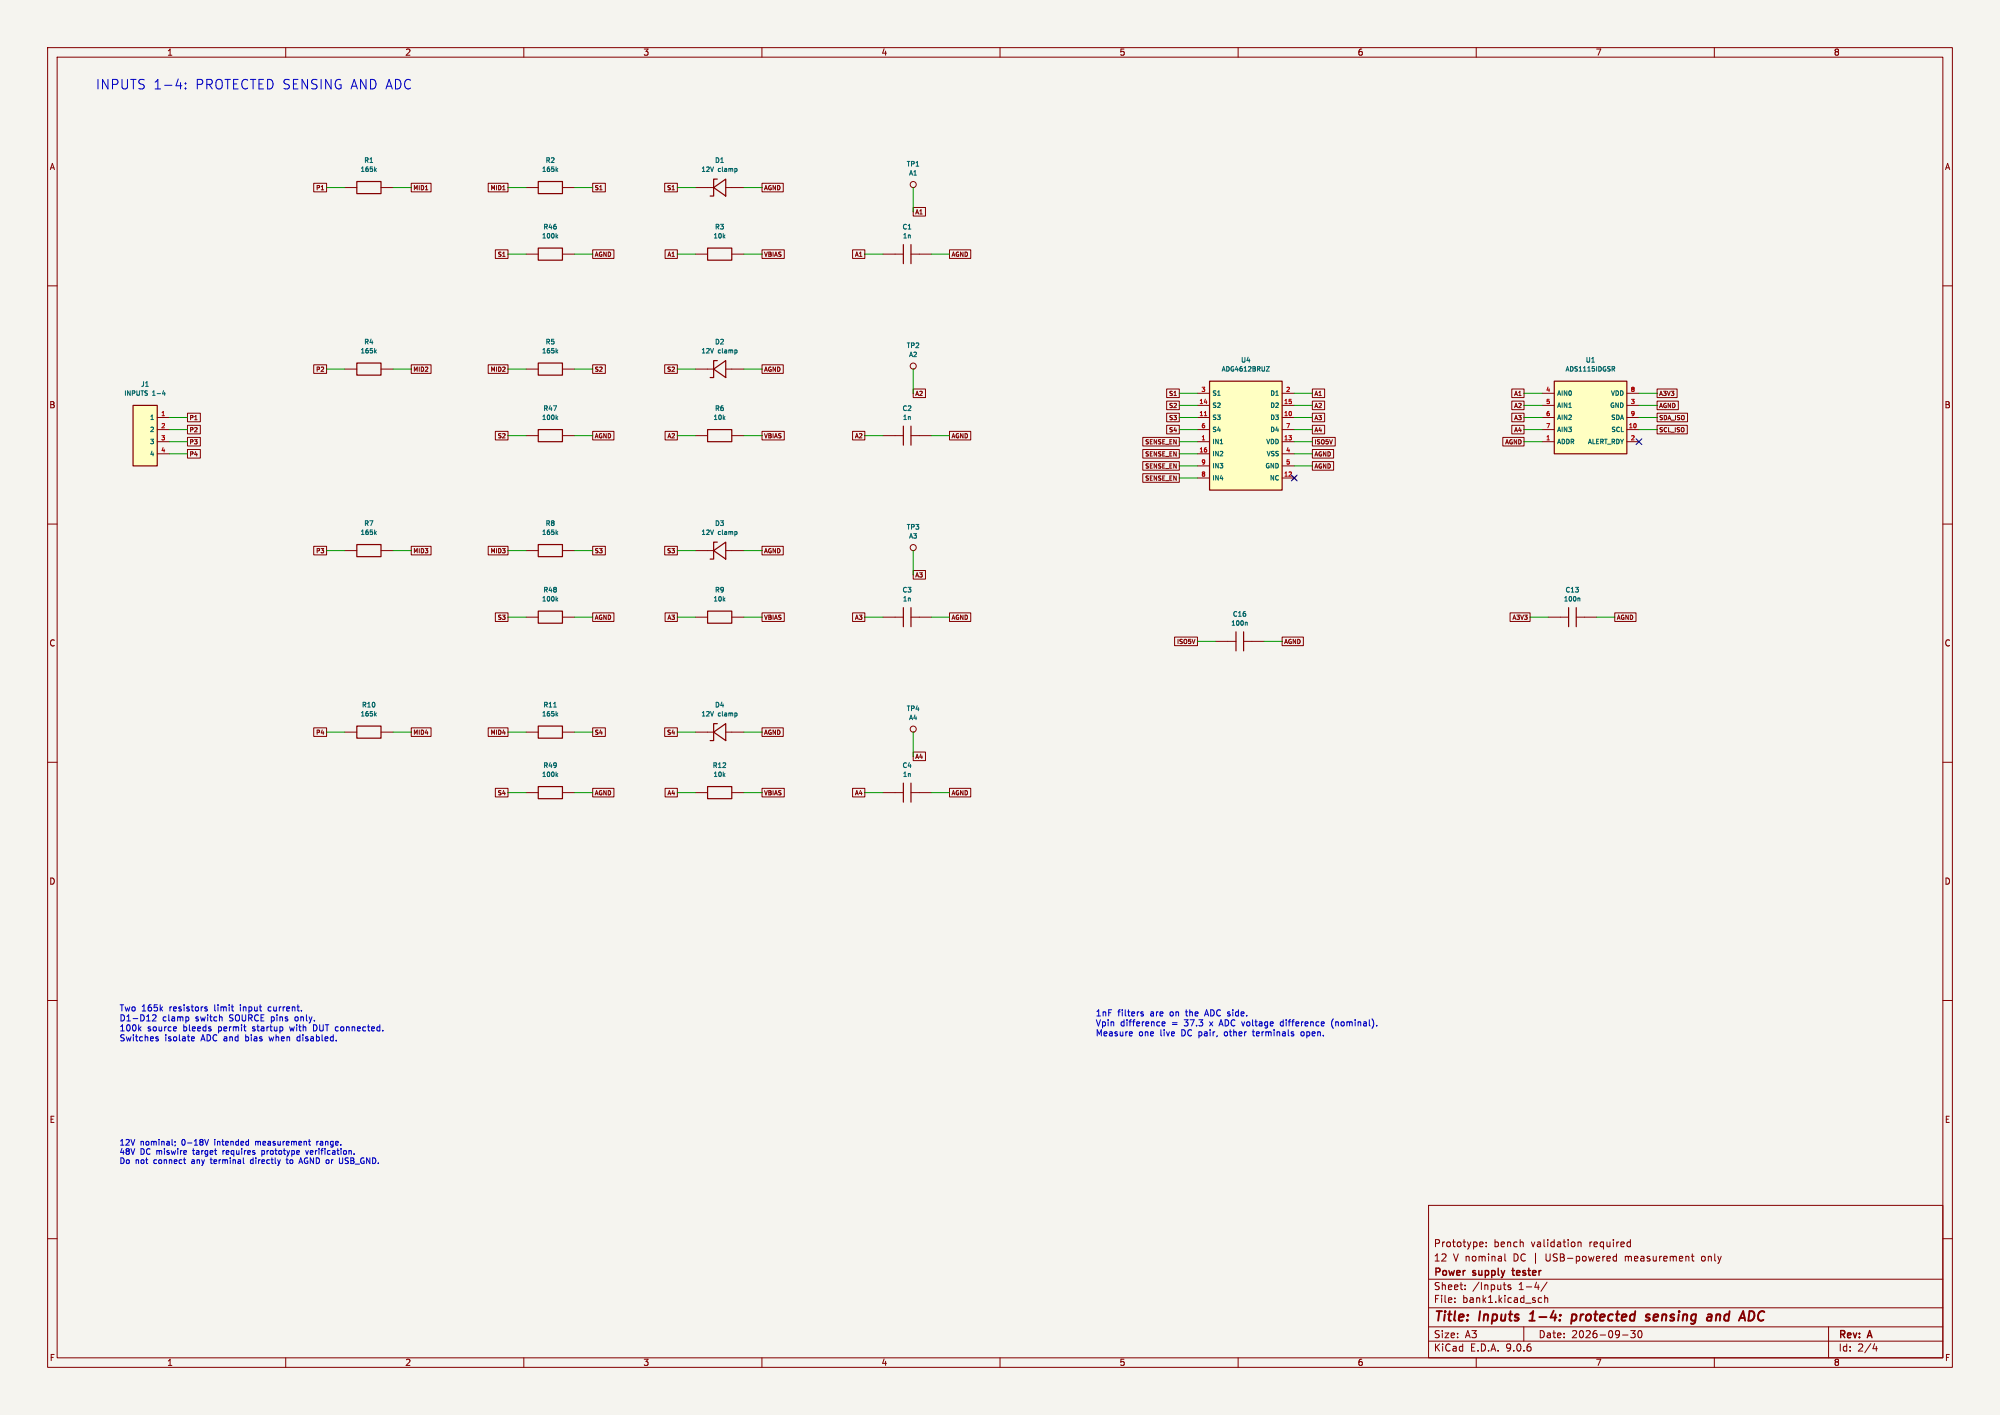
[picture p201: page 2]

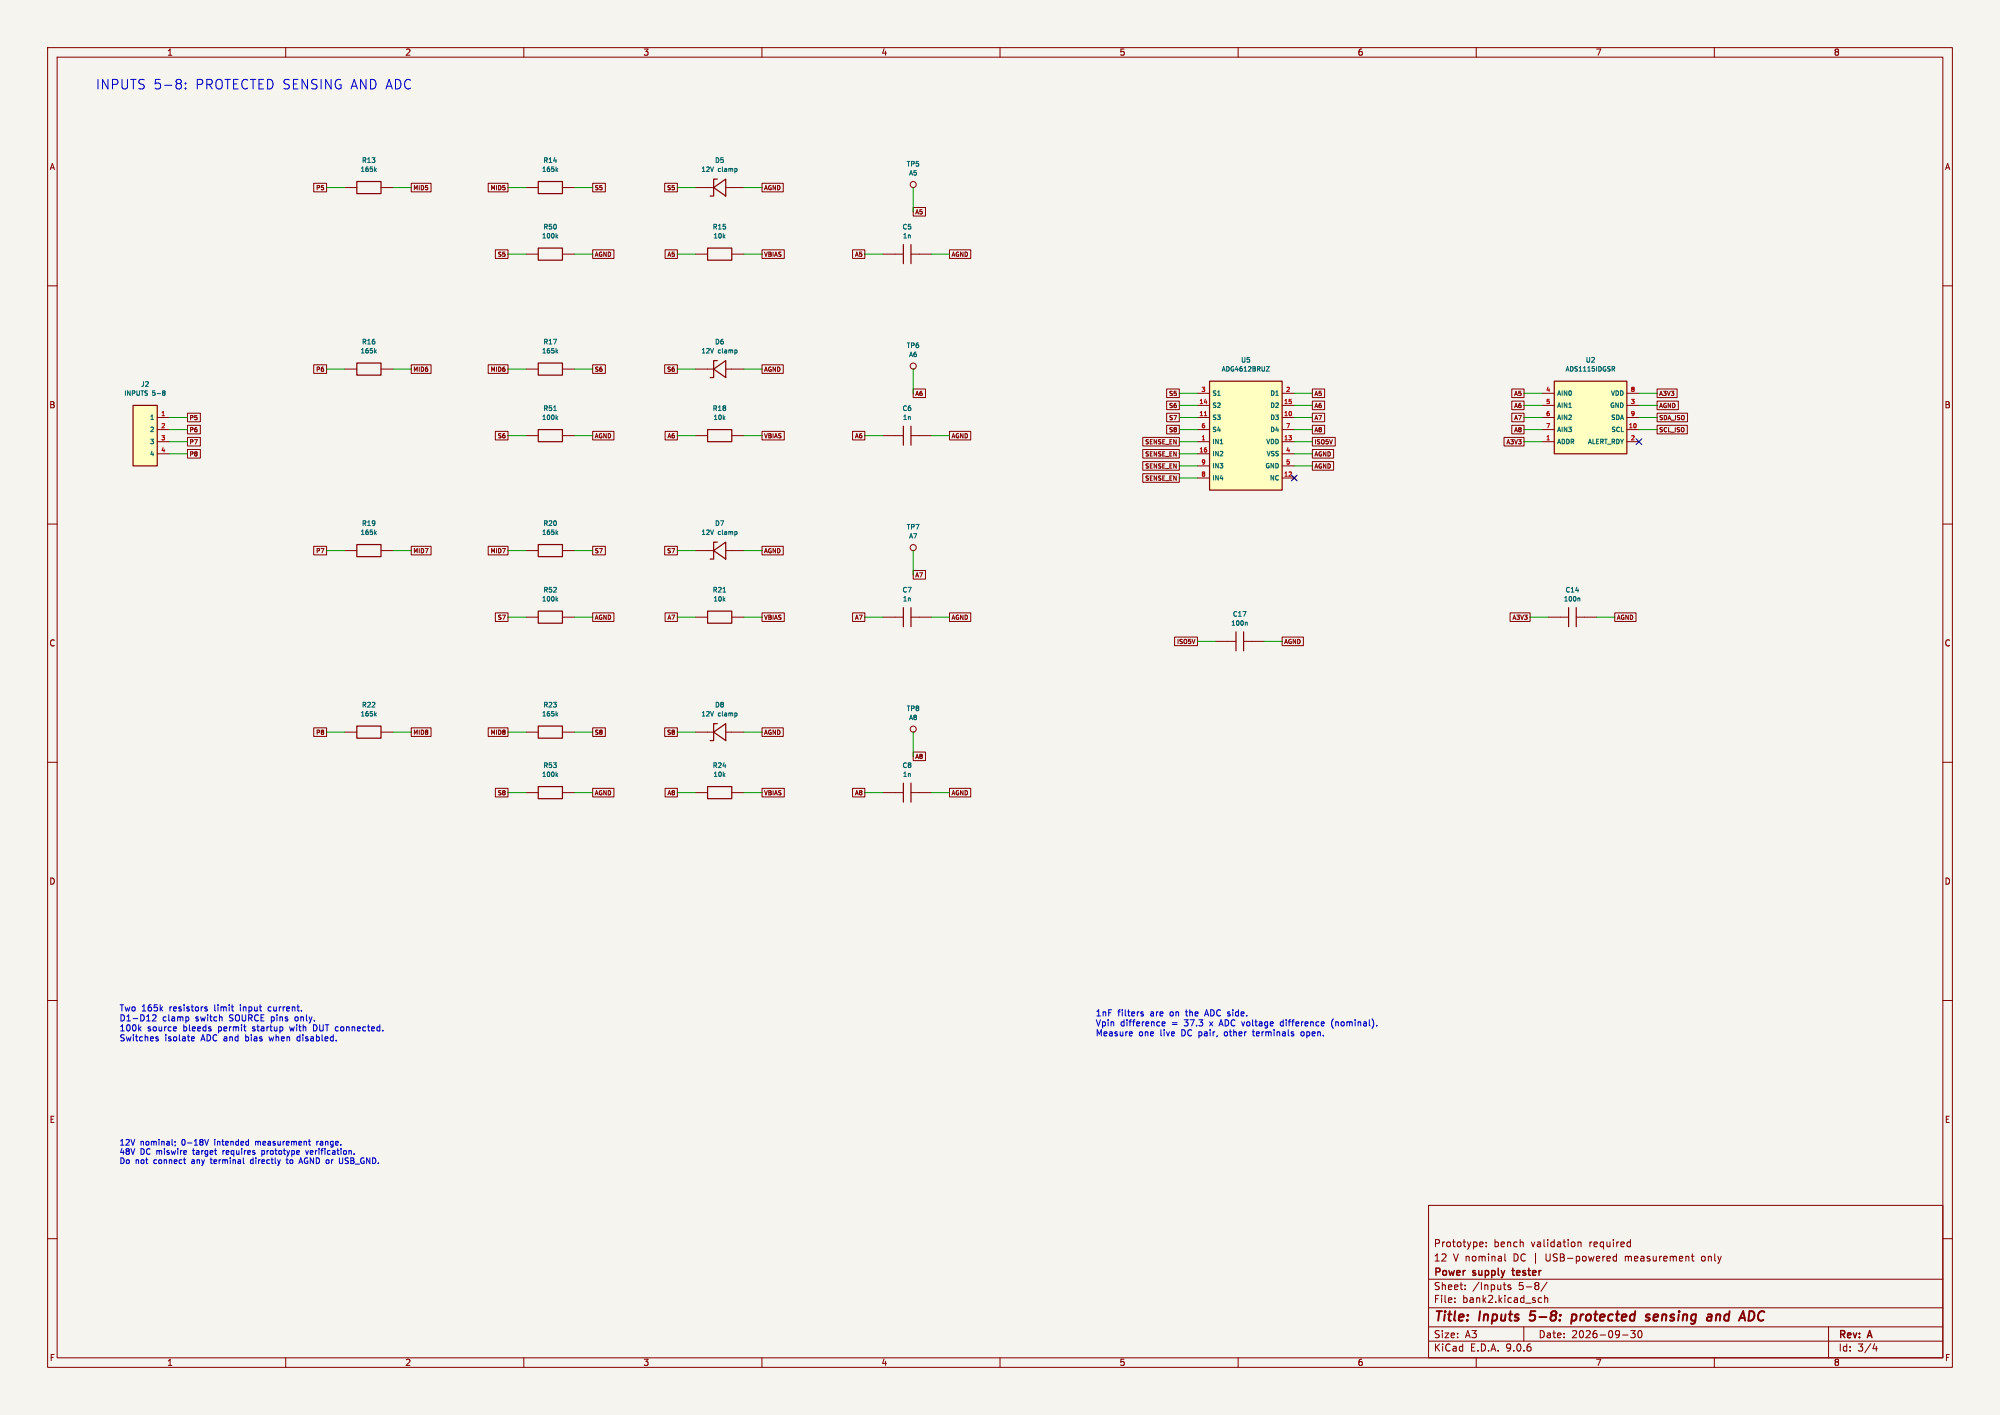
[picture p202: page 3]

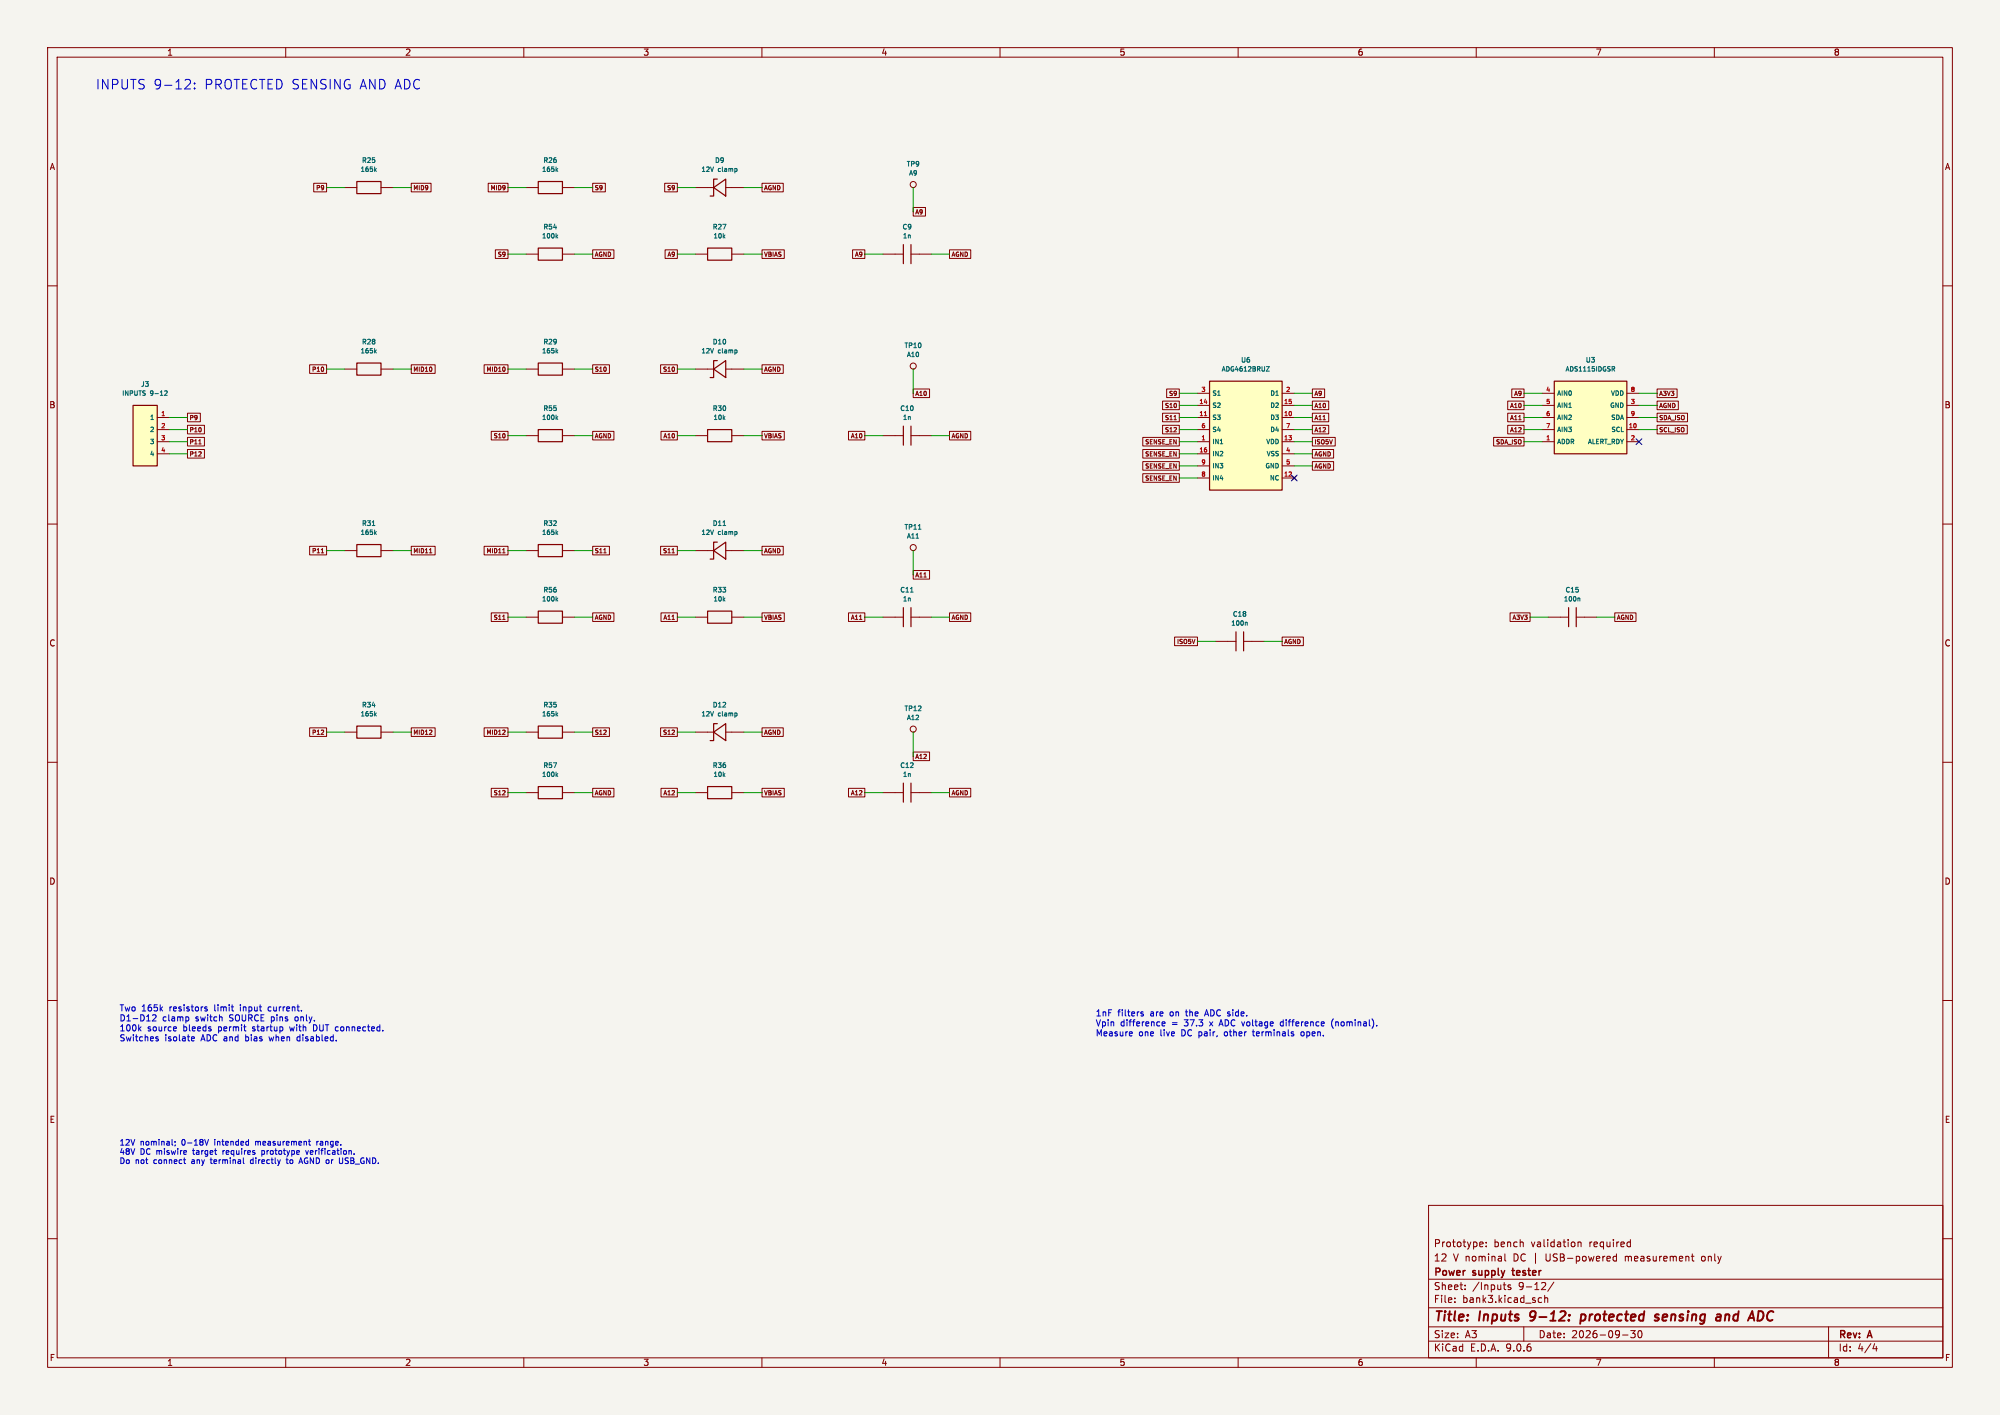
[picture p203: page 4]
