PetterGustafsson/power-supply-tester/hardware/rev-b/previews/assembly.pdf

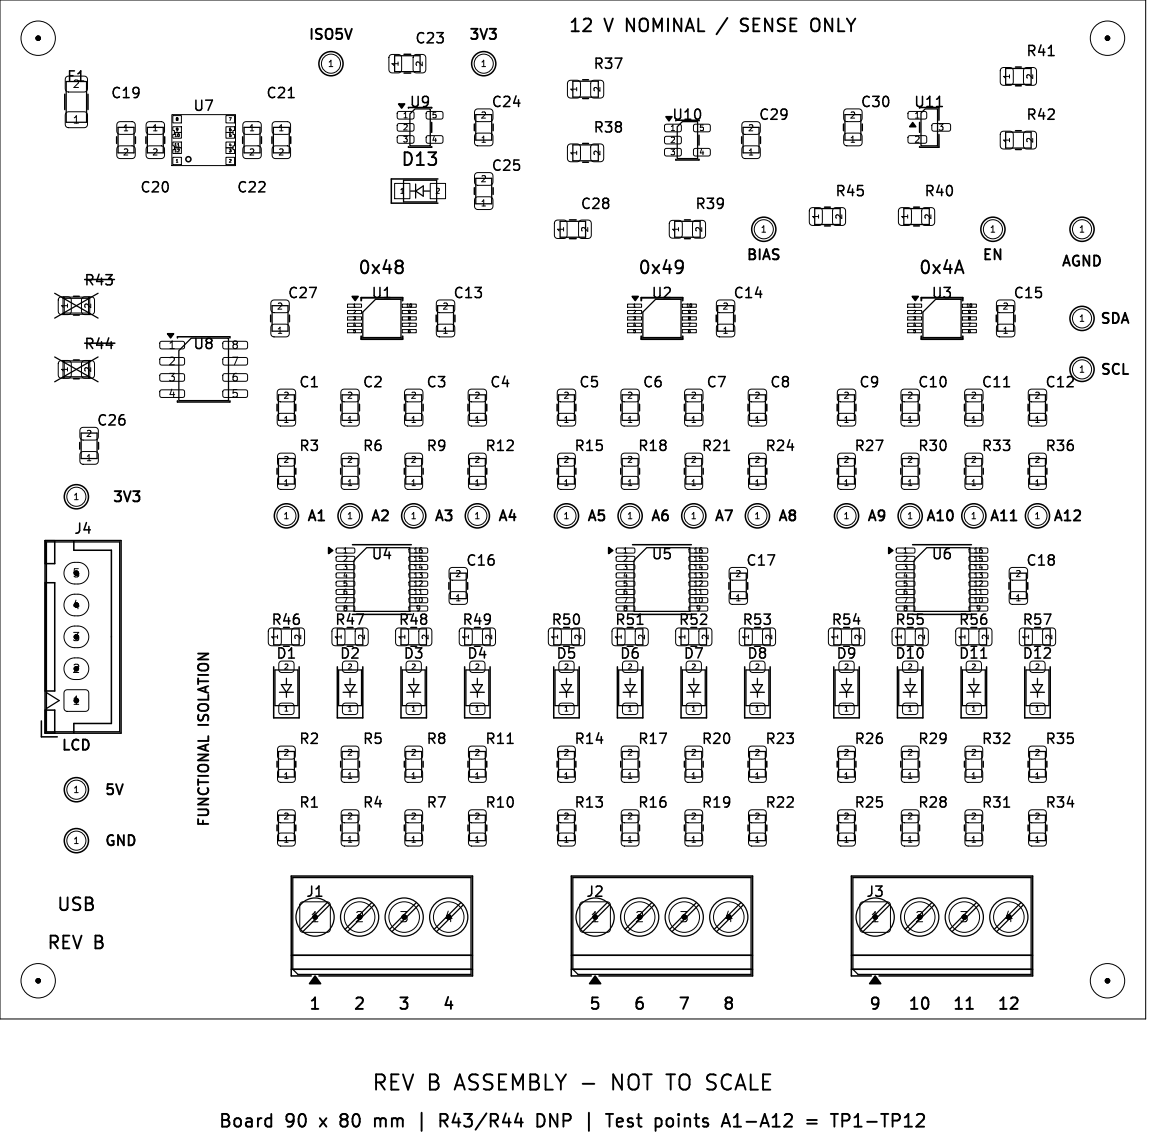
[picture p204: page 1]
