PetterGustafsson/power-supply-tester/hardware/rev-d/previews/schematic.pdf

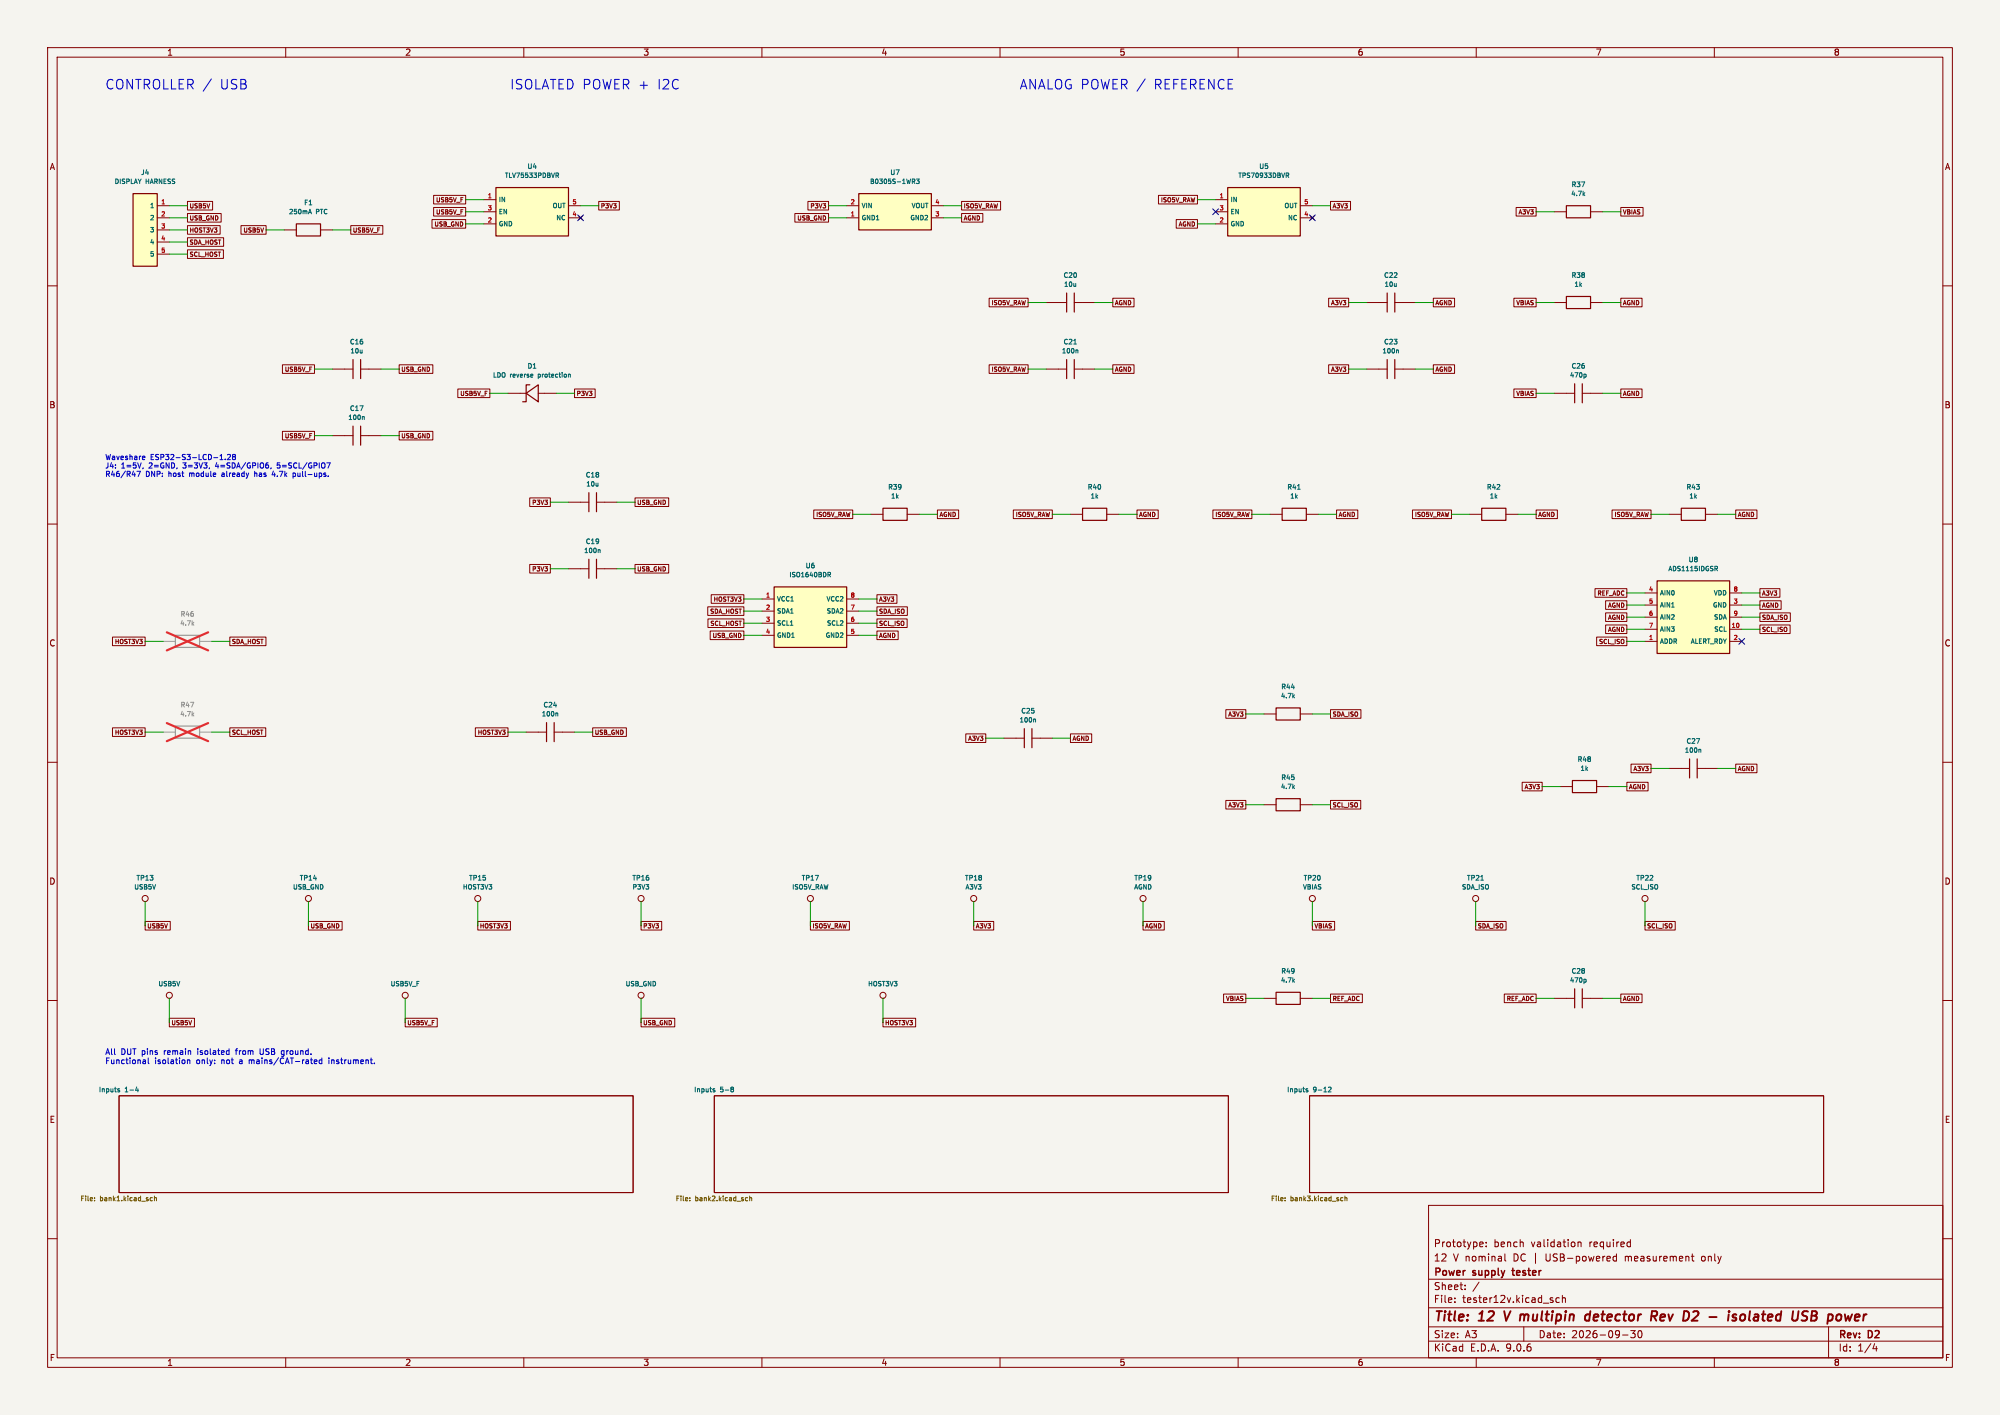
[picture p205: page 1]

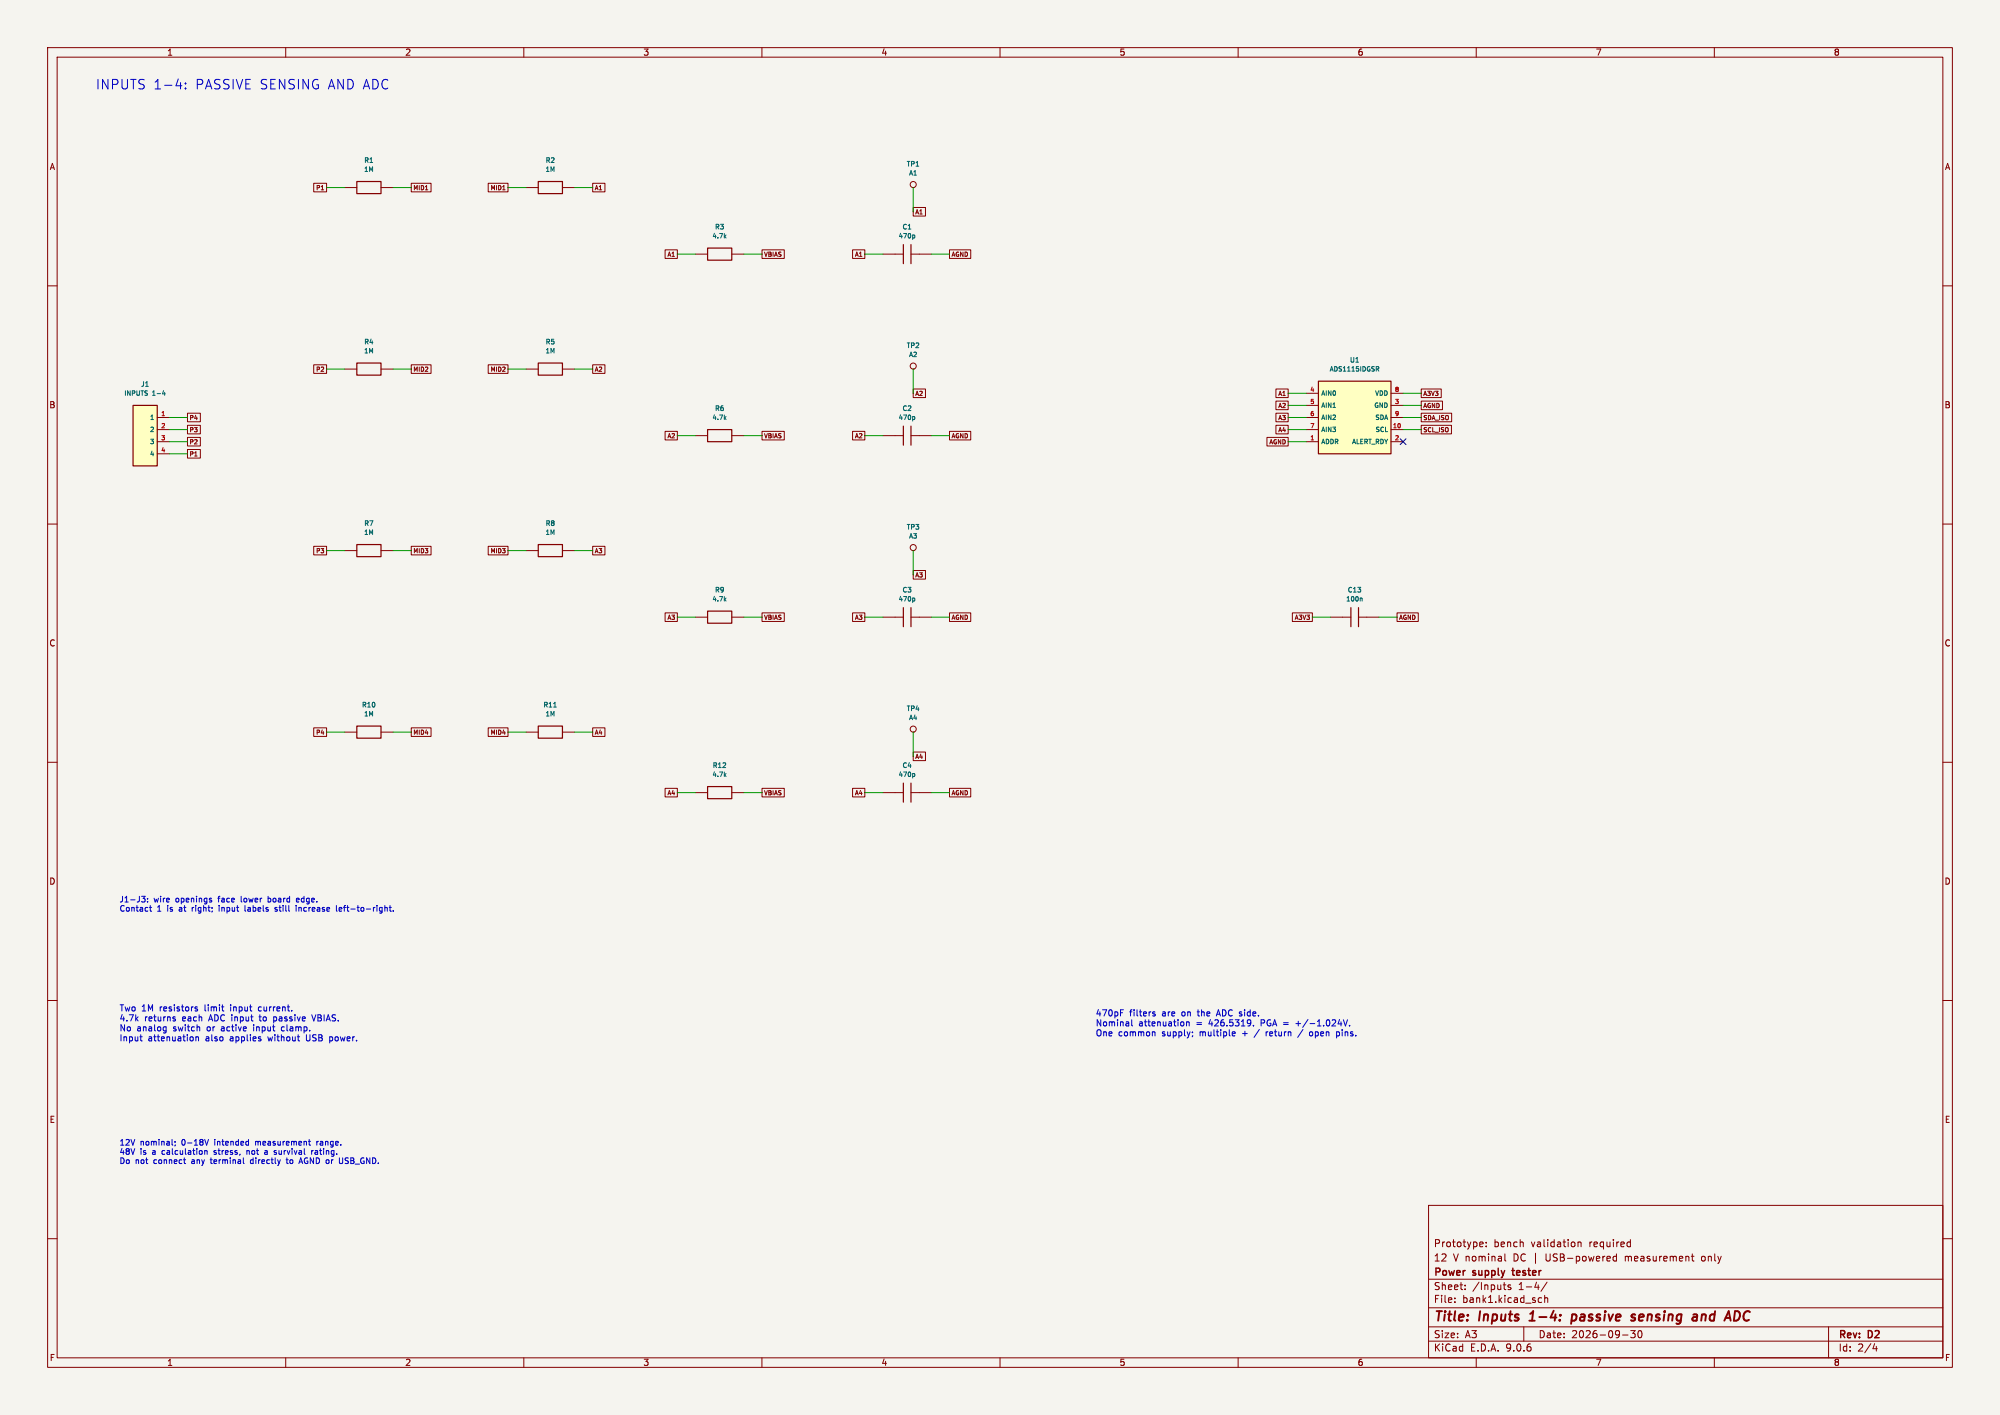
[picture p206: page 2]

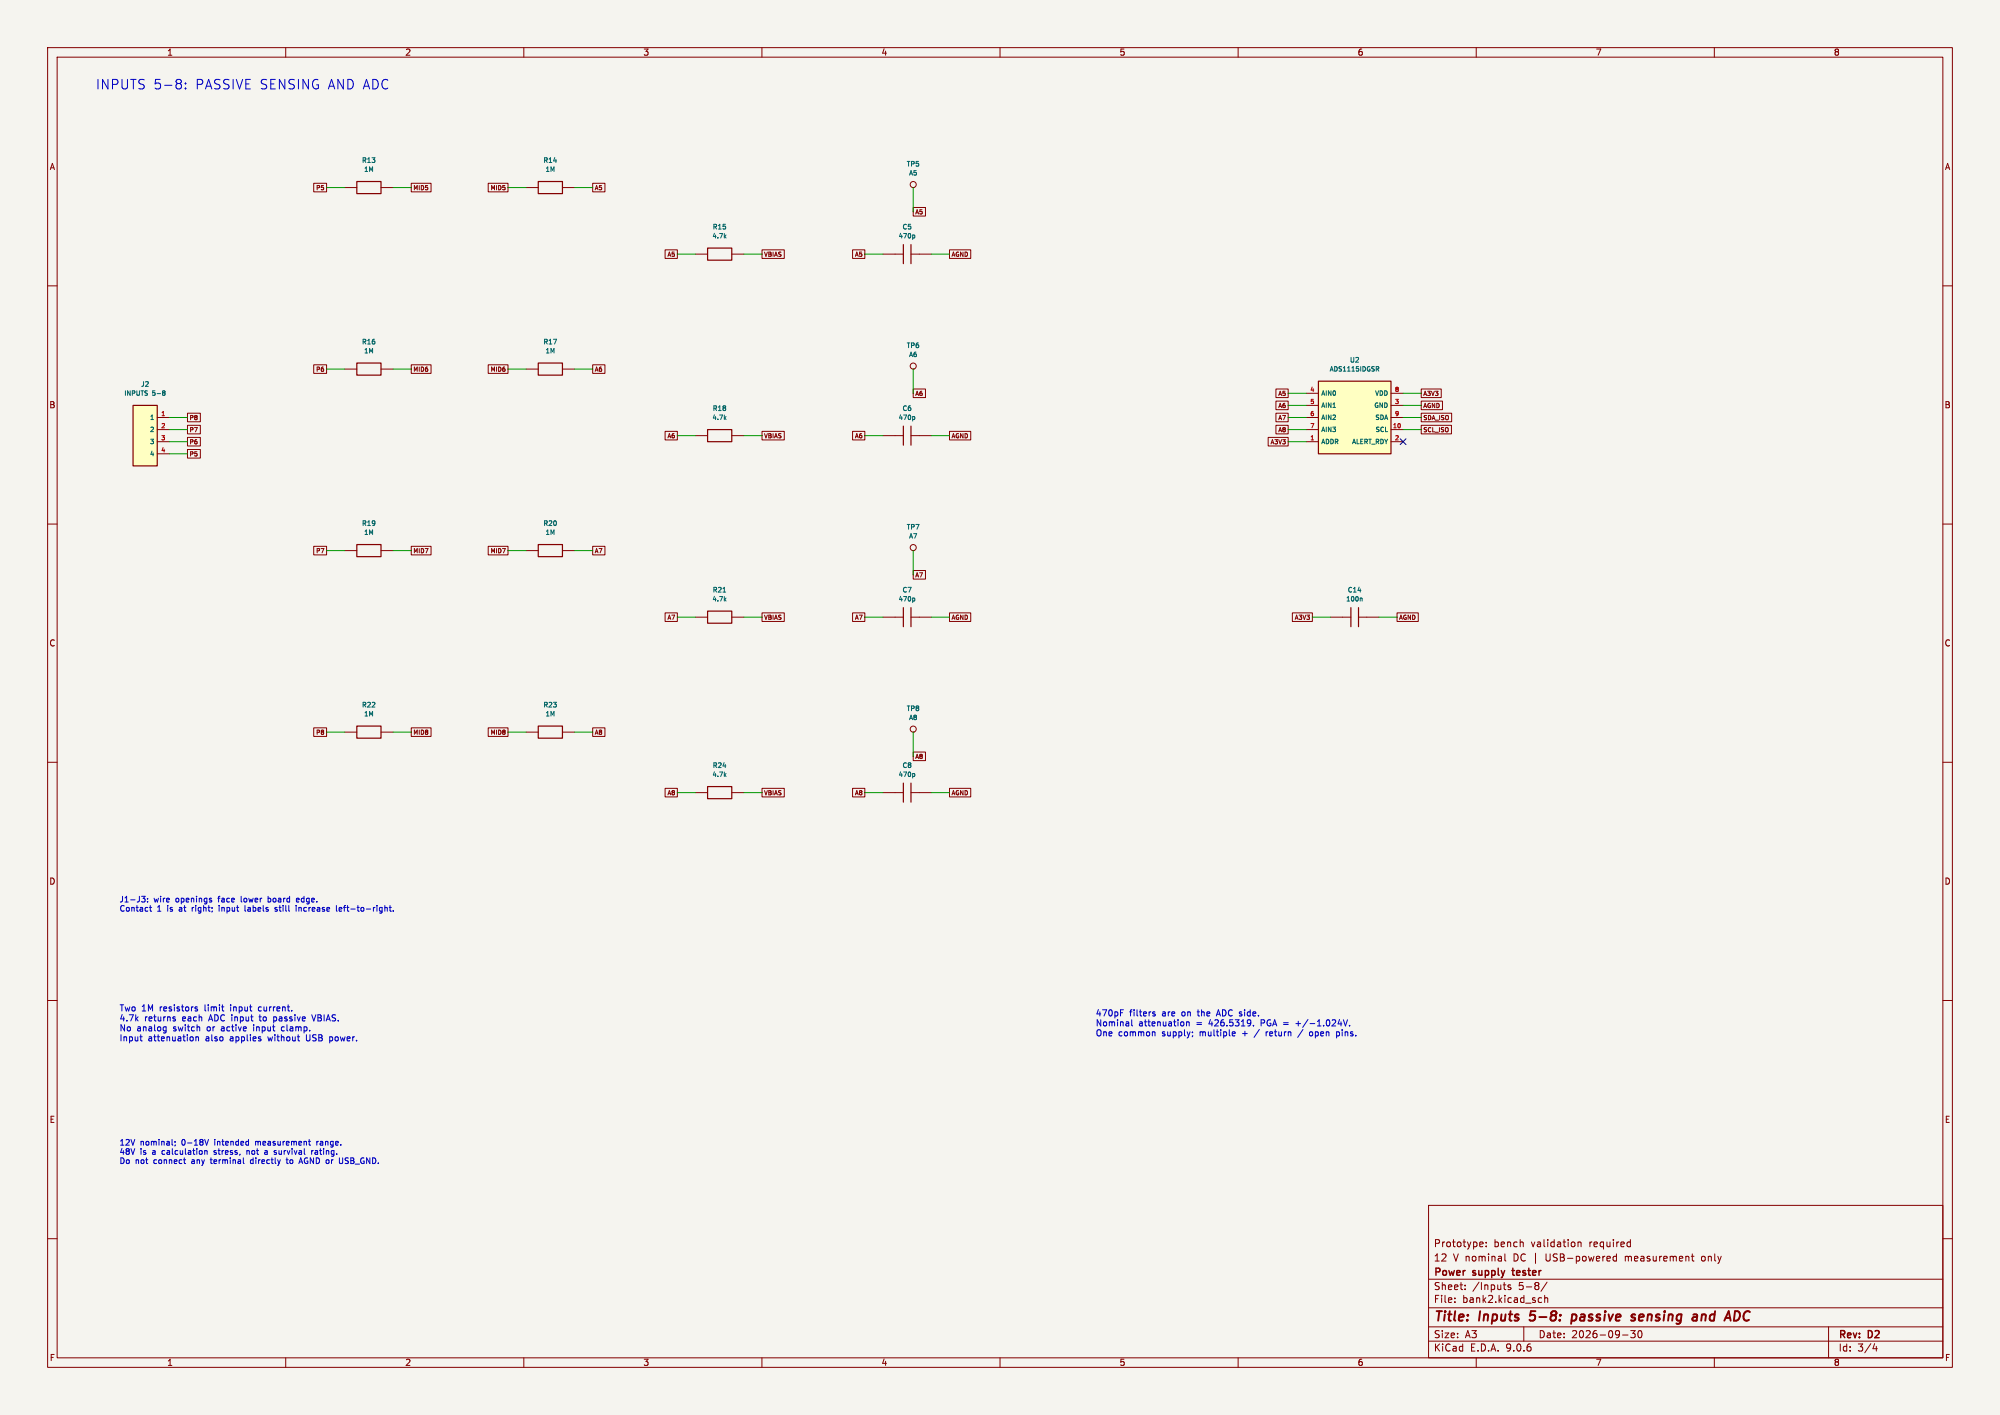
[picture p207: page 3]

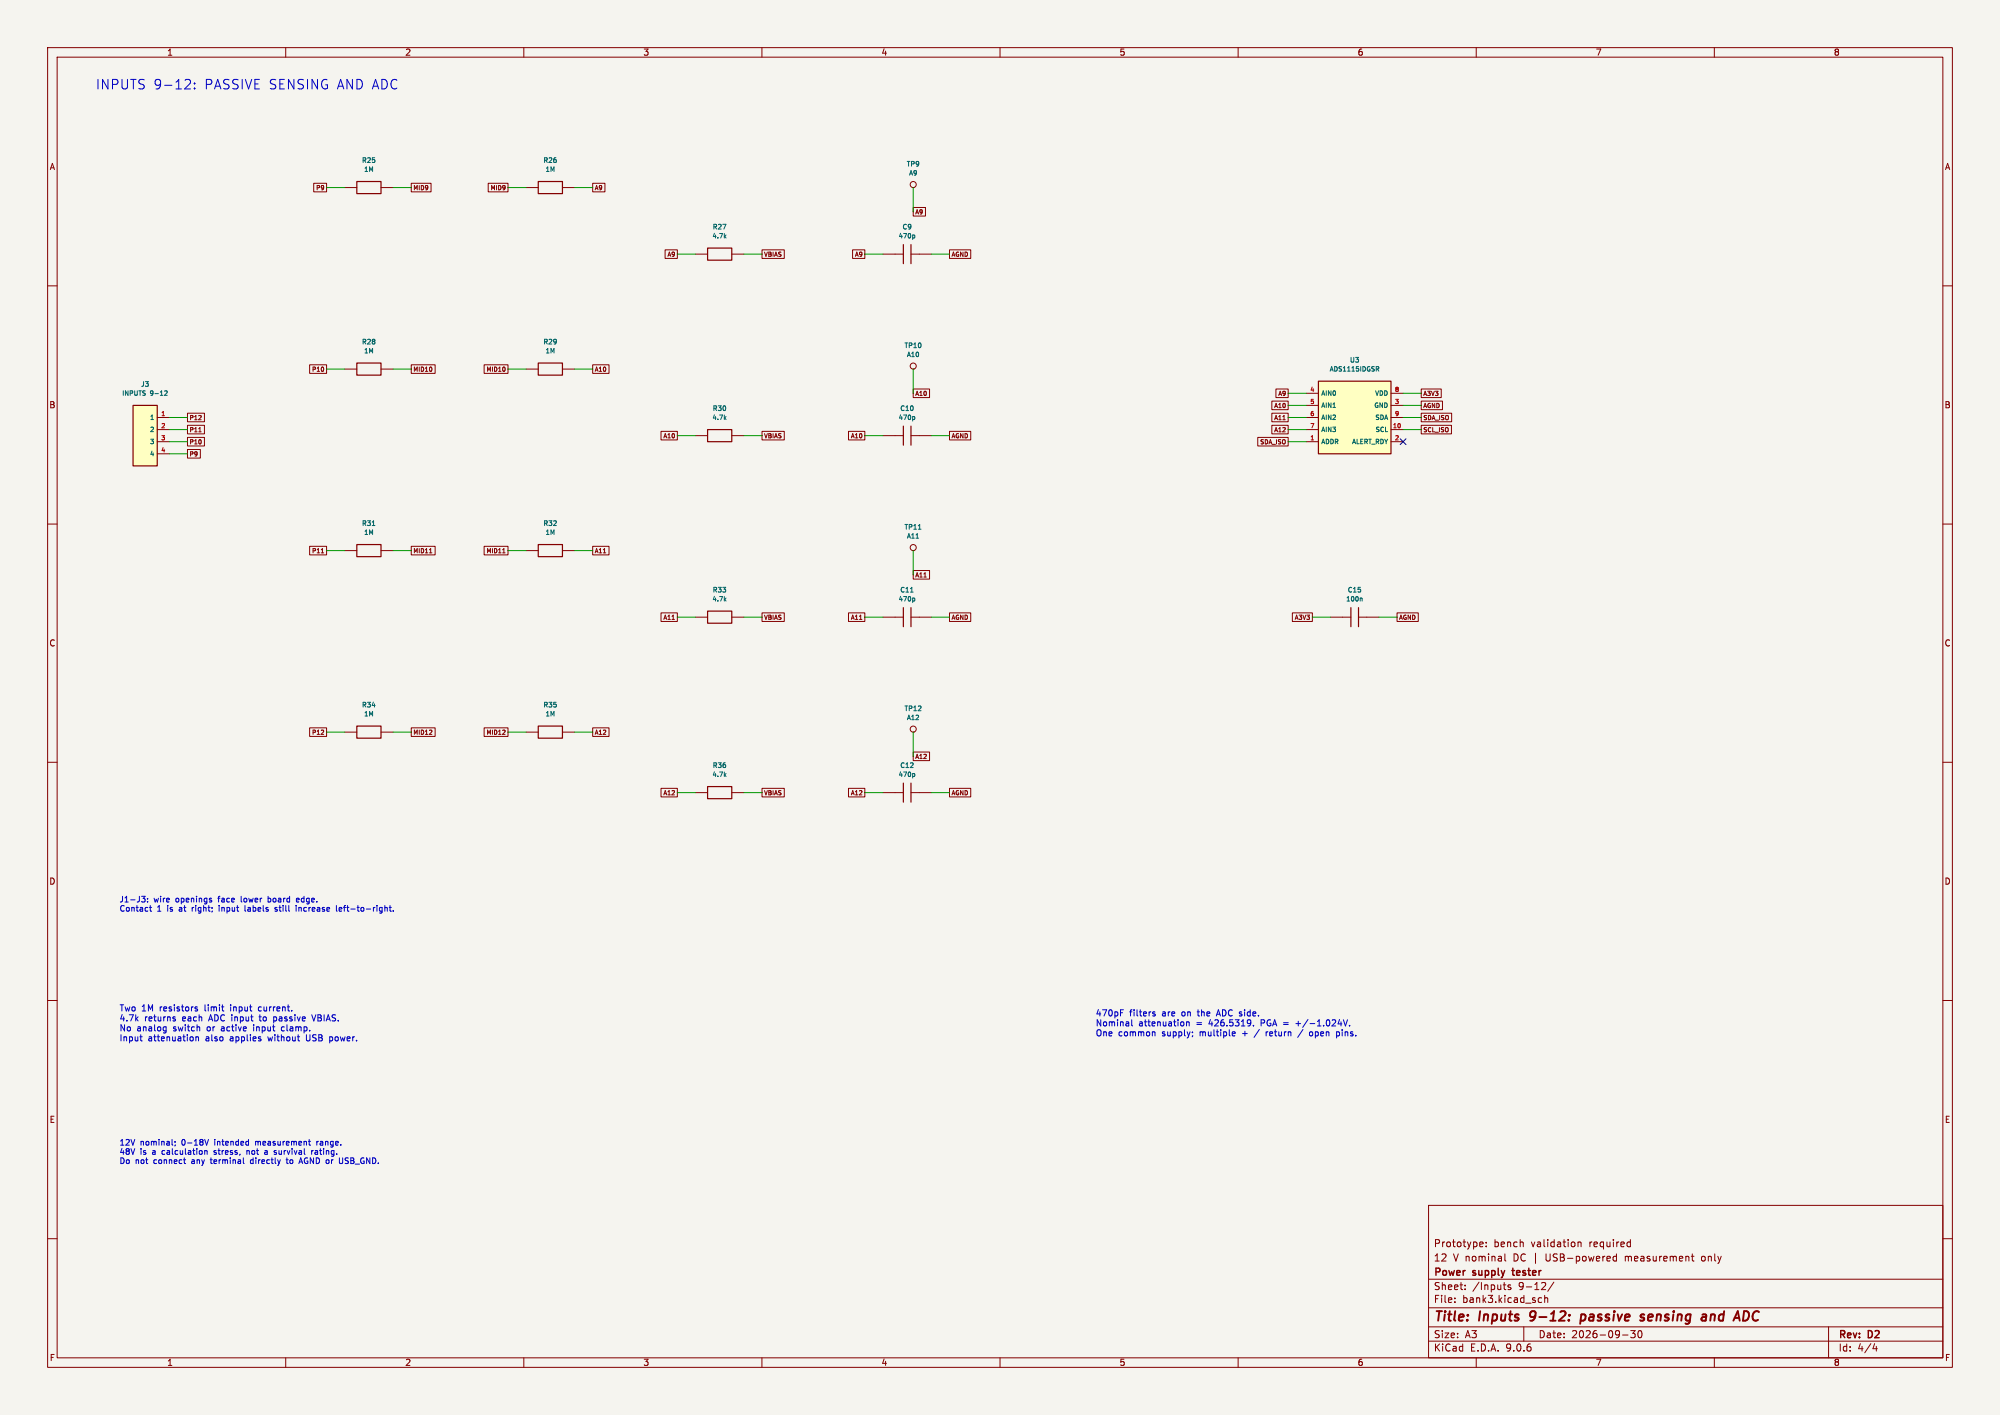
[picture p208: page 4]
