PetterGustafsson/power-supply-tester/hardware/tester12v-rev-a-jlc-order/reference/assembly.pdf

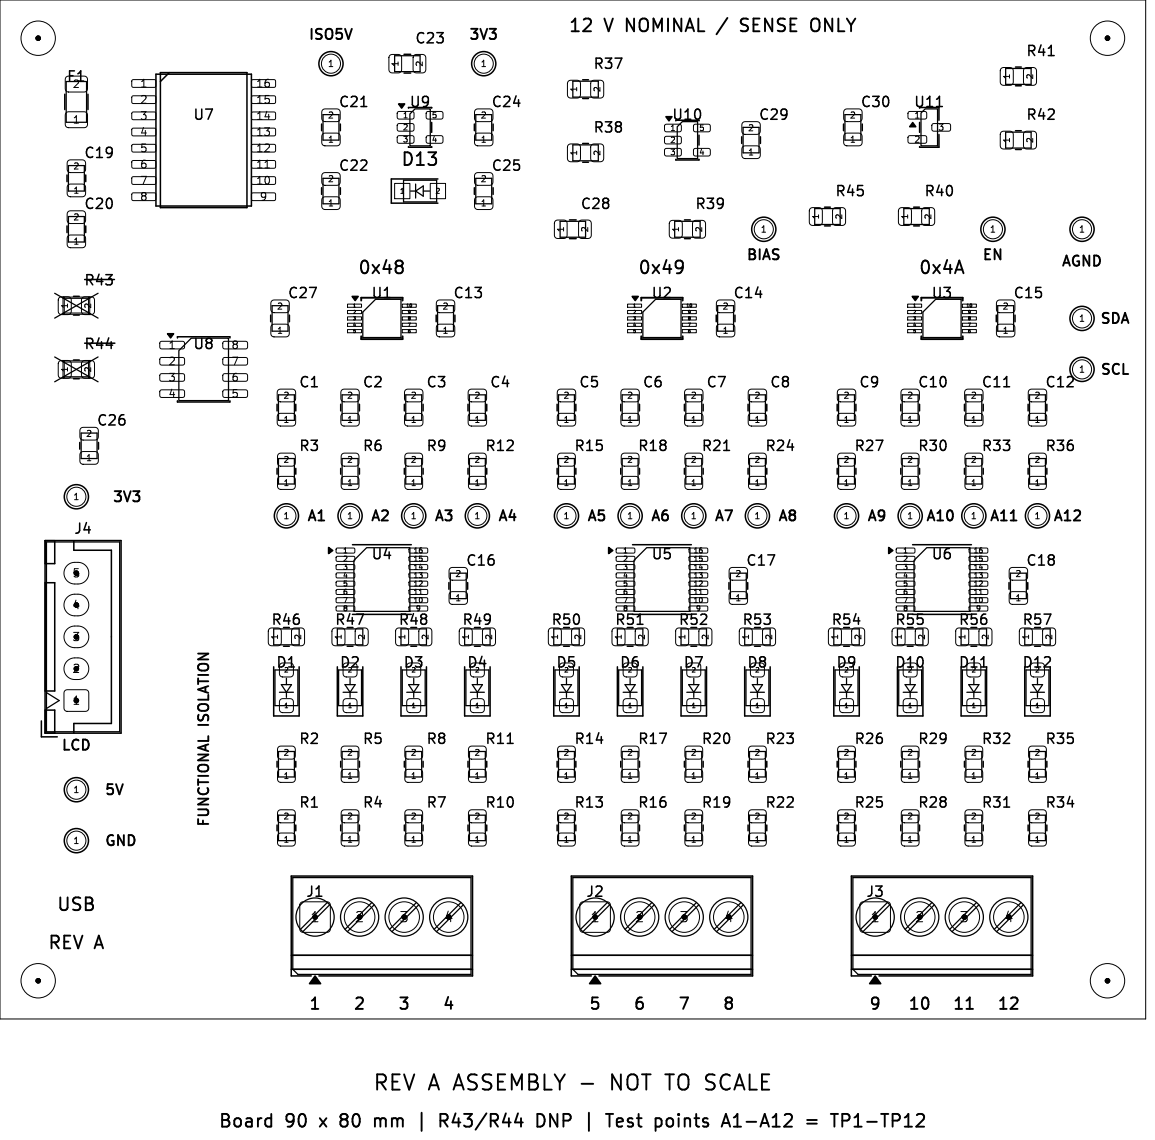
[picture p209: page 1]
