PetterGustafsson/power-supply-tester/hardware/tester12v-rev-c-engineering-package/hardware/rev-c/previews/assembly.pdf

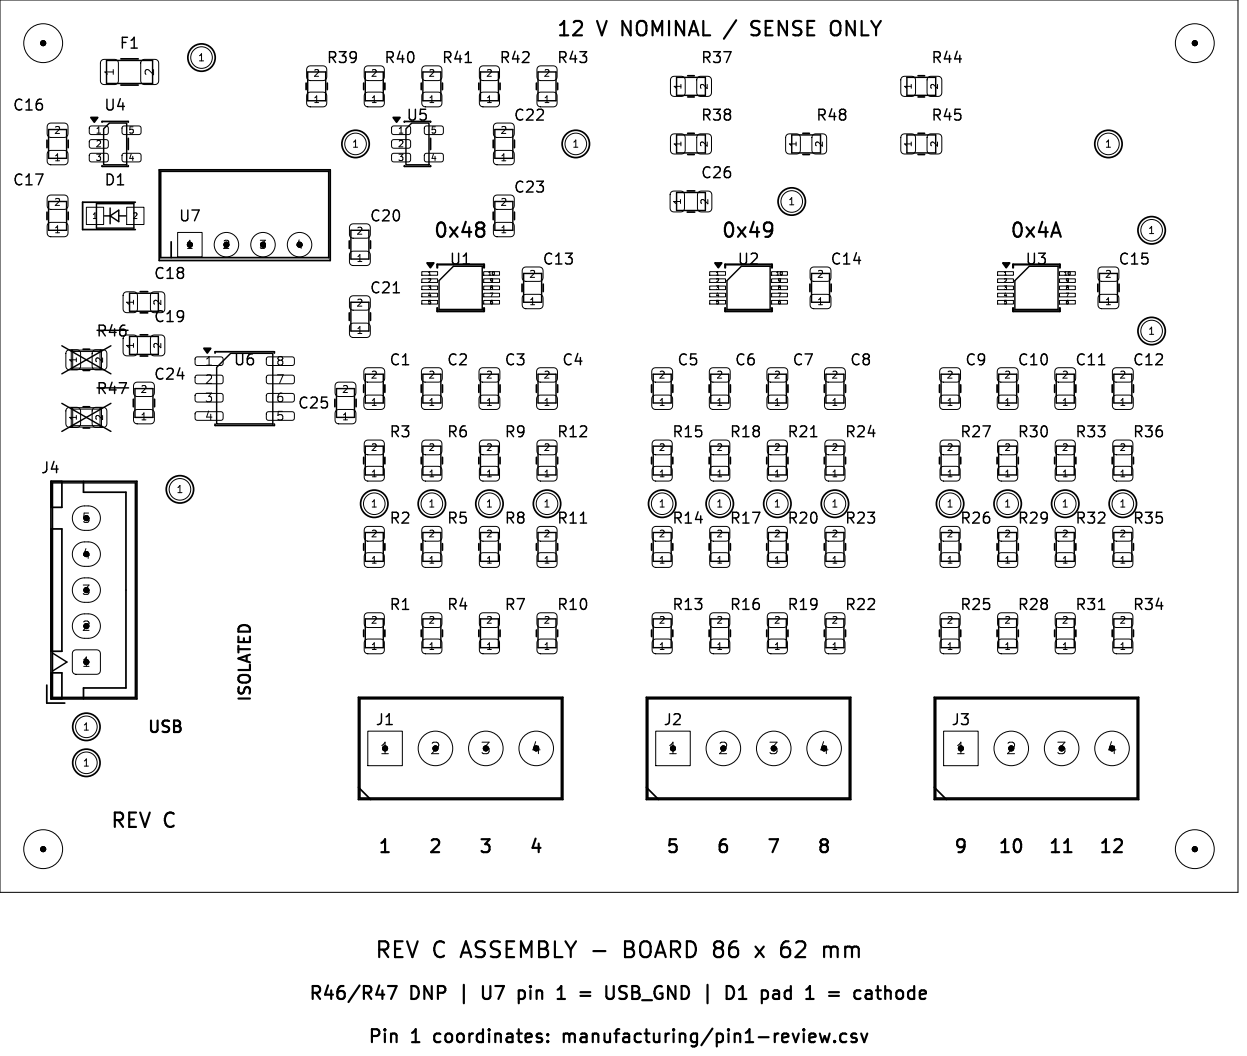
[picture p210: page 1]
