PetterGustafsson/power-supply-tester/hardware/tester12v-rev-c-engineering-package/hardware/rev-c/previews/schematic.pdf

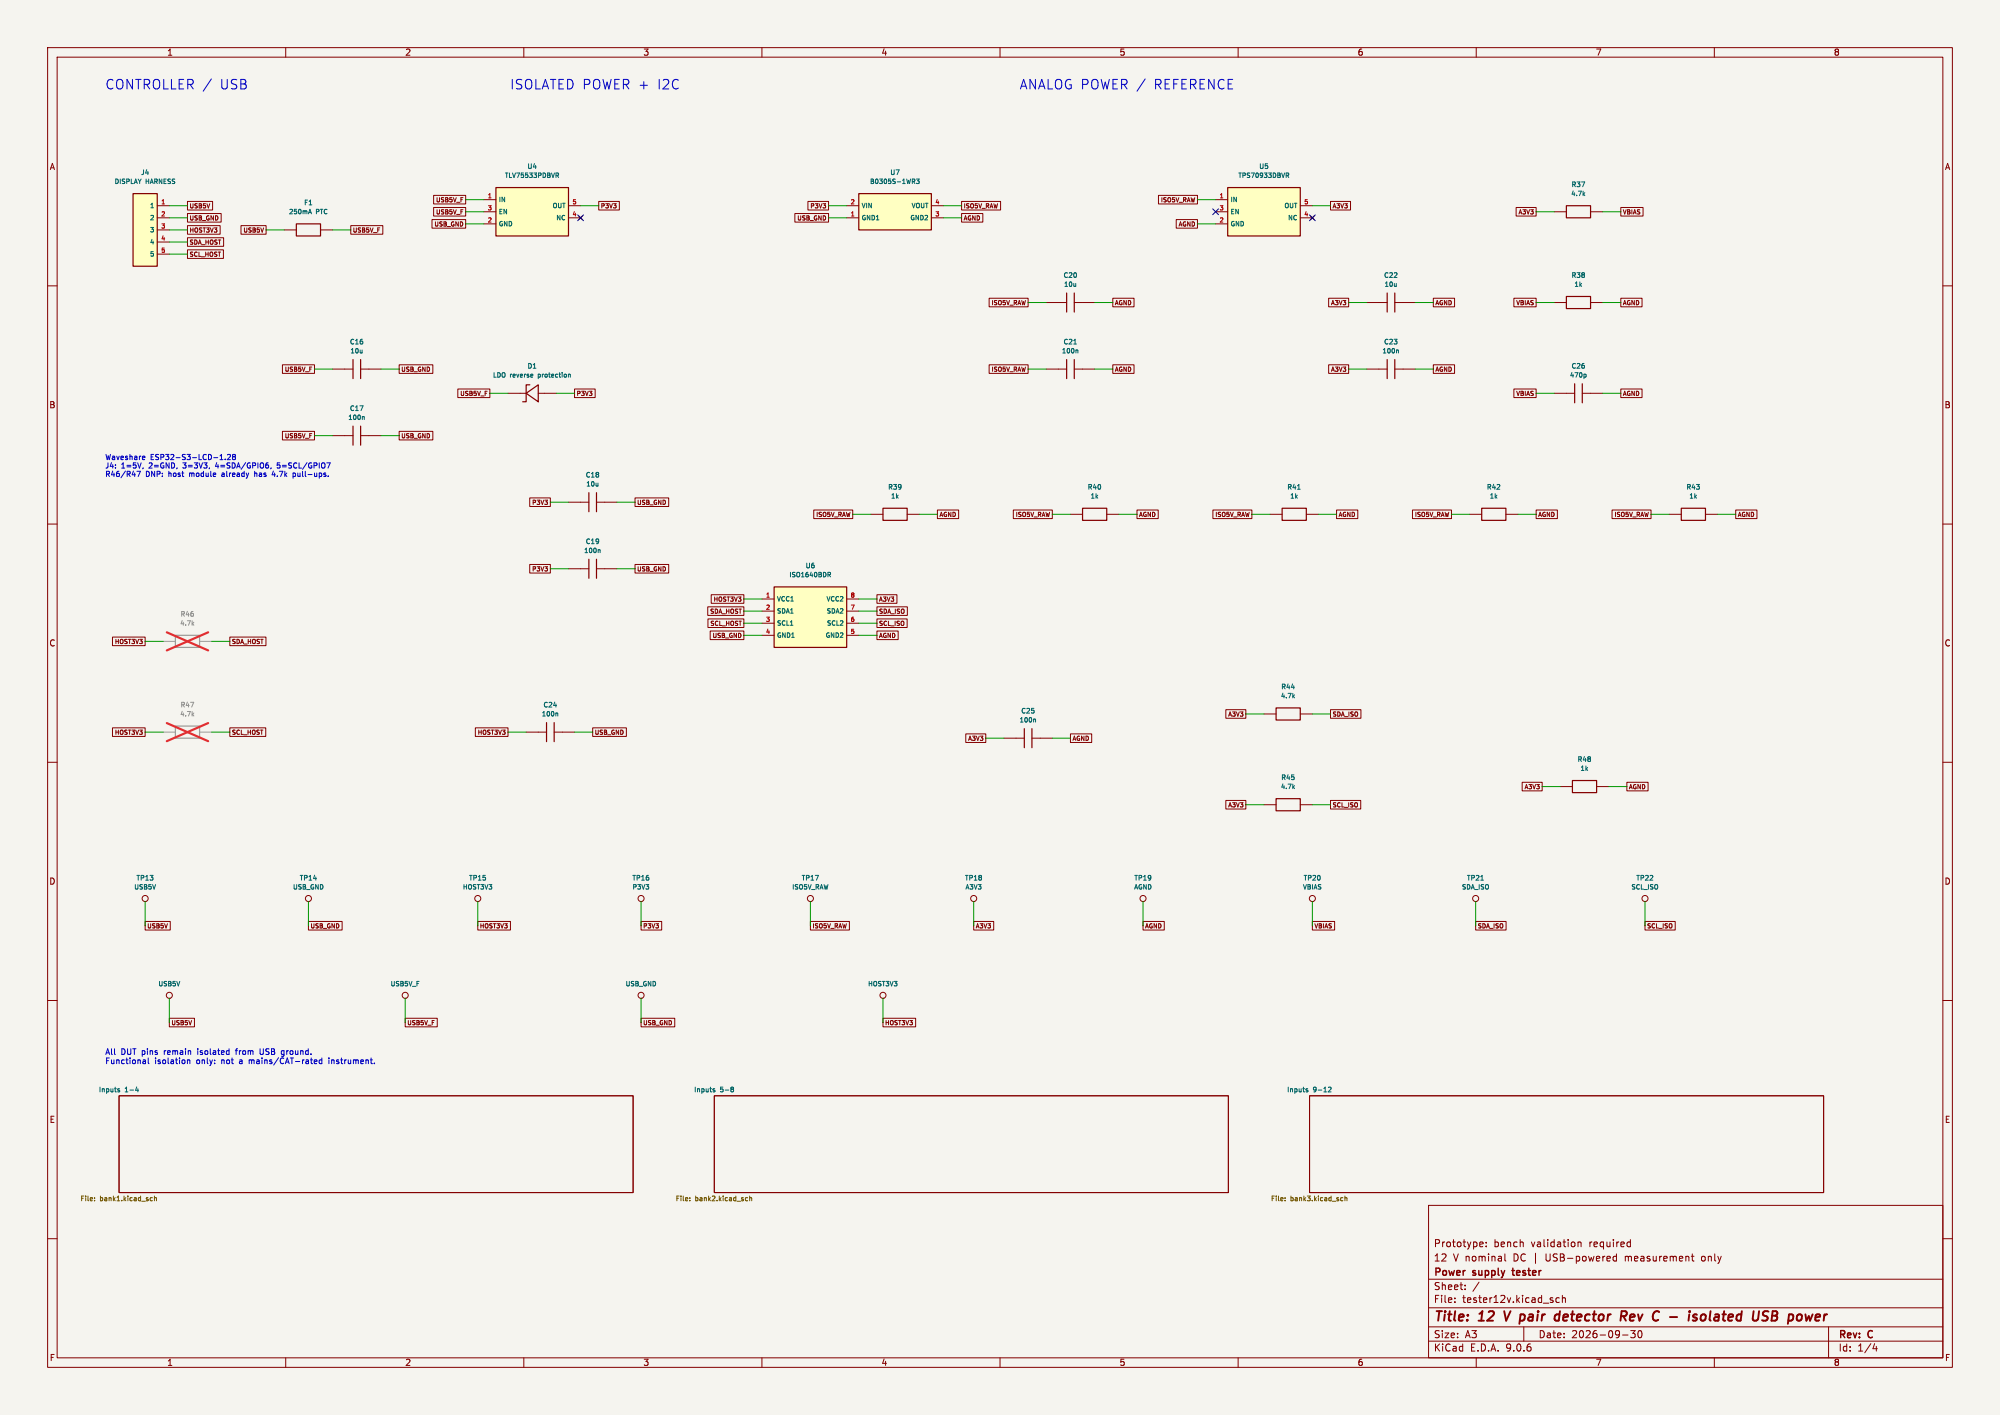
[picture p211: page 1]

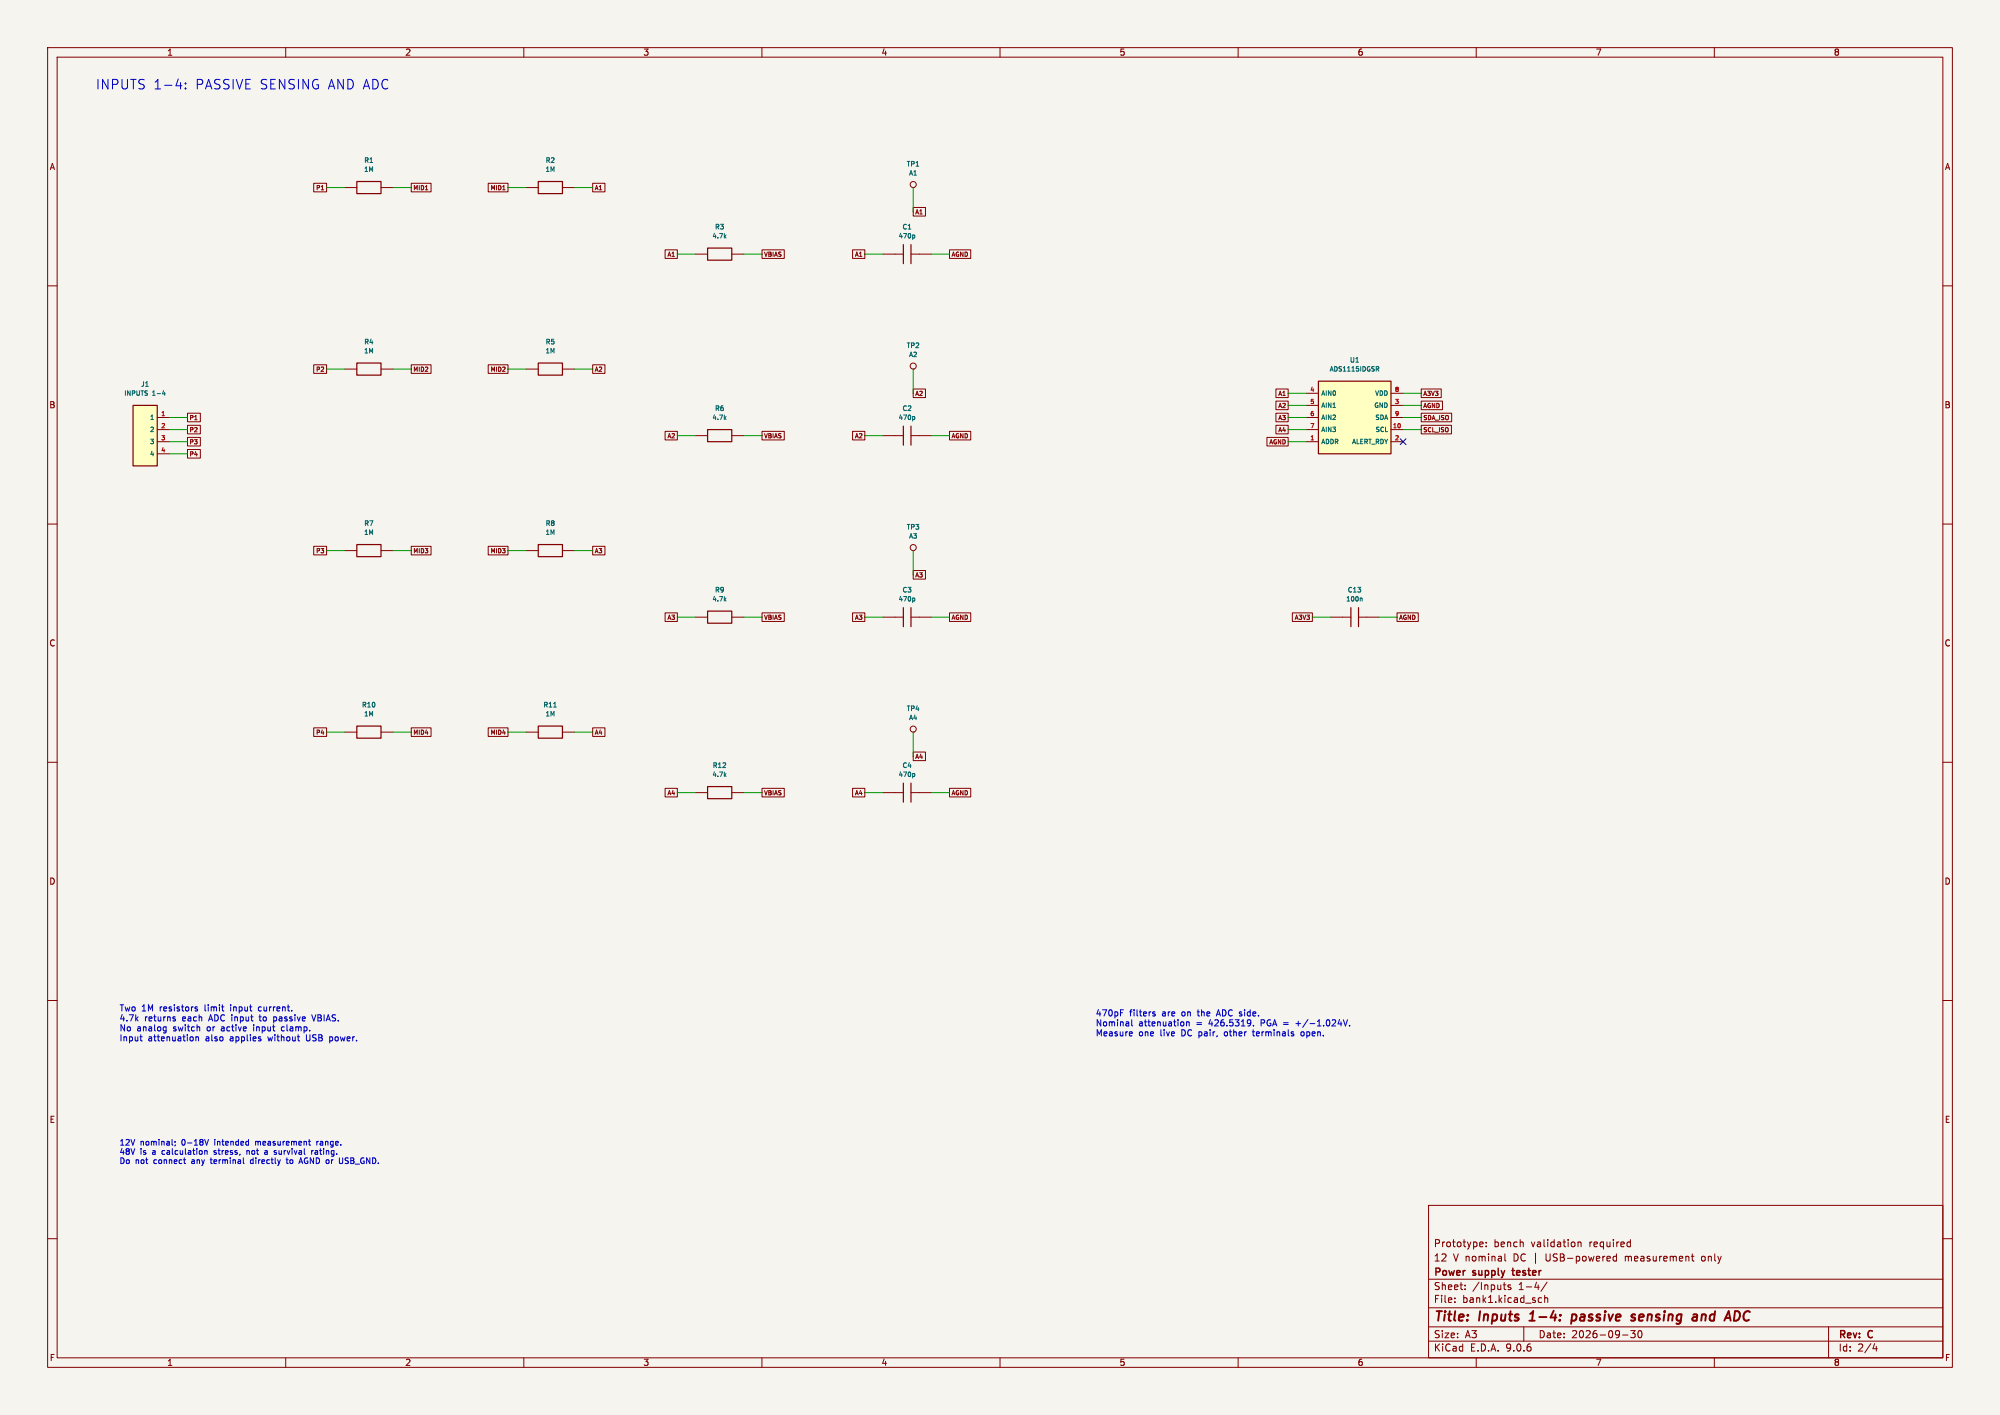
[picture p212: page 2]

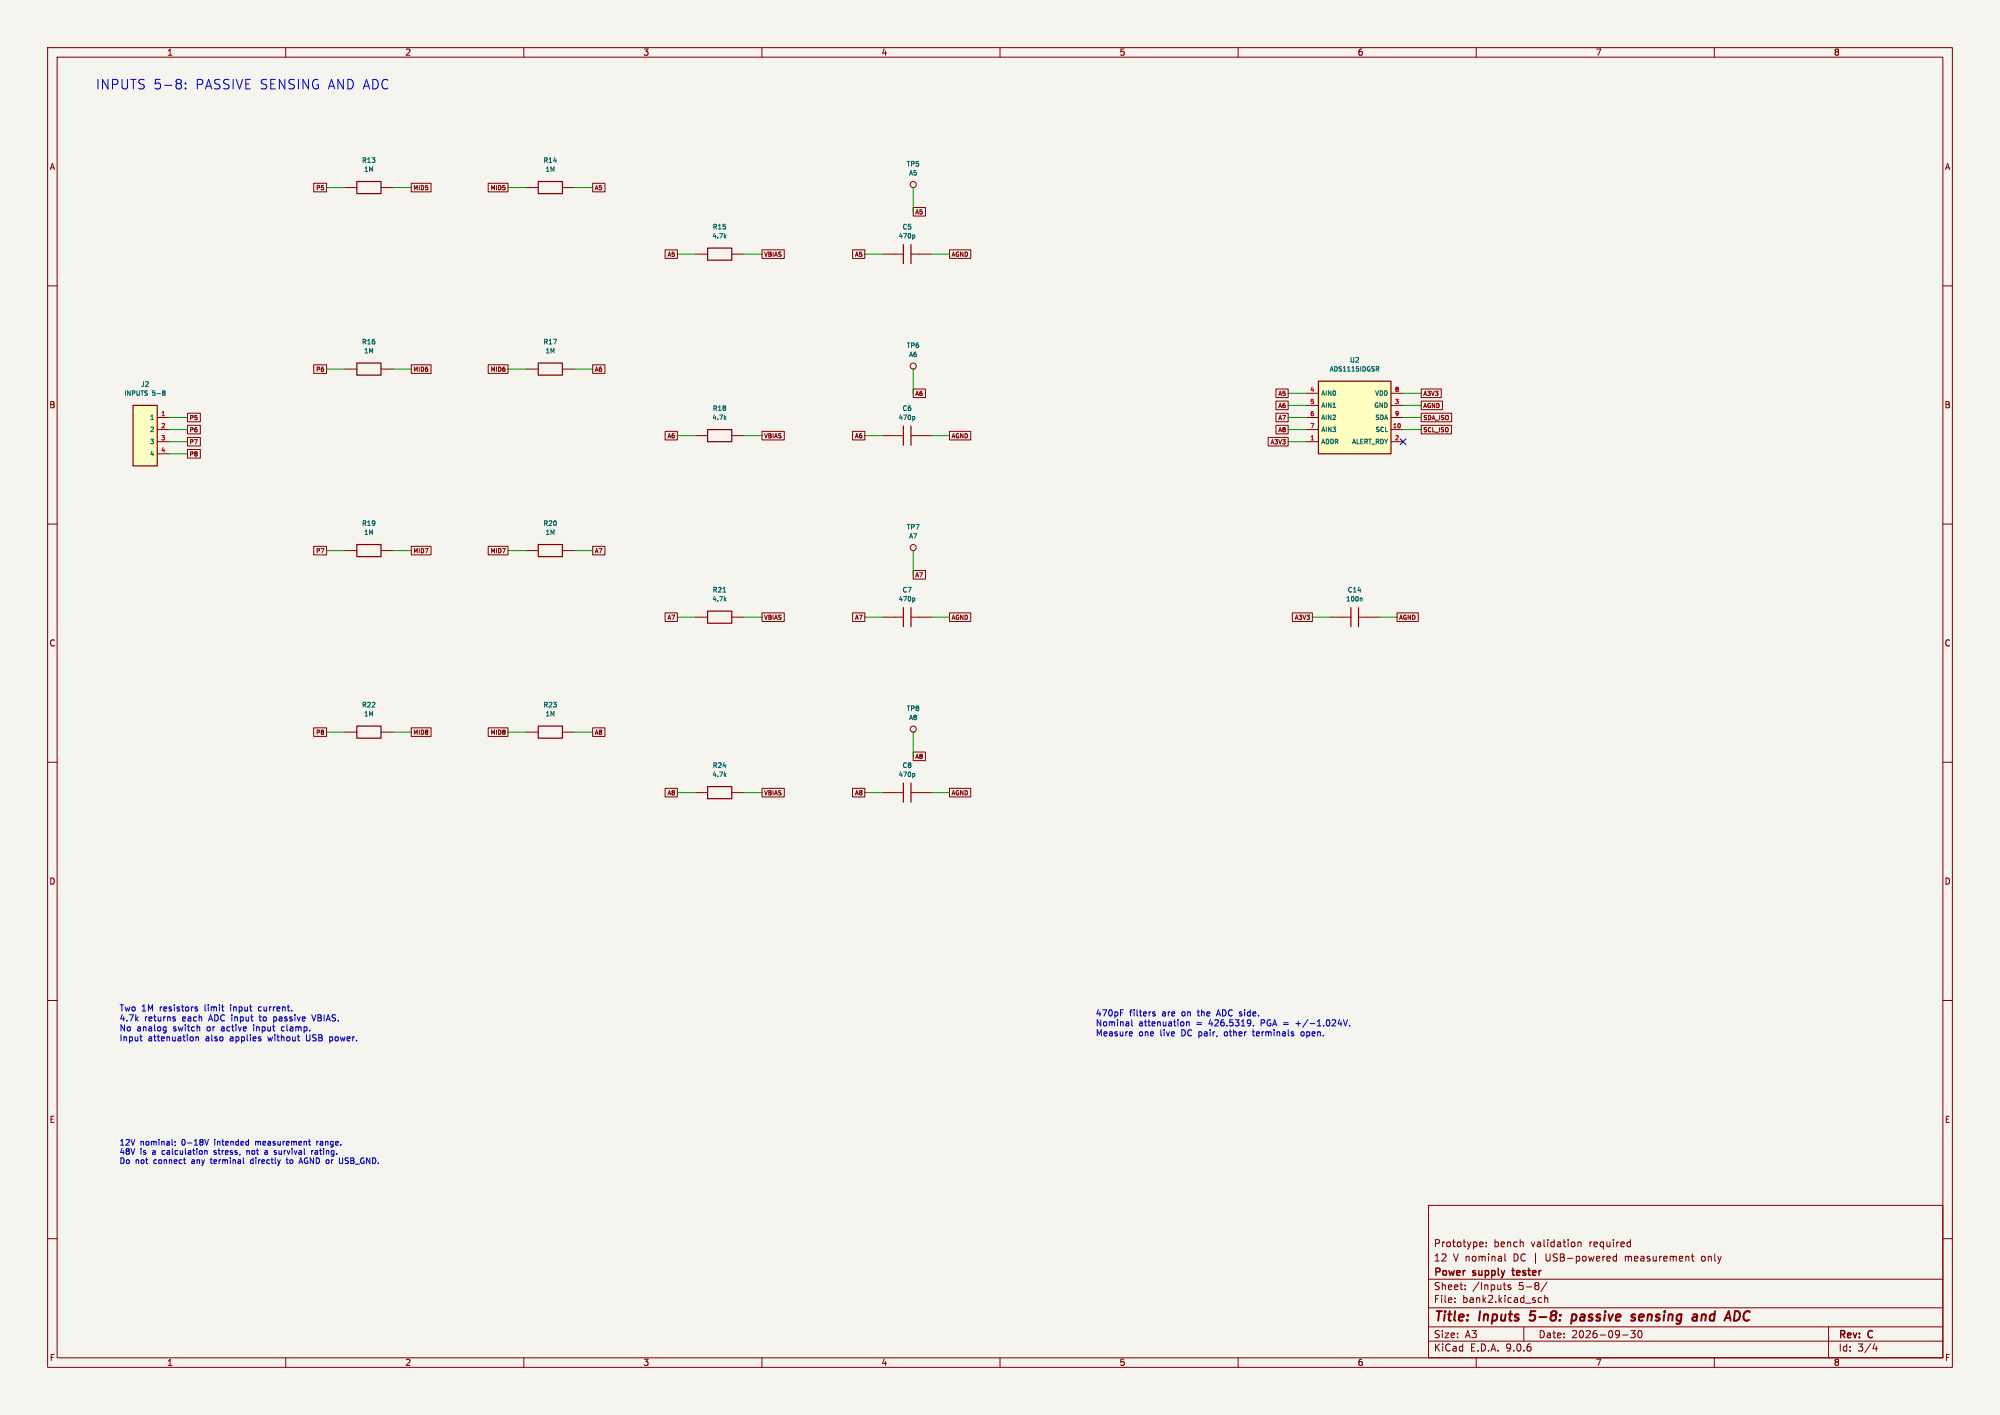
[picture p213: page 3]

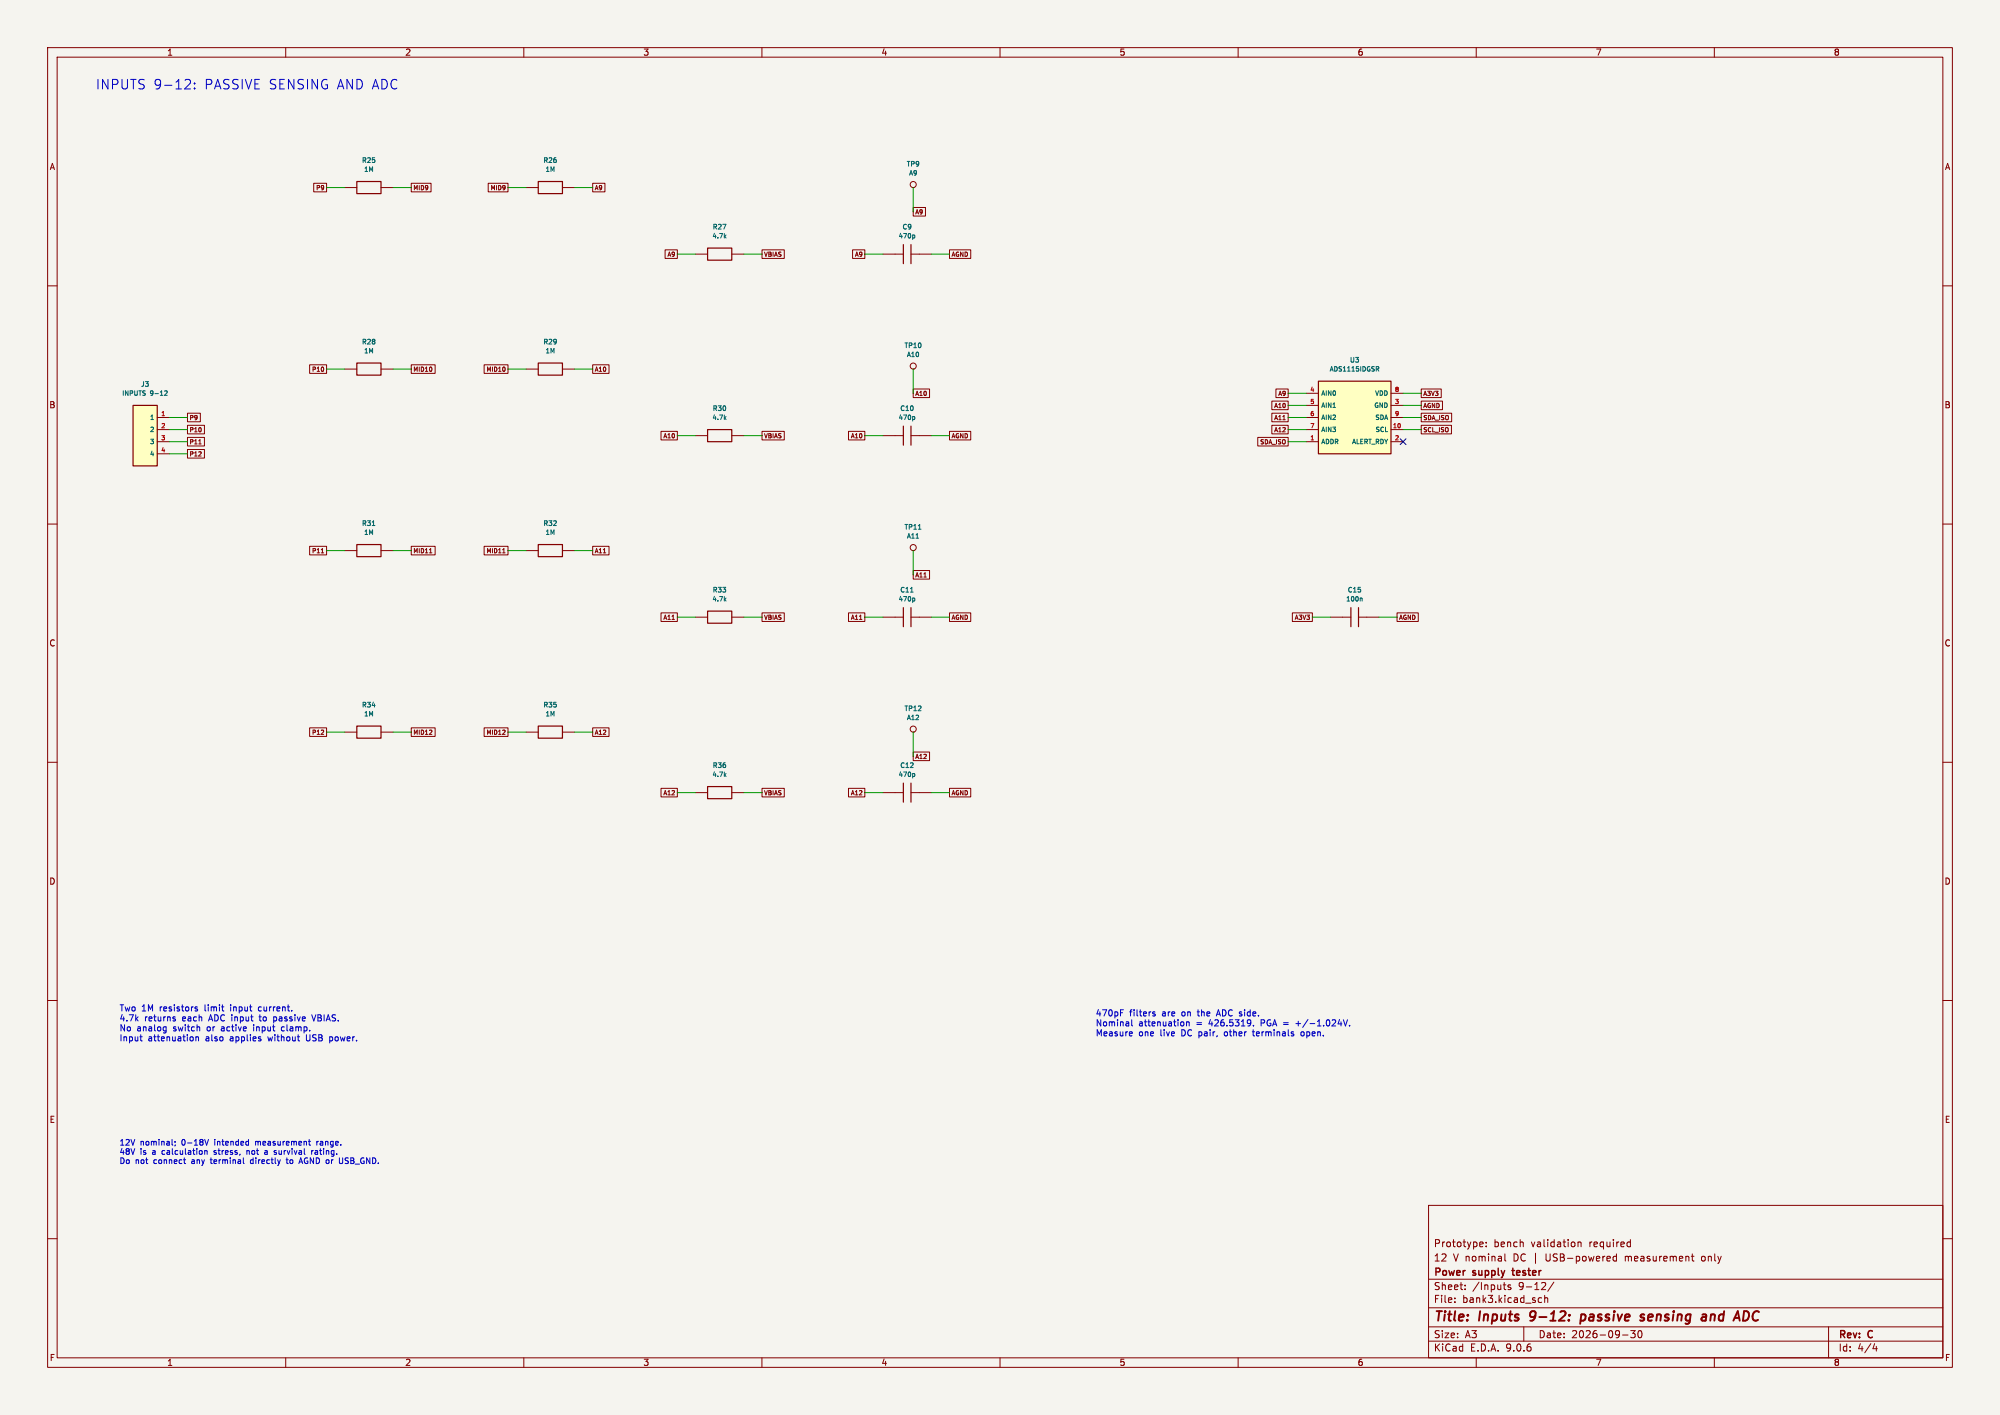
[picture p214: page 4]
