PetterGustafsson/power-supply-tester/(list of files, drawings)

Other design files:
hardware/rev-a/tester12v-final.dsn
hardware/rev-a/tester12v-prefanout.dsn
hardware/rev-a/tester12v.dsn
hardware/rev-d/tester12v.dsn
hardware/rev-e/tester12v.dsn
hardware/tester12v-rev-c-engineering-package/hardware/rev-c/tester12v.dsn
hardware/tester12v-rev-d-engineering-package/hardware/rev-d/tester12v.dsn
output/agnd-pogo-jig-d2/pcb-reference.json
