PetterGustafsson/power-supply-tester/hardware/rev-a/tester12v.kicad_pcb

## KiCad design hardware/rev-a/tester12v.kicad_pcb (2026-10-02, an earlier design)

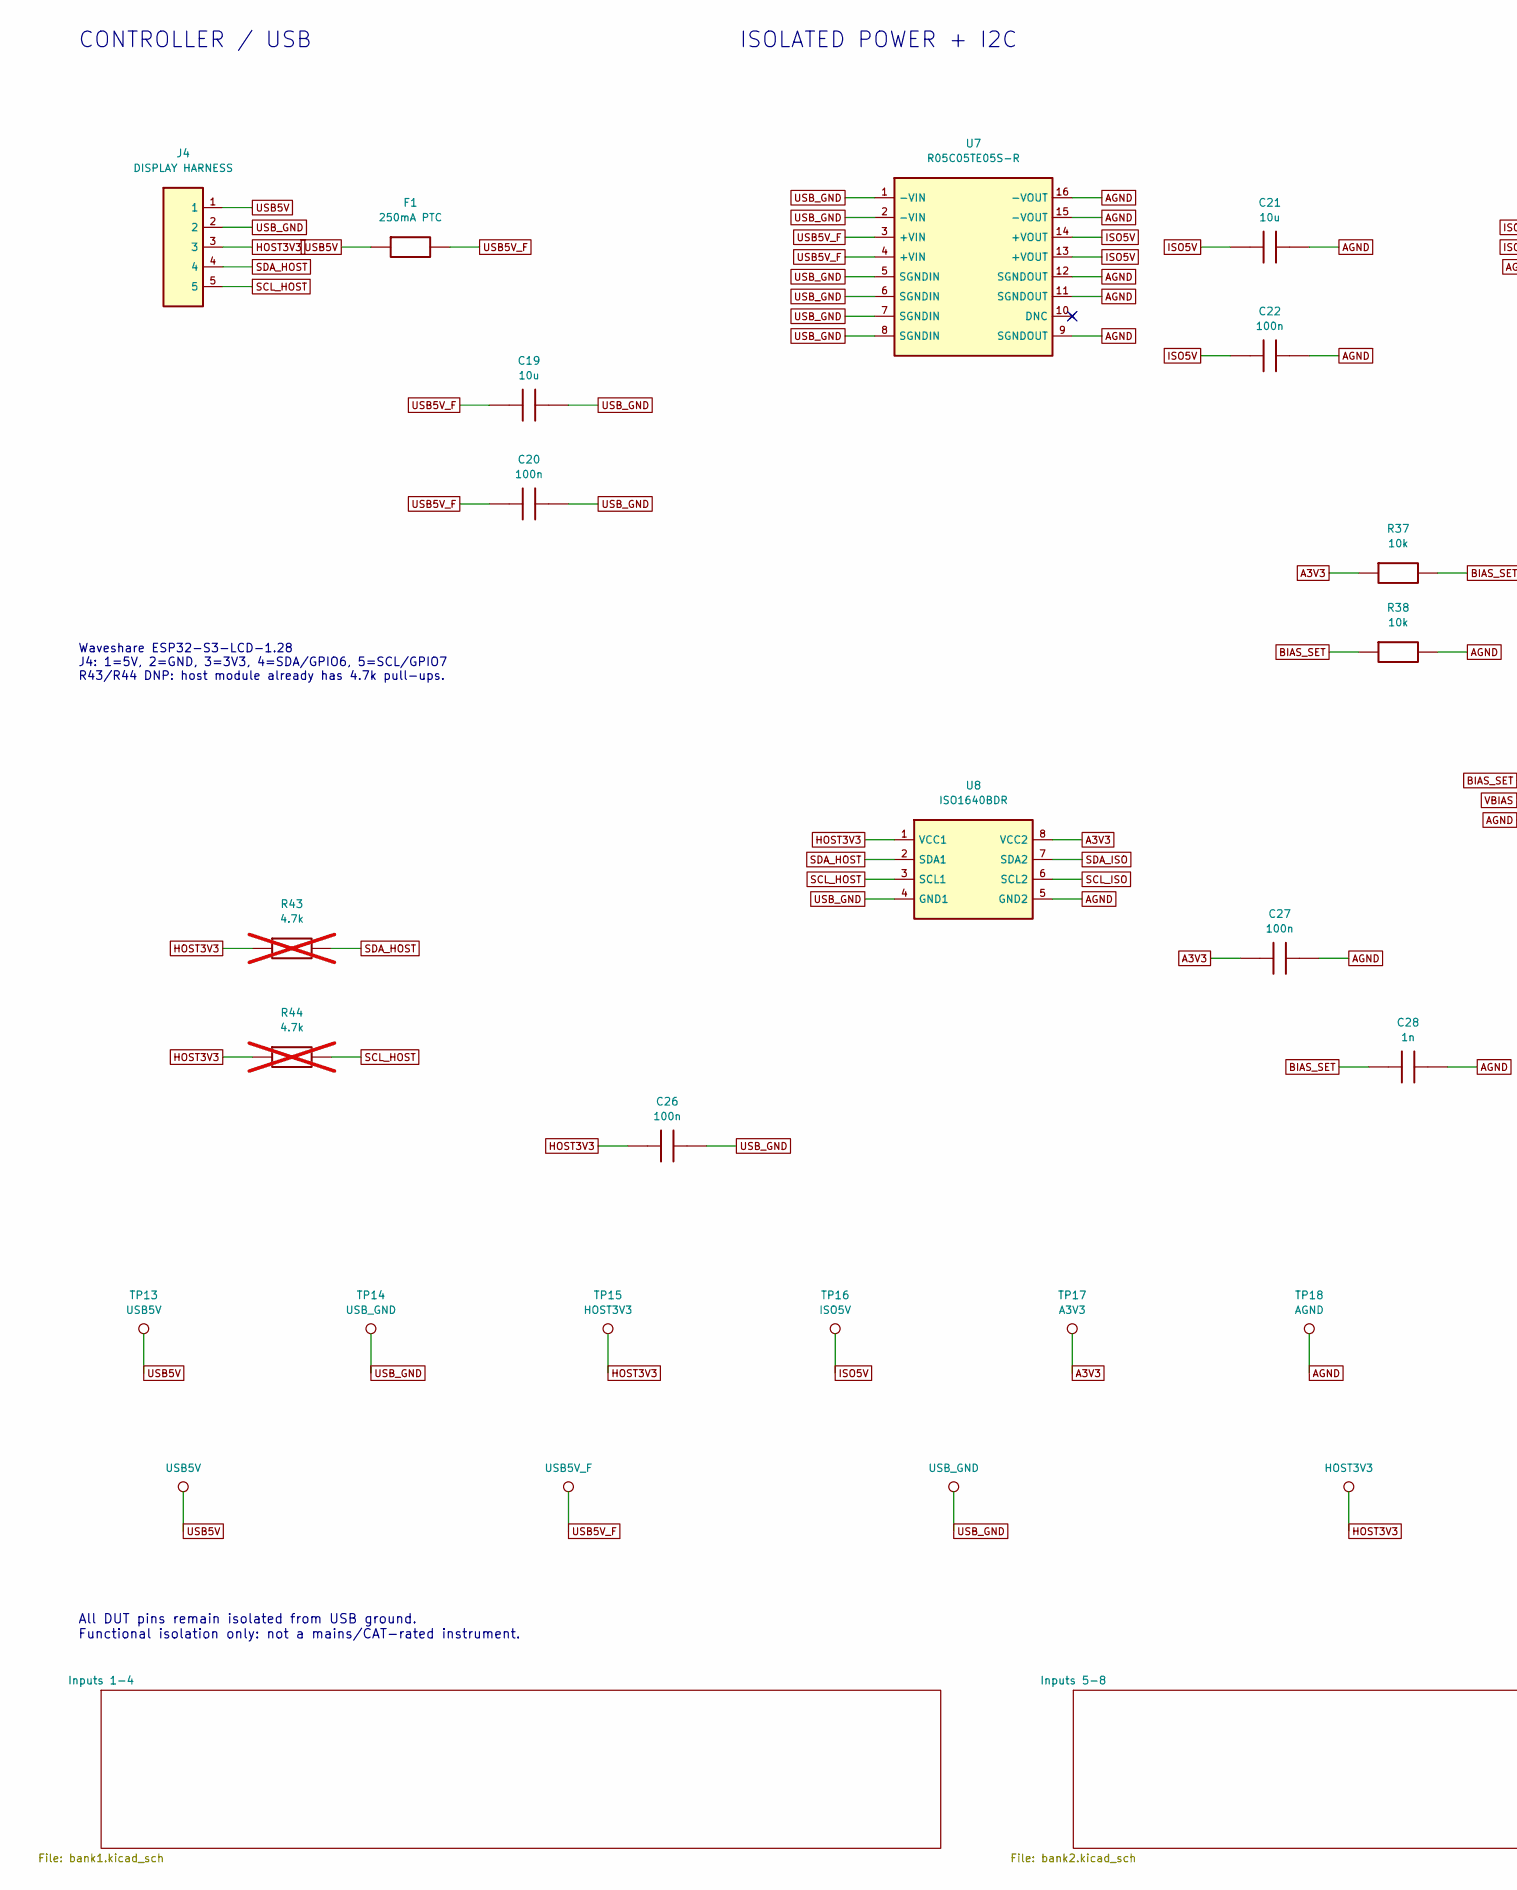
[picture p215: schematic tester12v.kicad_sch, 12 V universal pin-voltage tester - power and controller, part in row 1, column 1]

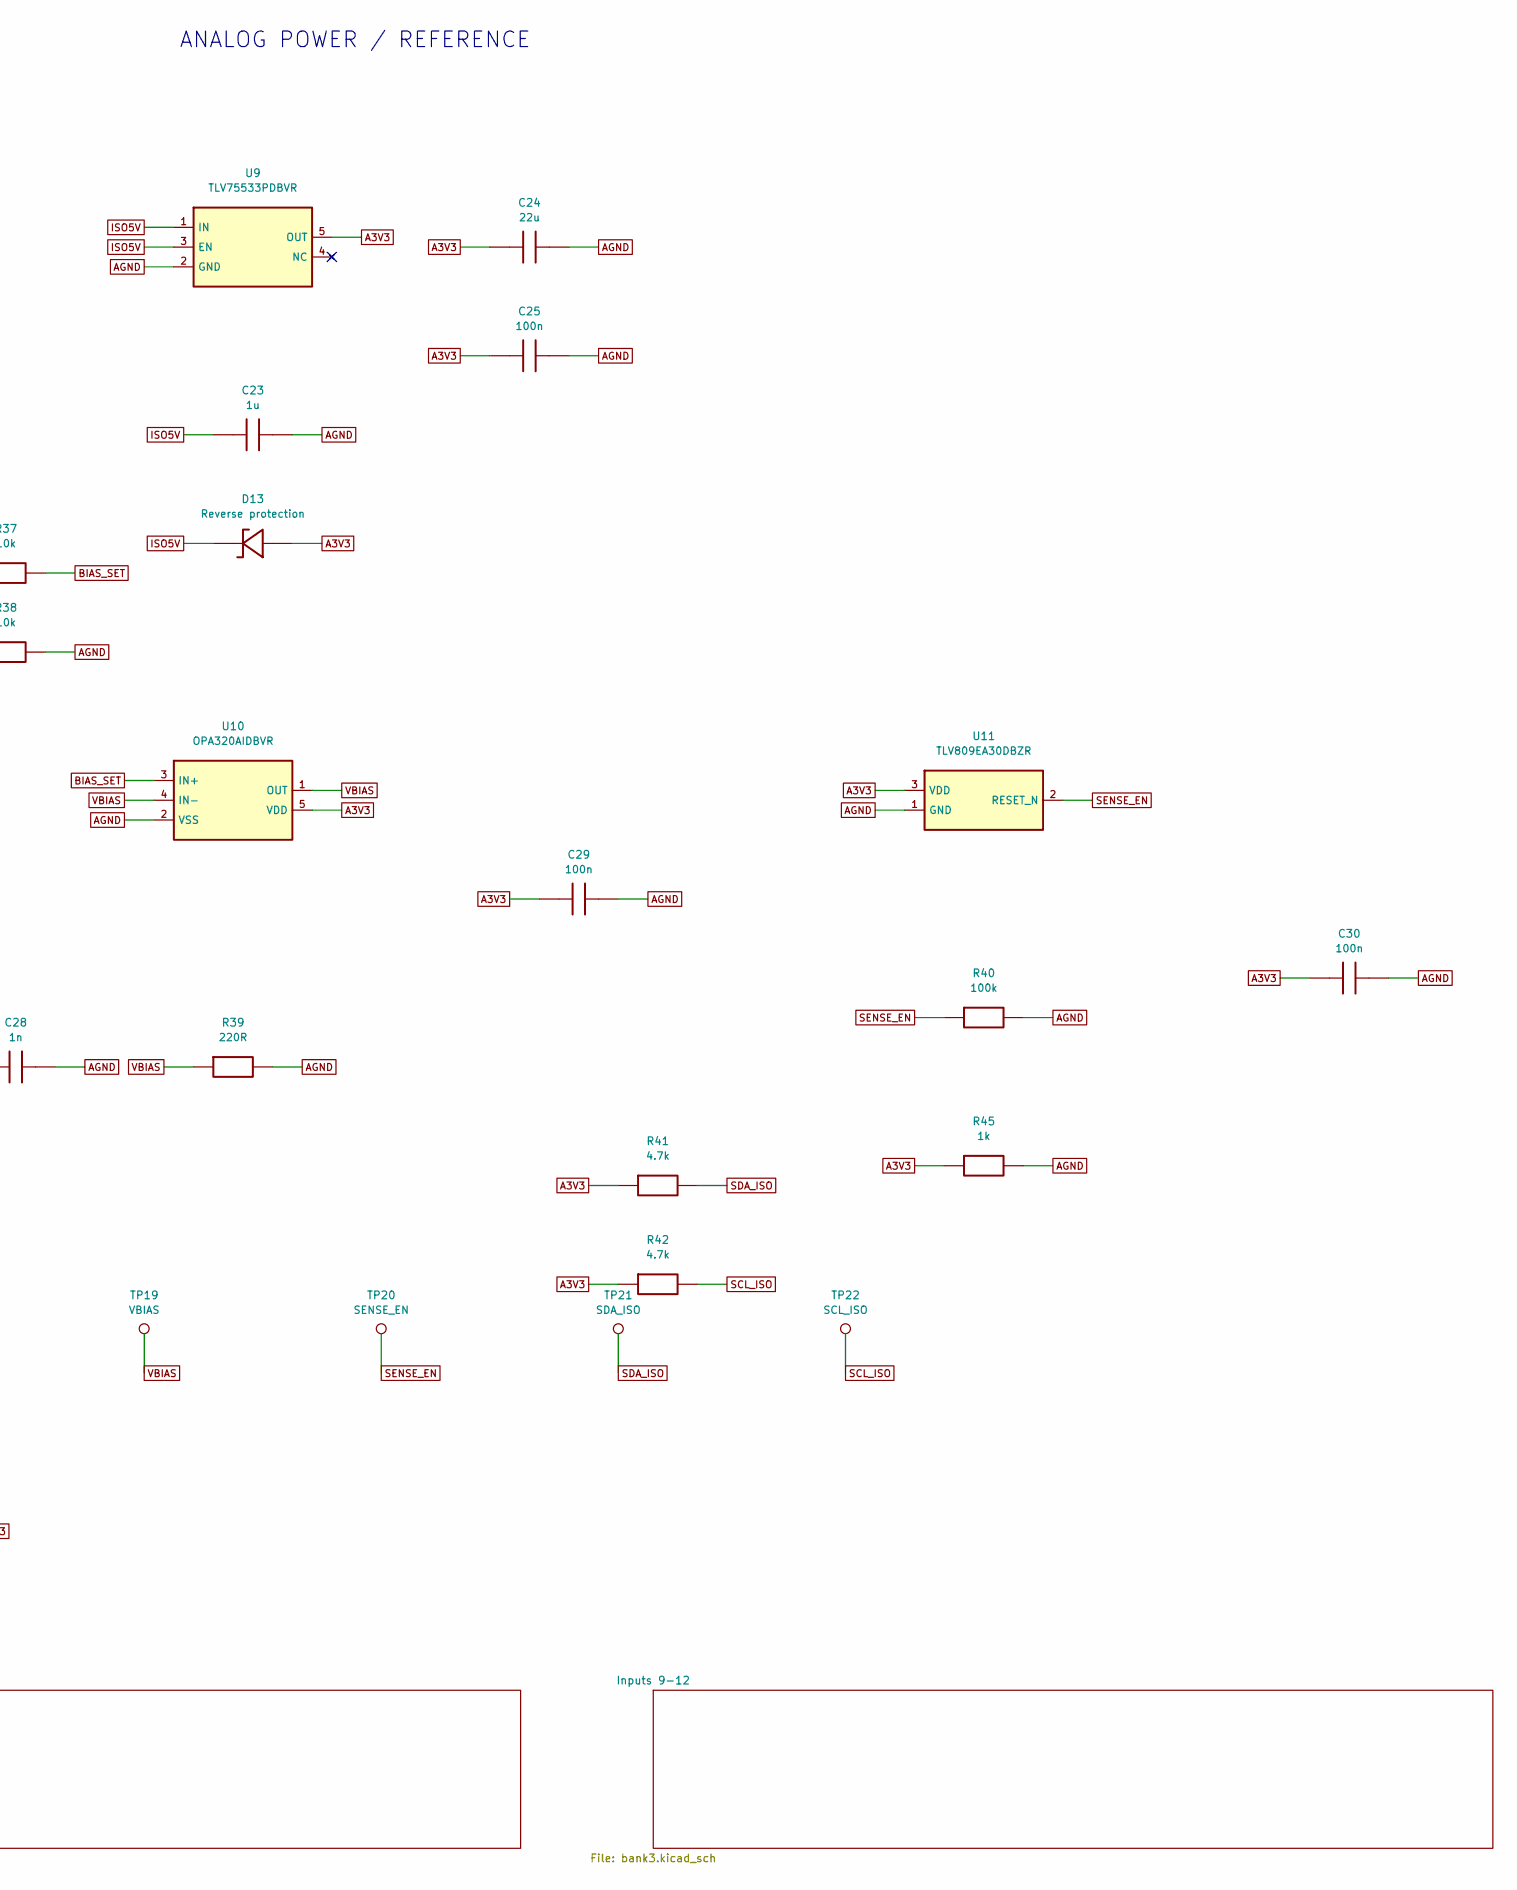
[picture p216: schematic tester12v.kicad_sch, 12 V universal pin-voltage tester - power and controller, part in row 1, column 2]

Parts:
C19, C21: 10u; C_0805_2012Metric; MPN CL21A106KAYNNNE; LCSC C15850
C20, C22, C25, C26, C27, C29, C30: 100n; C_0805_2012Metric; MPN CC0805KRX7R9BB104; LCSC C49678
C23: 1u; C_0805_2012Metric; MPN CL21B105KBFNNNE; LCSC C28323
C24: 22u; C_0805_2012Metric; MPN CL21A226MAQNNNE; LCSC C45783
C28: 1n; C_0805_2012Metric; MPN CC0805JRNPO9BN102; LCSC C62774
D13: Reverse protection; Nexperia_CFP3_SOD-123W; MPN PMEG2010ER,115; LCSC C82288
F1: 250mA PTC; Fuse_1206_3216Metric; MPN 1206L025/24YR; LCSC C3762322
J4: DISPLAY HARNESS; JST_XH_B5B-XH-A_1x05_P2.50mm_Vertical; MPN B5B-XH-A(LF)(SN); LCSC C157991
R37, R38: 10k; R_0805_2012Metric; MPN RT0805BRD0710KL; LCSC C110775
R39: 220R; R_0805_2012Metric; MPN 0805W8F2200T5E; LCSC C17557
R40: 100k; R_0805_2012Metric; MPN 0805W8F1003T5E; LCSC C149504
R41, R42: 4.7k; R_0805_2012Metric; MPN 0805W8F4701T5E; LCSC C17673
R43, R44: 4.7k; R_0805_2012Metric; MPN 0805W8F4701T5E; LCSC C17673; not fitted
R45: 1k; R_0805_2012Metric; MPN 0805W8F1001T5E; LCSC C17513
TP13: USB5V; TestPoint_Pad_D1.5mm
TP14: USB_GND; TestPoint_Pad_D1.5mm
TP15: HOST3V3; TestPoint_Pad_D1.5mm
TP16: ISO5V; TestPoint_Pad_D1.5mm
TP17: A3V3; TestPoint_Pad_D1.5mm
TP18: AGND; TestPoint_Pad_D1.5mm
TP19: VBIAS; TestPoint_Pad_D1.5mm
TP20: SENSE_EN; TestPoint_Pad_D1.5mm
TP21: SDA_ISO; TestPoint_Pad_D1.5mm
TP22: SCL_ISO; TestPoint_Pad_D1.5mm
U7: R05C05TE05S-R; R05C05TE05S; MPN R05C05TE05S-R; LCSC C5338283
U8: ISO1640BDR; SOIC-8_3.9x4.9mm_P1.27mm; MPN ISO1640BDR; LCSC C5122339
U9: TLV75533PDBVR; SOT-23-5; MPN TLV75533PDBVR; LCSC C404027
U10: OPA320AIDBVR; SOT-23-5; MPN OPA320AIDBVR; LCSC C92494
U11: TLV809EA30DBZR; SOT-23; MPN TLV809EA30DBZR; LCSC C2860914

Connections:
A3V3: C24.1, C25.1, C27.1, C29.1, C30.1, D13.2, R37.1, R41.1, R42.1, R45.1, TP17.1, U8.8 (VCC2), U9.5 (OUT), U10.5 (VDD), U11.3 (VDD); also elsewhere on the board
AGND: C21.2, C22.2, C23.2, C24.2, C25.2, C27.2, C28.2, C29.2, C30.2, R38.2, R39.2, R40.2, R45.2, TP18.1, U7.9 (SGNDOUT), U7.11 (SGNDOUT), U7.12 (SGNDOUT), U7.15 (-VOUT), U7.16 (-VOUT), U8.5 (GND2), U9.2 (GND), U10.2 (VSS), U11.1 (GND); also elsewhere on the board
BIAS_SET: C28.1, R37.2, R38.1, U10.3 (IN+)
HOST3V3: C26.1, J4.3, R43.1, R44.1, TP15.1, U8.1 (VCC1)
ISO5V: C21.1, C22.1, C23.1, D13.1, TP16.1, U7.13 (+VOUT), U7.14 (+VOUT), U9.1 (IN), U9.3 (EN); also elsewhere on the board
SCL_HOST: J4.5, R44.2, U8.3 (SCL1)
SCL_ISO: R42.2, TP22.1, U8.6 (SCL2); also elsewhere on the board
SDA_HOST: J4.4, R43.2, U8.2 (SDA1)
SDA_ISO: R41.2, TP21.1, U8.7 (SDA2); also elsewhere on the board
SENSE_EN: R40.1, TP20.1, U11.2 (RESET_N); also elsewhere on the board
USB5V: F1.1, J4.1, TP13.1
USB5V_F: C19.1, C20.1, F1.2, U7.3 (+VIN), U7.4 (+VIN)
USB_GND: C19.2, C20.2, C26.2, J4.2, TP14.1, U7.1 (-VIN), U7.2 (-VIN), U7.5 (SGNDIN), U7.6 (SGNDIN), U7.7 (SGNDIN), U7.8 (SGNDIN), U8.4 (GND1)
VBIAS: R39.1, TP19.1, U10.1 (OUT), U10.4 (IN-); also elsewhere on the board

Notes on the sheet:
CONTROLLER / USB
ISOLATED POWER + I2C
ANALOG POWER / REFERENCE
Waveshare ESP32-S3-LCD-1.28 J4: 1=5V, 2=GND, 3=3V3, 4=SDA/GPIO6, 5=SCL/GPIO7 R43/R44 DNP: host module already has 4.7k pull-ups.
All DUT pins remain isolated from USB ground. Functional isolation only: not a mains/CAT-rated instrument.

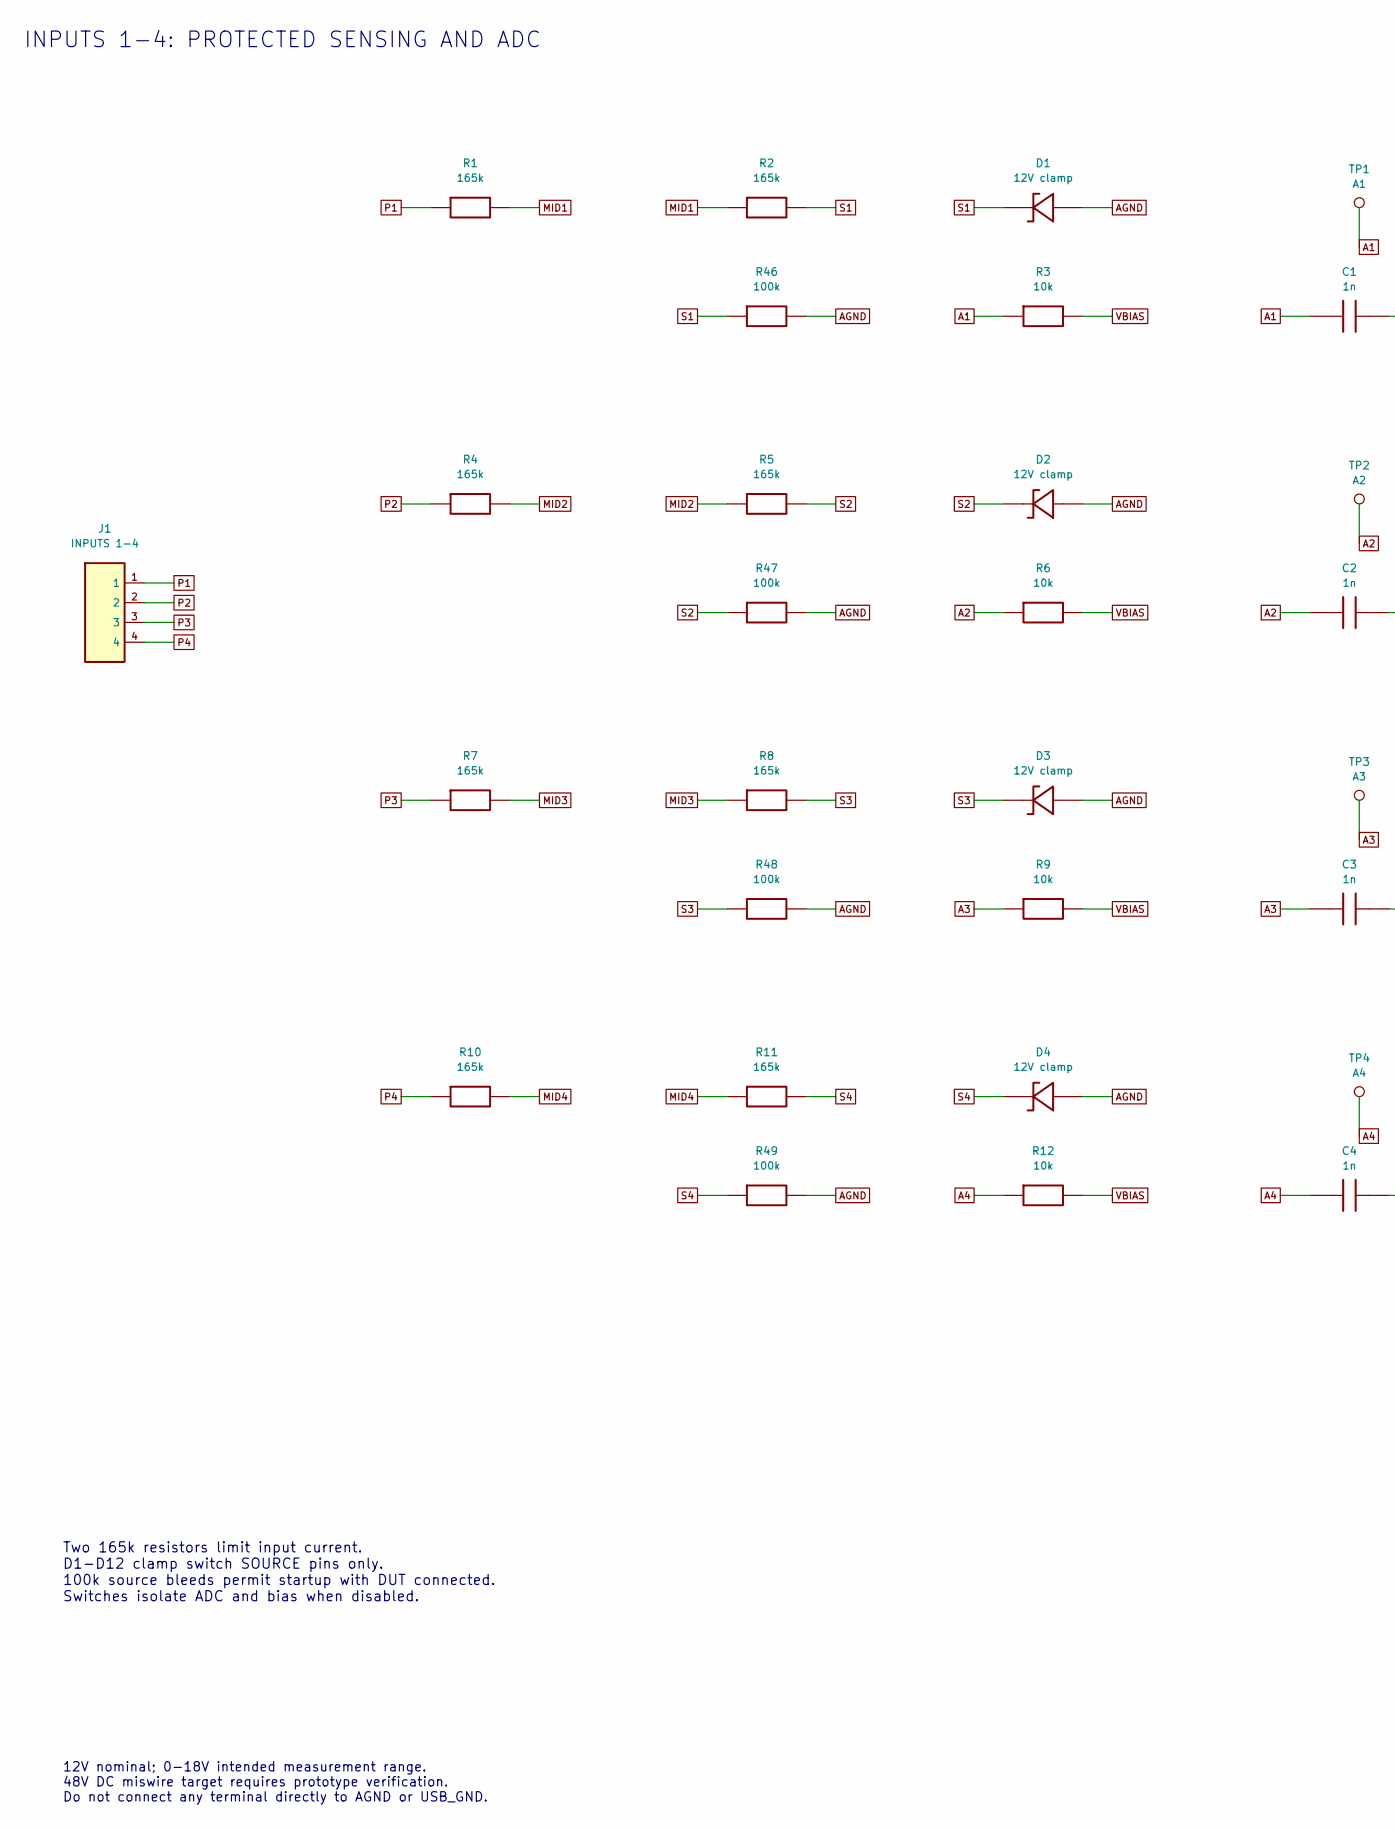
[picture p217: schematic bank1.kicad_sch, Inputs 1-4: protected sensing and ADC, part in row 1, column 1]

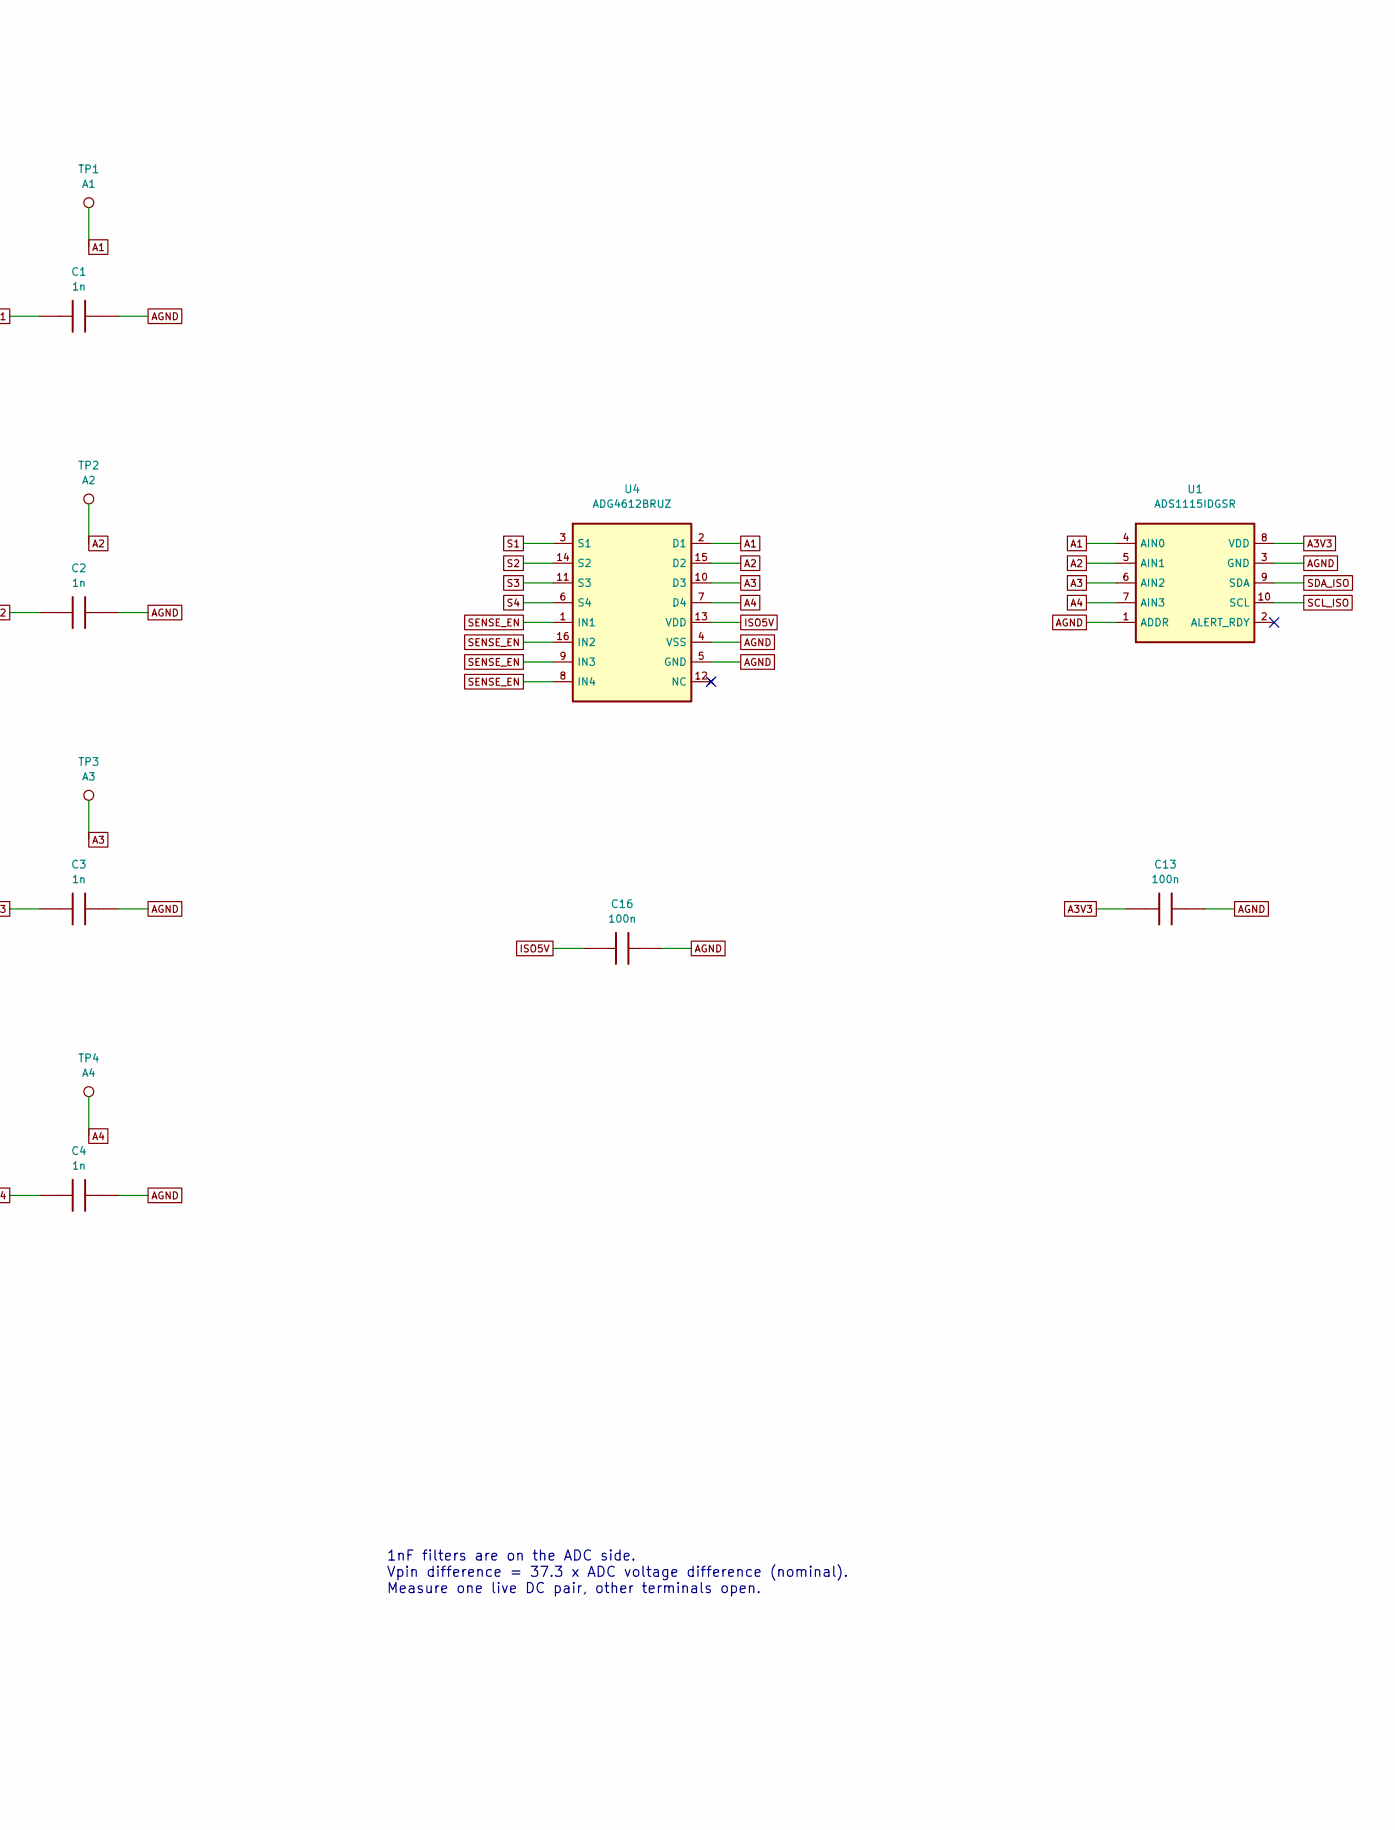
[picture p218: schematic bank1.kicad_sch, Inputs 1-4: protected sensing and ADC, part in row 1, column 2]

Parts:
C1, C2, C3, C4: 1n; C_0805_2012Metric; MPN CC0805JRNPO9BN102; LCSC C62774
C13, C16: 100n; C_0805_2012Metric; MPN CC0805KRX7R9BB104; LCSC C49678
D1, D2, D3, D4: 12V clamp; D_SOD-123F; MPN BZT52H-C12,115; LCSC C282531
J1: INPUTS 1-4; TerminalBlock_Phoenix_PT-1,5-4-3.5-H_1x04_P3.50mm_Horizontal; MPN 1984633; LCSC C5144867
R1, R2, R4, R5, R7, R8, R10, R11: 165k; R_0805_2012Metric; MPN RT0805BRD07165KL; LCSC C865215
R3, R6, R9, R12: 10k; R_0805_2012Metric; MPN RT0805BRD0710KL; LCSC C110775
R46, R47, R48, R49: 100k; R_0805_2012Metric; MPN RT0805BRD07100KL; LCSC C122537
TP1: A1; TestPoint_Pad_D1.5mm
TP2: A2; TestPoint_Pad_D1.5mm
TP3: A3; TestPoint_Pad_D1.5mm
TP4: A4; TestPoint_Pad_D1.5mm
U1: ADS1115IDGSR; TSSOP-10_3x3mm_P0.5mm; MPN ADS1115IDGSR; LCSC C37593
U4: ADG4612BRUZ; TSSOP-16_4.4x5mm_P0.65mm; MPN ADG4612BRUZ-REEL7; LCSC C207399

Connections:
A1: C1.1, R3.1, TP1.1, U1.4 (AIN0), U4.2 (D1)
A2: C2.1, R6.1, TP2.1, U1.5 (AIN1), U4.15 (D2)
A3: C3.1, R9.1, TP3.1, U1.6 (AIN2), U4.10 (D3)
A3V3: C13.1, U1.8 (VDD); also elsewhere on the board
A4: C4.1, R12.1, TP4.1, U1.7 (AIN3), U4.7 (D4)
AGND: C1.2, C2.2, C3.2, C4.2, C13.2, C16.2, D1.2, D2.2, D3.2, D4.2, R46.2, R47.2, R48.2, R49.2, U1.1 (ADDR), U1.3 (GND), U4.4 (VSS), U4.5 (GND); also elsewhere on the board
ISO5V: C16.1, U4.13 (VDD); also elsewhere on the board
MID1: R1.2, R2.1
MID2: R4.2, R5.1
MID3: R7.2, R8.1
MID4: R10.2, R11.1
P1: J1.1, R1.1
P2: J1.2, R4.1
P3: J1.3, R7.1
P4: J1.4, R10.1
S1: D1.1, R2.2, R46.1, U4.3 (S1)
S2: D2.1, R5.2, R47.1, U4.14 (S2)
S3: D3.1, R8.2, R48.1, U4.11 (S3)
S4: D4.1, R11.2, R49.1, U4.6 (S4)
SCL_ISO: U1.10 (SCL); also elsewhere on the board
SDA_ISO: U1.9 (SDA); also elsewhere on the board
SENSE_EN: U4.1 (IN1), U4.8 (IN4), U4.9 (IN3), U4.16 (IN2); also elsewhere on the board
VBIAS: R3.2, R6.2, R9.2, R12.2; also elsewhere on the board

Notes on the sheet:
INPUTS 1-4: PROTECTED SENSING AND ADC
Two 165k resistors limit input current. D1-D12 clamp switch SOURCE pins only. 100k source bleeds permit startup with DUT connected. Switches isolate ADC and bias when disabled.
1nF filters are on the ADC side. Vpin difference = 37.3 x ADC voltage difference (nominal). Measure one live DC pair, other terminals open.
12V nominal; 0-18V intended measurement range. 48V DC miswire target requires prototype verification. Do not connect any terminal directly to AGND or USB_GND.

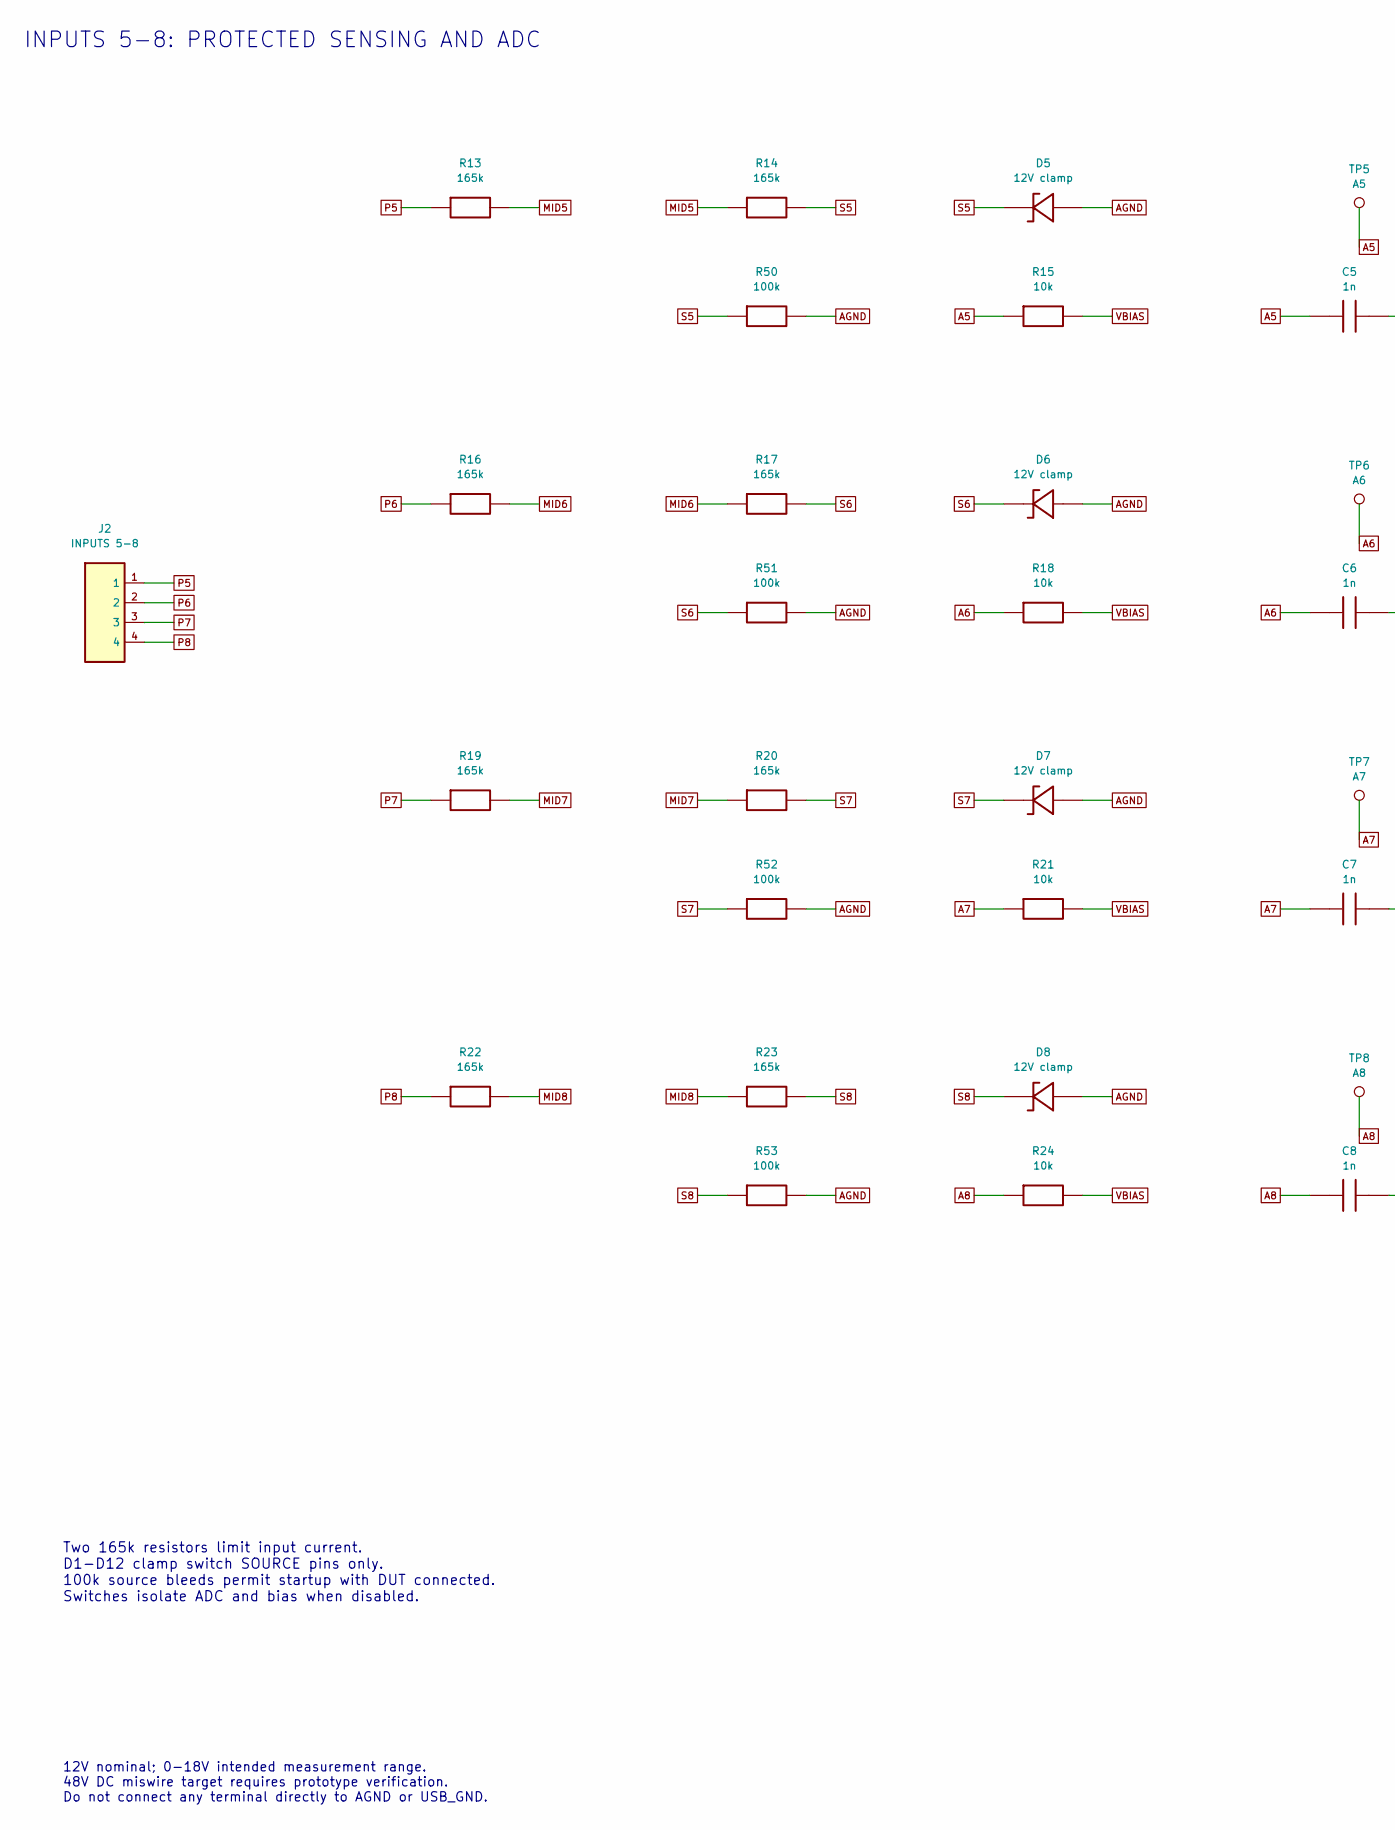
[picture p219: schematic bank2.kicad_sch, Inputs 5-8: protected sensing and ADC, part in row 1, column 1]

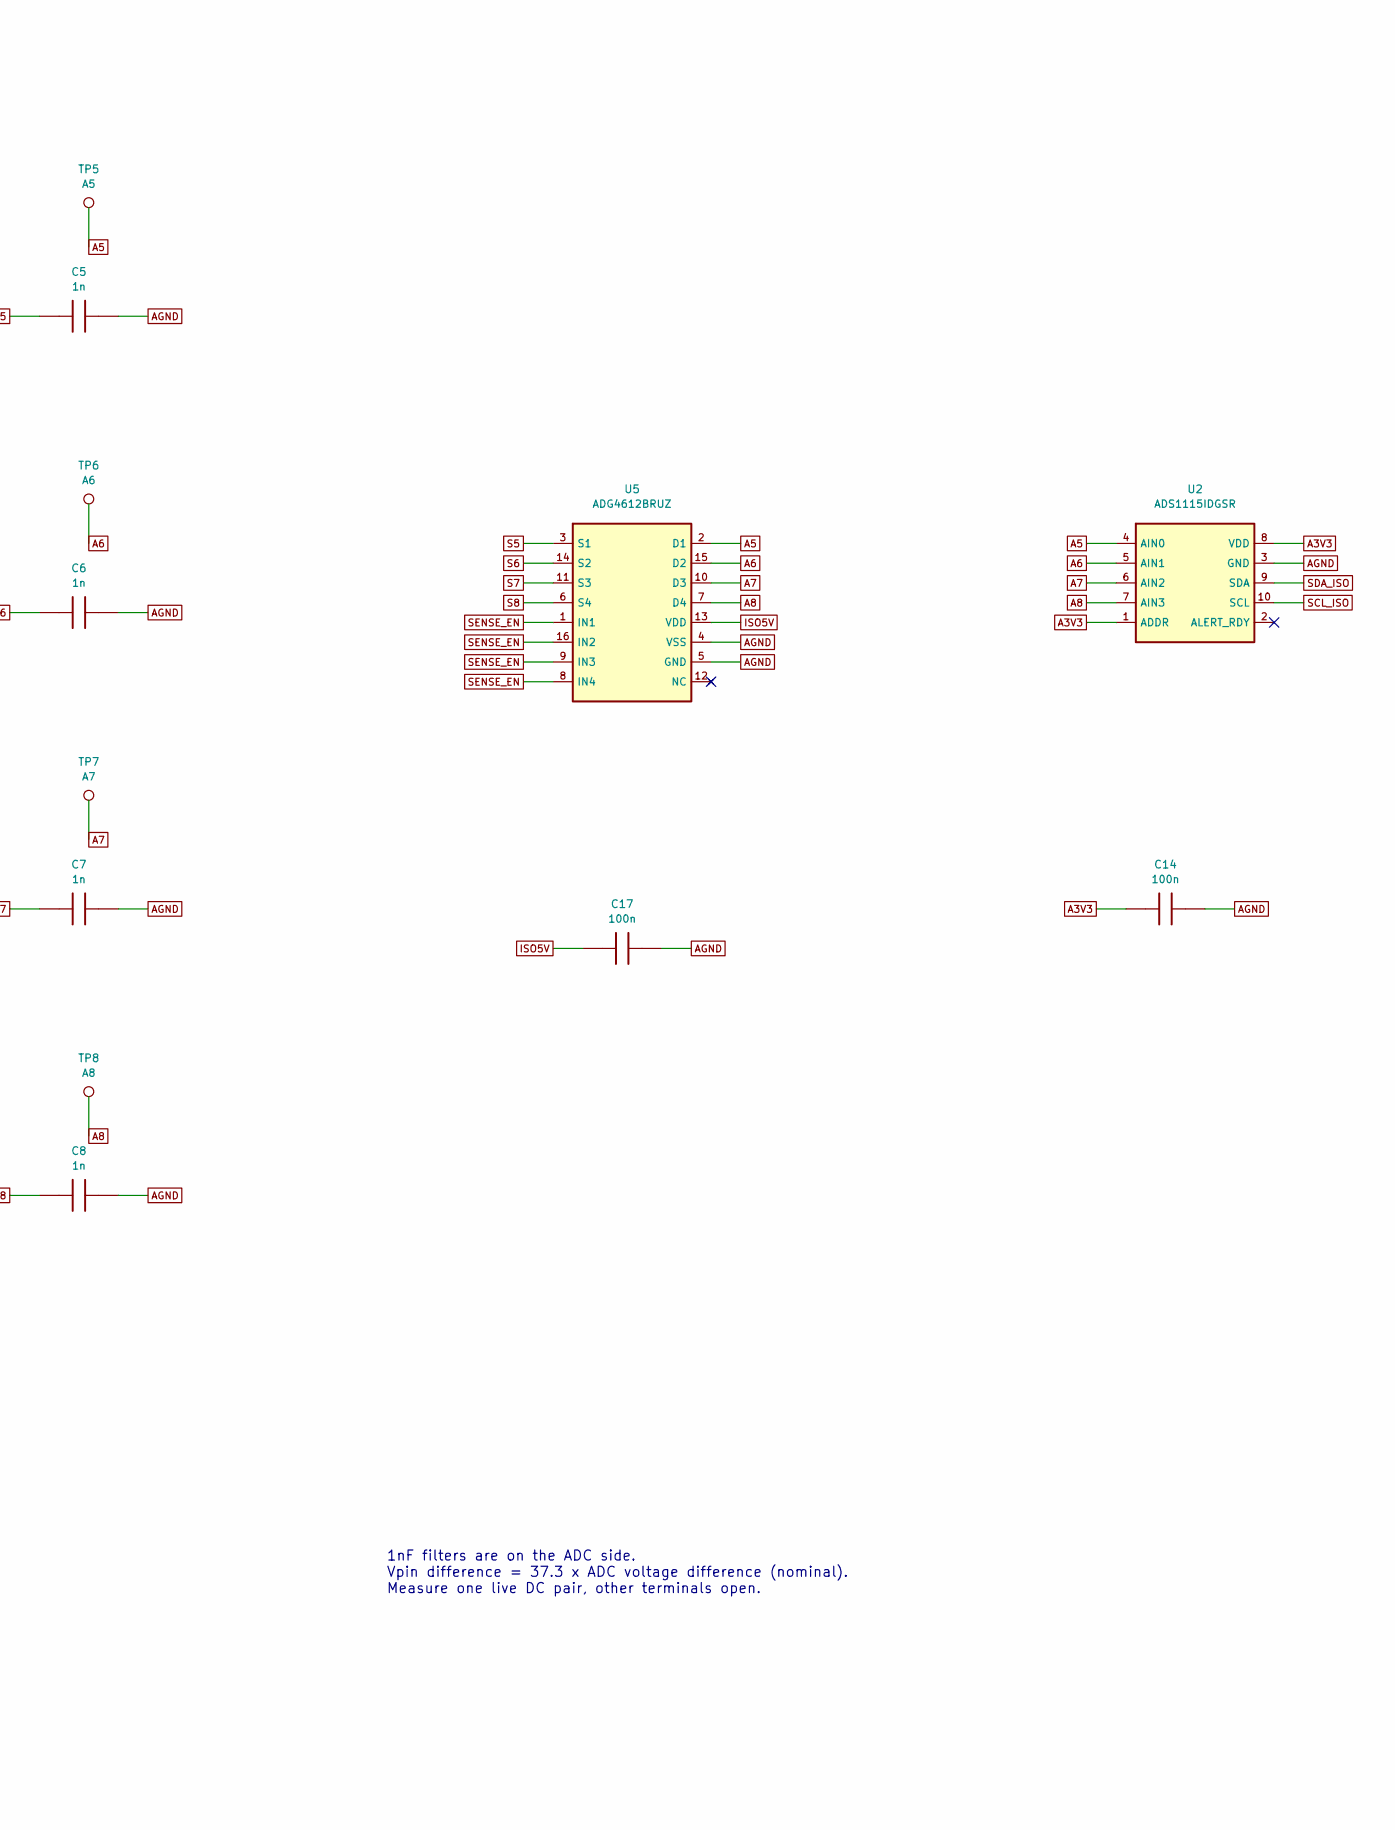
[picture p220: schematic bank2.kicad_sch, Inputs 5-8: protected sensing and ADC, part in row 1, column 2]

Parts:
C5, C6, C7, C8: 1n; C_0805_2012Metric; MPN CC0805JRNPO9BN102; LCSC C62774
C14, C17: 100n; C_0805_2012Metric; MPN CC0805KRX7R9BB104; LCSC C49678
D5, D6, D7, D8: 12V clamp; D_SOD-123F; MPN BZT52H-C12,115; LCSC C282531
J2: INPUTS 5-8; TerminalBlock_Phoenix_PT-1,5-4-3.5-H_1x04_P3.50mm_Horizontal; MPN 1984633; LCSC C5144867
R13, R14, R16, R17, R19, R20, R22, R23: 165k; R_0805_2012Metric; MPN RT0805BRD07165KL; LCSC C865215
R15, R18, R21, R24: 10k; R_0805_2012Metric; MPN RT0805BRD0710KL; LCSC C110775
R50, R51, R52, R53: 100k; R_0805_2012Metric; MPN RT0805BRD07100KL; LCSC C122537
TP5: A5; TestPoint_Pad_D1.5mm
TP6: A6; TestPoint_Pad_D1.5mm
TP7: A7; TestPoint_Pad_D1.5mm
TP8: A8; TestPoint_Pad_D1.5mm
U2: ADS1115IDGSR; TSSOP-10_3x3mm_P0.5mm; MPN ADS1115IDGSR; LCSC C37593
U5: ADG4612BRUZ; TSSOP-16_4.4x5mm_P0.65mm; MPN ADG4612BRUZ-REEL7; LCSC C207399

Connections:
A3V3: C14.1, U2.1 (ADDR), U2.8 (VDD); also elsewhere on the board
A5: C5.1, R15.1, TP5.1, U2.4 (AIN0), U5.2 (D1)
A6: C6.1, R18.1, TP6.1, U2.5 (AIN1), U5.15 (D2)
A7: C7.1, R21.1, TP7.1, U2.6 (AIN2), U5.10 (D3)
A8: C8.1, R24.1, TP8.1, U2.7 (AIN3), U5.7 (D4)
AGND: C5.2, C6.2, C7.2, C8.2, C14.2, C17.2, D5.2, D6.2, D7.2, D8.2, R50.2, R51.2, R52.2, R53.2, U2.3 (GND), U5.4 (VSS), U5.5 (GND); also elsewhere on the board
ISO5V: C17.1, U5.13 (VDD); also elsewhere on the board
MID5: R13.2, R14.1
MID6: R16.2, R17.1
MID7: R19.2, R20.1
MID8: R22.2, R23.1
P5: J2.1, R13.1
P6: J2.2, R16.1
P7: J2.3, R19.1
P8: J2.4, R22.1
S5: D5.1, R14.2, R50.1, U5.3 (S1)
S6: D6.1, R17.2, R51.1, U5.14 (S2)
S7: D7.1, R20.2, R52.1, U5.11 (S3)
S8: D8.1, R23.2, R53.1, U5.6 (S4)
SCL_ISO: U2.10 (SCL); also elsewhere on the board
SDA_ISO: U2.9 (SDA); also elsewhere on the board
SENSE_EN: U5.1 (IN1), U5.8 (IN4), U5.9 (IN3), U5.16 (IN2); also elsewhere on the board
VBIAS: R15.2, R18.2, R21.2, R24.2; also elsewhere on the board

Notes on the sheet:
INPUTS 5-8: PROTECTED SENSING AND ADC
Two 165k resistors limit input current. D1-D12 clamp switch SOURCE pins only. 100k source bleeds permit startup with DUT connected. Switches isolate ADC and bias when disabled.
1nF filters are on the ADC side. Vpin difference = 37.3 x ADC voltage difference (nominal). Measure one live DC pair, other terminals open.
12V nominal; 0-18V intended measurement range. 48V DC miswire target requires prototype verification. Do not connect any terminal directly to AGND or USB_GND.
