PetterGustafsson/power-supply-tester/hardware/rev-a/tester12v.kicad_pcb

## KiCad design hardware/rev-a/tester12v.kicad_pcb (continued)

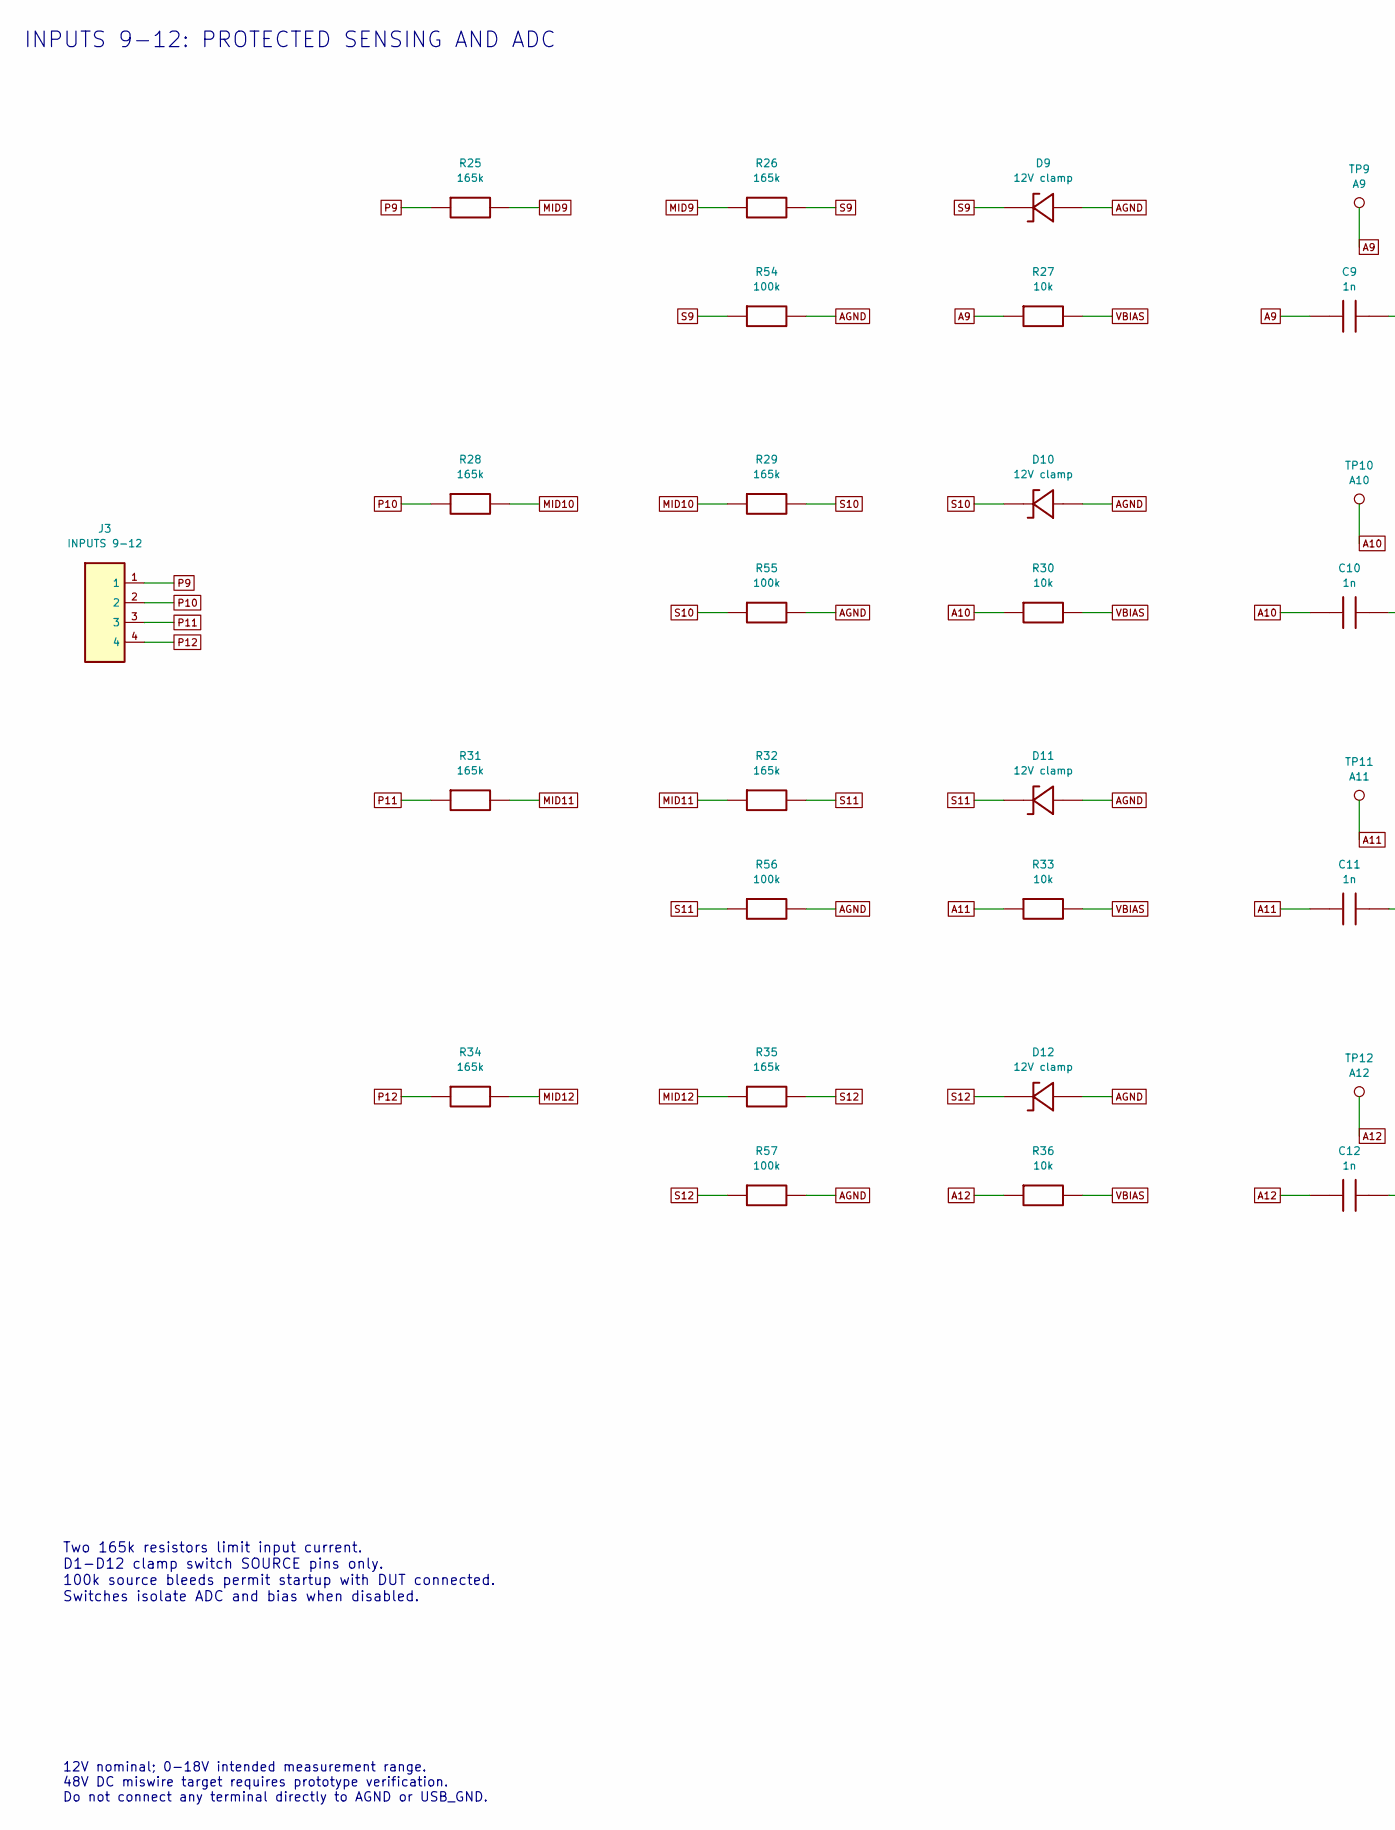
[picture p221: schematic bank3.kicad_sch, Inputs 9-12: protected sensing and ADC, part in row 1, column 1]

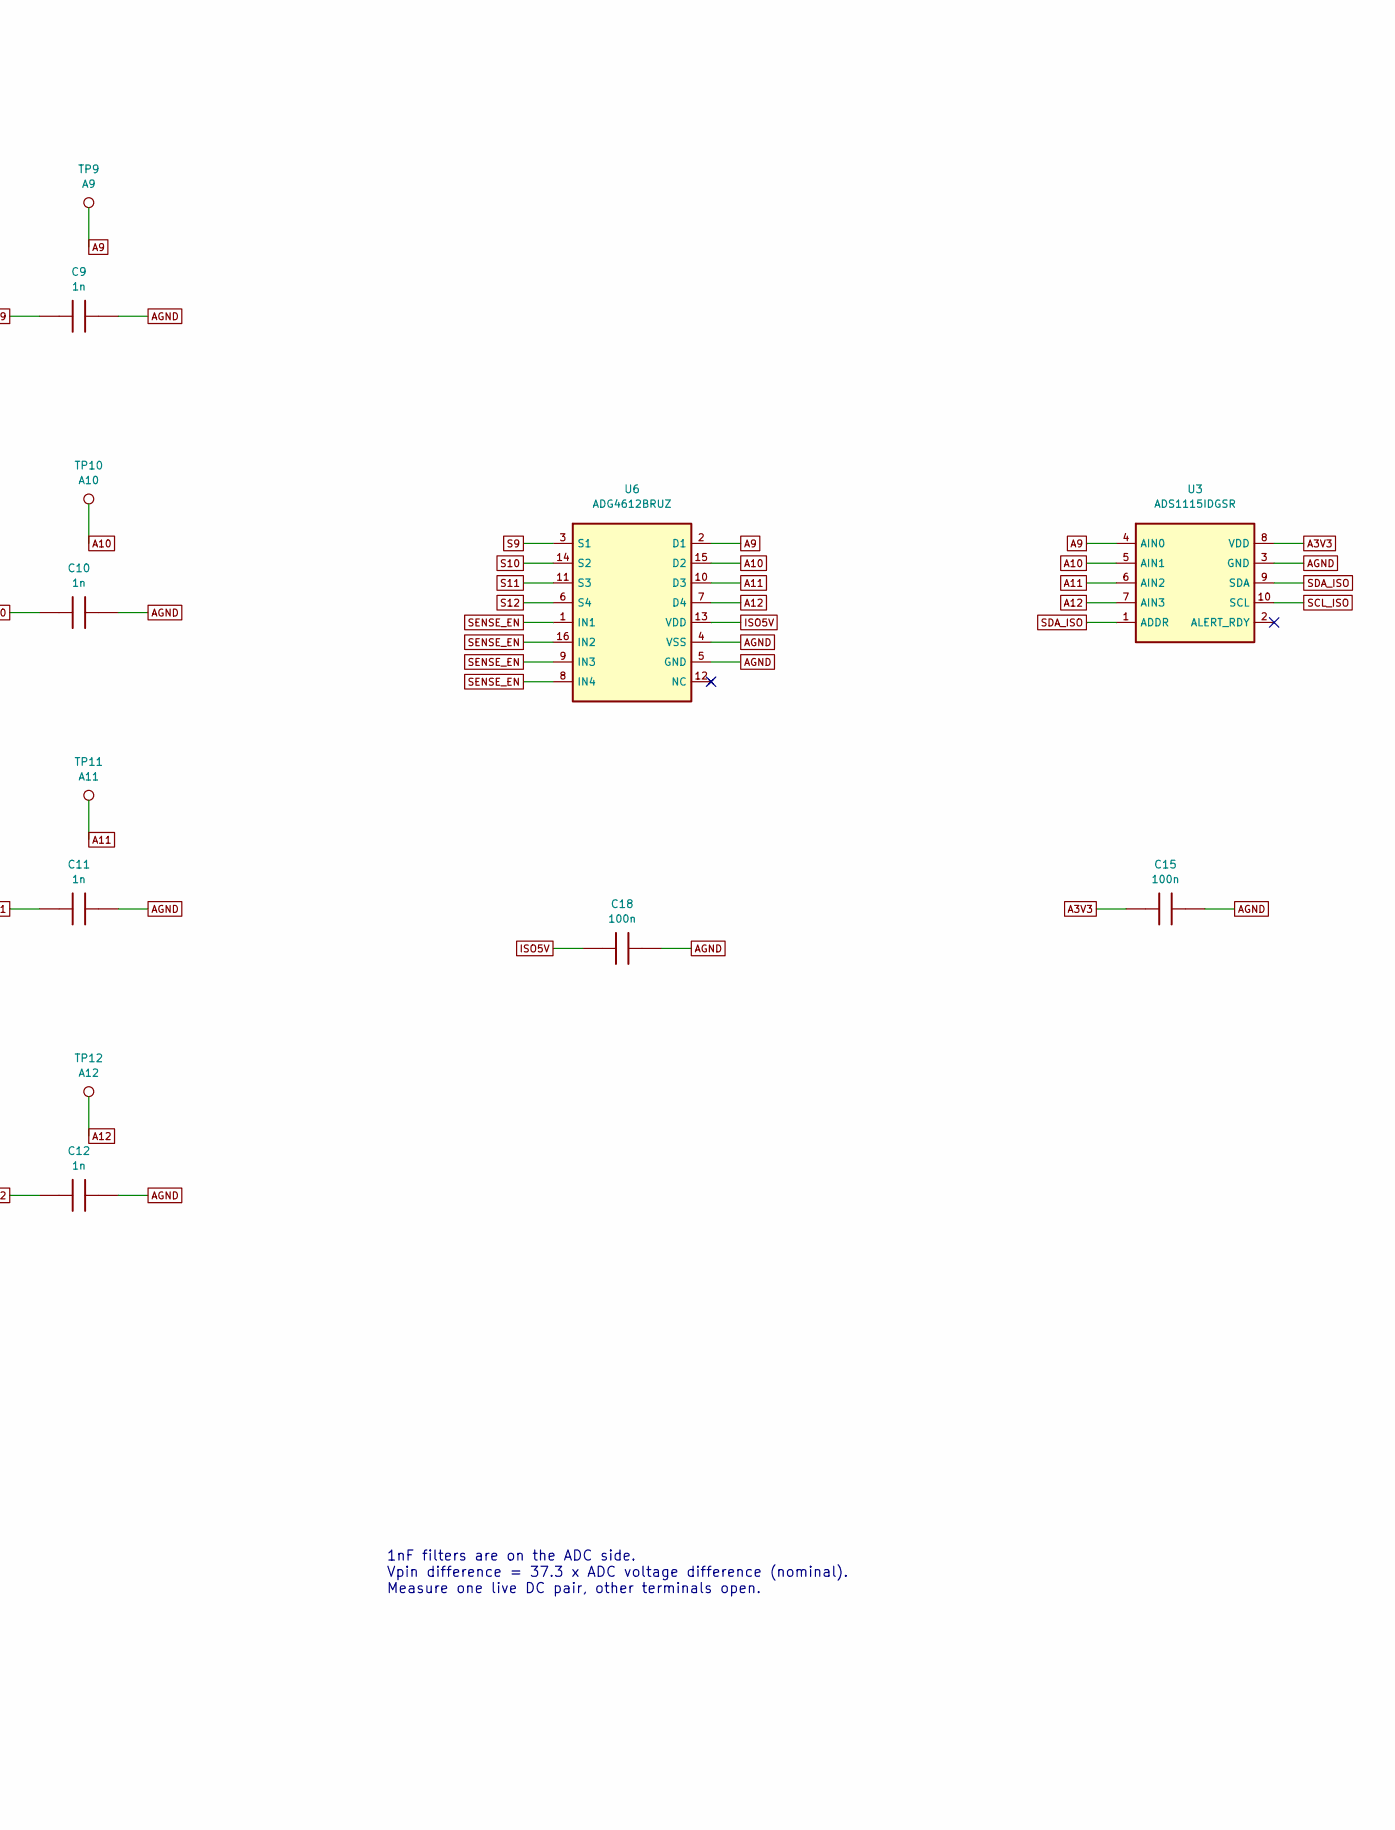
[picture p222: schematic bank3.kicad_sch, Inputs 9-12: protected sensing and ADC, part in row 1, column 2]

Parts:
C9, C10, C11, C12: 1n; C_0805_2012Metric; MPN CC0805JRNPO9BN102; LCSC C62774
C15, C18: 100n; C_0805_2012Metric; MPN CC0805KRX7R9BB104; LCSC C49678
D9, D10, D11, D12: 12V clamp; D_SOD-123F; MPN BZT52H-C12,115; LCSC C282531
J3: INPUTS 9-12; TerminalBlock_Phoenix_PT-1,5-4-3.5-H_1x04_P3.50mm_Horizontal; MPN 1984633; LCSC C5144867
R25, R26, R28, R29, R31, R32, R34, R35: 165k; R_0805_2012Metric; MPN RT0805BRD07165KL; LCSC C865215
R27, R30, R33, R36: 10k; R_0805_2012Metric; MPN RT0805BRD0710KL; LCSC C110775
R54, R55, R56, R57: 100k; R_0805_2012Metric; MPN RT0805BRD07100KL; LCSC C122537
TP9: A9; TestPoint_Pad_D1.5mm
TP10: A10; TestPoint_Pad_D1.5mm
TP11: A11; TestPoint_Pad_D1.5mm
TP12: A12; TestPoint_Pad_D1.5mm
U3: ADS1115IDGSR; TSSOP-10_3x3mm_P0.5mm; MPN ADS1115IDGSR; LCSC C37593
U6: ADG4612BRUZ; TSSOP-16_4.4x5mm_P0.65mm; MPN ADG4612BRUZ-REEL7; LCSC C207399

Connections:
A3V3: C15.1, U3.8 (VDD); also elsewhere on the board
A9: C9.1, R27.1, TP9.1, U3.4 (AIN0), U6.2 (D1)
A10: C10.1, R30.1, TP10.1, U3.5 (AIN1), U6.15 (D2)
A11: C11.1, R33.1, TP11.1, U3.6 (AIN2), U6.10 (D3)
A12: C12.1, R36.1, TP12.1, U3.7 (AIN3), U6.7 (D4)
AGND: C9.2, C10.2, C11.2, C12.2, C15.2, C18.2, D9.2, D10.2, D11.2, D12.2, R54.2, R55.2, R56.2, R57.2, U3.3 (GND), U6.4 (VSS), U6.5 (GND); also elsewhere on the board
ISO5V: C18.1, U6.13 (VDD); also elsewhere on the board
MID9: R25.2, R26.1
MID10: R28.2, R29.1
MID11: R31.2, R32.1
MID12: R34.2, R35.1
P9: J3.1, R25.1
P10: J3.2, R28.1
P11: J3.3, R31.1
P12: J3.4, R34.1
S9: D9.1, R26.2, R54.1, U6.3 (S1)
S10: D10.1, R29.2, R55.1, U6.14 (S2)
S11: D11.1, R32.2, R56.1, U6.11 (S3)
S12: D12.1, R35.2, R57.1, U6.6 (S4)
SCL_ISO: U3.10 (SCL); also elsewhere on the board
SDA_ISO: U3.1 (ADDR), U3.9 (SDA); also elsewhere on the board
SENSE_EN: U6.1 (IN1), U6.8 (IN4), U6.9 (IN3), U6.16 (IN2); also elsewhere on the board
VBIAS: R27.2, R30.2, R33.2, R36.2; also elsewhere on the board

Notes on the sheet:
INPUTS 9-12: PROTECTED SENSING AND ADC
Two 165k resistors limit input current. D1-D12 clamp switch SOURCE pins only. 100k source bleeds permit startup with DUT connected. Switches isolate ADC and bias when disabled.
1nF filters are on the ADC side. Vpin difference = 37.3 x ADC voltage difference (nominal). Measure one live DC pair, other terminals open.
12V nominal; 0-18V intended measurement range. 48V DC miswire target requires prototype verification. Do not connect any terminal directly to AGND or USB_GND.

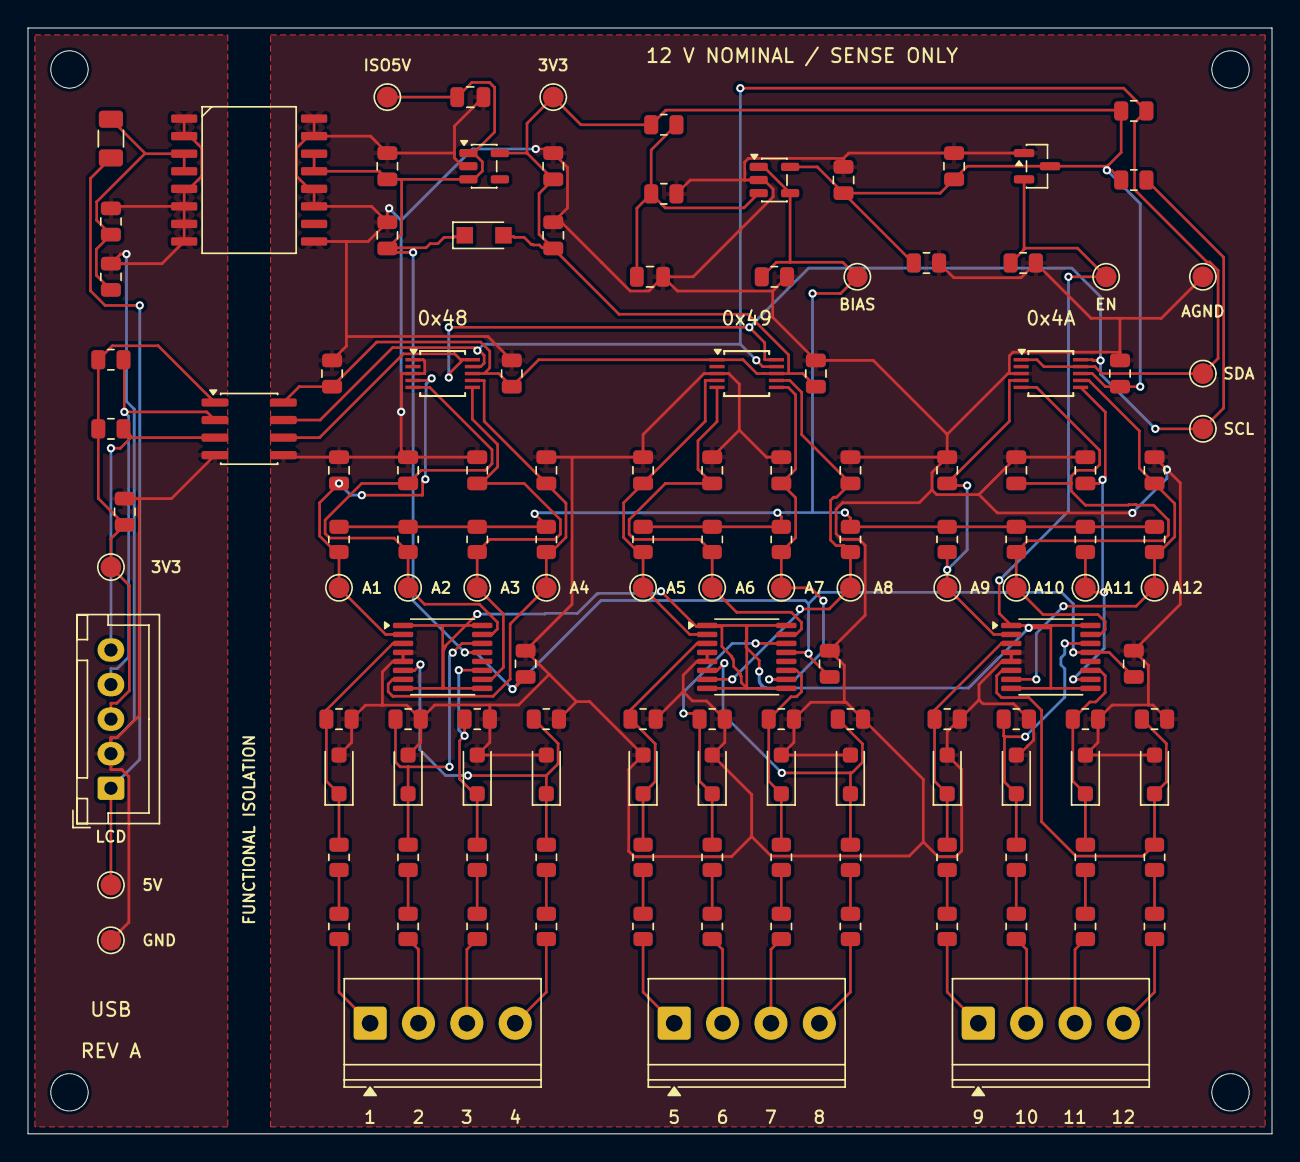
[picture p223: board hardware/rev-a/tester12v.kicad_pcb from above]

Board: 2 copper layers, 90.0 x 80.0 mm, 142 parts (0 on the bottom side), 62 nets.

Other parts of the board:
H1, H2, H3, H4: MountingHole_2.7mm_M2.5
