PetterGustafsson/power-supply-tester/hardware/rev-d/tester12v.kicad_pcb

## KiCad design hardware/rev-d/tester12v.kicad_pcb (2026-10-02, an earlier design)

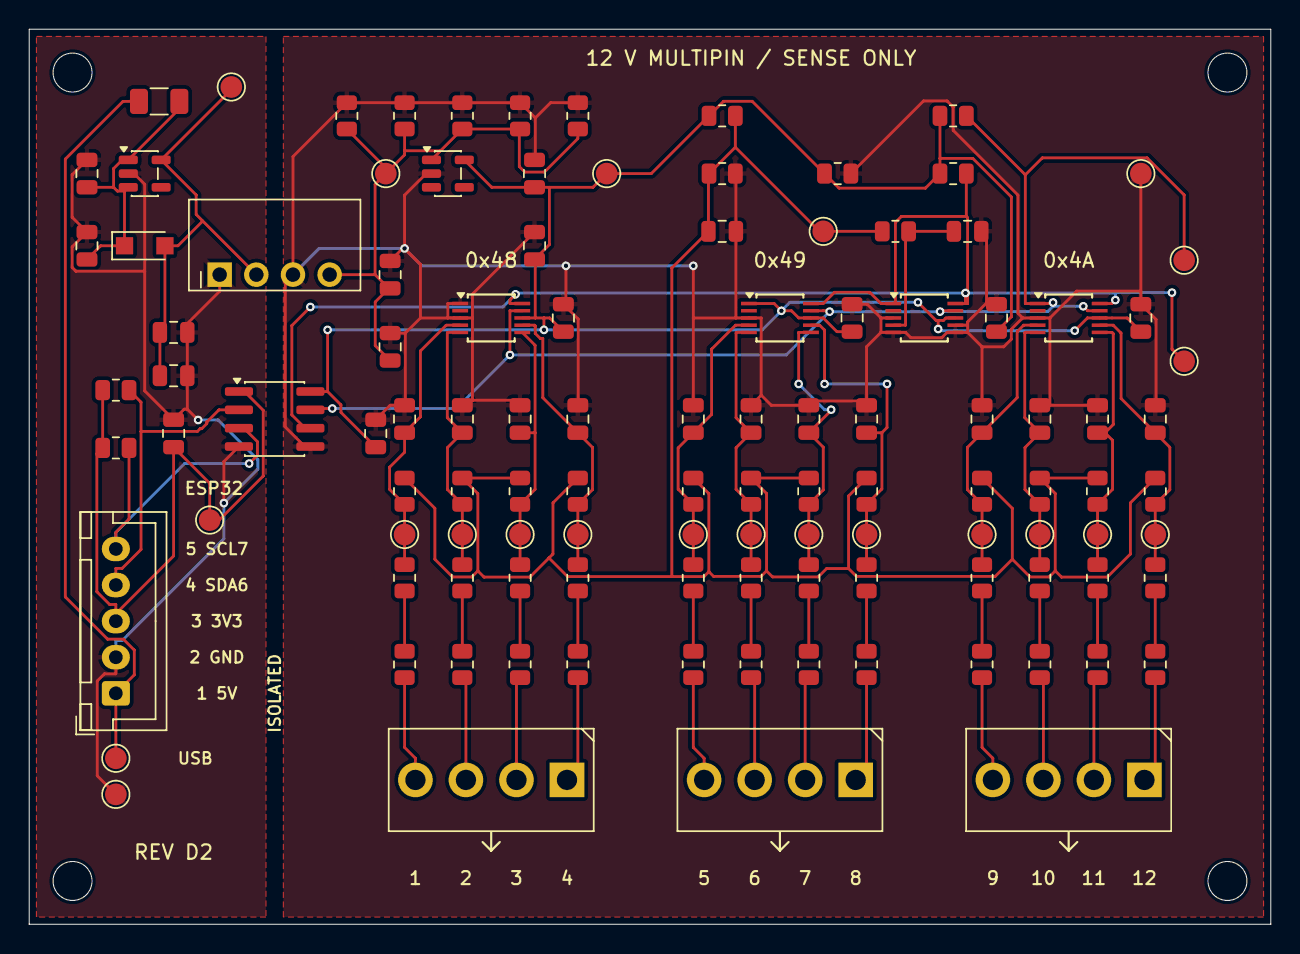
[picture p224: board hardware/rev-d/tester12v.kicad_pcb from above]

Board: 2 copper layers, 86.0 x 62.0 mm, 117 parts (0 on the bottom side), 50 nets.

Parts:
C1, C2, C3, C4, C5, C6, C7, C8, C9, C10, C11, C12, C26, C28: 470p; C_0805_2012Metric
C13, C14, C15, C17, C19, C21, C23, C24, C25, C27: 100n; C_0805_2012Metric
C16, C18, C20, C22: 10u; C_0805_2012Metric
D1: LDO reverse protection; Nexperia_CFP3_SOD-123W
F1: 250mA PTC; Fuse_1206_3216Metric
H1, H2, H3, H4: MountingHole_2.7mm_M2.5
J1: INPUTS 1-4; XY350V_3.5_4P
J2: INPUTS 5-8; XY350V_3.5_4P
J3: INPUTS 9-12; XY350V_3.5_4P
J4: DISPLAY HARNESS; JST_XH_B5B-XH-A_1x05_P2.50mm_Vertical
R1, R2, R4, R5, R7, R8, R10, R11, R13, R14, R16, R17, R19, R20, R22, R23, R25, R26, R28, R29, R31, R32, R34, R35: 1M; R_0805_2012Metric
R3, R6, R9, R12, R15, R18, R21, R24, R27, R30, R33, R36, R37, R44, R45, R46, R47, R49: 4.7k; R_0805_2012Metric
R38, R39, R40, R41, R42, R43, R48: 1k; R_0805_2012Metric
TP1: A1; TestPoint_Pad_D1.5mm
TP2: A2; TestPoint_Pad_D1.5mm
TP3: A3; TestPoint_Pad_D1.5mm
TP4: A4; TestPoint_Pad_D1.5mm
TP5: A5; TestPoint_Pad_D1.5mm
TP6: A6; TestPoint_Pad_D1.5mm
TP7: A7; TestPoint_Pad_D1.5mm
TP8: A8; TestPoint_Pad_D1.5mm
TP9: A9; TestPoint_Pad_D1.5mm
TP10: A10; TestPoint_Pad_D1.5mm
TP11: A11; TestPoint_Pad_D1.5mm
TP12: A12; TestPoint_Pad_D1.5mm
TP13: USB5V; TestPoint_Pad_D1.5mm
TP14: USB_GND; TestPoint_Pad_D1.5mm
TP15: HOST3V3; TestPoint_Pad_D1.5mm
TP16: P3V3; TestPoint_Pad_D1.5mm
TP17: ISO5V_RAW; TestPoint_Pad_D1.5mm
TP18: A3V3; TestPoint_Pad_D1.5mm
TP19: AGND; TestPoint_Pad_D1.5mm
TP20: VBIAS; TestPoint_Pad_D1.5mm
TP21: SDA_ISO; TestPoint_Pad_D1.5mm
TP22: SCL_ISO; TestPoint_Pad_D1.5mm
U1, U2, U3, U8: ADS1115IDGSR; TSSOP-10_3x3mm_P0.5mm
U4: TLV75533PDBVR; SOT-23-5
U5: TPS70933DBVR; SOT-23-5
U6: ISO1640BDR; SOIC-8_3.9x4.9mm_P1.27mm
U7: B0305S-1WR3; B0305S_1WR3_EVISUN

Connections:
A1: C1.1, R2.2, R3.1, TP1.1, U1.4
A2: C2.1, R5.2, R6.1, TP2.1, U1.5
A3: C3.1, R8.2, R9.1, TP3.1, U1.6
A3V3: C13.1, C14.1, C15.1, C22.1, C23.1, C25.1, C27.1, R37.1, R44.1, R45.1, R48.1, TP18.1, U1.8, U2.1, U2.8, U3.8, U5.5, U6.8, U8.8
A4: C4.1, R11.2, R12.1, TP4.1, U1.7
A5: C5.1, R14.2, R15.1, TP5.1, U2.4
A6: C6.1, R17.2, R18.1, TP6.1, U2.5
A7: C7.1, R20.2, R21.1, TP7.1, U2.6
A8: C8.1, R23.2, R24.1, TP8.1, U2.7
A9: C9.1, R26.2, R27.1, TP9.1, U3.4
A10: C10.1, R29.2, R30.1, TP10.1, U3.5
A11: C11.1, R32.2, R33.1, TP11.1, U3.6
A12: C12.1, R35.2, R36.1, TP12.1, U3.7
AGND: C1.2, C2.2, C3.2, C4.2, C5.2, C6.2, C7.2, C8.2, C9.2, C10.2, C11.2, C12.2, C13.2, C14.2, C15.2, C20.2, C21.2, C22.2, C23.2, C25.2, C26.2, C27.2, C28.2, R38.2, R39.2, R40.2, R41.2, R42.2, R43.2, R48.2, TP19.1, U1.1, U1.3, U2.3, U3.3, U5.2, U6.5, U7.3, U8.3, U8.5, U8.6, U8.7
HOST3V3: C24.1, J4.3, R46.1, R47.1, TP15.1, U6.1
ISO5V_RAW: C20.1, C21.1, R39.1, R40.1, R41.1, R42.1, R43.1, TP17.1, U5.1, U7.4
MID1: R1.2, R2.1
MID2: R4.2, R5.1
MID3: R7.2, R8.1
MID4: R10.2, R11.1
MID5: R13.2, R14.1
MID6: R16.2, R17.1
MID7: R19.2, R20.1
MID8: R22.2, R23.1
MID9: R25.2, R26.1
MID10: R28.2, R29.1
MID11: R31.2, R32.1
MID12: R34.2, R35.1
P1: J1.4, R1.1
P2: J1.3, R4.1
P3: J1.2, R7.1
P3V3: C18.1, C19.1, D1.2, TP16.1, U4.5, U7.2
P4: J1.1, R10.1
P5: J2.4, R13.1
P6: J2.3, R16.1
P7: J2.2, R19.1
P8: J2.1, R22.1
P9: J3.4, R25.1
P10: J3.3, R28.1
P11: J3.2, R31.1
P12: J3.1, R34.1
REF_ADC: C28.1, R49.2, U8.4
SCL_HOST: J4.5, R47.2, U6.3
SCL_ISO: R45.2, TP22.1, U1.10, U2.10, U3.10, U6.6, U8.1, U8.10
SDA_HOST: J4.4, R46.2, U6.2
SDA_ISO: R44.2, TP21.1, U1.9, U2.9, U3.1, U3.9, U6.7, U8.9
USB5V: F1.1, J4.1, TP13.1
USB5V_F: C16.1, C17.1, D1.1, F1.2, U4.1, U4.3
USB_GND: C16.2, C17.2, C18.2, C19.2, C24.2, J4.2, TP14.1, U4.2, U6.4, U7.1
VBIAS: C26.1, R3.2, R6.2, R9.2, R12.2, R15.2, R18.2, R21.2, R24.2, R27.2, R30.2, R33.2, R36.2, R37.2, R38.1, R49.1, TP20.1
