PetterGustafsson/power-supply-tester/hardware/tester12v-rev-d2-engineering-package/hardware/rev-d/bank1.kicad_sch

## KiCad design hardware/tester12v-rev-d2-engineering-package/hardware/rev-d/bank1.kicad_sch (2026-10-02)

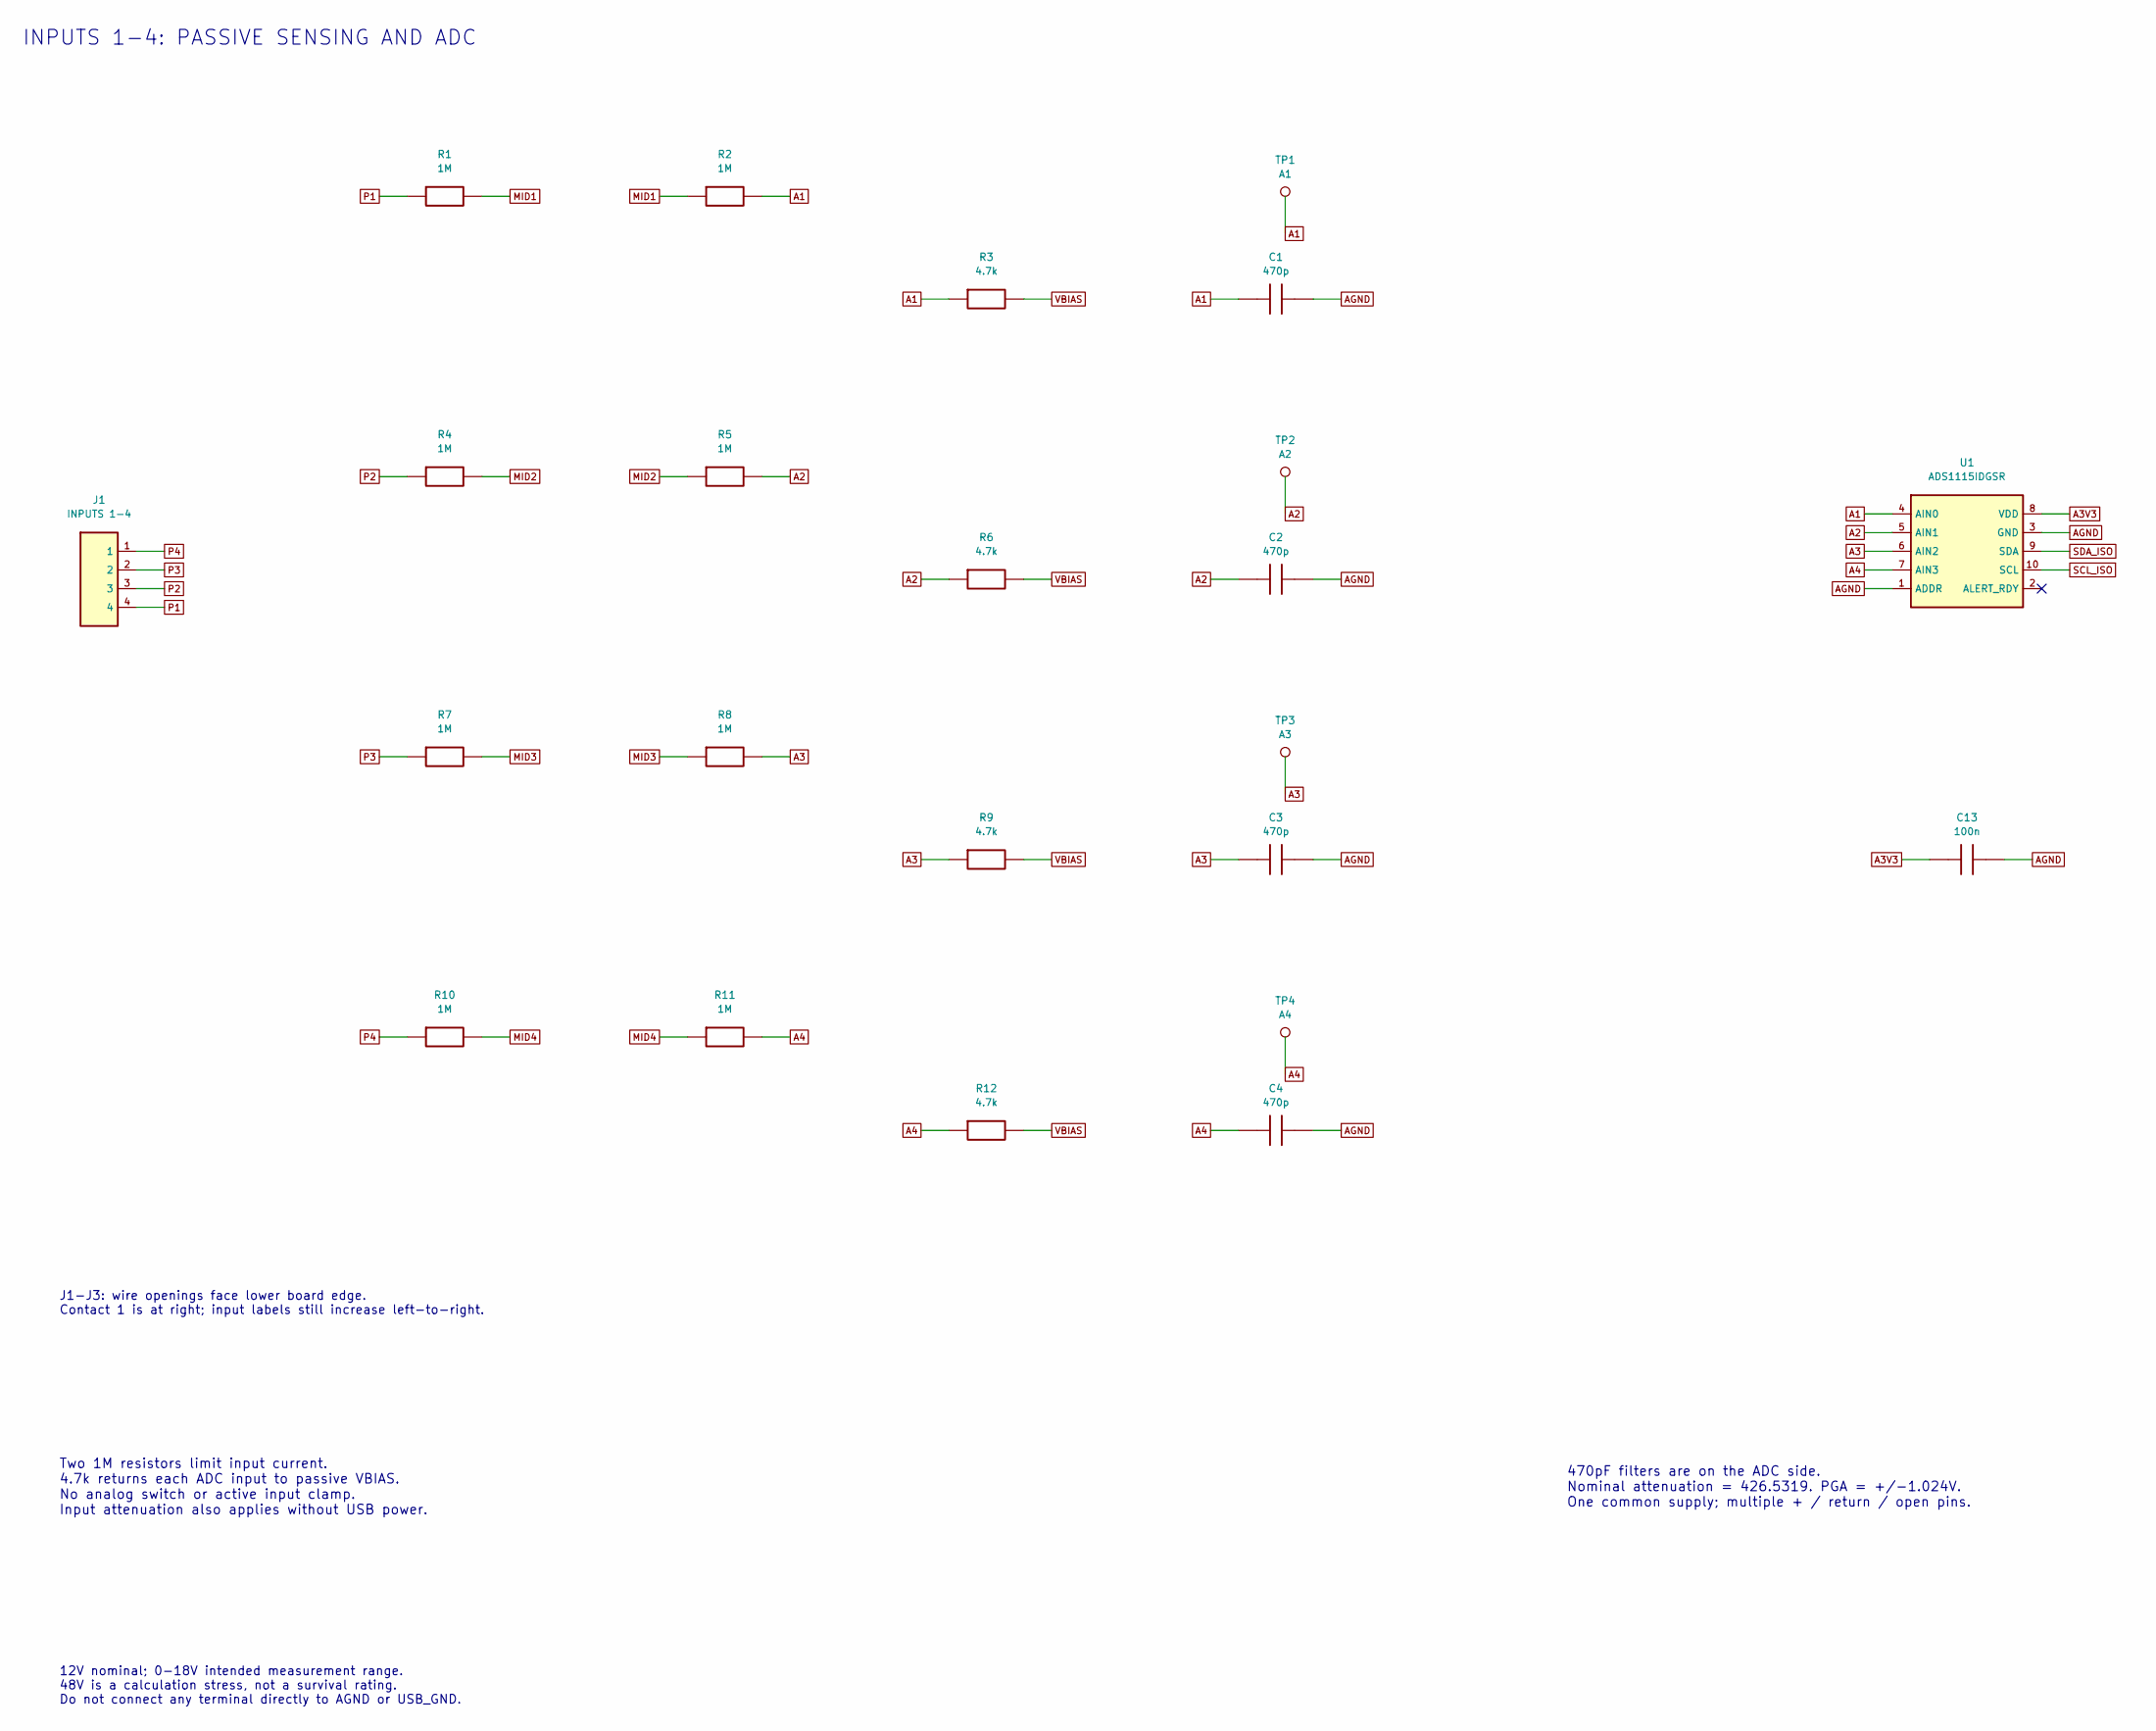
[picture p225: schematic bank1.kicad_sch]

Parts:
C1, C2, C3, C4: 470p; C_0805_2012Metric; MPN 0805B471K500NT; LCSC C1743
C13: 100n; C_0805_2012Metric; MPN CC0805KRX7R9BB104; LCSC C49678
J1: INPUTS 1-4; XY350V_3.5_4P; MPN XY350V-3.5-4P; LCSC C557656
R1, R2, R4, R5, R7, R8, R10, R11: 1M; R_0805_2012Metric; MPN 0805W8F1004T5E; LCSC C17514
R3, R6, R9, R12: 4.7k; R_0805_2012Metric; MPN 0805W8F4701T5E; LCSC C17673
TP1: A1; TestPoint_Pad_D1.5mm
TP2: A2; TestPoint_Pad_D1.5mm
TP3: A3; TestPoint_Pad_D1.5mm
TP4: A4; TestPoint_Pad_D1.5mm
U1: ADS1115IDGSR; TSSOP-10_3x3mm_P0.5mm; MPN ADS1115IDGSR; LCSC C37593

Connections:
A1: C1.1, R2.2, R3.1, TP1.1, U1.4 (AIN0)
A2: C2.1, R5.2, R6.1, TP2.1, U1.5 (AIN1)
A3: C3.1, R8.2, R9.1, TP3.1, U1.6 (AIN2)
A3V3: C13.1, U1.8 (VDD)
A4: C4.1, R11.2, R12.1, TP4.1, U1.7 (AIN3)
AGND: C1.2, C2.2, C3.2, C4.2, C13.2, U1.1 (ADDR), U1.3 (GND)
MID1: R1.2, R2.1
MID2: R4.2, R5.1
MID3: R7.2, R8.1
MID4: R10.2, R11.1
P1: J1.4, R1.1
P2: J1.3, R4.1
P3: J1.2, R7.1
P4: J1.1, R10.1
SCL_ISO: U1.10 (SCL)
SDA_ISO: U1.9 (SDA)
VBIAS: R3.2, R6.2, R9.2, R12.2

Notes on the sheet:
INPUTS 1-4: PASSIVE SENSING AND ADC
J1-J3: wire openings face lower board edge. Contact 1 is at right; input labels still increase left-to-right.
Two 1M resistors limit input current. 4.7k returns each ADC input to passive VBIAS. No analog switch or active input clamp. Input attenuation also applies without USB power.
470pF filters are on the ADC side. Nominal attenuation = 426.5319. PGA = +/-1.024V. One common supply; multiple + / return / open pins.
12V nominal; 0-18V intended measurement range. 48V is a calculation stress, not a survival rating. Do not connect any terminal directly to AGND or USB_GND.
