PetterGustafsson/power-supply-tester/hardware/tester12v-rev-d2-engineering-package/hardware/rev-d/bank3.kicad_sch

## KiCad design hardware/tester12v-rev-d2-engineering-package/hardware/rev-d/bank3.kicad_sch (2026-10-02)

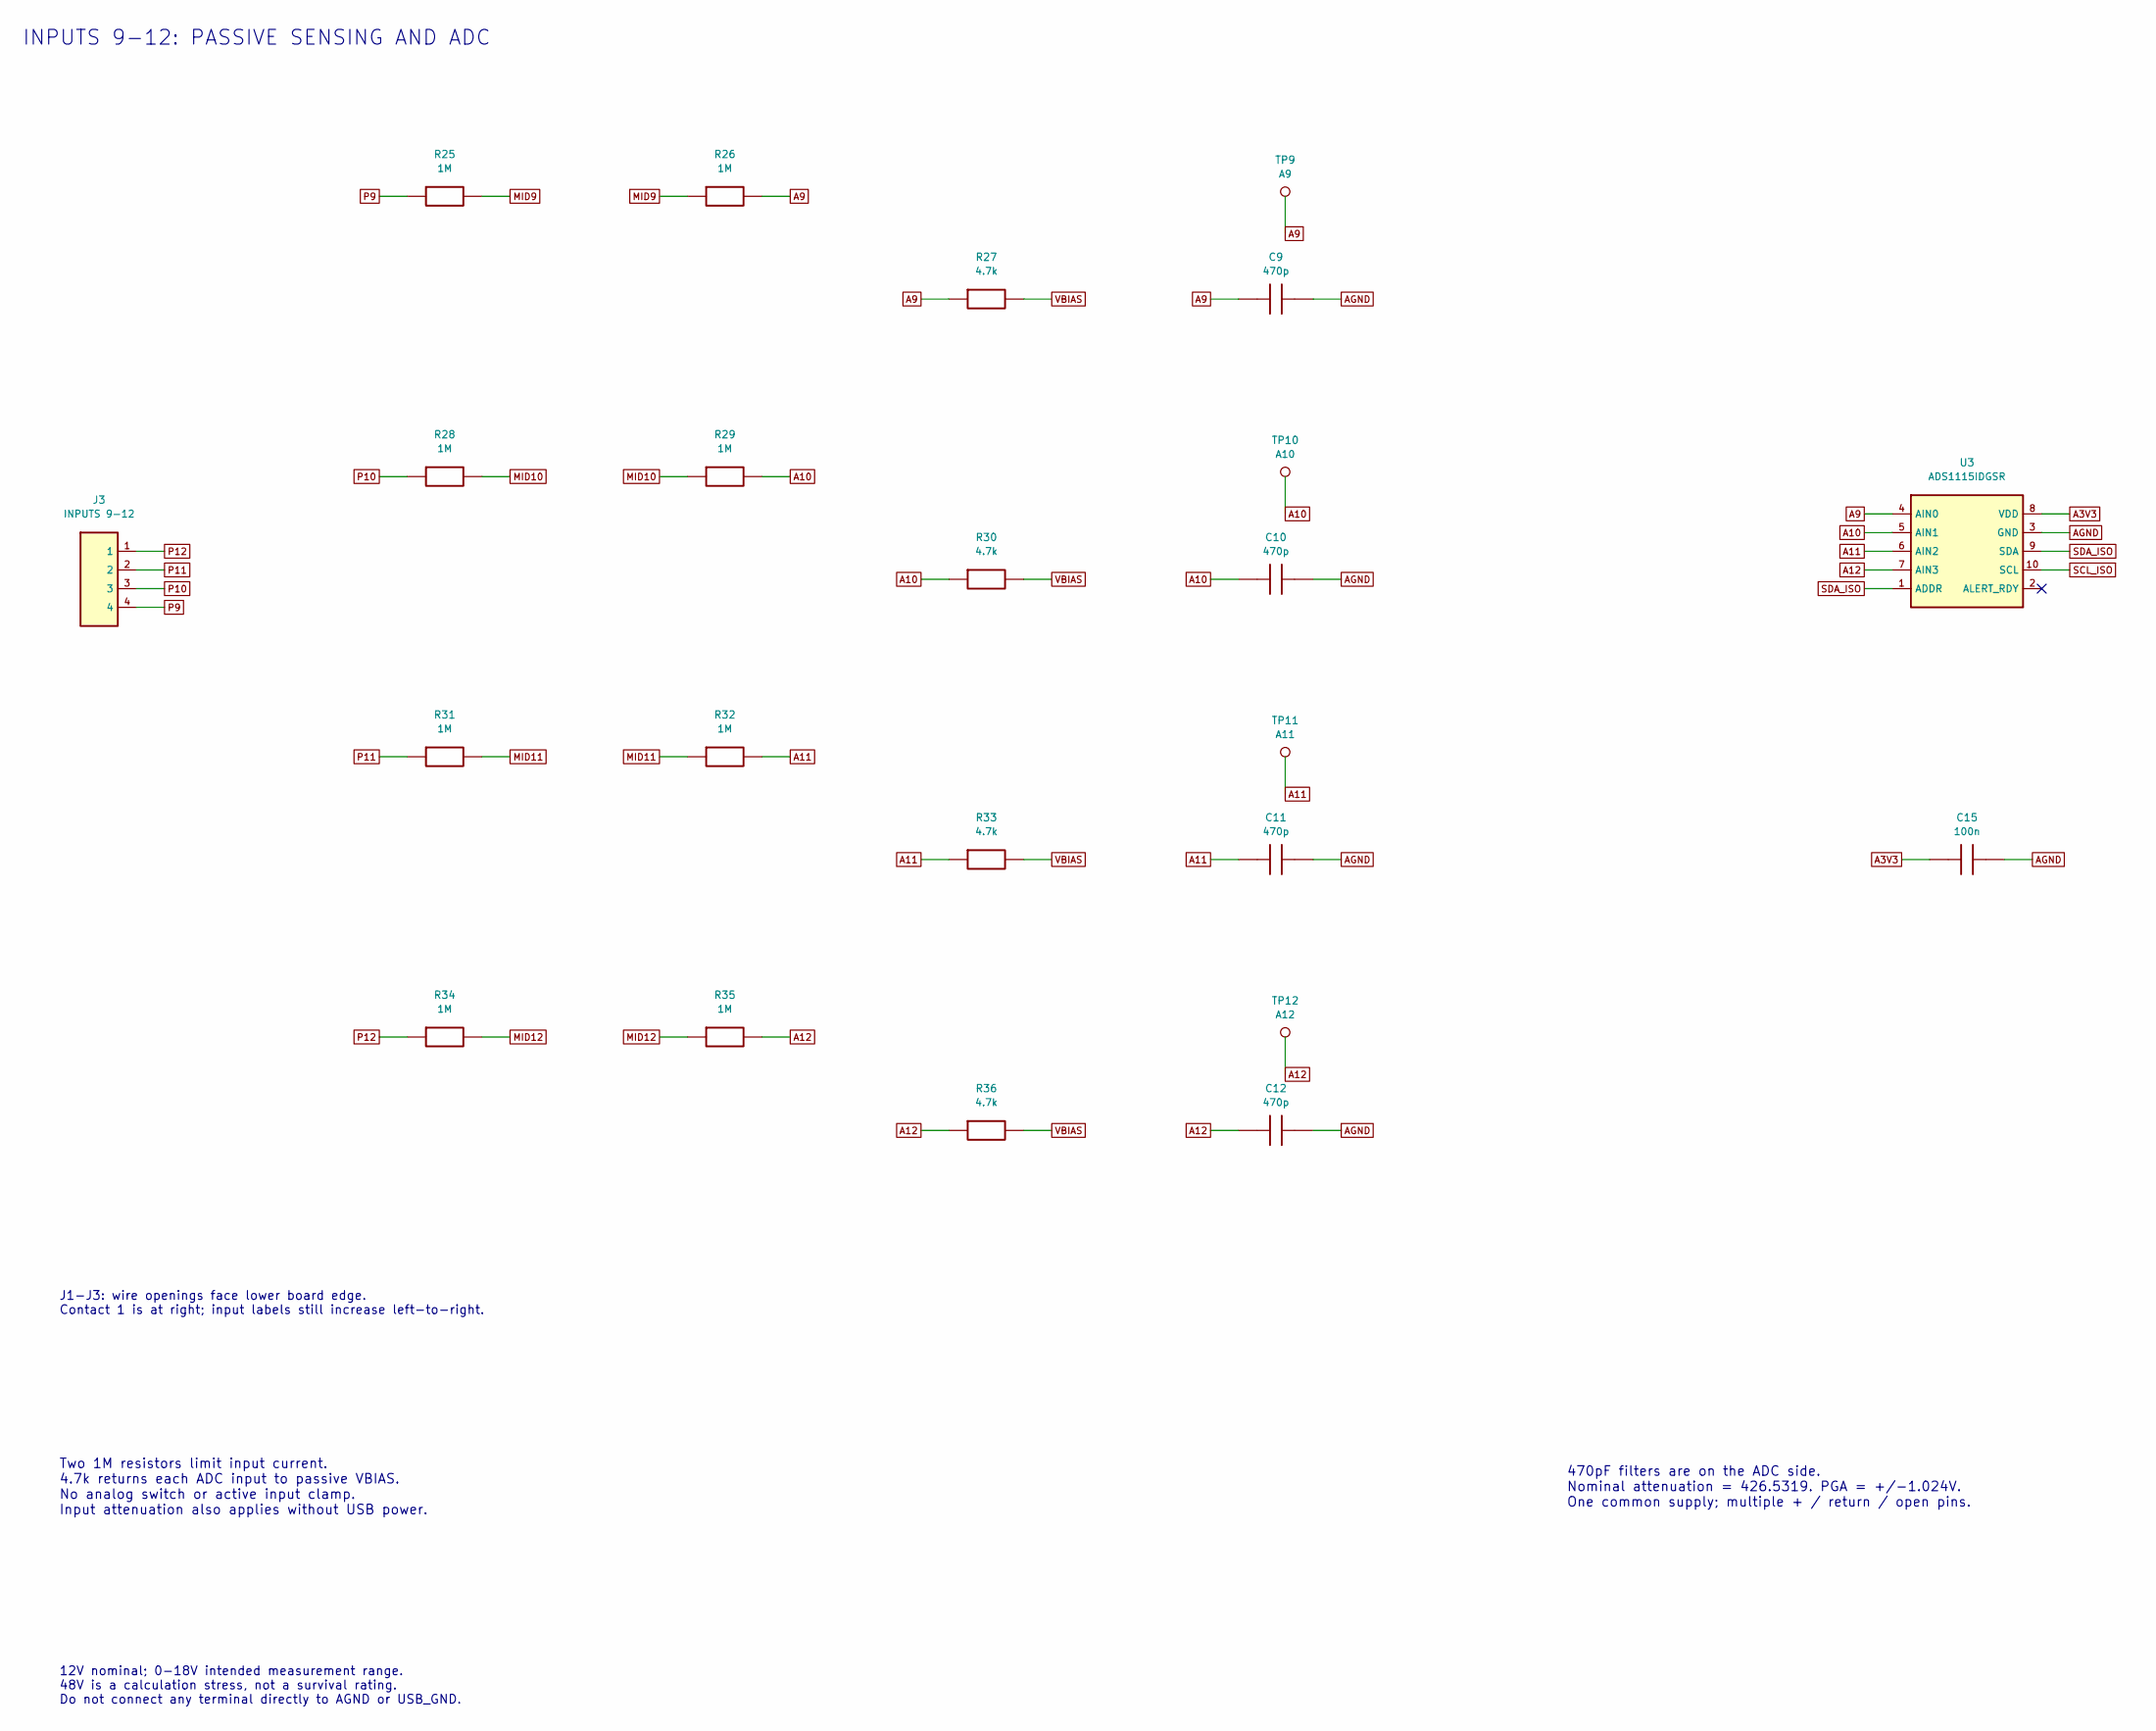
[picture p226: schematic bank3.kicad_sch]

Parts:
C9, C10, C11, C12: 470p; C_0805_2012Metric; MPN 0805B471K500NT; LCSC C1743
C15: 100n; C_0805_2012Metric; MPN CC0805KRX7R9BB104; LCSC C49678
J3: INPUTS 9-12; XY350V_3.5_4P; MPN XY350V-3.5-4P; LCSC C557656
R25, R26, R28, R29, R31, R32, R34, R35: 1M; R_0805_2012Metric; MPN 0805W8F1004T5E; LCSC C17514
R27, R30, R33, R36: 4.7k; R_0805_2012Metric; MPN 0805W8F4701T5E; LCSC C17673
TP9: A9; TestPoint_Pad_D1.5mm
TP10: A10; TestPoint_Pad_D1.5mm
TP11: A11; TestPoint_Pad_D1.5mm
TP12: A12; TestPoint_Pad_D1.5mm
U3: ADS1115IDGSR; TSSOP-10_3x3mm_P0.5mm; MPN ADS1115IDGSR; LCSC C37593

Connections:
A3V3: C15.1, U3.8 (VDD)
A9: C9.1, R26.2, R27.1, TP9.1, U3.4 (AIN0)
A10: C10.1, R29.2, R30.1, TP10.1, U3.5 (AIN1)
A11: C11.1, R32.2, R33.1, TP11.1, U3.6 (AIN2)
A12: C12.1, R35.2, R36.1, TP12.1, U3.7 (AIN3)
AGND: C9.2, C10.2, C11.2, C12.2, C15.2, U3.3 (GND)
MID9: R25.2, R26.1
MID10: R28.2, R29.1
MID11: R31.2, R32.1
MID12: R34.2, R35.1
P9: J3.4, R25.1
P10: J3.3, R28.1
P11: J3.2, R31.1
P12: J3.1, R34.1
SCL_ISO: U3.10 (SCL)
SDA_ISO: U3.1 (ADDR), U3.9 (SDA)
VBIAS: R27.2, R30.2, R33.2, R36.2

Notes on the sheet:
INPUTS 9-12: PASSIVE SENSING AND ADC
J1-J3: wire openings face lower board edge. Contact 1 is at right; input labels still increase left-to-right.
Two 1M resistors limit input current. 4.7k returns each ADC input to passive VBIAS. No analog switch or active input clamp. Input attenuation also applies without USB power.
470pF filters are on the ADC side. Nominal attenuation = 426.5319. PGA = +/-1.024V. One common supply; multiple + / return / open pins.
12V nominal; 0-18V intended measurement range. 48V is a calculation stress, not a survival rating. Do not connect any terminal directly to AGND or USB_GND.
