PetterGustafsson/power-supply-tester/firmware/Tester12VRevD/LiveMark.h

#pragma once
#include <stdint.h>
namespace live_mark {
constexpr uint16_t color[34*21] = {0,0,0,0,0,0,0,0,63488,0,57634,59682,59650,57602,57602,57602,59682,53506,35008,35008,35008,0,30720,63488,0,55554,61730,59650,57602,57602,57602,57602,59682,57602,0,0,0,0,0,0,0,63488,0,57602,61730,61730,59682,57602,57602,57602,59650,43232,37056,39136,39136,39136,0,63488,57633,59682,61730,57602,57602,57602,57602,57602,59682,59650,0,0,0,0,0,0,63488,0,57570,61730,59682,57602,57602,57602,57602,61730,61730,41184,45313,41184,43232,41184,63488,0,59650,63778,57602,57602,57602,57602,57602,61730,59682,63488,0,0,0,0,0,63488,63488,57569,59650,59682,57602,57602,57602,57602,57602,59650,63811,41185,45313,43233,43233,45281,43232,63779,59650,57602,57602,57602,57602,57602,57602,61730,59682,0,0,0,0,0,0,63488,0,59650,61730,57602,57602,57602,57602,57602,61730,57602,0,30720,47329,49409,45281,49409,45281,59650,61730,57602,57602,57602,57602,57602,59682,59682,55584,63488,0,0,0,0,63488,0,59682,59650,57602,57602,57602,57602,57602,57602,59682,59682,0,0,49409,49409,47329,47361,49409,57602,57634,57602,57602,57602,57602,57602,61730,59650,0,63488,0,0,0,0,63488,0,59650,61730,57602,57602,57602,57602,57602,59682,59682,63488,63488,63488,45348,49409,51457,47329,51457,59650,57602,57602,57602,57602,57602,59650,59650,55521,63488,63488,0,0,0,63488,63488,57602,59650,57602,57602,57602,57602,57602,57602,61730,59682,0,47104,63488,0,49409,51457,49377,55554,57602,57602,57602,57602,57602,57602,61730,59682,0,63488,0,0,0,0,63488,0,59650,61730,57602,57602,57602,57602,57602,59682,57602,57539,0,0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
}
