PetterGustafsson/power-supply-tester/(commit log)

2026-10-02 Initial import of power supply tester project
2026-10-23 Publish I15 enclosure, working live firmware, and illustrated project guide
