PetterGustafsson/power-supply-tester/(notices)

Notices in the files:
hardware/rev-e/sources/cm5io-reference/CM5_GPIO.kicad_sch:
Copyright © 2024 Raspberry Pi Ltd.
